hectorhiguita/circuitos2_proyectofinal/Circuitos_II_ESTUDIANTES_completo.pdf

INSTITUCIÓN UNIVERSITARIA ITM

Departamento de Electrónica y Telecomunicaciones

# Circuitos II

## Sistemas dinámicos, filtros, sensores, sistemas embebidos e IoT

Edición de estudiantes

Jhon Jairo Rojas Montano

Estado del documento. Desarrolladas las 17 semanas (51 sesiones), con laboratorios, dos parciales y el proyecto final. Cada cifra se reproduce con los notebooks de Python (Anexo A); los scripts de MATLAB equivalentes no se han ejecutado. Los resultados son cálculos: no hay mediciones de laboratorio, capturas de simulador ni pruebas en hardware. Las ponderaciones son propuestas sin aprobar. Ninguna sesión está aún revisada por el docente.

Circuitos II | ITM – Electrónica y Telecomunicaciones

### Índice

Cómo leer este documento | 16
I | Semana 1: Circuitos dinámicos y función de transferencia | 16
1. S01-1 Repaso de Circuitos I | 16
2. S01-2 Sistemas dinámicos y H(s) | 20
3. S01-3 Simulación y laboratorio RC y RL | 23
4. Código y recursos de la semana | 27
5. Referencias de la semana | 27
II | Semana 2: Transformada de Laplace y función de transferencia | 28
6. S02-1 Transformada de Laplace básica | 28
7. S02-2 Elementos en Laplace, H(s), polos y ceros | 32
Circuitos II – ITM | 2

8. S02-3 Taller RC, RL y RLC | 36
III | Semana 3: Filtros pasivos de primer orden | 41
9. S03-1 Por qué filtrar: aplicaciones y tipos LPF, HPF, BPF y BSF | 42

10.S03-2 Filtro pasa bajas RC: H(s), frecuencia de corte, pendiente y respuesta
temporal | 46
11.S03-3 Laboratorio: diseño, simulación y medición de un LPF RC | 50

12.Código y recursos de la semana | 54
13.Referencias de la semana | 55
IV | Semana 4: Filtro pasa altas | 55

14.S04-1 Filtro pasa altas: principio de funcionamiento, aplicaciones y acoplo AC 55

15.S04-2 Desarrollo matemático del HPF, comparación con el LPF y pasa banda
simple | 59

16.S04-3 Laboratorio: HPF RC, respuesta en frecuencia, fase y respuesta cuadrada 63

V | Semana 5: Filtros de segundo orden y Parcial 1 | 66
17.S05-1 Introducción al segundo orden: circuitos RLC serie y paralelo | 66

18.S05-2 Resonancia, factor de calidad, ancho de banda y amortiguamiento | 70
19.S05-3 Simulación y laboratorio: resonancia del RLC serie | 74
20.S05-P Parcial 1 (semanas 1 a 5) | 79
21.Código y recursos de la semana | 81
22.Referencias de la semana | 81
VI | Semana 6: Diagramas de Bode | 82
23.S06-1 Escalas logarítmicas, frecuencia, décadas y octavas | 82
24.S06-2 Magnitud, decibelios, pendientes y fase | 85

25.S06-3 Construcción manual de asíntotas y simulación: asintótico frente a exacto 88

VII | Semana 7: Amplificadores operacionales | 92
26.S07-1 Historia y modelo ideal del amplificador operacional | 92
27.S07-2 Parámetros reales y hojas de datos | 97
28.S07-3 Laboratorio: LM358 frente a TL081 | 101
29.Código y recursos de la semana | 106
30.Referencias de la semana | 106

VIII | Semana 8: Configuraciones básicas del amplificador operacional | 106
31.S08-1 Amplificador inversor | 107
32.S08-2 Amplificador no inversor y seguidor de tensión | 113
32.3. Ejemplo S08-2-B Seguidor como separador de una fuente de alta impedancia . . . 117

33.S08-3 Laboratorio: montaje y verificación experimental de las configuraciones
básicas | 118
34.Código y recursos de la semana | 123
35.Referencias de la semana | 123
IX | Semana 9: Aplicaciones avanzadas de amplificadores operacionales | 123
36.S09-1 Sumador inversor y restador diferencial | 124
37.S09-2 Integrador, derivador y comparador con histéresis | 128

38.S09-3 Diseño de un filtro activo y laboratorio | 135
39.Código y recursos de la semana | 141
40.Referencias de la semana | 142
X | Semana 10: Sensores y adquisición de datos | 142
41.S10-1 Concepto de sensor y tipos | 142
42.S10-2 Datasheets, lectura de planos y selección de sensores | 147
43.S10-3 Interfaz con sensores, adquisición y calibración | 151

44.Parcial 2 (semanas 6 a 10) | 157
XI | Semana 11: Introducción al Internet de las Cosas | 158
45.S11-1 Qué es IoT, historia y arquitectura en capas | 159
46.S11-2 Aplicaciones: Smart Home, Industria 4.0 y telecomunicaciones | 162
47.S11-3 Diseño conceptual de un proyecto IoT | 166
48.Código y recursos de la semana | 171
49.Referencias de la semana | 171
XII | Semana 12: ESP32 y comunicaciones | 171
50.S12-1 Arquitectura del ESP32, GPIO, ADC y PWM | 172

51.S12-2 Wi-Fi, Bluetooth y configuraciones | 178
52.S12-3 Programación práctica y lectura de sensores | 182
53.Código y recursos de la semana | 188
54.Referencias de la semana | 188
XIII | Semana 13: MQTT, Raspberry Pi y Python | 189
55.S13-1 MQTT: broker, topics, publicación, suscripción y QoS | 189

56.S13-2 Raspberry Pi, sistema operativo, Docker y tarjeta SD | 194
57.S13-3 Python, Teleplot, visualización y comunicación ESP32–Raspberry | 198
58.Código y recursos de la semana | 203
59.Referencias de la semana | 203
XIV | Semana 14: Proyecto final, Fase 1 (definición y diseño) | 204

60.S14-1 Definición final, requisitos medibles y presupuesto de rango y resolución204

61.S14-2 Diseño electrónico: antialiasing y presupuesto de energía | 208
62.S14-3 Arquitectura IoT, lista de materiales, riesgos y revisión individual | 212

XV | Semana 15: Proyecto final, Fase 2 (montaje, programación e integración)217
63.S15-1 Montaje y verificación eléctrica por etapas | 218
64.S15-2 Programación y adquisición local | 223
65.S15-3 Integración IoT: payload, reconexión e informe técnico | 226
66.Tutorías permanentes y avance de la Fase 2 | 232

XVI | Semana 16: Validación, pruebas y pre-sustentación del proyecto final 233
67.S16-1 Plan de pruebas y calibración | 233
68.S16-2 Pruebas ante fallos y desempeño | 238
69.S16-3 Corrección de errores, trazabilidad y pre-sustentación | 243
70.Código y recursos de la semana | 247
71.Referencias de la semana | 248
XVII | Semana 17: Sustentaciones finales del proyecto | 248
72.S17-1 Día 1: protocolo y agenda de sustentación | 248

72.7. Conexión con el proyecto | 251
73.S17-2 Día 2: informe técnico final y acta de sustentación | 251
73.1. Concepto y modelo | 252
73.2. Plantilla de informe técnico | 253
73.3. Ficha o acta de sustentación (tablas vacías) | 253
73.4. Ejemplo S17-2-A Coherencia entre requisito, medición y conclusión | 254
73.5. Ejemplo S17-2-B Reporte honesto de incertidumbre y error | 255
73.6. Ejercicios | 255
73.7. Errores frecuentes y comprobaciones | 256
73.8. Conexión con el proyecto | 256
74.S17-3 Día 3: rúbricas, retroalimentación y cierre del curso | 256
74.1. Concepto y modelo | 256
74.2. Ejemplo S17-3-A Asignar un nivel con evidencia | 257
74.3. Ejemplo S17-3-B Conciliar dos valoraciones | 258
74.4. Retroalimentación y cierre del curso | 258
74.5. Ejercicios | 258
74.6. Errores frecuentes y comprobaciones | 259
74.7. Conexión con el proyecto | 259
75.Código y recursos de la semana | 259
76.Referencias de la semana | 259
Anexos | 260
A. Trazabilidad: cómo se obtuvo cada resultado | 260
A.1. Estructura de carpetas | 260
A.2. Cómo ejecutarlo | 260
A.3. Alcance de la verificación | 260
B. Capítulo piloto: modelado de circuitos RC y RL | 261
C. Qué se busca explicar | 261
D. Del circuito a la ecuación diferencial | 261
D.1. Por qué la tensión del condensador es continua | 262
E. Ejemplo RC-01 Respuesta a un escalón | 262
E.1. Paso 1 Fijar datos y condiciones | 262
E.2. Paso 2 Resolver el modelo | 262
E.3. Paso 3 Sustituir y obtener la corriente | 263

E.4. Paso 4 Interpretar la constante de tiempo | 263
E.5. Paso 5 Comprobar por sustitución | 263
F. Qué describe la función de transferencia | 264
G. Respuesta en frecuencia del RC | 264
H. Ejemplo RC-02 Efecto de una carga | 265
H.1. Paso 1 Escribir KCL con todas las ramas | 265
H.2. Paso 2 Evaluar ganancia y tiempo | 266
H.3. Paso 3 Comprobar el límite físico | 266
I. Ejemplo RL-01 Corriente y tensión en un inductor | 267
I.1. Paso 1 Modelo y condiciones | 267
I.2. Paso 2 Resolver la corriente | 267
I.3. Paso 3 Obtener la tensión y verificar | 267
J. Ejercicios de práctica | 268
J.1. E-01 Calcular tensión y corriente | 268
J.2. E-02 Diseñar una frecuencia de corte | 268
J.3. E-03 Condensador con energía inicial | 268
J.4. Pregunta conceptual | 268
K. Laboratorio propuesto y errores frecuentes | 269
K.1. Preparación y procedimiento | 269
K.2. Errores que conviene detectar | 269

### Cómo leer este documento

Cada sesión (2 horas) tiene el mismo orden: resultados y distribución del tiempo, concepto y modelo, ejemplos guiados, ejercicios, soluciones (solo edición docente), errores frecuentes y conexión con el curso. Cada solución sigue el mismo patrón: datos con unidades, supuestos, método, ecuaciones, sustitución, resultado, interpretación y comprobación independiente.
Los identificadores (S01-1-A, S01-1-E2, . . . ) enlazan ejemplo, notebook de verificación y registro de control. El Anexo A muestra cómo obtener cada número.

### Parte I

# Semana 1: Circuitos dinámicos y función de transferencia

### 1. S01-1 Repaso de Circuitos I: Kirchhoff, divisores, Thévenin y Norton

Resultados, prerrequisitos y distribución

Al terminar, el estudiante podrá (1) plantear KCL y KVL con referencia, nodos y polaridades definidos; (2) aplicar los divisores de tensión y de corriente indicando cuándo son válidos; (3) obtener el equivalente de Thévenin o Norton visto por un puerto y usarlo para anticipar la constante de tiempo de un circuito RC. Se comprueba al final con el ejercicio S01-1-E2.

Se requieren la ley de Ohm, resistencias serie y paralelo, y álgebra de ecuaciones lineales. Esta sesión no usa Laplace.

Distribución propuesta de 120 minutos

Presentación del curso, 20 min (contenido, metodología, proyecto final y herramientas). Diagnóstico, 10 min (preguntas breves de resistencias serie, paralelo y divisores, sin calificar). Explicación del repaso, 20 min. Ejemplos guiados, 25 min. Práctica de los ejercicios, 30 min. Cierre y contraste de resultados, 15 min. Total, 120 min. Antes de la clase, el estudiante revisa las resistencias serie y paralelo y prepara la herramienta de simulación que usará el jueves; ese trabajo previo no cuenta como tiempo presencial.

### 1.1. Presentación del curso

Esta parte ocupa los primeros 20 minutos de la sesión. Fija el recorrido del curso, la forma de trabajo, el proyecto final y las herramientas. Los datos que dependen de la institución (calendario, créditos, reglamento de evaluación, códigos) los define el docente y no se fijan en este material.

Contenido. El curso lleva al estudiante desde el análisis de sistemas dinámicos hasta un sistema de medición conectado. La Figura 1 resume la secuencia de 17 semanas del plan de clases: sistemas dinámicos y Laplace (semanas 1 y 2), filtros pasivos y diagramas de Bode (3 a 6), amplificadores operacionales (7 a 9), sensores y adquisición (10), Internet de las cosas con ESP32, MQTT y Raspberry Pi (11 a 13) y proyecto final con sustentaciones (14 a 17). Los parciales se ubican en las semanas 5 y 10. El cronograma complementario agrupa los temas con otro orden; las diferencias están registradas en control/discrepancias.md.

Sist.
Laplace

Filtros pasivos
y Bode

Amplificadores
operacionales | Sens. | IoT, ESP32,
MQTT, RPi | Proyecto final
1 | 2 | 3 | 4 | 5 | 6 | 7 | 8 | 9 | 10 | 11 | 12 | 13 | 14 | 15 | 16 | 17
semana
P1 | P2

Figura 1: Mapa de las 17 semanas según el plan de clases. P1 y P2 marcan los parciales de las semanas 5 y 10. Observar que cada bloque produce una pieza del proyecto: análisis y filtrado, acondicionamiento con operacionales, sensores, comunicación y sistema integrado.

Metodología. Cada semana tiene tres sesiones de 2 horas (martes, miércoles y jueves). Cada sesión sigue la misma secuencia: diagnóstico breve, explicación, ejemplo guiado, práctica y cierre. El trabajo previo se asigna aparte y no se cuenta como tiempo presencial. Cada resultado se respalda con tres fuentes, en este orden: predicción por cálculo, simulación y medición. La tabla de comparación del laboratorio de la sesión S01-3 es el formato de esa evidencia. Los cuadernos de Python y los scripts de MATLAB de cada semana permiten reproducir las cifras y modificar los datos.

Proyecto final. Se construye un sistema IoT completo con sensor o sensores, acondicionamiento de señal, ESP32, comunicación MQTT, plataforma en la nube, visualización de datos y análisis o automatización. El cronograma propone como temas una estación meteorológica, un monitor de calidad del aire, un sistema de riego, el control de temperatura industrial, el monitoreo de energía y un sistema domótico básico. Las semanas 14 a 17 se dedican a diseño, desarrollo e integración, validación y presentación; los entregables propuestos son el proyecto funcional, el informe técnico, el código documentado y la presentación oral. Cada decisión de diseño se justifica con cálculo, simulación y evidencia de medición; un dispositivo que funciona no basta por sí solo.

Herramientas de simulación y cálculo. La Tabla 1 indica qué incluye este material y qué decide el docente.

Cuadro 1: Herramientas del curso y su estado en este material.
Herramienta | Uso en el curso | Estado
Python (Jupyter) | Cálculo, comprobaciones y figuras; un
| cuaderno por sesión | Incluido, ejecutado
MATLAB | Script equivalente a cada cuaderno (Control
| System Toolbox para H(s)) | Incluido, no
| | ejecutado
Simulador de circuitos | Simulación de RC y RL el jueves | Lo elige el docente
Generador, osciloscopio y multímetro | Laboratorio S01-3 | Disponibilidad por
| | confirmar

Evaluación (propuesta sin aprobar). El cronograma sugiere quices y talleres 15 %, laboratorios 30 %, primer parcial 15 %, segundo parcial 15 % y proyecto final 25 %. Son valores de una propuesta; la ponderación definitiva la confirma el docente.

### 1.2. Repaso de Circuitos I: concepto físico y modelo

Un circuito resistivo lineal e invariante relaciona sus tensiones y corrientes mediante ecuaciones algebraicas. Dos leyes de conservación las organizan. KCL expresa que la carga no se acumula en un nodo: la suma algebraica de las corrientes que salen es cero. KVL expresa que el trabajo por unidad de carga a lo largo de una malla cerrada es nulo: la suma algebraica de tensiones es cero. La ley de Ohm, v = Ri, es la relación constitutiva de la resistencia con la convención pasiva: la corriente entra por el terminal positivo.
Antes de plantear ecuaciones se fijan una referencia (tierra), los nombres de los nodos y el sentido de cada corriente. Un signo negativo en el resultado indica que el sentido real es contrario al elegido; no es un error.

Divisores. Si dos resistencias R1 y R2 están en serie y circula la misma corriente, la tensión en R2 es

v2 = Vs

R2
R1 + R2
. | (1)

Si están en paralelo y soportan la misma tensión, la corriente por Ra cuando entra Is al nodo es

Ia = Is

Rb
Ra + Rb
. | (2)

La hipótesis es que no se conecta nada más a los nodos: una carga modifica la resistencia que ve la fuente y el resultado deja de ser válido.

Thévenin y Norton. Un bloque lineal con fuentes independientes, visto desde dos terminales, se comporta como una fuente Vth en serie con Rth, o como una fuente IN en paralelo con Rth. Se obtienen con

Vth = vab

abierto, | Rth =

Vth
IN

, IN = iab

cortocircuito. | (3)

Con fuentes independientes apagadas (fuente de tensión como cortocircuito, de corriente como circuito abierto), Rth es la resistencia vista desde el puerto. Los equivalentes valen para lo que se conecta en el puerto; no reproducen la potencia disipada dentro del bloque original.

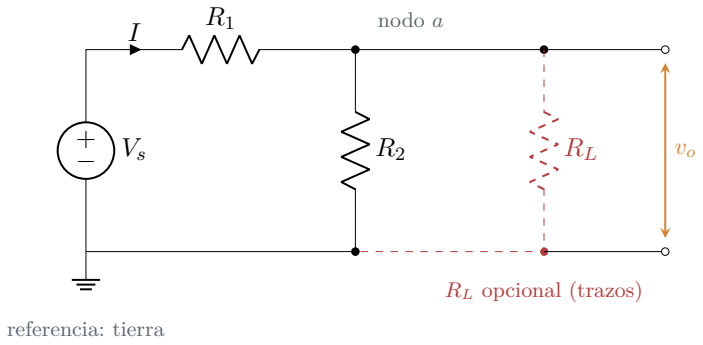
[picture p9: figure]
nodo a; RL opcional (trazos); referencia: tierra

Figura 2: Divisor de tensión R1–R2 con carga RL opcional (línea de trazos). La corriente I sale de la fuente; vo se mide respecto de tierra.

### 1.3. Ejemplo S01-1-A Divisor sin carga y balance de potencia

Enunciado. En la Figura 2, sin RL, Vs = 12 V, R1 = 2,2 kΩ y R2 = 4,7 kΩ. Hallar I, vo y comprobar el balance de potencia.

Datos y supuestos. Resistencias ideales; salida medida con instrumento de impedancia infinita. Incógnitas: I, vo.
Método. Una sola malla: KVL y ley de Ohm bastan; el divisor (1) es el mismo resultado.

−Vs + R1I + R2I = 0 ⇒ I =

Vs
R1 + R2

=

12
6900
= 1,739 mA, | (4)

vo = R2I = (4700)(1,739 × 10⁻³
) = 8,174 V. | (5)

Interpretación. vo es el 68,1 % de Vs porque R2 aporta 4,7 de los 6,9 kΩ.

Comprobación independiente (potencia). La fuente entrega VsI = 20,87 mW. Las resistencias absorben I

2R1 + I

2R2 = 6,65 mW + 14,22 mW = 20,87 mW. La suma de potencias con signo es cero.

### 1.4. Ejemplo S01-1-B Equivalente de Thévenin con carga

Enunciado. Con el mismo circuito se conecta RL = 10 kΩ entre vo y tierra. Hallar vo con carga, el equivalente de Norton y la potencia en RL.

Método. Elegir Thévenin en el puerto de salida porque la carga puede cambiar y el equivalente se calcula una sola vez.

Paso 1. Circuito abierto. Vth = 8,174 V del ejemplo anterior.

Paso 2. Resistencia vista. Con Vs en cortocircuito, R1 y R2 quedan en paralelo:

Rth =

R1R2
R1 + R2

=

(2200)(4700)
6900
= 1,499 kΩ. | (6)

Paso 3. Norton. IN = Vth/Rth = 5,455 mA, igual a Vs/R1, que es la corriente de cortocircuito (con R2 puenteada).

Paso 4. Carga. Divisor sobre el equivalente:

vo = Vth

RL

Rth + RL

= 8,174 10
11,499

= 7,109 V, PL =

v

2
o
RL
= 5,05 mW. | (7)

Comprobación independiente. Por nodal en vo: (Vs − vo)/R1 = vo/R2 + vo/RL da el mismo 7,109 V. La carga reduce vo en 1,07 V: usar (1) sin RL sería un error de 15 %.

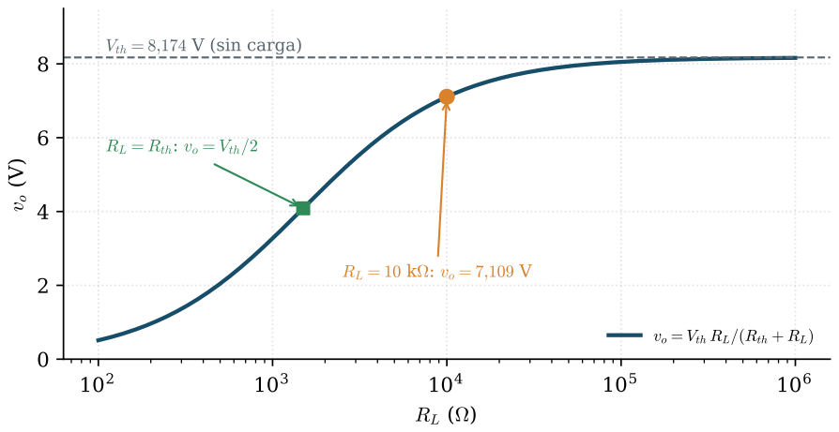
[picture p10: figure]
Vth = 8;174 V (sin carga); RL = Rth: vo = Vth=2; vo = Vth RL=(Rth + RL)

Figura 3: Tensión de salida del divisor en función de la carga, generada en el cuaderno clase1_repaso_thevenin. Observar que vo tiende a Vth cuando RL ≫ Rth y que vale Vth/2 cuando RL = Rth.

### 1.5. Ejercicios

S01-1-E1 (divisor de corriente). Una fuente de corriente de 10 mA alimenta dos resistencias en paralelo, Ra = 1 kΩ y Rb = 4 kΩ. Hallar Ia, Ib y la tensión común. Comprobar con KCL y con la potencia.
S01-1-E2 (puente hacia RC). A la salida del circuito de la Figura 2, sin RL, se conecta un condensador C = 470 nF inicialmente descargado. En t = 0 la fuente pasa de 0 a 12 V. Hallar la constante de tiempo, vC(1 ms) y la frecuencia f = 1/(2πτ ) asociada. Explicar por qué τ no es R1C.

Pregunta conceptual. Dos fuentes de 12 V con Rth de 1,5 kΩ y de 15 Ω alimentan una carga de 10 kΩ. ¿Cuál mantiene mejor la tensión en la carga y por qué?

Errores frecuentes y comprobaciones

Aplicar el divisor de tensión con una carga conectada sin incluirla.

Apagar una fuente de corriente como cortocircuito (debe ser circuito abierto).

Usar R1 en vez de Rth al estimar τ .

Mezclar sentidos de corriente y polaridad al sumar potencias. Comprobar siempre un balance con signo.

Escribir kΩ y calcular en ohmios sin convertir.

### 1.6. Conexión con el curso

Rth y Vth serán la base de la constante de tiempo y del filtro cargado de las semanas 3 y 4. En el proyecto se pedirá justificar el efecto de la carga de un sensor sobre su acondicionamiento. Para el jueves, preparar la simulación del RC con y sin RL y registrar entrada y salida; las capturas se rotularán como simulación. Código de la sesión: cuaderno clase1_repaso_thevenin.ipynb y script clase1_repaso_thevenin.m; reproducen todas las cifras de esta sesión.

### 2. S01-2 Sistemas dinámicos y significado de la función de transferencia

Resultados, prerrequisitos y distribución

Al terminar, el estudiante podrá (1) distinguir un sistema estático de uno dinámico a partir de su ecuación; (2) obtener H(s) de un circuito de primer orden desde su ecuación diferencial con condiciones iniciales nulas; (3) leer en H(s) la ganancia en continua, el polo y la constante de tiempo. Se comprueba con S01-2-E1 y S01-2-E2.
Se requieren S01-1 (equivalente de Thévenin), la solución de RC dv/dt+v = V del piloto y derivadas de exponenciales. La transformada de Laplace se formaliza en la semana 2; aquí s se usa como operador de derivada para llegar a H(s).

Distribución propuesta de 120 minutos

Diagnóstico, 10 min (¿qué cambia cuando se enciende un amplificador y cuando se carga un condensador?). Explicación, 25 min. Ejemplo guiado, 30 min. Práctica de los ejercicios, 40 min. Cierre, 15 min. Trabajo previo: repasar la solución exponencial del RC; el tiempo presencial no la deduce desde cero.

### 2.1. Sistema, entrada y salida

Un sistema transforma una entrada x(t) en una salida y(t) (Figura 4). Un amplificador, un filtro y un sensor son sistemas. Se llama estático si y(t) depende solo de x(t) en el mismo instante (por ejemplo, y = Kx) y dinámico si depende también de valores anteriores, lo que ocurre cuando hay almacenamiento de energía (condensadores, inductores, masa térmica).

Sistema
H(s)

x(t)
entrada

y(t)
salida

condiciones iniciales nulas

Ejemplos (entrada → salida):

Amplificador

vent → vsal

Filtro
señal con ruido
→ señal filtrada

Sensor
magnitud física → tensión

Figura 4: Sistema con entrada x(t) y salida y(t). La función de transferencia relaciona ambas con condiciones iniciales nulas.

Un sistema es lineal si cumple superposición y homogeneidad, e invariante en el tiempo si sus parámetros no cambian. Para estos sistemas, la ecuación diferencial es de coeficientes constantes. Un circuito RC con R y C constantes y componentes ideales lo cumple en la región donde se verifica el modelo.

### 2.2. Función de transferencia

Sea s el operador que representa d/dt cuando las condiciones iniciales son nulas. La función de transferencia es
H(s) = Y (s)
X(s)
condiciones iniciales nulas
. | (8)

Sus raíces del denominador son los polos; los del numerador, los ceros. Un polo real en s = −p, con p > 0, corresponde a un modo e

−pt y a una constante de tiempo τ = 1/p. La ganancia en continua es H(0) si el sistema es estable. La respuesta a energía inicial no nula se trata aparte de H(s).

Para el RC del piloto, RC dvC/dt + vC = vi se vuelve (1 + sRC)VC = Vi
, luego

H(s) = VC(s)
Vi(s)

=

1
1 + sRC , polo en s = −

1
RC . | (9)

Esta expresión supone salida sin carga. Con carga cambian ganancia y polo (piloto, ejemplo RC-02).

### 2.3. Ejemplo S01-2-A Estático frente a dinámico

Enunciado. Un amplificador ideal con y = 10x y un RC con R = 10 kΩ, C = 100 nF reciben en t = 0 un escalón de 0,2 V. Comparar sus salidas en t = 1 ms.

Método. Una ecuación algebraica para el amplificador; la solución exponencial para el RC.

yamp(1 ms) = 10(0,2) = 2 V, igual para todo t ≥ 0, | (10)
τ = RC = 1 ms, | vC(t) = 0,2
1 − e

−t/τ
, | (11)

vC(1 ms) = 0,2(1 − e

−1
) = 0,126 V. | (12)

Interpretación. El amplificador ideal responde al instante; el RC ha alcanzado el 63,2 % de su valor final. Comprobación: vC(0) = 0 y vC(∞) = 0,2 V = H(0) · 0,2 V, con H(0) = 1.

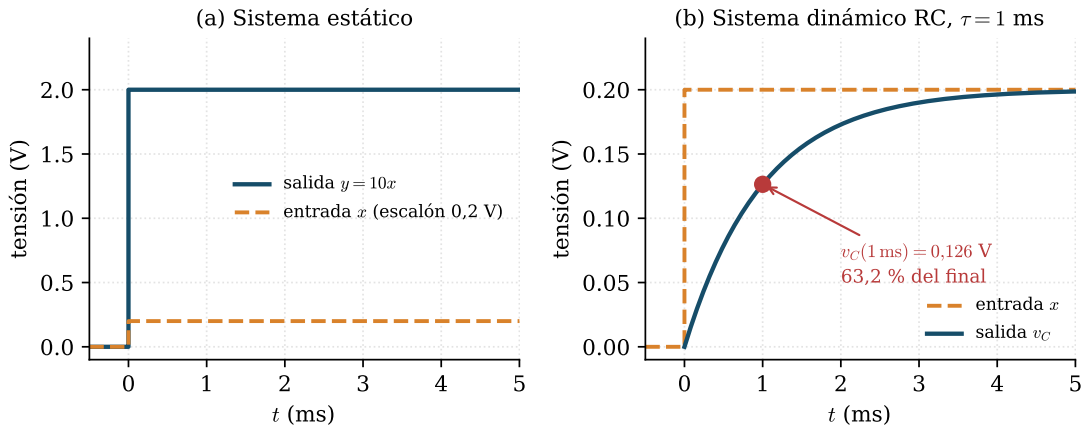
[picture p11: figure]
tensión (V); (a) Sistema estático; vC(1 ms) = 0;126 V 63,2 % del final; (b) Sistema dinámico RC, ¿ = 1 ms; entrada x salida vC

salida y = 10x entrada x (escalón 0,2 V)

Figura 5: Ejemplo S01-2-A (cuaderno clase2_sistemas_hs). (a) El amplificador responde al instante. (b) El RC alcanza el 63,2 % de su valor final en t = τ . Observar que la salida del sistema dinámico depende del tiempo transcurrido.

### 2.4. Ejemplo S01-2-B De la ecuación a H(s) y al polo

Enunciado. Obtener H(s) del RC anterior, ubicar su polo, la frecuencia fc = 1/(2πτ ) y verificar que H(s) reproduce el escalón.

Paso 1. Ecuación: RC dvC/dt+vC = vi

, con vC(0) = 0. Paso 2. Sustituir d/dt → s: (sRC+1)VC = Vi y H(s) = 1/(1 + s · 10⁻³

). Paso 3. Polo: s = −1/τ = −1000/s. fc = 1/(2π · 10⁻³ ) = 159,2 Hz; es
una frecuencia asociada, no un parámetro adicional.

Paso 4. Escalón. Para vi = V /s, VC(s) = V /[s(1 + sτ )] = V [1/s − 1/(s + 1/τ )], de donde vC(t) = V (1 − e

−t/τ ), el resultado del piloto. Comprobación independiente: el contraste simbólico con transformada inversa está en verificar_s01b.py. Límites: H(0) = 1 y |H| → 0 al crecer f, coherentes con un paso bajas.

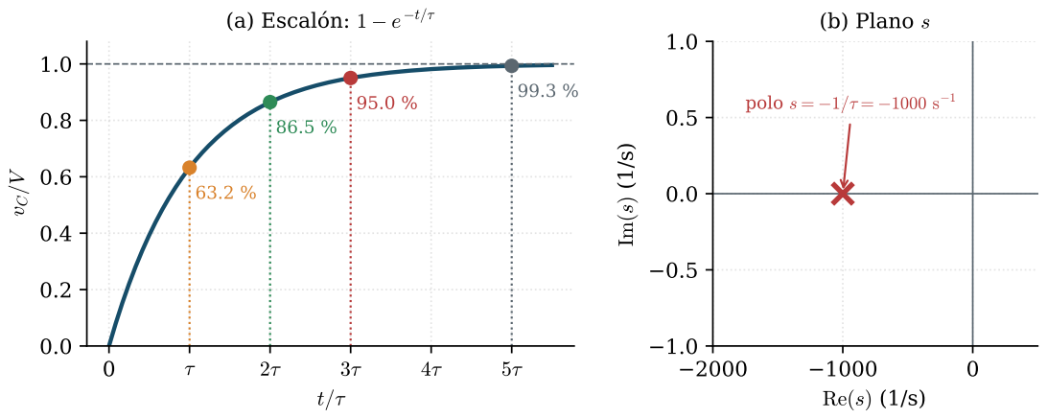
[picture p12: figure]
(a) Escalón: 1 ¡ e; polo s = ¡1=¿ = ¡1000 s; (b) Plano s

Figura 6: Ejemplo S01-2-B. (a) Fracción del valor final alcanzada en múltiplos de τ . (b) El polo de H(s) en el plano s: cuanto más a la izquierda, menor τ y respuesta más rápida.

### 2.5. Ejercicios

S01-2-E1. Un circuito RL serie con R = 100 Ω y L = 100 mH se alimenta con vi

, y la salida se
toma sobre R (sin carga, condiciones iniciales nulas). Obtener H(s), polo, τ , fc y vR(2 ms) para un escalón de 5 V.

S01-2-E2. Un sensor de temperatura se modela como sistema de primer orden con ganancia K = 0,02 V/

◦C y τ = 3 s (modelo del ejercicio, no un dato de catálogo). Si la temperatura pasa de 0 a 40 ◦C en t = 0, hallar la salida final, v(τ ) y el tiempo para llegar al 95 % del valor final.

Pregunta conceptual. Si un condensador parte con 2 V, ¿H(s) = 1/(1 + sRC) predice por sí sola la salida a un escalón? Justificar.

Errores frecuentes y comprobaciones

Tratar H(s) como válida con condiciones iniciales no nulas.

Usar H(s) sin carga para un circuito cargado.

Confundir τ con el tiempo de establecimiento: 63 % en τ , 95 % en 3τ .

Confundir ω = 1/τ en rad/s con f = ω/2π en Hz.

Olvidar que el sensor real puede ser de orden superior.

### 2.6. Conexión con el curso

Los polos y τ de H(s) se usarán para clasificar filtros (semanas 3 a 5) y para exigir al sensor del proyecto un tiempo de respuesta compatible con la aplicación. Código de la sesión: cuaderno clase2_sistemas_hs.ipynb y script clase2_sistemas_hs.m.

### 3. S01-3 Simulación y laboratorio: constante de tiempo y respuesta al escalón

Resultados, prerrequisitos y distribución

Al terminar, el estudiante podrá (1) predecir con R, C y L el comportamiento esperado en simulación y laboratorio; (2) medir τ y el tiempo de subida con osciloscopio; (3) explicar discrepancias por tolerancias, impedancia del generador y carga de las sondas. Se comprueba con la guía y con S01-3-E1 y S01-3-E2.

Prerrequisitos: S01-1 y S01-2. Trabajo previo: calcular valores esperados y preparar el archivo de simulación. No se incluyen resultados medidos; los espacios de la guía los llena el estudiante.

Distribución propuesta de 120 minutos

Diagnóstico y seguridad, 10 min. Simulación RC y RL, 30 min. Montaje y medición en laboratorio, 50 min. Comparación teoría–simulación–medición y cierre, 30 min. El diagnóstico revisa conexión de tierra de generador y osciloscopio. Si la práctica excede el tiempo, la medición del RL puede realizarse en una sesión posterior.

Seguridad y referencias

Solo baja tensión aislada: señal cuadrada de 0 a 5 V. El generador y el osciloscopio comparten la masa del circuito. Comprobar con el multímetro la continuidad entre las tierras antes de conectar, y no conectar la masa de una sonda a un nodo distinto de tierra del montaje. El osciloscopio y el generador suelen tener el chasis referido a la tierra de la red (Figura 7): las masas de las sondas se conectan solo al nodo de tierra del montaje y nunca a un nodo energizado. Para otras fuentes, consultar el manual del equipo.

### 3.1. Guía de simulación (resultados rotulados como simulación)

Simular en el programa elegido por el docente el RC de la Figura 7 con R = 10 kΩ, C = 100 nF, fuente cuadrada 0–5 V a 50 Hz y Rs = 0; repetir con Rs = 50 Ω. Repetir para un RL con R = 100 Ω, L = 100 mH midiendo sobre R. Registrar τ simulado y comparar con la predicción. El cuaderno de la sesión incluye una simulación numérica propia que sirve de referencia, no sustituye la simulación

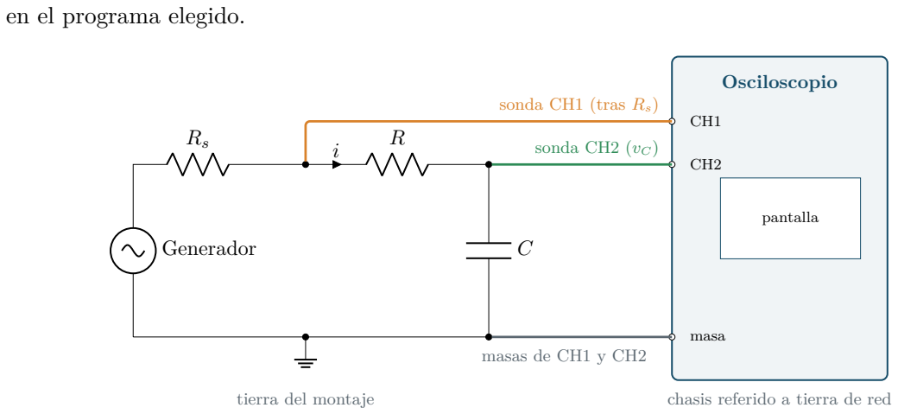
[picture p13: figure]
en el programa elegido.; Generador; tierra del montaje; Osciloscopio; pantalla; masa; sonda CH1 (tras Rs); sonda CH2 (vC ); masas de CH1 y CH2; chasis referido a tierra de red

Figura 7: Montaje del RC. CH1 mide la entrada tras Rs y CH2 la salida; ambas sondas con su masa en tierra. Rs es la impedancia de salida del generador (valor del manual de cada equipo).

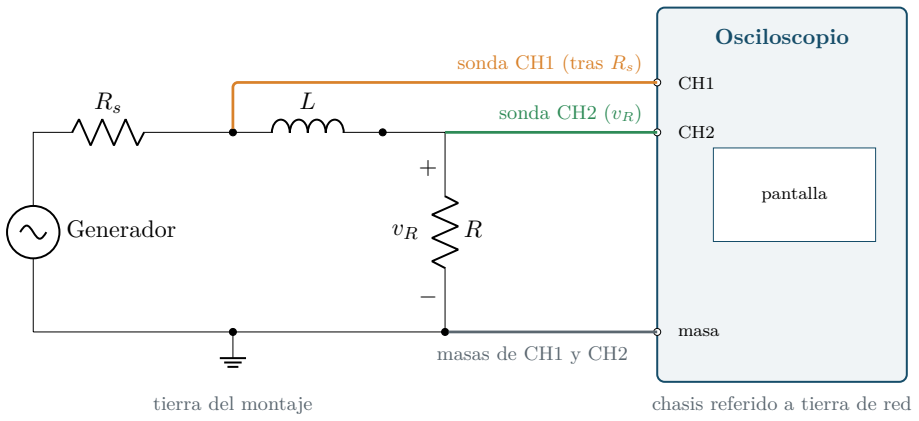
[picture p14: figure]
Generador; tierra del montaje; Osciloscopio; pantalla; masa; sonda CH1 (tras Rs); sonda CH2 (vR); masas de CH1 y CH2; chasis referido a tierra de red

Figura 8: Montaje del RL. CH1 mide la entrada tras Rs y CH2 mide vR, referida a tierra. Con la bobina real, rL queda en serie con L y debe medirse.

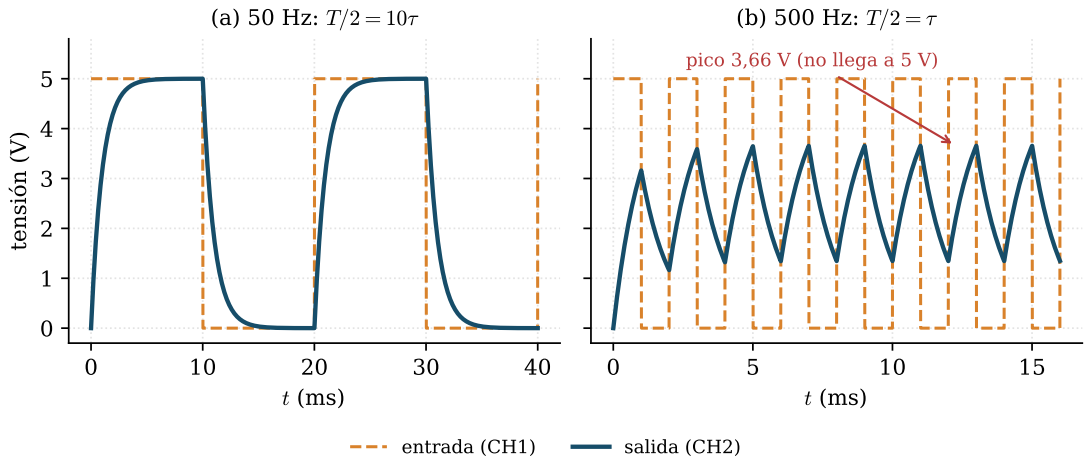
[picture p15: figure]
tensión (V); pico 3,66 V (no llega a 5 V); entrada (CH1); salida (CH2)

Figura 9: Simulación numérica en Python del RC con onda cuadrada de 0 a 5 V y Rs = 0 (no es una captura de simulador ni una medición). A 50 Hz el condensador se establece en cada semiperiodo; a 500 Hz no llega al valor final.

### 3.2. Ejemplo S01-3-B Predicción y tolerancias del RC

Enunciado. Para R = 10 kΩ ± 5 %, C = 100 nF ± 10 %, escalón de 5 V, predecir τ , el tiempo de subida 10–90 %, la frecuencia de la cuadrada y el intervalo de τ .

Método. Fórmulas del RC y cotas extremas.

τ = RC = 1 ms, v(τ ) = 5(1 − e

−1
) = 3,16 V, | (13)
t10–90 = τ ln 9 = 2,20 ms. | (14)

Para que el condensador se establezca en cada semiperiodo, T /2 ≥ 10τ = 10 ms, es decir f ≤ 50 Hz; con 10τ queda un residuo de e

−10 = 0,0045 %. Cotas: τm´ın = 0,95 · 0,9 · 1 ms = 0,855 ms y τm´ax = 1,05 · 1,1 · 1 ms = 1,155 ms. Entonces v(1 ms) varía entre 2,90 V y 3,45 V. Interpretación: una medición de τ dentro de ese intervalo es compatible con el modelo; fuera de él, revisar Rs, la carga de la sonda o el montaje.

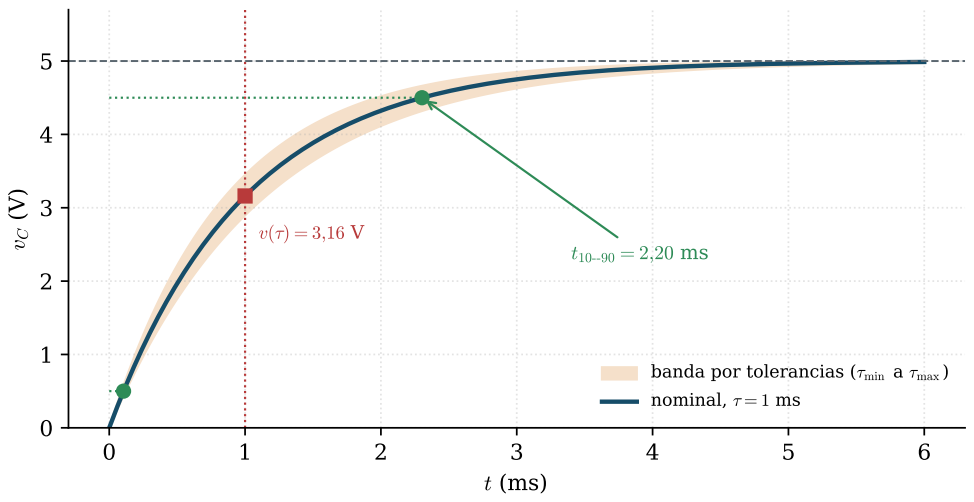
[picture p16: figure]
banda por tolerancias (¿min a ¿max ) nominal, ¿ = 1 ms

Figura 10: Predicción del ejemplo S01-3-B (cuaderno clase3_simulacion_laboratorio; cálculo, no medición). La banda sombreada es el intervalo por tolerancias. Observar los puntos del 10 % y el 90 % y que la medición debe caer dentro de la banda para ser compatible con el modelo.

Guía de medición y tabla de resultados

1. Medir R y C con el multímetro o medidor LCR y anotarlos.
2. Ajustar el generador a 0–5 V, 50 Hz, cuadrada.
3. Medir τ como tiempo para llegar al 63,2 % y t10–90; usar cursores.
4. Repetir con RL (medir la tensión sobre R).
5. Completar la tabla de comparación:

Magnitud Predicción Simulación Medición Diferencia

τ RC

t10–90 RC
τ RL

Los espacios en blanco son para los datos del estudiante; este material no contiene mediciones.

### 3.3. Ejercicios

S01-3-E1. El generador tiene Rs = 50 Ω. Hallar el τ real del RC y el error relativo si se usa τ = RC. ¿Importa para este circuito?
S01-3-E2. Para el RL (R = 100 Ω, L = 100 mH) con Rs = 50 Ω y resistencia de bobina rL = 20 Ω, hallar τ y el valor final de vR con escalón de 5 V. Comparar con el caso ideal y explicar qué cambia. Pregunta conceptual. Un estudiante mide τ del RC con una sonda ×1 de 1 MΩ y capacidad de cable de 100 pF. ¿Por qué esa medición apenas altera el RC de 10 kΩ y 100 nF?

Errores frecuentes y comprobaciones

Frecuencia de la cuadrada demasiado alta, sin llegar al valor final.

Medir τ en el 50 % o desde el instante equivocado.

Ignorar Rs y rL en el RL.

Conectar la masa de la sonda a un nodo que no es tierra.

Presentar una simulación como medición.

### 3.4. Conexión con el curso y el proyecto

La tabla de comparación es el formato de evidencia del proyecto: toda decisión de diseño se respalda con predicción, simulación y medición. Código de la sesión: cuaderno clase3_simulacion_laboratorio.ipynb y script clase3_simulacion_laboratorio.m.

### 4. Código y recursos de la semana

Los cuadernos de Python están en codigo/python/semana_01/ y se entregan ejecutados, con las comprobaciones assert. Los scripts de MATLAB están en codigo/matlab/semana_01/; contienen los mismos datos y resultados, y no se ejecutaron en este entorno. Los resultados de ambos son cálculo analítico y simulación numérica; no son mediciones.

Código de la semana 1

clase1_repaso_thevenin.ipynb / .m
Reproduce S01-1-A, S01-1-B, S01-1-E1 y S01-1-E2: divisor, balance de potencia, Thévenin y Norton, carga, constante de tiempo del RC alimentado por el divisor (con integración numérica del circuito original). Genera s01_thevenin_carga, s01_fuentes_rth y s01_rc_divisor_escalon.

clase2_sistemas_hs.ipynb / .m
Reproduce S01-2-A, S01-2-B, S01-2-E1, S01-2-E2 y la pregunta conceptual: H(s) simbólica, polo, escalón con transformada inversa, sensor de primer orden y efecto de la energía inicial. Genera s01_estatico_dinamico, s01_polo_tau, s01_rl_sensor y s01_cond_inicial. El script de MATLAB requiere Control System Toolbox.

clase3_simulacion_laboratorio.ipynb / .m
Reproduce S01-3-B, S01-3-E1, S01-3-E2 y la pregunta de la sonda: predicción, tolerancias, onda cuadrada a 50 Hz y 500 Hz, parásitos del RL. Genera s01_rc_tolerancia, s01_rc_cuadrada y s01_rl_parasitos.

Los contrastes simbólicos previos están en scripts/verificar_s01.py y scripts/verificar_s01b.py.

### 5. Referencias de la semana

Documentación primaria de las herramientas usadas en el código. Fecha de consulta de todas: 2026-11-03.

[1] SciPy community. scipy.signal.TransferFunction y scipy.signal.step. SciPy Manual v1.18.0. https://docs.scipy.org/doc/scipy/reference/generated/scipy.signal.TransferFu nction.html y https://docs.scipy.org/doc/scipy/reference/generated/scipy.sig nal.step.html. (https://docs.scipy.org/doc/scipy/reference/generated/scipy.signal.step.html)
[2] MathWorks. tf (Control System Toolbox). Documentación en línea, versión vigente en la fecha de consulta. https://www.mathworks.com/help/control/ref/tf.html.

[3] MathWorks. ode45 (MATLAB). Documentación en línea, versión vigente en la fecha de consulta. https://www.mathworks.com/help/matlab/ref/ode45.html.
[4] Matplotlib development team. Matplotlib documentation, versión estable en la fecha de consulta. https://matplotlib.org/stable/.

### Parte II

# Semana 2: Transformada de Laplace y función de transferencia

### 6. S02-1 Transformada de Laplace: concepto y transformadas del escalón, el impulso y la exponencial

Resultados, prerrequisitos y distribución

Al terminar, el estudiante podrá (1) explicar qué relaciona el dominio del tiempo con el dominio de s y por qué la transformada simplifica la ecuación diferencial de un circuito lineal; (2) obtener y usar las transformadas del escalón, del impulso y de la exponencial; (3) resolver el RC con condiciones iniciales nulas, invertir con fracciones parciales y comprobar el resultado. Se comprueba con S02-1-E1 y S02-1-E2.
Prerrequisitos: S01-2 (ecuación del RC y τ ), integrales de exponenciales y fracciones parciales de primer orden. El condensador parte descargado en todos los ejemplos de esta sesión; la energía inicial se trata aparte en S02-2.

Distribución propuesta de 120 minutos

Diagnóstico, 10 min (resolver τ dv/dt+v = V con v(0) = 0 y decir qué se derivó). Explicación, 25 min. Ejemplos guiados, 30 min. Práctica de los ejercicios, 40 min. Cierre, 15 min. Trabajo previo: repasar fracciones parciales y revisar la solución del RC de S01-2; ese trabajo no cuenta como tiempo presencial.

### 6.1. Concepto, ventajas y los dos dominios

Un circuito de resistencias, condensadores e inductores lineales e invariantes se describe con ecuaciones diferenciales de coeficientes constantes. Resolverlas en el tiempo exige un método distinto para cada tipo de entrada. La transformada de Laplace unilateral cambia la función f(t), definida para t ≥ 0, por una función F(s) de la variable compleja s = σ + jω (con σ en s⁻¹ y ω en rad/s):

F(s) = L{f(t)} =

Z ∞

0⁻

f(t) e⁻st dt. | (15)

El límite inferior 0

− es el instante inmediatamente anterior a t = 0; así se incluyen los impulsos que
ocurren en el origen y las condiciones iniciales quedan definidas en 0 | −. La integral converge solo
para ciertos valores de σ, la región de convergencia; en esta sesión se indica cuando importa. Ventajas para circuitos: (1) la derivada d/dt se convierte en multiplicar por s, de modo que la ecuación diferencial pasa a ser algebraica; (2) la entrada y las condiciones iniciales entran en la misma ecuación; (3) la respuesta se lee a partir de las raíces del denominador (polos), sin resolver cada caso desde cero; (4) la salida a una entrada cualquiera es Y (s) = H(s)X(s), el producto de la función de transferencia y la transformada de la entrada (se explora en S02-2). Los dominios se resumen en la Figura 11.

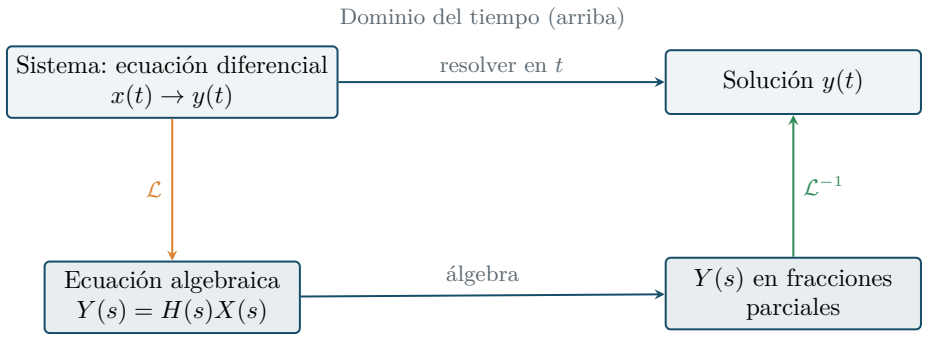
[picture p17: figure]
Sistema: ecuación diferencial x(t) → y(t); Solución y(t); Ecuación algebraica Y (s) = H(s)X(s); Y (s) en fracciones parciales; resolver en t; álgebra; Dominio del tiempo (arriba)

Dominio de s, s = σ + jω (abajo)

Figura 11: Ruta de trabajo: transformar (L), resolver el problema algebraico en el dominio de s e invertir (L

−1
). El camino directo en el tiempo llega al mismo y(t).

Relación con el dominio de la frecuencia. Si la región de convergencia incluye el eje σ = 0, evaluar F(s) en s = jω da la respuesta en régimen sinusoidal permanente a la frecuencia ω (que se relaciona con f = ω/2π en Hz). Fuera de esa condición, por ejemplo con un polo en el semiplano derecho, sustituir s = jω no describe un sistema estable. La parte real σ describe el crecimiento o decaimiento, y la parte imaginaria, la oscilación.

Propiedades que se usan. Para constantes a, b (linealidad) y con f(0⁻) el valor previo a la entrada:
L{af1 + bf2} = aF1 + bF2, L

ndf
dt

o
| = sF(s) − f(0⁻). | (16)

Los teoremas del valor inicial y final son

f(0⁺) = l´ıms→∞
sF(s), | f(∞) = l´ıms→0
| sF(s), | (17)

y el de valor final solo se aplica si todos los polos de sF(s) están en el semiplano izquierdo (no hay polos en el eje imaginario ni a su derecha).

Tres transformadas básicas. Con a real y constante:

L{u(t)} =

Z ∞

0

e

−stdt =

1
s
, | (σ > 0) | (18)

L{δ(t)} =

Z ∞

0⁻

δ(t) e⁻stdt = e⁰ = 1, | (propiedad de muestreo) | (19)

L{e

−atu(t)} =

Z ∞

0

e

−(s+a)tdt =

1
s + a
, | (σ > −a) | (20)

El escalón u(t) vale 0 para t < 0 y 1 para t > 0. El impulso δ(t) es una idealización de un pulso de ancho tendiente a cero y área unitaria; tiene dimensión de 1/s multiplicada por la unidad de su área, por ejemplo V·s para un pulso de tensión. Como δ = du/dt, la propiedad de derivación da sU(s) − u(0⁻) = s · (1/s) − 0 = 1, que coincide con (19). La exponencial con a = 0 reproduce el escalón. El polo de 1/(s + a) está en s = −a: si a > 0 la función del tiempo decae y si a < 0 crece (Figura 12).

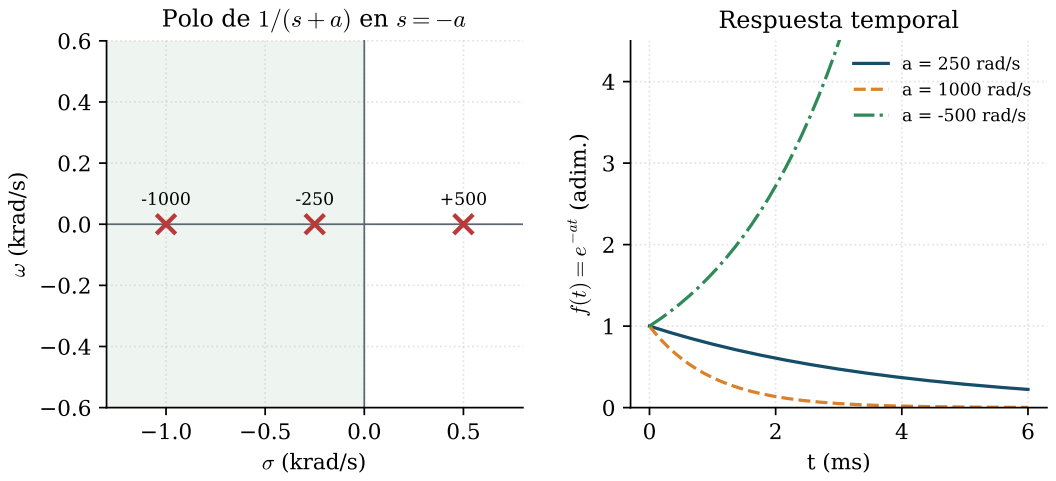
[picture p18: figure]
¾ (krad/s); ! (kra; Polo de 1=(s + a) en s = ¡a; dim.); Respuesta temporal; a = 250 rad/s a = 1000 rad/s a = -500 rad/s

Figura 12: Izquierda: plano s con polos de 1/(s + a) (en krad/s); el semiplano izquierdo se sombrea. Derecha: e

−at para a = 250, 1000 y −500 rad/s. Observar que un polo más alejado a la izquierda produce un decaimiento más rápido y que el polo en +500 corresponde a crecimiento. Generada en clase1_laplace_basica.ipynb.

### 6.2. Ejemplo S02-1-A Transformada y comprobación de valores límite

Enunciado. Hallar F(s) de f(t) = 10 u(t) − 4 e⁻²⁰⁰tu(t) (con t en s) y comprobar con los teoremas (17).

Datos y supuestos. Constantes en SI; f es una tensión en V. Incógnita: F(s) en V·s.

Método. Linealidad (16) y las transformadas (18), (20).

F(s) = 10 ·

1
s

− 4 ·

1
s + 200

=

10(s + 200) − 4s
s(s + 200) =

6s + 2000
s(s + 200). | (21)

Comprobación independiente. Del dominio del tiempo: f(0⁺) = 10 − 4 = 6 y f(∞) = 10. Del dominio de s: l´ıms→∞ sF = 6 y l´ıms→0 sF = 2000/200 = 10. Los polos 0 y −200 permiten usar el teorema del valor final. La inversa por fracciones parciales de F devuelve f(t) (verificado en el notebook).

### 6.3. Ejemplo S02-1-B RC con escalón e impulso (condiciones iniciales nulas)

Enunciado. En el RC de la Figura 13, R = 10 kΩ, C = 100 nF y vC(0⁻) = 0. Hallar vC(t) (a) para vi = 5 V u(t) y (b) para un impulso de área A = 5 mV s.

I(s) R

1
sC

Vo(s)

tierra

Figura 13: RC en el dominio de s: Vi(s) es la fuente, R y 1/(sC) son impedancias y Vo(s) = VC(s) se mide entre el nodo central y tierra, sin carga.

Método. El modelo es τ dvC/dt+vC = vi con τ = RC (S01-2). Transformar con (16) y condiciones iniciales nulas:
τsVC(s) + VC(s) = Vi(s) ⇒ VC(s) = Vi(s) 1 + τs
. | (22)

Aquí τ = (10⁴

)(10⁻⁷
) = 1 ms, polo en s = −1/τ = −1000 rad/s.
(a) Escalón. Vi = 5/s:

VC =

5
s(1 + τs)

=

5000
s(s + 1000) =

5
s

−

5
s + 1000

⇒ vC(t) = 5
1 − e

−1000t
V. (23)

Los residuos se obtienen de 5000/(s + 1000)|s=0 = 5 y 5000/s|s=−1000 = −5. En t = τ : vC = 5(1 − e

−1
) = 3,16 V.
(b) Impulso. Vi = A (transformada 1 por el área):

VC =

A
1 + τs

=

A/τ
s + 1000

⇒ vC(t) = A
τ

e

−t/τ = 5 e⁻¹⁰⁰⁰t V. | (24)

La tensión salta de 0 a 5 V en t = 0 y decae; la idealización es válida si el pulso real dura mucho menos que τ . En t = τ : 1,84 V.

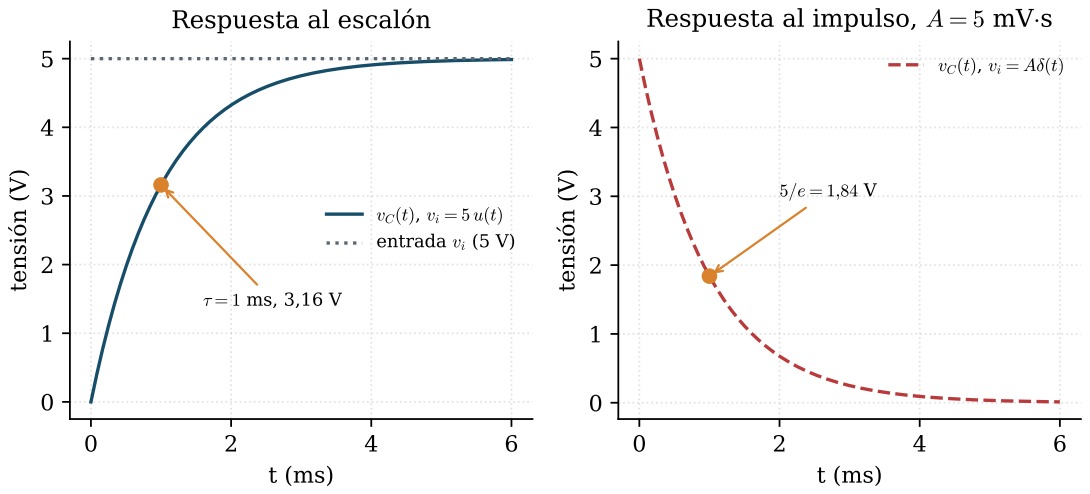
[picture p19: figure]
tensión (V); Respuesta al escalón; vC(t), vi = 5 u(t) entrada vi (5 V); Respuesta al impulso, A = 5 mV¢s

Figura 14: Simulación en Python con las expresiones obtenidas. Izquierda: escalón de 5 V; el marcador indica 3,16 V en t = τ . Derecha: impulso de área 5 mV s. Observar que ambas curvas tienen la misma constante τ y que el impulso es la derivada del escalón.

Comprobación independiente. La integración numérica de τ dv/dt + v = vi difiere de la fórmula en menos de 10⁻⁶ V en el intervalo de 0 a 6 ms; la respuesta al impulso coincide con scipy.signal.impulse. Valores límite: vC(0⁺) = 0 y vC(∞) = 5 (escalón), consistentes con (17).

### 6.4. Ejercicios

S02-1-E1. Invertir F(s) = 3s + 10
s(s + 5) con fracciones parciales, hallar f(0⁺) y f(∞) con los teoremas
(17) y comprobar con el resultado en el tiempo.

S02-1-E2. Un RC con R = 4,7 kΩ y C = 220 nF parte descargado y recibe un escalón de 3,3 V. Obtener vC(t) con Laplace, τ , el valor a 2 ms y el tiempo para llegar al 90 % del valor final. Comprobar con un segundo método.
Pregunta conceptual. ¿Por qué L{δ} = 1 y L{u} = 1/s, y qué relación tienen estos resultados con que δ sea la derivada de u?

### 6.5. Errores frecuentes y comprobaciones

Error frecuente

Olvidar que e

−at sin u(t) no está definida para t < 0 en la transformada unilateral; la función se considera nula antes de cero.

Aplicar el teorema del valor final con un polo en el eje imaginario o en el semiplano derecho.

Confundir s con jω: s es compleja en general y jω es el caso del régimen sinusoidal.

Invertir sin comprobar f(0⁺) y f(∞) y las unidades (V, V·s).

Mezclar condiciones iniciales y entrada: aquí vC(0⁻) = 0; con vC(0⁻) ̸= 0 la ecuación cambia (S02-2).

### 6.6. Conexión con el curso

La transformación del RC conduce a H(s) = 1/(1 +τs), que se generaliza en S02-2 con impedancias. En el proyecto, la constante de tiempo de un sensor se identifica con el polo de su H(s); para el miércoles, repasar S01-2 y traer R y C de un filtro del proyecto.

7. S02-2 Elementos R, C y L en Laplace, función de transferencia,

### polos y ceros

Resultados, prerrequisitos y distribución

Al terminar, el estudiante podrá (1) reemplazar R, C y L por sus impedancias en el dominio de s e incluir la energía inicial como fuente aparte; (2) obtener H(s) de un circuito con una topología definida y verificarla con sus límites; (3) localizar polos y ceros y predecir la forma de la respuesta. Se comprueba con S02-2-E1 y S02-2-E2.
Prerrequisitos: S02-1 (transformadas, derivada, H = Y /X en el RC) y divisores de tensión de S01-1. Condiciones iniciales nulas siempre que se hable de H(s).

Distribución propuesta de 120 minutos

Diagnóstico, 10 min (escribir la ecuación del condensador i = C dv/dt y decir qué se obtiene al aplicar L). Explicación, 25 min. Ejemplos guiados, 35 min. Práctica de los ejercicios, 35 min. Cierre, 15 min. Trabajo previo: repasar impedancia compleja y divisor de tensión; no se cuenta en el tiempo presencial.

### 7.1. Los elementos en el dominio de s

Se usa la convención pasiva: la corriente i entra por el terminal positivo de la tensión v (Figura 15). Se llama V (s) e I(s) a las transformadas de v e i.

R : v = Ri ⇒ V = RI, | (25)

C : i = C

dv
dt

⇒ I = sCV − Cv0 ⇒ V =

1
sC I +

v0
s
, | (26)

L : v = L

di
dt
⇒ V = sLI − Li0, | (27)

con v0 = v(0⁻) en el condensador e i0 = i(0⁻) en el inductor, obtenidos de la propiedad de derivación (16). Los términos v0/s y Li0 representan la energía almacenada antes de t = 0; son fuentes en serie con la impedancia ZC = 1/(sC) o ZL = sL (Figura 15). Con v0 = 0 e i0 = 0 las ecuaciones (26) y (27) se reducen a V = ZI y se usan todos los métodos del régimen sinusoidal (divisores, nodal, mallas) con ZR = R, ZC = 1/(sC), ZL = sL. Dimensionalmente sL y 1/(sC) son ohmios porque s está en s⁻¹
Dominio del tiempo | Dominio de s (con energía inicial)

R
i

R
I
| V = RI

C
i

v(0⁻) = v0

1
I | sC | + −
| | v0
| | s

V =

I
sC +

v0
s

L
i

i(0⁻) = i0

sL I
−

+

Li0

V = sLI − Li0

Figura 15: R, C y L: dominio del tiempo (izquierda) y modelo en s con convención pasiva (derecha). Las fuentes en serie con C y L llevan la energía inicial; con energía inicial nula se omiten.

### 7.2. Función de transferencia, polos y ceros

La función de transferencia es el cociente de la salida y la entrada con condiciones iniciales nulas:

H(s) = Y (s)
X(s)
c.i. nulas

= K

(s − z1)(s − z2)· · ·
(s − p1)(s − p2)· · ·
. | (28)

Los ceros zk anulan el numerador y los polos pk el denominador. Para circuitos con elementos concentrados, H es una razón de polinomios en s con coeficientes reales; los polos y ceros complejos
aparecen en pares conjugados. Cada polo p contribuye a la respuesta libre con e | pt: si Re p < 0 decae,
y si Re p > 0 crece. Un polo complejo σ ± jωd aporta una oscilación amortiguada e | σt cos(ωdt + φ).
Un cero controla cuánto se transfiere cada modo: el cero en el origen anula la salida en continua.

Procedimiento para obtener H(s). (1) Dibujar la topología, fijar entrada, salida y tierra. (2) Declarar condiciones iniciales nulas. (3) Sustituir cada elemento por su impedancia. (4) Aplicar divisor, nodal o mallas. (5) Normalizar el numerador y el denominador. (6) Comprobar los límites s → 0 (continua) y s → ∞ (alta frecuencia) con el circuito: condensador abierto y inductor en cortocircuito en continua, y lo contrario a muy alta frecuencia. La energía inicial no está en H(s): se añade con (26)–(27) y se suma por superposición.

### 7.3. Ejemplo S02-2-A RC: un polo, sin ceros

Enunciado. Obtener H(s) = Vo/Vi del circuito de la Figura 13 con R = 10 kΩ y C = 100 nF, sin carga. Hallar el polo, la ganancia en continua y |H| y su fase en ω = 1000 rad/s.

Datos y supuestos. Condiciones iniciales nulas, elementos ideales, salida sin carga. Incógnitas: H(s), polo, H(0), H(jω).

Método. Divisor de tensión con impedancias, porque no circula corriente por la salida.

H(s) = 1/(sC)
R + 1/(sC)

=

1
1 + sRC =

1
1 + τs

, τ = (10⁴

)(10⁻⁷
) = 1 ms, | (29)

p = −

1
τ
= −1000 rad/s, | H(0) = 1. | (30)

No hay ceros. En régimen sinusoidal, s = jω (el polo está en el semiplano izquierdo, así que es válido):

H(j1000) = 1
1 + j

⇒ |H| =

1
√
2
= 0,707 (−3,01 dB), | arg H = −45◦
, | f =

1000
2π
| | = 159 Hz. (31)

Interpretación. A la frecuencia del polo la magnitud cae a 1/

√
2. Comprobación independiente. Con impedancias numéricas, ZC = 1/(j 1000 · 10⁻⁷
) = −j 10 kΩ y H = ZC/(R + ZC) = −j10/(10 − j10) = −j/(1 − j) = (1 − j)/2 = 1/(1 + j); el notebook evalúa la razón numérica y coincide a 10⁻¹²
Límites: s → 0 da 1 (condensador abierto) y s → ∞ da 0 (condensador en cortocircuito).

### 7.4. Ejemplo S02-2-B Red de adelanto: un cero y un polo

Enunciado. En la Figura 16, R1 = 10 kΩ en paralelo con C = 100 nF, y esa combinación en serie con R2 = 2,2 kΩ. La salida es la tensión sobre R2, sin carga. Hallar H(s), el cero, el polo, H(0), H(∞) y la respuesta a un escalón de 1 V.

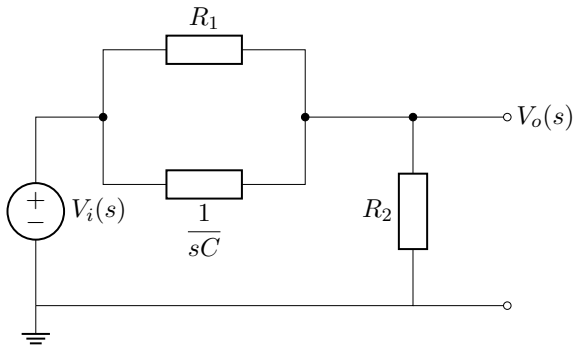
[picture p20: figure]

Figura 16: Red con R1 ∥ C en serie con R2. La salida Vo(s) se toma sobre R2 respecto de tierra.

Método. Divisor con la impedancia paralela Zp = R1/(1 + sR1C):

H(s) = R2
R2 + Zp

=

R2(1 + sR1C)
(R1 + R2) + sR1R2C

=

R2
R1 + R2

·

1 + sR1C

1 + s

R1R2
R1 + R2

C

. | (32)

Con los datos: R1C = 1 ms, H(0) = 2,2/12,2 = 0,1803, y

z = −

1
R1C

= −1000 rad/s, p = −

R1 + R2
R1R2C

= −

12200
(2,2 × 10⁷)(10⁻⁷)

= −5545 rad/s. (33)

La constante de tiempo del polo es τp = 1/5545 = 180,3 µs y H(∞) = 1. Para Vi = 1/s:

vo(t) = H(0) + -

H(∞) − H(0)
e
−t/τp = 0,1803 + 0,8197 e⁻t/τp V. | (34)

Interpretación. En t = 0⁺ el condensador se comporta como un cortocircuito y R1 queda anulada: vo(0⁺) = 1 V. Luego el condensador se carga y vo cae al divisor resistivo de 0,180 V (Figuras 17 y 18). El polo está más lejos del origen que el cero (5545 > 1000), lo que da ese comportamiento de

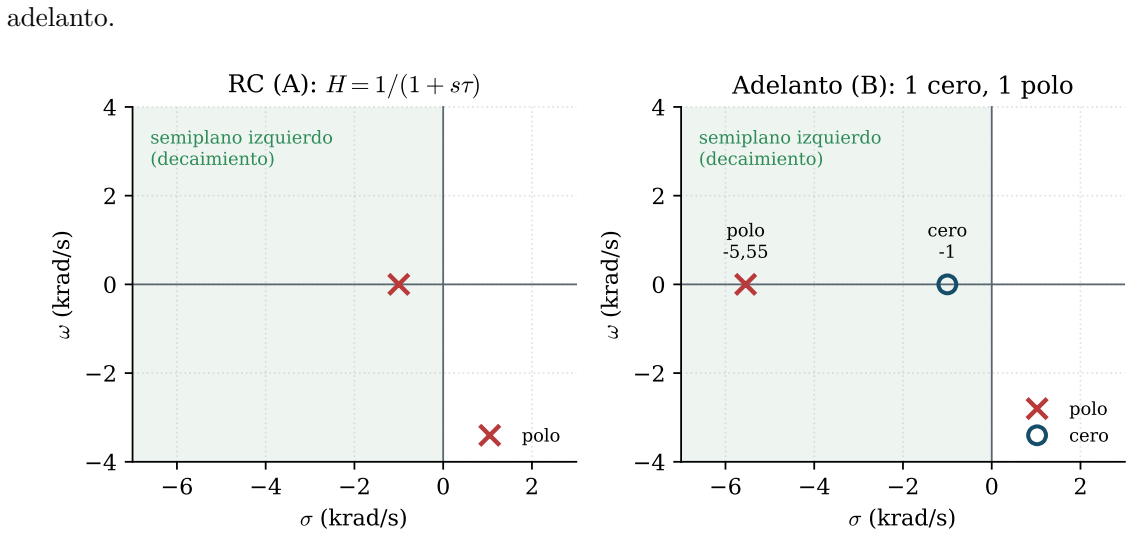
[picture p21: figure]
adelanto.; ¾ (krad/s); ! (kra; semiplano izquierdo (decaimiento); polo; cero -1; polo -5,55; Adelanto (B): 1 cero, 1 polo; polo cero

Figura 17: Diagramas polo-cero (ejes en krad/s; × polo, ◦ cero). Izquierda: RC del ejemplo A. Derecha: red de adelanto del ejemplo B. Observar el cero más próximo al origen que el polo.

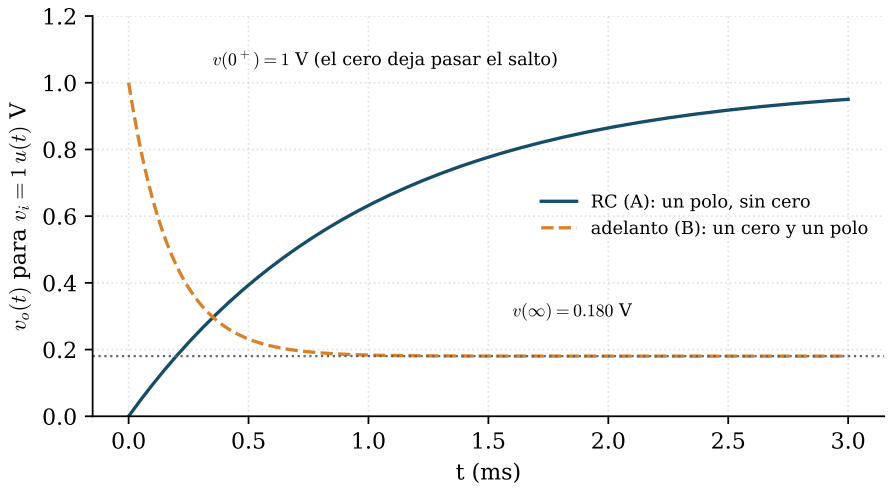
[picture p22: figure]
ara vi = 1 u(t) V; ) = 1 V (el cero deja pasar el salto); RC (A): un polo, sin cero adelanto (B): un cero y un polo

Figura 18: Simulación en Python: respuesta de vo a un escalón de 1 V en la red de adelanto (trazos) frente al RC del ejemplo A (continua). Observar que el cero deja pasar el salto inicial y que el valor final es H(0).

Comprobación independiente. (i) Límites: s → 0 da R2/(R1 + R2) y s → ∞ da 1, como en el circuito. (ii) Con scipy.signal.step la curva coincide con la fórmula a menos de 10⁻⁶ V. (iii) Cero: H(−1000) = 0 al sustituir.

### 7.5. Ejercicios

S02-2-E1 (carga). Al RC del ejemplo A se conecta RL = 10 kΩ entre la salida y tierra. Obtener H(s) con carga, el polo y H(0), y compararlos con los de A.
S02-2-E2 (energía inicial). Un RC con R = 2,2 kΩ y C = 1 µF tiene vC(0⁻) = 5 V y recibe un escalón de 3 V en t = 0. Hallar vC(t) separando la respuesta a la entrada con condiciones nulas y la debida a la energía inicial, y calcular vC(τ ).

Pregunta conceptual. Un circuito tiene polos en −1000 rad/s y −10 000 rad/s. ¿Cuál domina la respuesta lenta y por qué?

### 7.6. Errores frecuentes y comprobaciones

Error frecuente

Usar H(s) con un condensador cargado e ignorar v0/s: la salida parte en cero, lo cual es falso.

Escribir H(s) sin decir cuál es la salida: el mismo RC tiene 1/(1+τs) en C y τs/(1+τs) en R.

Olvidar la carga: un filtro cargado requiere el modelo con carga.

Llamar polo al valor de s que anula el numerador, o cero al que anula el denominador.

Mezclar ω (rad/s) con f (Hz), o p = −1/τ con fc = 1/(2πτ ).

### 7.7. Conexión con el curso

Los polos y ceros son el vocabulario de los filtros de las semanas 3 y 4 y de la estabilidad de los operacionales. En el proyecto, la ubicación del polo dará la constante de tiempo del acondicionamiento. Para el jueves, calcular τ , el polo y ζ de los circuitos del taller y preparar la herramienta de simulación.

### 8. S02-3 Taller: funciones de transferencia de RC, RL y RLC con simulación y comparación

Resultados, prerrequisitos y distribución

Al terminar, el estudiante podrá (1) obtener H(s) de un RC, un RL y un RLC serie con condiciones iniciales nulas y declarar la salida elegida; (2) predecir polos, constante de tiempo, amortiguamiento y sobreimpulso, y relacionarlos con el diagrama polo-cero; (3) comparar la predicción con una simulación y explicar las diferencias. Se comprueba con la guía y con S02-3-E1 y S02-3-E2.

Prerrequisitos: S02-1 y S02-2. Trabajo previo: calcular los valores esperados de la tabla de predicción y dejar instalada la herramienta de simulación. Las columnas del estudiante de la tabla quedan vacías: no se incluyen resultados de simulador del estudiante ni mediciones.

Distribución propuesta de 120 minutos

Diagnóstico, 10 min (dibujar los polos de 1/(1 + τs) y de s

2 + 2ζω0s + ω
2/0). Obtención de
H(s) de los tres circuitos, 30 min. Simulación y comparación, 45 min. Ejercicios, 20 min. Cierre, 15 min. Si falta tiempo, el RLC con R = 400 Ω se deja como actividad posterior.

### 8.1. Modelos y funciones de transferencia

Entrada: tensión vi de una fuente ideal con escalón de 5 V. Condiciones iniciales nulas (vC(0⁻) = 0, iL(0⁻) = 0). Cada salida se define en la Figura 19 (RC y RL) y en la Figura 20 (RLC), sin carga.

(a) RC, salida en C

R

C

vC

(b) RL, salida en R

L

R

vR

Figura 19: (a) RC con salida en C. (b) RL con salida en R. Ambos tienen la fuente vi respecto de tierra y la salida sin carga.

R
i

L

C

vC

tierra

Figura 20: RLC serie con salida en el condensador. La misma corriente i circula por R, L y C.

Con divisor de impedancias:

RC: HC(s) = 1/(sC)
R + 1/(sC)

=

1
1 + RC s, | τ = RC, | (35)
RL (salida en R): HR(s) = | R
R + sL

=

1
1 + (L/R) s
, | τ = L
| R
| , | (36)
RLC (salida en C): H(s) = | 1/(sC)
R + sL + 1/(sC)

=

1
LCs² + RCs + 1
| =

ω

2
0
s

2 + 2ζω0s + ω

2
0

, (37)

con la frecuencia natural ω0 = 1/

√
LC (rad/s) y el factor de amortiguamiento ζ =

R
2

p
| | C/L
(adimensional). Los polos de (37) son

p1,2 = −ζω0 ± ω0

q
ζ
2 − 1. | (38)

Si ζ < 1 son complejos conjugados (e

−ζω0t por una oscilación de frecuencia ωd = ω0
p
1 − ζ

2); si
ζ = 1 hay un polo doble real en −ω0; y si ζ > 1 hay dos polos reales distintos. Para ζ < 1 y entrada escalón, el sobreimpulso y el instante del pico son
Mp = 100 e⁻πζ/√
1−ζ
2 | %, | tp =

π
ωd
. | (39)

Si en vez de vR se toma vL = Vi − VR en el RL, HL = sL/(R + sL) tiene un cero en el origen: bloquea la continua.

Taller con simulación

Seguridad. Solo simulación y, si el docente lo autoriza, montaje de baja tensión aislada (0 a 5 V) con la masa del generador y del osciloscopio unidas al mismo nodo de tierra; no conectar la sonda a un nodo energizado ni a otra referencia. Este taller no incluye mediciones. Procedimiento. (1) Con los valores de la Tabla 2, escribir H(s) y los polos y ceros de cada circuito. (2) Simular en el programa que indique el docente (por ejemplo, un simulador de circuitos) la respuesta al escalón de 5 V: RC (R = 10 kΩ, C = 100 nF), RL (R = 100 Ω, L = 100 mH) y RLC con L = 10 mH, C = 1 µF y R = 50, 200, 400 Ω. (3) Registrar en la columna del estudiante los valores simulados y calcular la diferencia con la predicción.
(4) Explicar las diferencias (tolerancias, resistencia interna del generador, resistencia de la bobina).

Cuadro 2: Predicción analítica y simulación en Python (scipy y sympy, rotuladas como simulación). Las columnas «Simulador (estud.)» y «Diferencia» se completan en clase. ζ y las constantes dependen de los valores nominales.
Magnitud | Predicción | Simulación Python Simulador (estud.) Diferencia
τ RC (ms) | 1,000 | 1,000
τ RL (ms) | 1,000 | 1,000
t10–90 RC (ms) | 2,197 | 2,197
ζ RLC, R = 50 Ω | 0,25 | 0,25
Polos, R = 50 Ω (rad/s) | −2500 ± j9682 | −2500 ± j9682
Mp, R = 50 Ω ( %) | 44,43 | 44,43
tp, R = 50 Ω (ms) | 0,3245 | 0,324
Polos, R = 200 Ω (rad/s) −10000 (doble) | −10000 (doble)
Polos, R = 400 Ω (rad/s) −2679 y −37321 | −2679 y −37321

### 8.2. Ejemplo S02-3-A RC y RL con la misma H(s)

Enunciado. Con los valores de la guía: RC con R = 10 kΩ, C = 100 nF y RL con R = 100 Ω, L = 100 mH, ambos con escalón de 5 V. Hallar τ , el polo, v(τ ) y t10–90, y comparar la forma de vC y vR.
Método. Fórmulas del divisor, (36) y la del RC.

τRC = RC = 1 ms, τRL =

L
R

=

0,1
100
= 1 ms, | p = −1000 rad/s, | (40)

v(t) = 5
1 − e

−t/τ
, | v(τ ) = 3,16 V, | t10–90 = τ ln 9 = 2,20 ms. | (41)

Interpretación. El mismo H(s) = 1/(1 + τs) describe dos circuitos físicamente distintos: en el RC la tensión se limita por la carga del condensador y en el RL, por el crecimiento de la corriente en la bobina. Con salida en L la respuesta es vL = 5 e⁻t/τ , que cumple vR + vL = vi (Figura 21).

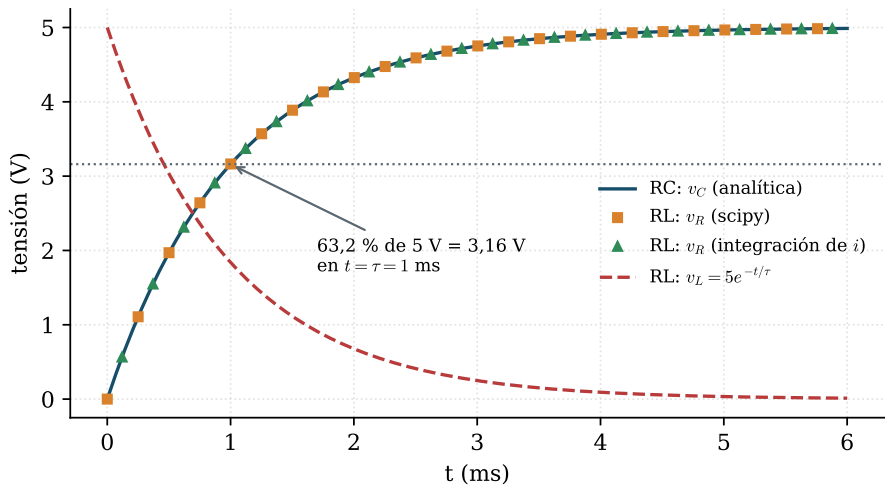
[picture p23: figure]
tensión (V); RC: vC (analítica) RL: vR (scipy) RL: vR (integración de i)

Figura 21: Simulación en Python. vC del RC (línea continua) y vR del RL obtenida con scipy.signal.step (cuadrados) y por integración de i (triángulos) coinciden; vL (trazos) es el complemento. Observar el 63,2 % (3,16 V) en t = τ .

Comprobación independiente. KVL del RL, Ldi/dt + Ri = vi
, integrada numéricamente con R i = vR coincide con la fórmula a 10⁻⁶ V. Límites: s → 0 da 1 y s → ∞ da 0; la corriente final del RL es 5/100 = 50 mA.

### 8.3. Ejemplo S02-3-B RLC serie y la posición de los polos

Enunciado. L = 10 mH, C = 1 µF, salida en C, escalón de 5 V. Para R = 50, 200 y 400 Ω, hallar ω0, ζ, los polos y, si procede, Mp y tp.
Datos y supuestos. Elementos ideales, fuente ideal con Rs = 0, c.i. nulas; el polinomio de (37) es válido sin carga.

Método. Se calcula ω0 y ζ y se usa la clasificación de los polos.

ω0 =

1
p
(10⁻²)(10⁻⁶)

= 10 000 rad/s (f0 = 1,59 kHz), ζ =

R
2

s
C
L

= 0,005 R. (42)

R = 50 Ω: ζ = 0,25, p = −2500 ± j9682 rad/s. Con (39): Mp = 100 e⁻π(0,25)/0,968 = 44,4 % y tp = π/9682 = 0,324 ms. El pico es 5(1,444) = 7,22 V.

R = 200 Ω: ζ = 1, polo doble en −10 000 rad/s, sin sobreimpulso.

R = 400 Ω: ζ = 2, p = −10000(2 ±

√
3) = −2679 rad/s y −37 321 rad/s, sin sobreimpulso.

Interpretación. Al aumentar R los polos conjugados se acercan al eje real, se unen en −ω0 y se separan; el polo cercano al origen (−2679 rad/s) domina y vuelve lenta la respuesta, como en la Figura 22. La Figura 23 muestra que el sobreimpulso aparece solo con polos complejos.

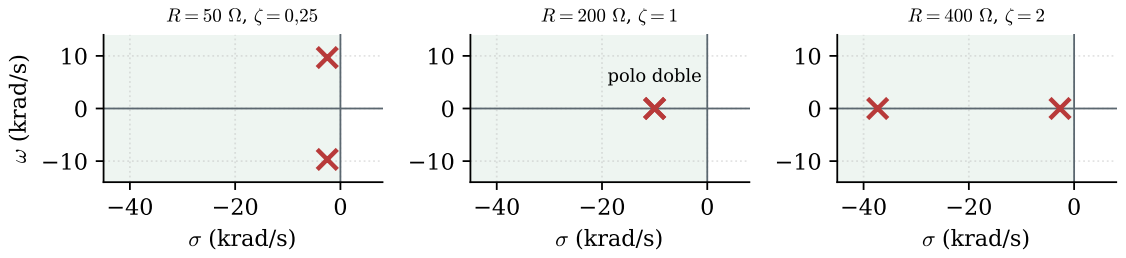
[picture p24: figure]
¾ (krad/s); ! (kra; polo doble

Figura 22: Diagramas polo-cero del RLC (krad/s; × polos) para R = 50, 200 y 400 Ω. Observar la migración de los polos hacia el eje real y su separación.

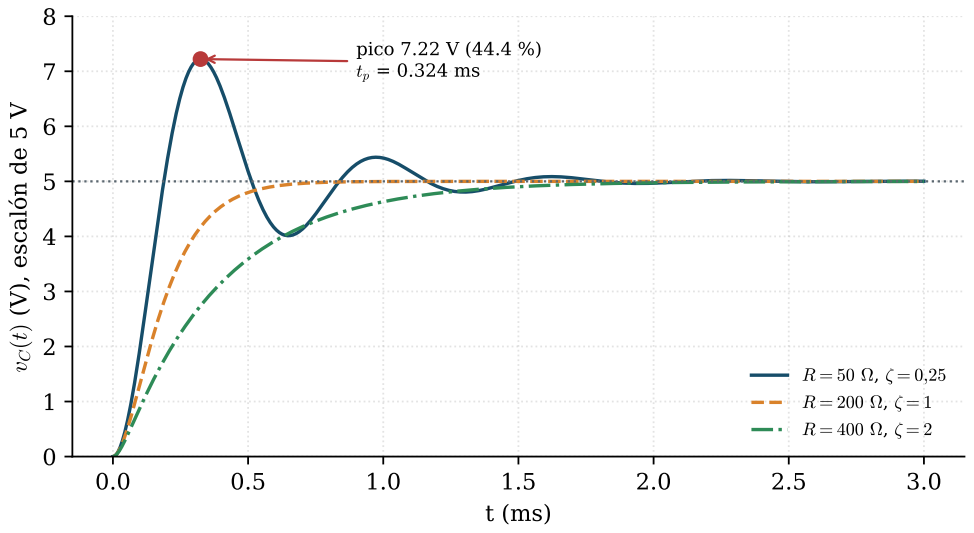
[picture p25: figure]
vC(t) (V), esc; aló; pico 7.22 V (44.4 %) tp = 0.324 ms

Figura 23: Simulación en Python de vC para un escalón de 5 V: tres amortiguamientos. El marcador indica el pico y su instante; la curva crítica y la sobreamortiguada no sobrepasan los 5 V.

Comprobación independiente. La respuesta analítica, scipy.signal.step y la integración de las ecuaciones de estado del circuito (dvC/dt = i/C, di/dt = (vi − Ri − vC)/L) coinciden a menos de 10⁻⁵
en la forma normalizada. Valores límite: vC(0⁺) = 0 y vC(∞) = 5 V (H(0) = 1). Con R = 50 Ω el sobreimpulso simulado (44,43 %) coincide con (39).

### 8.4. Ejercicios

S02-3-E1 (RLC). Con L = 10 mH, C = 1 µF y R = 100 Ω: hallar ζ, los polos, Mp y tp, y el pico para el escalón de 5 V. Comparar con el caso R = 50 Ω.

S02-3-E2 (RL, salida en la bobina). Para R = 100 Ω y L = 100 mH, obtener HL(s) = VL/Vi con c.i. nulas, su polo y su cero, y vL(t) para un escalón de 5 V. Comprobar que HR + HL = 1.

Pregunta conceptual. Al aumentar R en el RLC serie, un polo se acerca al origen y otro se aleja. ¿Qué consecuencia tiene sobre la respuesta al escalón?

### 8.5. Errores frecuentes y comprobaciones

Error frecuente

Sumar R con la resistencia interna del generador y la de la bobina: con Rs = 50 Ω el RLC de 50 Ω tiene en realidad R = 100 Ω y ζ = 0,5.

Decir que RC y RL son el mismo circuito porque tienen igual H(s): solo comparten la respuesta ante esa salida.

Aplicar (39) con ζ ≥ 1.

Presentar una curva simulada como medición: toda captura se rotula con su origen.

Olvidar la salida elegida: vC, vR y vL tienen funciones distintas.

### 8.6. Conexión con el curso

Los filtros de primer orden de la semana 3 usan τ y el polo del RC y del RL. El RLC y su ζ reaparecen en los filtros de segundo orden. En el proyecto, la identificación experimental de τ y del sobreimpulso permitirá estimar H(s) de un acondicionamiento.

### Código y recursos de la semana

Código de la semana 2

Python (carpeta codigo/python/semana_02/, ejecutados; usan sympy, numpy y scipy):

clase1_laplace_basica.ipynb: transformadas del escalón, impulso y exponencial, RC con escalón e impulso, ejercicios; genera exponenciales_polos y rc_escalon_impulso.

clase2_elementos_H.ipynb: H(s) del RC y de la red de adelanto, RC con carga, energía inicial; genera pz_rc_adelanto, adelanto_escalon y energia_inicial.

clase3_taller_rc_rl_rlc.ipynb: RC, RL y RLC, comparación de tres métodos; genera taller_rc_rl, taller_pz_rlc y taller_escalon_rlc.
MATLAB (codigo/matlab/semana_02/; no ejecutados en este entorno; usan Control System Toolbox): clase1_laplace_basica.m, clase2_elementos_H.m y clase3_taller_rc_rl_rlc.m, con los mismos datos que los notebooks.

### Referencias de la semana

The SciPy community, scipy.signal.lti (documentación de SciPy 1.18), https://docs.scipy.org/doc/scipy/reference/generated/scipy.signal.lti.html, (https://docs.scipy.org/doc/scipy/reference/generated/scipy.signal.lti.html) consultado el 2026-11-03.

SymPy Development Team, Integrals: laplace_transform (documentación de SymPy 1.14), https://docs.sympy.org/latest/modules/integrals/integrals.html, consultado el 2026-11-03.

MathWorks, tf: Transfer function model (documentación de Control System Toolbox), https: //www.mathworks.com/help/control/ref/tf.html, consultado el 2026-11-03.

### Parte III

# Semana 3: Filtros pasivos de primer orden

### 9. S03-1 Por qué filtrar: aplicaciones y tipos LPF, HPF, BPF y BSF

Resultados, prerrequisitos y distribución

Al terminar, el estudiante podrá (1) convertir entre razón de tensiones y decibelios y distinguir f en Hz de ω en rad/s; (2) clasificar un filtro como LPF, HPF, BPF o BSF a partir de su respuesta en magnitud; (3) especificar una atenuación y obtener frecuencia central y ancho de banda de un pasa banda. Se comprueba al final con S03-1-E1 y S03-1-E2.
Prerrequisitos: la función de transferencia y el polo de la semana 1, y el concepto de H(jω) de la semana 2. No se deduce ningún filtro en esta sesión: se fijan el vocabulario y los criterios de especificación que se usarán el miércoles y el jueves.

Distribución propuesta de 120 minutos

Diagnóstico, 10 min (¿qué oye o ve el estudiante cuando una señal trae ruido? ¿qué es un decibelio?). Explicación, 30 min. Ejemplos guiados, 30 min. Práctica de los ejercicios, 35 min. Cierre, 15 min (clasificación de las curvas de la Figura 25). Trabajo previo: repasar logaritmos decimales y la relación ω = 2πf. El tiempo presencial no repite el repaso de logaritmos.

### 9.1. Por qué filtrar y dónde aparecen los filtros

Una señal real contiene la información que interesa y otras componentes que no: ruido de la red eléctrica, interferencia de conmutación, ruido térmico del sensor o componentes de frecuencia alta que un convertidor analógico–digital (ADC) interpretaría como señales lentas. Un filtro es un sistema lineal e invariante cuya ganancia depende de la frecuencia: deja pasar un intervalo de frecuencias (la banda de paso) y atenúa otro (la banda de rechazo). Se usa para (1) reducir ruido antes de amplificar o digitalizar, (2) evitar el solapamiento espectral antes de un ADC, (3) separar canales de frecuencia (audio, comunicaciones) y (4) eliminar una interferencia conocida, como la de 60 Hz. La Figura 24 ubica el filtro en una cadena de medición.

Sensor Acondicionamiento

Filtro
(LPF) | ADC | Procesa-
| | dor

ruido de red
y conmutación

pasa la banda útil,
atenúa lo que el ADC
no debe ver

Figura 24: Cadena de medición con un filtro pasa bajas antes del ADC. El filtro atenúa el ruido fuera de la banda útil.

### 9.2. Magnitud en decibelios, Hz y rad/s

Sea H(jω) la respuesta en frecuencia. La razón de tensiones es |H|, un número sin unidades. La ganancia en decibelios es

GdB = 20 log10 |H| | (razón de tensiones), | GdB = 10 log10

P2
P1

(razón de potencias).
(43)
Los dos criterios coinciden porque la potencia en una misma resistencia es proporcional al cuadrado de la tensión. Valores de referencia: |H| = 0,5 equivale a −6,02 dB; |H| = 0,7071, a −3,01 dB; |H| = 0,1, a −20 dB; |H| = 2, a 6,02 dB. Un decibelio no es una magnitud absoluta: describe una razón. La frecuencia en hercios se relaciona con la pulsación por ω = 2πf (rad/s). Una frecuencia de corte de 1 kHz equivale a 6283 rad/s. Los diagramas del curso usan f en Hz; las fórmulas de H(s) usan ω en rad/s.

### 9.3. Los cuatro tipos básicos

La Figura 25 muestra la respuesta ideal (rectangular, línea de trazos) y una respuesta real ilustrativa de cada tipo. Un filtro pasa bajas (LPF) conserva las frecuencias menores que la de corte fc; el pasa altas (HPF), las mayores; el pasa banda (BPF), las comprendidas entre fL y fH; y el rechaza banda (BSF o notch), todas excepto esa banda. La frecuencia de corte se define, por convención, donde la potencia cae a la mitad del valor de la banda de paso:

|H(fc)| =

|H|banda de paso
√
2
⇐⇒ | caída de 3,01 dB. | (44)

Para un BPF se definen la frecuencia central geométrica, el ancho de banda y el factor de calidad:

f0 =

p
fLfH, | BW = fH − fL, | Q =

f0
BW
. | (45)

Una respuesta rectangular exige un filtro de orden infinito y un retardo infinito: no existe. Un filtro real acepta una zona de transición entre ambas bandas; cuanto más estrecha es, más componentes y más retardo requiere. Este curso empieza por el de primer orden, cuya transición es la más suave.

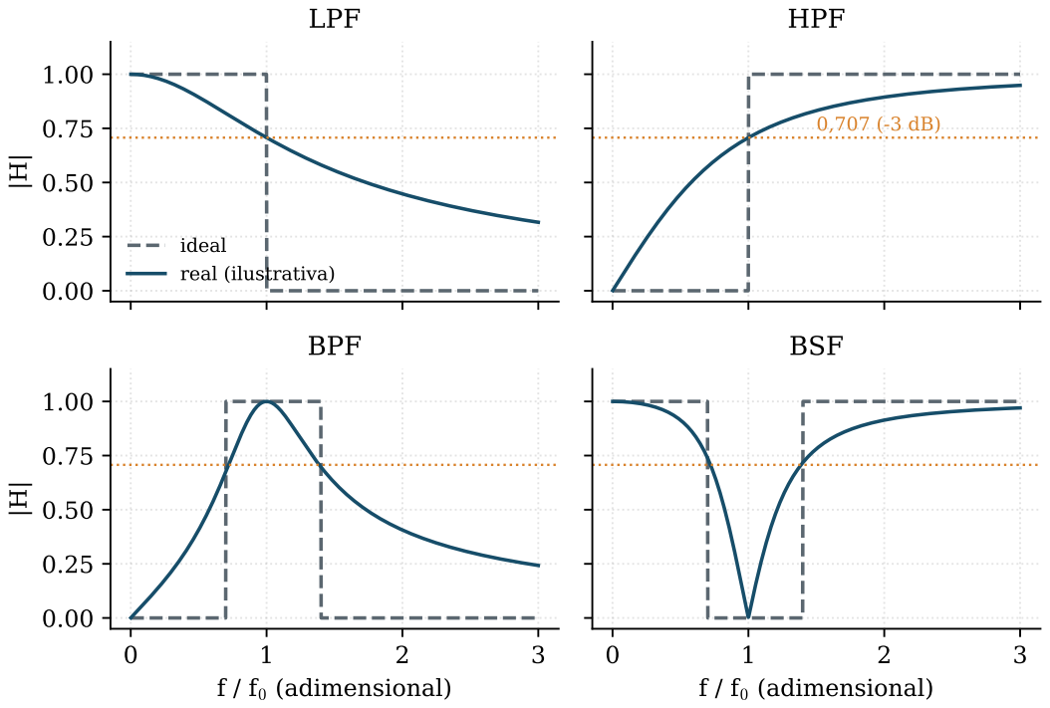
[picture p26: figure]
LPF; ideal real (ilustrativa); HPF; f / f0 (adimensional); BPF; BSF

Figura 25: Respuestas ideal (trazos grises) y real ilustrativa (línea azul) de LPF, HPF, BPF y BSF en magnitud lineal. La línea punteada naranja marca 0,707, es decir, −3 dB. Las curvas reales son ejemplos de forma, no diseños de componentes. Generada por clase1_tipos_filtros.ipynb.

Debe observarse que, en los cuatro casos, la curva real cruza 0,707 en los bordes de la banda y que la transición no es vertical.

### 9.4. Ejemplo S03-1-A Especificar la atenuación necesaria

Enunciado. Un sensor de temperatura entrega una señal útil de hasta 2 Hz y un ruido de conmutación de 10 kHz con amplitud de 100 mV. Se pide que el ruido en la salida sea de 1 mV o menos y que la señal útil pierda como máximo 1 dB. Determinar el tipo de filtro y las atenuaciones exigidas, y comprobar una frecuencia de corte candidata de 10 Hz.

Datos, incógnitas y supuestos. fs = 2 Hz, fr = 10 kHz, vr = 100 mV, vr,m´ax = 1 mV. Incógnitas: tipo de filtro, atenuación requerida y verificación. Se supone un filtro lineal con ganancia unitaria en la banda de paso, y se adelanta la magnitud de un LPF de primer orden, |H| = 1/

p
1 + (f /fc)

2,
que se deduce el miércoles.

Método. Las componentes útiles están en baja frecuencia y el ruido en alta: corresponde un LPF. Se convierte cada requisito en razón de tensiones con (43).

vr,m´ax
vr

=

1
100
⇒ GdB = 20 log10(0,01) = −40 dB, | (46)
|H(fs)| ≥ 10⁻¹/20 = 0,8913. | (47)

Para el candidato fc = 10 Hz:

|H(2 Hz)| =

1
p
1 + (2/10)²
= 0,9806 = −0,17 dB, | (48)

|H(10 kHz)| =

1
p
1 + (10⁴/10)²
= 9,9999 × 10⁻⁴ ≈ −60 dB, | (49)

de modo que el ruido de salida es 0,1 mV.

Interpretación. Ambos requisitos se cumplen con holgura. La condición mínima para la señal es fc ≥ 3,93 Hz; con 10 Hz se deja margen para la tolerancia de los componentes. Comprobación independiente. El notebook clase1_tipos_filtros.ipynb calcula las mismas razones y verifica con assert que la señal pierde menos de 1 dB y el ruido queda por debajo de 1 mV.

### 9.5. Ejemplo S03-1-B Pasa banda telefónico como cascada

Enunciado. Un canal de voz ocupa de fL = 300 Hz a fH = 3,4 kHz. Hallar f0, ω0, BW, Q, y la ganancia en f0 y en los bordes si el BPF se forma con un HPF con fc = fL seguido de un LPF con fc = fH, ambos de primer orden, sin interacción entre ellos (por ejemplo, separados por un buffer).

Método. Se usan (45) y el producto de las magnitudes (cascada sin interacción, ganancia unitaria en la banda de paso). Con |HHPF| = (f /fL)/

p
1 + (f /fL)

2 y |HLPF| = 1/

p
1 + (f /fH)

2:

f0 =

q
(300)(3400) = 1009,95 Hz, | ω0 = 2πf0 = 6345,7 rad/s, | (50)
BW = 3400 − 300 = 3100 Hz, | Q =
| 1009,95
| 3100
| = 0,326. | (51)

En f0: |HHPF| = |HLPF| = 0,9587, de donde |H| = 0,919 = −0,73 dB. En fL y en fH: |H| = 0,7044 = −3,04 dB.

Interpretación. Como la banda es ancha (Q < 1), los polos están lejos y la cascada casi no se afecta mutuamente; aun así, los bordes quedan algo por debajo de −3 dB (−3,04 dB) y el máximo no alcanza la unidad (−0,73 dB). Los bordes de −3 dB exactos requerirían corregir las frecuencias de diseño. Comprobación independiente. El notebook evalúa el producto de magnitudes en los tres puntos. En el límite fH → ∞ el BPF se reduce a un HPF de primer orden.

### 9.6. Ejercicios

S03-1-E1 (decibelios). Convertir a decibelios las razones de tensiones 0,5, 2, 0,01 y 100. Convertir −26 dB a razón de tensiones y calcular qué amplitud de salida resulta de una entrada de 100 mV con esa ganancia. Explicar por qué una razón de potencias de 1/2 corresponde a −3 dB y una razón de tensiones de 1/2, a −6 dB.

S03-1-E2 (clasificar por datos). Se dan las magnitudes siguientes de tres filtros hipotéticos (datos de ejercicio, no mediciones). (a) A 10, 100, 1000, 10 000 y 100 000 Hz: 1, 0,99, 0,71, 0,10, 0,01. (b) En las mismas frecuencias: 0,01, 0,10, 0,71, 0,99, 1. (c) A 10, 50, 60, 70 y 1000 Hz: 1, 0,30, 0,02, 0,30, 1. Indicar el tipo de cada uno, estimar su frecuencia de corte o central, expresar las magnitudes en decibelios y determinar la atenuación del filtro (c) a 60 Hz.

Pregunta conceptual. ¿Por qué no se puede construir un filtro con respuesta perfectamente rectangular? ¿Qué se sacrifica al acercarse a ella?

Error frecuente

Confundir −3 dB con «la mitad de la amplitud»: la amplitud es 0,707 y la mitad es la potencia.

Usar 20 log10 para potencias o 10 log10 para tensiones.

Mezclar Hz y rad/s: ωc = 2πfc.

Tratar los decibelios como un valor absoluto en vez de una razón respecto de la banda de paso.

Esperar que un filtro de primer orden separe frecuencias muy próximas, como 20 Hz y 60 Hz: su pendiente es de solo 20 dB por década.

### 9.7. Conexión con el curso y el proyecto

El miércoles se deduce el LPF RC y su filtro cargado; el jueves se mide. En el proyecto, el filtro antes del ADC se justificará con una tabla de requisitos como la del ejemplo A: atenuación del ruido, pérdida admisible en la banda útil y frecuencia de corte, con margen para tolerancias.

### 10. S03-2 Filtro pasa bajas RC: H(s), frecuencia de corte, pendiente y respuesta temporal

Resultados, prerrequisitos y distribución

Al terminar, el estudiante podrá (1) deducir H(s) = 1/(1 + sRC) del divisor de impedancias y obtener ωc, fc, magnitud y fase; (2) justificar la pendiente de −20 dB por década y relacionar fc con τ y con el tiempo de subida; (3) corregir el modelo cuando el filtro alimenta una carga RL. Se comprueba con S03-2-E1 y S03-2-E2.
Prerrequisitos: S03-1 (decibelios), la función de transferencia con condiciones iniciales nulas y el equivalente de Thévenin (S01-1). Trabajo previo: repetir el cálculo de τ = RthC del ejercicio S01-1-E2.

Distribución propuesta de 120 minutos

Diagnóstico, 10 min (¿qué le pasa a un RC si la frecuencia de entrada se multiplica por 10?). Explicación, 30 min (deducción de H(s), corte, pendiente, tiempo). Ejemplo A, 15 min. Ejemplo B (carga), 20 min. Práctica de los ejercicios, 30 min. Cierre, 15 min (contraste entre sin carga y con carga en la Figura 29).

### 10.1. Concepto físico y modelo

En el circuito de la Figura 26 el condensador almacena energía y su impedancia disminuye con la frecuencia. A frecuencias bajas, C se comporta casi como un circuito abierto y la tensión de entrada llega a la salida; a frecuencias altas, casi como un cortocircuito y la salida se reduce. El resultado es un pasa bajas.

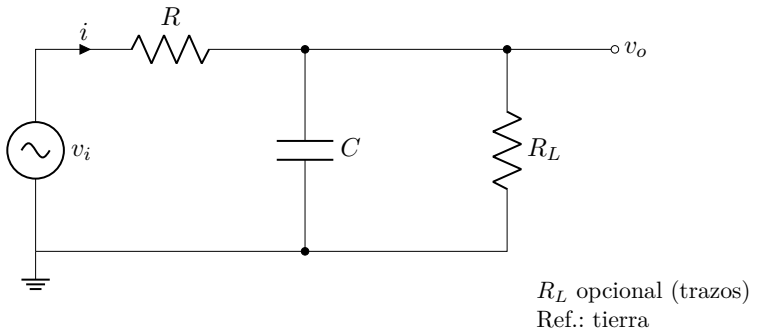
[picture p27: figure]
RL opcional (trazos) Ref.: tierra

Figura 26: LPF RC. vi es la fuente ideal, vo la tensión en C respecto de tierra y RL la carga opcional (trazos). Sin RL la salida está en circuito abierto.

Símbolos. R en Ω, C en F, s en 1/s, ω en rad/s y f en Hz con ω = 2πf. Se supone fuente ideal, componentes lineales e ideales, condiciones iniciales nulas y salida en circuito abierto (sin carga).

La impedancia del condensador es ZC = 1/(sC). El divisor de tensión de impedancias da

H(s) = Vo(s)
Vi(s)

=

ZC
R + ZC

=

1
1 + sRC =

1
1 + sτ
, | τ = RC. | (52)

Hay un polo real en s = −1/τ y ninguna raíz del numerador. La ganancia en continua es H(0) = 1. La frecuencia angular y la frecuencia de corte son

ωc =

1
RC , fc =

ωc
2π

=

1
2πRC . | | (53)

Con s = jω en régimen sinusoidal permanente,

|H(jω)| =

1
p
1 + (ω/ωc)

2

=

1
p
1 + (f /fc)

2

, ∠H(jω) = − arctan

f
fc
. | (54)

En f = fc: |H| = 1/

√
2 = 0,7071 (−3,01 dB) y la fase es −45◦ . La sustitución s = jω es válida solo para entrada sinusoidal en régimen permanente, y s general sirve también para entradas transitorias.

Pendiente. Para f ≫ fc, |H| ≈ fc/f y por tanto GdB ≈ −20 log10(f /fc). Cada multiplicación de f por 10 (una década) reduce la magnitud 20 dB; cada duplicación (octava), cerca de 6 dB. La asíntota de baja frecuencia es 0 dB; ambas se cortan en fc, donde la curva real está 3,01 dB por

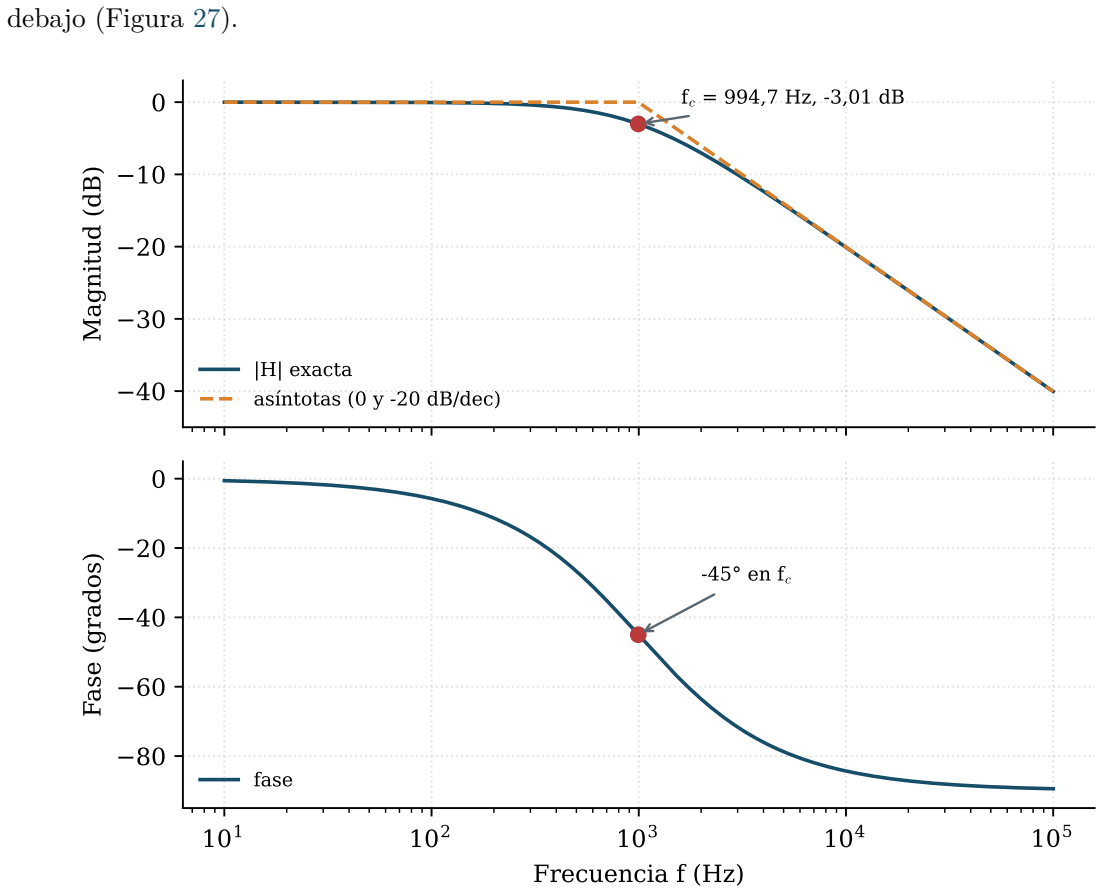
[picture p28: figure]
debajo (Figura 27).; Magnitud (dB); |H| exacta asíntotas (0 y -20 dB/dec); Frecuencia f (Hz); Fase (grados); fase

Figura 27: Magnitud (arriba) y fase (abajo) del LPF RC con R = 1,6 kΩ y C = 100 nF (fc = 994,7 Hz); eje de frecuencia logarítmico. La línea azul es la curva exacta y la naranja de trazos, las asíntotas. Generada por clase2_lpf_rc.ipynb.

Debe observarse que la curva exacta se separa de las asíntotas solo cerca de fc, con su máxima diferencia (3,01 dB) en ese punto, y que la fase pasa de 0

- a −90◦

Respuesta temporal. Con un escalón Vi en t = 0 y vo(0) = 0, la ecuación τ dvo/dt + vo = Vi da

vo(t) = Vi

1 − e

−t/τ
, | tr = t90 − t10 = τ ln 9 ≈ 2,2 τ, | trfc =

ln 9
2π

≈ 0,35. (55)

El tiempo de subida 10–90 % y el corte en frecuencia son dos descripciones del mismo polo

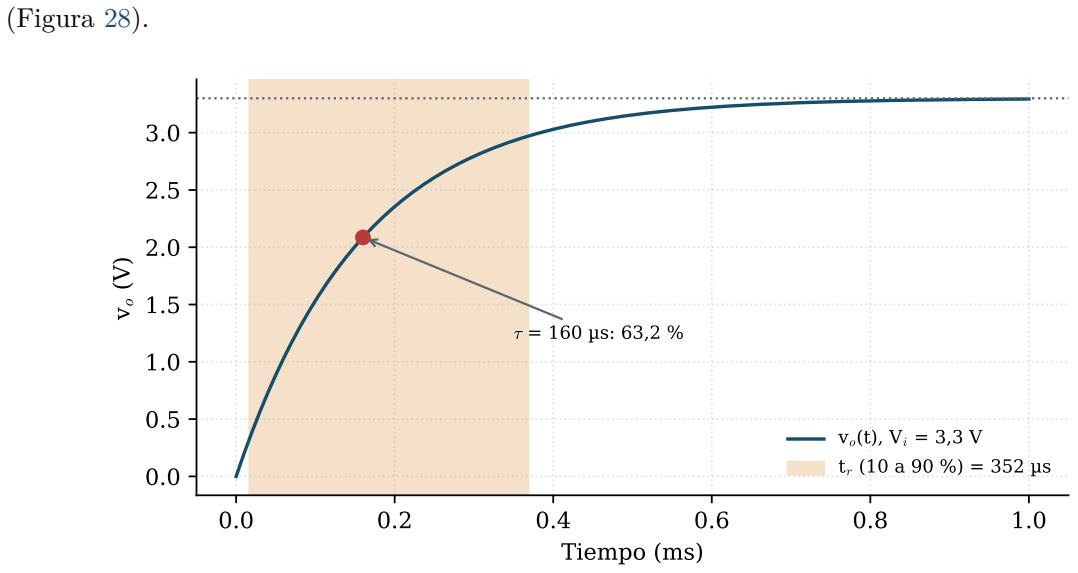
[picture p29: figure]
(Figura 28).; Tiempo (ms)

Figura 28: Respuesta al escalón de 3,3 V del filtro de la Figura 27. A t = τ = 160 µs la salida alcanza el 63,2 %; la banda naranja es el intervalo de subida 10–90 %.

Filtro cargado. Al conectar RL entre vo y tierra, (52) deja de valer. El equivalente de Thévenin visto por C es Vth = viRL/(R + RL) y Rth = R ∥ RL. Por tanto

HL(s) = K
1 + sτ ′

, K =

RL
R + RL
, | τ ′ = (R ∥ RL) C, | f′ c =

1
2πτ ′
. | (56)

La carga reduce la ganancia en continua y eleva la frecuencia de corte, porque disminuye la

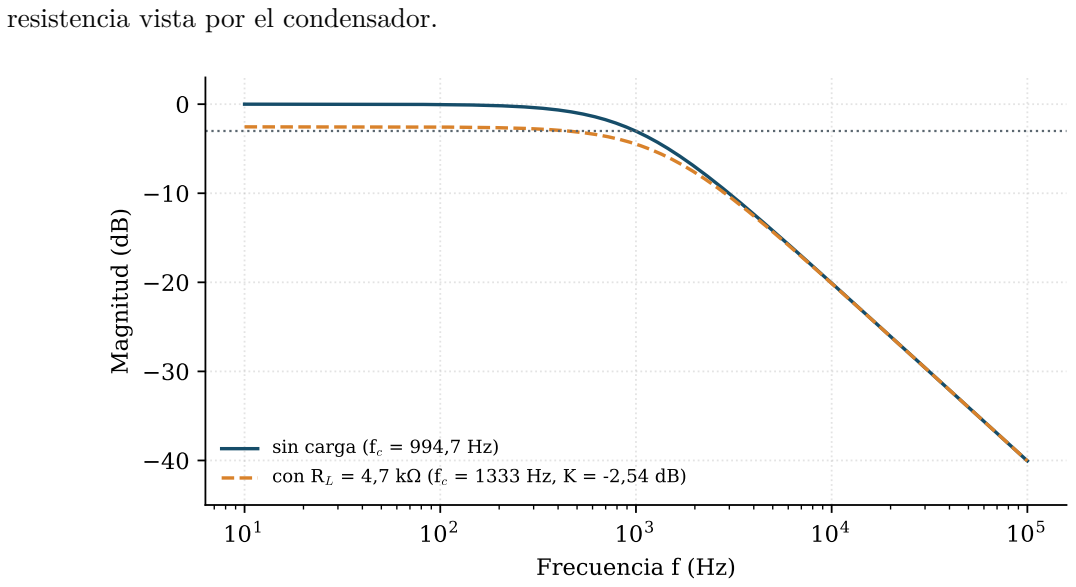
[picture p30: figure]
resistencia vista por el condensador.; Frecuencia f (Hz); Magnitud (dB); sin carga (fc = 994,7 Hz)

con RL = 4,7 kΩ (fc = 1333 Hz, K = -2,54 dB)

Figura 29: Magnitud del LPF de R = 1,6 kΩ, C = 100 nF sin carga (azul) y con RL = 4,7 kΩ (naranja de trazos). La línea punteada gris marca −3,01 dB absolutos.

### 10.2. Ejemplo S03-2-A Diseño de un LPF de 1 kHz

Enunciado. Diseñar un LPF RC sin carga con fc = 1 kHz y C = 100 nF. Elegir R de la serie E24, calcular ωc, τ y evaluar |H| en dB y la fase a 100, 994,7, 5000 y 10 000 Hz.

Datos y método. C = 100 nF, fc = 1000 Hz. Se despeja R de (53) y se evalúa (54).

R =

1
2πfcC

=

1
2π(1000)(100 × 10⁻⁹)
= 1591,5 Ω → R = 1,6 kΩ (E24), | (57)
τ = RC = 160 µs, | ωc =

1
τ

= 6250 rad/s, fc =

6250
2π
= 994,7 Hz. | (58)

La resistencia comercial desplaza fc 0,5 % respecto del objetivo. Evaluación:

f (Hz) | |H| | GdB (dB) Fase (◦
)
100 0,9950 | −0,04 | −5,74
994,7 0,7071 | −3,01 | −45,00
5000 0,1951 | −14,19 | −78,75
10 000 0,0990 | −20,09 | −84,32

Interpretación. Entre 5 000 y 10 000 Hz la magnitud cae 5,9 dB (casi una octava, 6 dB); entre 10fc y 100fc cae 19,96 dB, muy cerca de la pendiente asintótica. Comprobación independiente. Se evaluó H(s) con scipy.signal.freqs y coincidió con la fórmula en 100, 994,7 y 5000 Hz; los límites son correctos: H → 1 cuando f → 0 y H → 0 cuando f → ∞.

### 10.3. Ejemplo S03-2-B El mismo filtro con carga de 4,7 kΩ

Enunciado. Al filtro del ejemplo A se conecta RL = 4,7 kΩ en la salida. Hallar K (en dB), τ

′
, f

′
c y
|H| a 994,7 Hz, y comparar con el filtro sin carga.

Método. Thévenin visto por C y (56), porque RL cambia tanto la ganancia como el polo.

K =

4700
1600 + 4700
= 0,7460 = −2,54 dB, | (59)

Rth =

(1600)(4700)
6300
= 1193,7 Ω, | τ ′ = RthC = 119,4 µs, | f′ c =

1
2πτ ′

= 1333 Hz, (60)

|HL(994,7 Hz)| =

0,7460
p
1 + (994,7/1333)²
= 0,598 = −4,47 dB. | (61)

Interpretación. Con carga, el nivel de continua baja 2,54 dB, la frecuencia donde la salida cae 3 dB respecto de su propio nivel de continua sube de 994,7 Hz a 1333 Hz, y a 994,7 Hz la salida es 0,598 en lugar de 0,7071. Si el criterio es una caída absoluta de 3,01 dB (0,7071), la salida cargada nunca llega a 0,7071 de la entrada: el máximo es 0,746 y la caída absoluta de 3,01 dB ocurre en 448,5 Hz. Comprobación independiente. La admitancia nodal 1/RL + jωC en 1500 Hz da |HL| idéntico al de (56) (verificado numéricamente con assert). Límite: RL → ∞ recupera el ejemplo A.

### 10.4. Ejercicios

S03-2-E1 (respuesta temporal). El filtro del ejemplo A recibe un escalón de 0 a 3,3 V con salida en circuito abierto. Hallar vo(300 µs), el tiempo de subida 10–90 %, el tiempo para llegar al 95 % y la frecuencia máxima de una onda cuadrada simétrica para que la salida alcance el 99 % en cada semiperiodo. Comprobar trfc ≈ 0,35.

S03-2-E2 (fuente con resistencia interna y carga). Una fuente con resistencia interna Rs = 600 Ω alimenta un RC con R = 10 kΩ y C = 22 nF; la salida tiene una carga RL = 47 kΩ.

Hallar K en dB, fc del conjunto, y |H| y la fase a 2 kHz referidas a la tensión en vacío (f.e.m.) de la fuente. Comparar con el fc de R y C solos.

Pregunta conceptual. Al conectar la carga del ejemplo B, la ganancia baja pero la frecuencia de corte sube. ¿Por qué sube y no baja?

Error frecuente

Calcular fc = 1/(RC): eso es ωc en rad/s; falta el factor 2π.

Aplicar fc = 1/(2πRC) con una carga conectada sin sustituir R por R ∥ RL.

Creer que −3 dB significa la mitad de la amplitud: es 0,707.

Usar las asíntotas como si fueran la curva exacta en fc (error de 3 dB).

Esperar una cuadrada limpia con f = fc: el semiperiodo debe ser al menos 5τ .

Olvidar la resistencia interna del generador o de la fuente.

### 10.5. Conexión con el curso y el proyecto

El jueves se mide el filtro de este ejemplo. En la semana 4 se estudia su dual, el pasa altas, y más adelante los diagramas de Bode con rigor. En el proyecto, el LPF antes de un ADC debe justificarse con la carga real (la entrada del convertidor o del siguiente bloque) y no con el modelo sin carga.

### 11. S03-3 Laboratorio: diseño, simulación y medición de un LPF

RC

Resultados, prerrequisitos y distribución

Al terminar, el estudiante podrá (1) predecir con R, C y sus tolerancias la frecuencia de corte y la respuesta de un LPF RC; (2) medir magnitud y fase con generador y osciloscopio y obtener fc a partir de los datos; (3) explicar las diferencias entre predicción, simulación y medición por tolerancias, resistencia interna del generador, carga y sondas. Se comprueba con la tabla de comparación y con S03-3-E1 y S03-3-E2.

Prerrequisitos: S03-1 y S03-2. Trabajo previo, que sí cuenta como requisito de entrada: calcular la tabla de predicción de la guía y preparar el archivo de simulación. El documento no incluye resultados medidos ni capturas de simulador; todos los espacios los llena el estudiante.

Distribución propuesta de 120 minutos

Diagnóstico y seguridad, 10 min (continuidad de tierras, ajuste de carga del generador, escala del osciloscopio). Diseño y simulación, 30 min. Montaje y medición, 50 min (barrido en 7 frecuencias y medición con carga). Comparación teoría–simulación–medición y cierre, 30 min. Si el tiempo no alcanza, la medición con carga puede hacerse en una sesión posterior.

Seguridad e instrumentos

Solo baja tensión aislada: señal sinusoidal de 2 V pico a pico (de −1 a 1 V, sin desplazamiento de continua) generada por el equipo de laboratorio. El generador y el osciloscopio comparten la masa del circuito. Comprobar con el multímetro la continuidad entre las tierras antes de conectar, y no conectar la masa de una sonda a un nodo distinto de tierra del montaje. No usar red eléctrica en este montaje. Verificar en el manual del generador si la amplitud mostrada supone carga de 50 Ω o alta impedancia, y ajustar la configuración.

### 11.1. Especificación y diseño

Se diseña un LPF RC con fc ≈ 1 kHz, C = 100 nF y R = 1,6 kΩ (E24), como en S03-2-A, con fc = 994,7 Hz. El montaje es el de la Figura 30. En la parte 1 la salida solo la carga la sonda del osciloscopio; en la parte 2 se añade RL = 4,7 kΩ (trazos).

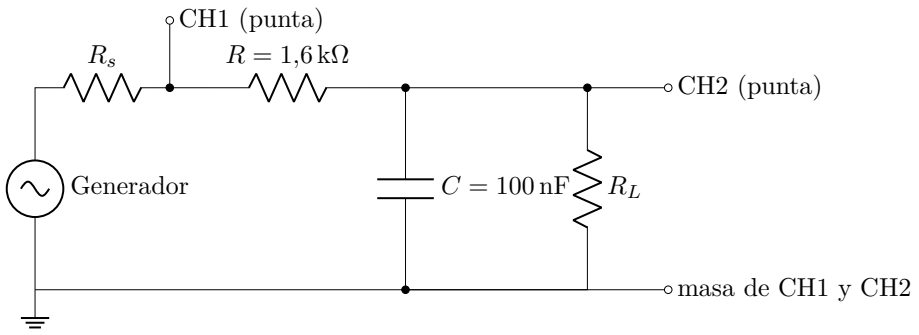
[picture p31: figure]
Generador; CH2 (punta); CH1 (punta); masa de CH1 y CH2

Figura 30: Montaje. CH1 mide la entrada tras Rs y CH2 la salida; ambas sondas con la masa en tierra. Rs es la resistencia interna del generador (valor del manual de cada equipo). RL solo se conecta en la parte 2.

### 11.2. Ejemplo S03-3-A Predicción del intervalo de fc por tolerancias

Enunciado. Con R = 1,6 kΩ ± 5 % y C = 100 nF ± 10 % hallar el intervalo de fc, el efecto de Rs = 50 Ω y el intervalo de |H| a 1 kHz.

Método. fc = 1/(2πRC) es decreciente en R y en C: el máximo ocurre con los valores mínimos y el mínimo con los máximos.

fc,m´ax =

1
2π(0,95)(1600)(0,9)(100 × 10⁻⁹)
= 1163 Hz, | (62)

fc,m´ın =

1
2π(1,05)(1600)(1,1)(100 × 10⁻⁹)
= 861 Hz. | (63)

Con Rs = 50 Ω la resistencia vista por C es 1650 Ω y fc = 964,6 Hz, es decir, 3,0 % menos que el nominal. A 1 kHz: con fc = 861 Hz, |H| = 0,652 (−3,7 dB); con fc = 1163 Hz, |H| = 0,758 (−2,4 dB); nominal, 0,705 (−3,03 dB).

Interpretación. Una medición de fc entre 861 Hz y 1163 Hz es compatible con el modelo; fuera de ese intervalo se revisan Rs, el instrumento y el montaje. Si se miden R y C con el multímetro o el medidor LCR, el intervalo se estrecha a la incertidumbre del instrumento. Comprobación independiente. El notebook clase3_laboratorio_lpf.ipynb repite los cálculos y la Figura 31 muestra la banda de tolerancia.

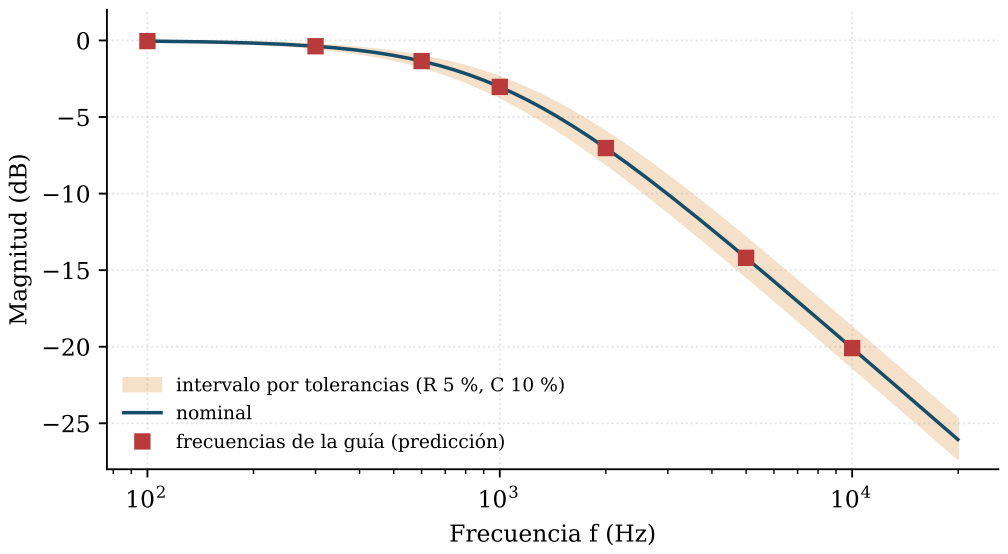
[picture p32: figure]
Frecuencia f (Hz); Magnitud (dB); nominal frecuencias de la guía (predicción)

intervalo por tolerancias (R 5 %, C 10 %)

Figura 31: Predicción del LPF (cálculo): curva nominal en azul, banda de tolerancias en naranja y frecuencias de la guía como cuadrados rojos. No contiene mediciones. El estudiante puede superponer sus datos medidos en una copia de esta figura.

Debe observarse que la incertidumbre en dB crece donde la curva es más pendiente, cerca de fc.

### 11.3. Ejemplo S03-3-B Fase por retardo y efecto de la sonda

Enunciado. (1) Obtener la fase a partir del retardo temporal ∆t entre CH1 y CH2. (2) Estimar el efecto de una sonda de 1 MΩ en paralelo con 100 pF en CH2 (datos de ejercicio; usar el valor del manual de la sonda real).
Método. Un retardo de la salida respecto de la entrada equivale a un desfase φ = −360◦f ∆t. A f = fc, φ = −45◦
:

∆t =

|φ|
360◦f

=

1
8fc

=

1
8(994,7) = 125,7 µs. | (64)

Sonda en paralelo con C: la resistencia vista por C pasa a R ∥ Rp = 1597,4 Ω y la capacidad a C + Cp = 100,1 nF, de modo que

fc =

1
2π(1597,4)(100,1 × 10⁻⁹)

= 995,3 Hz (+0,06 %), K =

Rp
R + Rp

= 0,9984 = −0,014 dB.

(65)
Interpretación. La sonda altera fc en un 0,06 %, muy por debajo de la tolerancia de los componentes; con R = 1 MΩ no sería despreciable. Comprobación independiente. El caso límite Rp → ∞, Cp → 0 recupera 994,7 Hz; y a 994,7 Hz, la fase de −45◦ y ∆t = 1/(8fc) coinciden con el cálculo de la fórmula (54).

### 11.4. Guía de simulación (resultados rotulados como simulación)

En el programa elegido por el docente (por ejemplo, ngspice) simular el circuito de la Figura 30:
(1) análisis AC de 10 Hz a 100 kHz, 20 puntos por década, y lectura de |H| en dB y fase en las frecuencias de la tabla; (2) análisis transitorio con un escalón de 0 a 3,3 V y lectura del tiempo de subida 10–90 %; (3) repetir con Rs = 50 Ω y con RL = 4,7 kΩ. Rotular cada captura como «simulación» y registrar la versión del programa.

### 11.5. Guía de medición

1. Medir R y C con el multímetro o el medidor LCR y anotarlos; calcular fc con esos valores.
2. Ajustar el generador: sinusoidal de 2 V pico a pico, sin desplazamiento, y confirmar la configuración de carga.
3. Para cada frecuencia de la tabla, ajustar el osciloscopio para ver varios periodos, leer Vpp de CH1 y CH2 con los cursores y el retardo ∆t entre cruces por cero. Mantener Vpp de CH1 constante; si cambia con la frecuencia, anotarlo.
4. Calcular |H| = Vo,pp/Vi,pp, GdB = 20 log10 |H| y φ = −360◦f∆t.
5. Localizar la frecuencia donde |H| = 0,707 |H|baja frecuencia y la fase vale −45◦ para obtener fc medida.
6. Conectar RL = 4,7 kΩ y repetir 4 y 5 en 600, 1000 y 2000 Hz; anotar K y f

′
c

7. Completar las tablas.

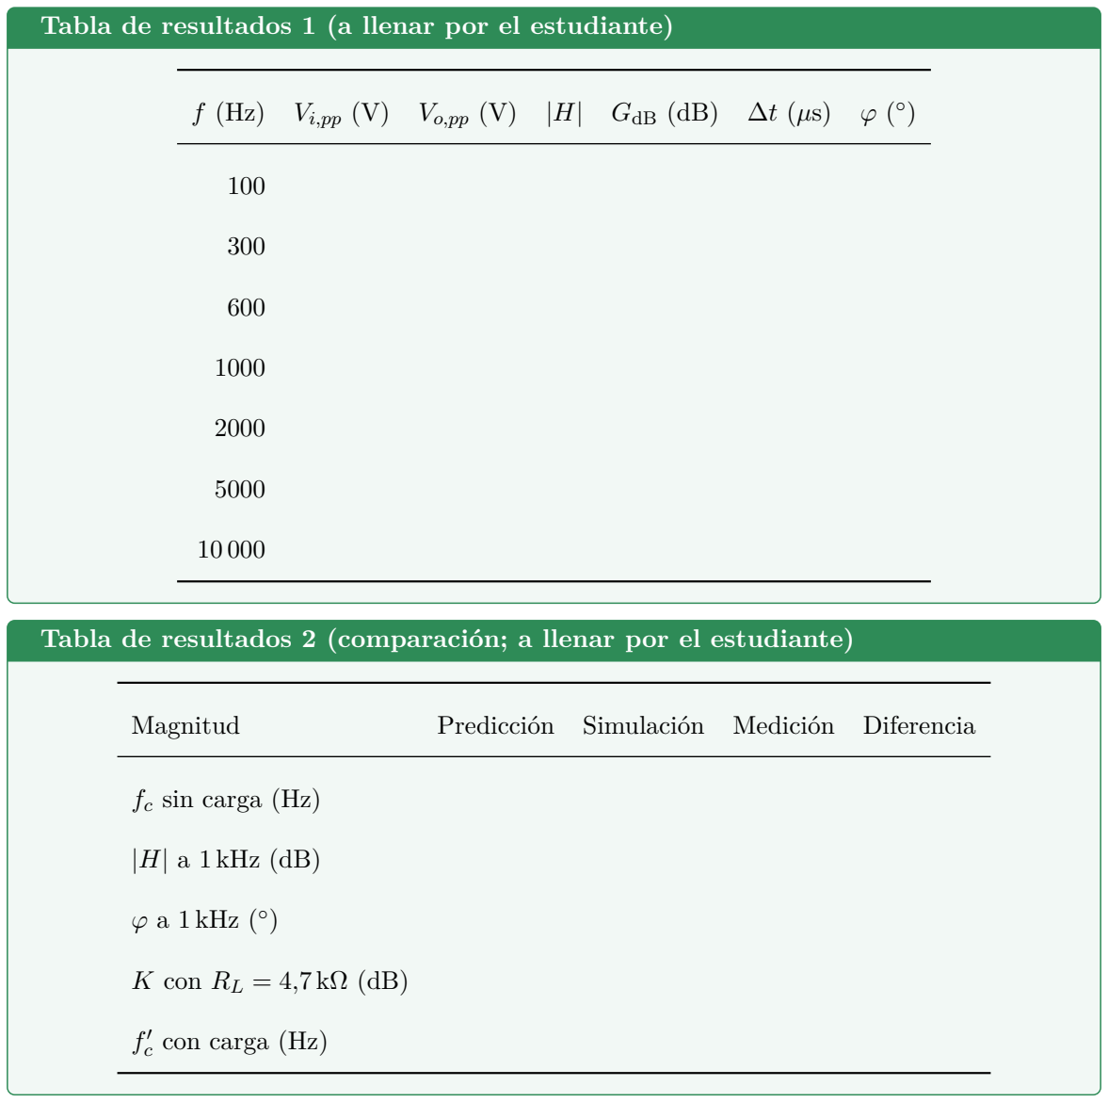
[picture p33: figure]
Magnitud; Predicción Simulación Medición Diferencia; fc sin carga (Hz); |H| a 1 kHz (dB); φ a 1 kHz (; K con RL = 4,7 kΩ (dB); con carga (Hz)

Tabla de resultados 1 (a llenar por el estudiante)

f (Hz) Vi,pp (V) Vo,pp (V) |H| GdB (dB) ∆t (µs) φ (

Tabla de resultados 2 (comparación; a llenar por el estudiante)

Registrar también R y C medidos, el modelo de los instrumentos y las diferencias explicadas por la tolerancia (intervalo del ejemplo A).

### 11.6. Ejercicios

S03-3-E1. El generador tiene Rs = 50 Ω en serie y la sonda de CH2 equivale a 1 MΩ en paralelo con 100 pF. Con R = 1,6 kΩ y C = 100 nF hallar la fc y el cambio respecto del valor nominal. ¿Explica esto una discrepancia de 10 % entre predicción y medición?

S03-3-E2. Para una entrada de 2 V pico a pico, predecir |H|, GdB, Vo,pp, la fase y el retardo ∆t del filtro nominal a 3 kHz y a 10 kHz.

Pregunta conceptual. Un estudiante ajusta el generador en «carga de 50 Ω» pero conecta el RC de ≈ 1,6 kΩ. ¿Qué amplitud real hay en CH1 respecto de la mostrada en el generador, y cómo afecta eso a |H|?

Error frecuente

Calcular |H| con la amplitud que muestra el generador en vez de la medida en CH1.

Medir fc en el 50 % de la amplitud en lugar de 70,7 %.

Leer ∆t con una escala horizontal demasiado gruesa o desde cruces distintos.

Conectar la masa de la sonda a un nodo que no es tierra.

Olvidar Rs, la sonda o la carga al comparar con la teoría, y presentar una simulación como medición.

### 11.7. Conexión con el curso y el proyecto

La tabla de comparación es el formato de evidencia del proyecto: cada decisión de diseño se respalda con predicción, simulación y medición, y las diferencias se atribuyen a causas concretas. En la semana 4 se repetirá este procedimiento con el pasa altas.

### 12. Código y recursos de la semana

Notebooks y scripts de la semana 3

Los notebooks de Python están en codigo/python/semana_03/ y se entregan ejecutados, con assert de comprobación. Los scripts de MATLAB están en codigo/matlab/semana_03/ y no se ejecutaron en este entorno.

clase1_tipos_filtros.ipynb y clase1_tipos_filtros.m: conversión dB–razón, especificación de atenuación (S03-1-A), frecuencia central y ancho de banda del pasa banda (S03-1-B), ejercicios S03-1-E1 y E2, y la Figura 25.

clase2_lpf_rc.ipynb y clase2_lpf_rc.m: deducción simbólica de H(s) sin y con carga, diseño (S03-2-A), filtro cargado (S03-2-B), respuesta temporal (E1), fuente con resistencia interna (E2) y las Figuras 27, 28 y 29.

clase3_laboratorio_lpf.ipynb y clase3_laboratorio_lpf.m: predicciones y tolerancias del laboratorio (S03-3-A y S03-3-B), ejercicios S03-3-E1 y E2 y la Figura 31. Las columnas de simulación y medición no se generan: las llena el estudiante.

### 13. Referencias de la semana

The SciPy community. scipy.signal.freqs (documentación de la función usada para comprobar H(s) en los notebooks). Documentación en línea de la versión estable vigente en la fecha de consulta. https://docs.scipy.org/doc/scipy/reference/generated/scipy.signal.fr eqs.html. (https://docs.scipy.org/doc/scipy/reference/generated/scipy.signal.freqs.html) Consultado el 2026-11-03.

Ngspice project. Ngspice User’s Manual (análisis AC y transitorio para la guía de simulación del jueves). Manuales por versión (por ejemplo, versión 44). https://ngspice.sourceforge.io/docs.html. (https://ngspice.sourceforge.io/docs.html) Consultado el 2026-11-03.

### Parte IV

# Semana 4: Filtro pasa altas

### 14. S04-1 Filtro pasa altas: principio de funcionamiento, aplicaciones y acoplo AC

Resultados, prerrequisitos y distribución

Al terminar, el estudiante podrá (1) explicar por qué un condensador en serie bloquea la continua y deja pasar la señal variable; (2) calcular la frecuencia de corte y la constante de tiempo de un HPF RC y evaluar su efecto sobre una señal con nivel de continua; (3) dimensionar un condensador de acoplo para la entrada de un amplificador. Se comprueba al final con S04-1-E1.
Prerrequisitos: impedancia del condensador ZC = 1/(jωC), divisor de tensión y constante de tiempo (semanas 1 a 3). Esta sesión usa el divisor de impedancias; la función H(s) se desarrolla el miércoles.

Distribución propuesta de 120 minutos

Diagnóstico, 10 min (impedancia del condensador a baja y alta frecuencia, sin calificar). Explicación del principio, 25 min. Ejemplos guiados, 30 min. Práctica de los ejercicios, 40 min. Cierre y contraste de resultados, 15 min. Antes de la clase, el estudiante repasa el LPF RC de la semana 3; ese trabajo previo no cuenta como tiempo presencial.

### 14.1. Concepto físico y modelo

Un condensador ideal se opone a los cambios lentos de tensión: su corriente es i = C dv/dt. En continua (dv/dt = 0) no circula corriente y el condensador se comporta como circuito abierto; a frecuencias altas su impedancia |ZC| = 1/(ωC) tiende a cero y se comporta como un cortocircuito. Un filtro pasa altas (HPF) de primer orden aprovecha este comportamiento: el condensador C va en serie con la señal y la resistencia R a tierra, y la salida se toma en R (Figura 32).

Símbolos: vi es la tensión de entrada de una fuente ideal, vo la tensión en R respecto de tierra, τ = RC la constante de tiempo y fc la frecuencia de corte. Hipótesis: componentes ideales, fuente de impedancia nula y salida sin carga (circuito abierto). Para una entrada senoidal en régimen permanente, el divisor de impedancias da
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
jωRC
1 + jωRC , fc =

1
2πRC , | τ = RC. | (66)

En f = fc la magnitud es 1/

√
2 (−3,01 dB) y la fase es +45◦ (la salida adelanta a la entrada). Por debajo de fc la magnitud crece 20 dB por década; por encima, tiende a 1.

vi

C

vo

R

i

tierra

nodo vo medido
respecto de tierra

Figura 32: HPF RC. El condensador C está en serie con la señal y R conecta el nodo de salida a tierra. vo se mide respecto de tierra y la salida no tiene carga.

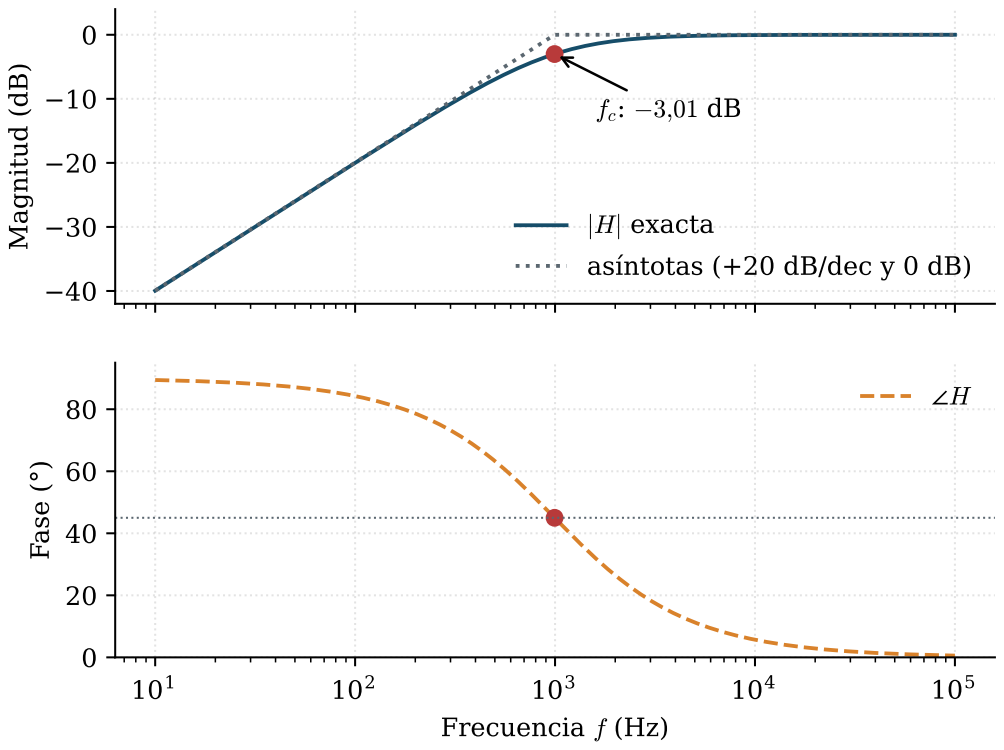
[picture p34: figure]
Magnitud (dB); jHj exacta asíntotas (+20 dB/dec y 0 dB); Frecuencia f (Hz); Fase (°)

Figura 33: Diagrama de Bode del HPF con R = 1,6 kΩ y C = 100 nF (fc = 994,7 Hz), calculado en el notebook clase1_principio_acoplo. Se observa que la curva exacta se aparta de las asíntotas −3,01 dB en fc y que la fase pasa de 90◦ a 0

- pasando por 45◦
en fc.

Respuesta temporal. Si la entrada salta en t = 0 de 0 a V0, el condensador está descargado y se comporta como cortocircuito: vo(0⁺) = V0. Después se carga a través de R y la corriente decae, de modo que
vo(t) = V0 e
−t/τ , | t ≥ 0, | (67)

y en régimen permanente la salida es nula aunque la entrada se mantenga en V0. Con una cuadrada, la salida se «inclina» si el semiperiodo T /2 no es mucho menor que τ (Figura 34).

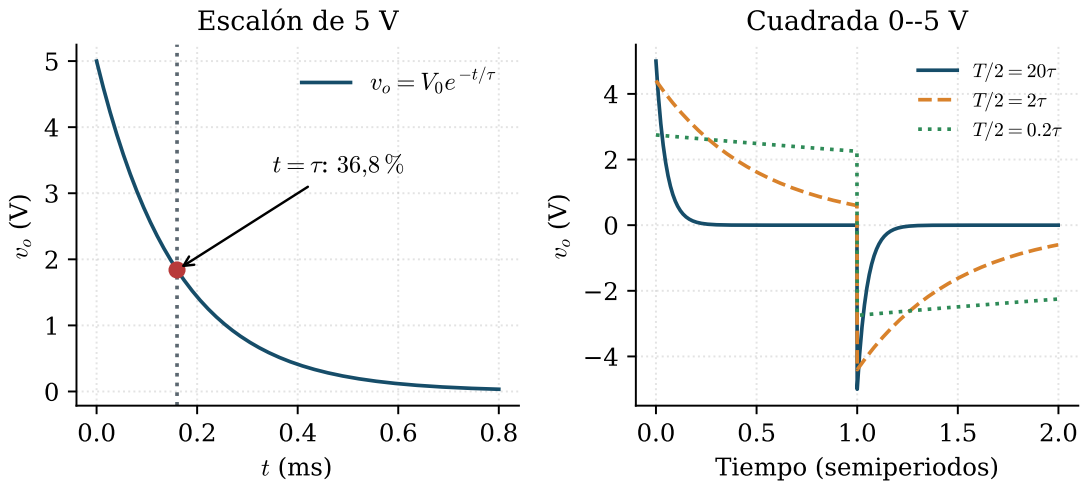
[picture p35: figure]
Escalón de 5 V; Tiempo (semiperiodos); Cuadrada 0--5 V

Figura 34: Izquierda: escalón de 5 V con τ = 0,16 ms; en t = τ la salida vale 36,8 % de V0. Derecha: cuadrada de 0 a 5 V en régimen permanente para T /2 = 20τ , 2τ y 0,2τ . Cuanto más corto es el semiperiodo frente a τ , menos se inclina el techo.

Aplicaciones. (i) Acoplo AC: se conecta la salida de un sensor o una etapa a la entrada de otra sin transmitir la polarización de continua de la primera; (ii) eliminación de deriva y desplazamiento de continua en señales de audio, vibración o ECG; (iii) eliminación de ruido de baja frecuencia; (iv) detección de flancos (con τ pequeña la salida sigue la derivada de la entrada). En todos los casos la frecuencia de corte debe estar por debajo de la señal útil más baja.

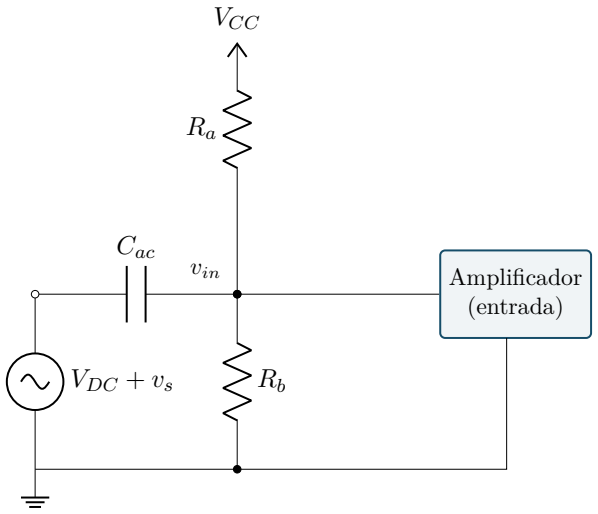
[picture p36: figure]
VDC + vs; Cac; Amplificador (entrada); VCC; vin

Figura 35: Acoplo AC a la entrada de un amplificador. Ra y Rb fijan la polarización VCC/2 en vin; Cac almacena la diferencia de continua entre el sensor y vin. El HPF lo forman Cac y Ra ∥ Rb (se supone una entrada de amplificador de impedancia muy alta).

### 14.2. Ejemplo S04-1-A Parámetros de un HPF de 1 kHz

Enunciado. Un HPF tiene R = 1,6 kΩ y C = 100 nF. Hallar τ , fc, y magnitud, decibelios y fase a f = 100 Hz, fc y 10 kHz.
Datos y supuestos. Componentes ideales, fuente ideal, salida sin carga. Incógnitas: τ , fc, |H|,

∠H.
Método. Ecuación (66), con x = f /fc: |H| = x/√ 1 + x

2 y ∠H = 90◦ − arctan x.

τ = (1600)(100 × 10⁻⁹
) = 0,160 ms, fc =

1
2π(1,6 × 10⁻⁴)
| = 994,7 Hz, | (68)

x(100 Hz) = 0,1005 ⇒ |H| = 0,1000 (−20,0 dB), ∠H = 84,3

| ◦
| , | (69)
x(10 kHz) = 10,05 ⇒ |H| = 0,9951 (−0,04 dB), ∠H = 5,7

◦
. | (70)

Interpretación. A una décima de fc la señal se atenúa un factor 10; a una década por encima, apenas se modifica. Comprobación independiente. En fc el condensador tiene |ZC| = 1/(2πfcC) = 1,6 kΩ = R, y R/|R + ZC| = 1/

√
2 (verificado en el notebook).

### 14.3. Ejemplo S04-1-B Condensador de acoplo para un amplificador

Enunciado. La salida de un sensor (VDC = 0,8 V, señal 0,1 V pico a 200 Hz) se acopla al amplificador de la Figura 35, con VCC = 3,3 V y Ra = Rb = 100 kΩ. La señal útil más baja es 20 Hz. Elegir Cac, hallar fc, el tiempo de establecimiento, la tensión continua del condensador y la amplitud en vin a 200 Hz.
Método. La resistencia vista por Cac es el paralelo Ra ∥ Rb (Thévenin de la red de polarización); se exige fc ≤ 20 Hz.

Rin = Ra ∥ Rb = 50 kΩ, Cac ≥

1

2πRinfm´ın = | 1
2π(50 000)(20) = 159,2 nF. | (71)

Se elige el valor normalizado Cac = 220 nF (la tolerancia del condensador debe verificarse en el montaje). Entonces

τ = RinCac = 11,0 ms, fc =

1
2πτ
= 14,5 Hz, | 5τ = 55 ms, | (72)

VC = VDC −

VCC
2
= 0,8 − 1,65 = −0,85 V. | (73)

A 200 Hz, |H| = 0,9974, así que la amplitud en vin es 99,7 mV centrada en 1,65 V; a 20 Hz, |H| = 0,810 (−1,83 dB), aceptable porque fc < 20 Hz.

Interpretación. El condensador absorbe los 0,85 V de diferencia y la polarización del amplificador no depende del sensor. Tras conectar, hay que esperar ≈ 5τ = 55 ms para que vin se estabilice. Comprobación independiente. A fm´ın = 20 Hz, fc = 14,5 Hz da −1,83 dB y, con C = 159,2 nF, fc sería exactamente 20 Hz (el límite del diseño).

### 14.4. Ejercicios

S04-1-E1 (parámetros y señal con continua). Un HPF tiene R = 3,3 kΩ y C = 47 nF. Hallar fc, |H| y fase a 300 Hz, y la señal de salida cuando la entrada es 2 + 0,5 sen(2π 300 t) V.

S04-1-E2 (escalón). Con el HPF del ejemplo A y un escalón de 5 V, hallar vo en t = 0,1 ms, el instante en que vo = 0,5 V y la tensión del condensador en t = 0,1 ms.

Pregunta conceptual. Con una entrada de 5 V continua durante mucho tiempo, la salida del HPF es nula. ¿Dónde queda esa tensión de 5 V y por qué no circula corriente por R?

### 14.5. Errores frecuentes y comprobaciones

Tomar la salida en el condensador (eso es un LPF) en lugar de en R.

Usar ω = 1/RC en una fórmula pedida en Hz, o viceversa.

Olvidar que R del filtro es el paralelo de las resistencias de polarización (Figura 35).

Suponer que un HPF «elimina» el ruido de alta frecuencia: lo deja pasar.

Ignorar que, con un condensador polarizado, la tensión continua VC debe mantener la polaridad correcta (en el ejemplo B, VC < 0 si el sensor está a menos de VCC/2).

Comprobaciones: en fc debe valer 1/

√
2 y 45◦
; en continua, 0; muy por encima, 1.

### 14.6. Conexión con el proyecto

En el acondicionamiento de un sensor, el HPF de acoplo fija qué parte de la señal se conserva y qué polarización recibe el siguiente bloque. Para el miércoles, repasar el LPF de la semana 3 y calcular fc con los componentes que se usarán en el laboratorio. Para el ADC del microcontrolador, la señal acoplada debe polarizarse dentro del rango de entrada de la variante elegida (a verificar con la documentación primaria).

### 15. S04-2 Desarrollo matemático del HPF, comparación con el LPF y pasa banda simple

Resultados, prerrequisitos y distribución

Al terminar, el estudiante podrá (1) obtener H(s) del HPF RC y deducir de ella polo, cero, frecuencia de corte, magnitud y fase; (2) comparar un LPF y un HPF construidos con los mismos R y C; (3) formar un pasa banda con un HPF seguido de un LPF y cuantificar el efecto de carga entre etapas. Se comprueba al final con S04-2-E2.
Prerrequisitos: S04-1 y la función de transferencia del LPF (semana 3). Se supone la respuesta con condiciones iniciales nulas.

Distribución propuesta de 120 minutos

Diagnóstico, 10 min (¿dónde se toma la salida del LPF y del HPF?). Explicación de H(s), 25 min. Ejemplos guiados, 35 min. Práctica de los ejercicios, 35 min. Cierre, 15 min. Trabajo previo: calcular fc de los componentes del laboratorio del jueves (no cuenta como tiempo presencial).

### 15.1. Concepto físico y modelo

Con condiciones iniciales nulas, el condensador es ZC = 1/(sC) y el divisor de tensión da

HHP (s) = Vo(s)
Vi(s)

=

R

R +

1
sC

=

sRC
1 + sRC =

s
s + ωc

, ωc =

1
RC . | (74)

Hay un cero en s = 0 (la continua no pasa) y un polo en s = −ωc. Con s = jω y x = ω/ωc = f /fc:

|HHP (jω)| =

x
√
1 + x

2

, | ∠HHP = 90◦ − arctan x, | fc =

ωc
2π

=

1
2πRC . | (75)

La frecuencia de corte se define por |H| = 1/

√
2, es decir, x = 1 (potencia mitad). Para x ≪ 1, |H| ≈ x, de modo que cada década de frecuencia multiplica la magnitud por 10 (+20 dB/década). Los símbolos: ωc en rad/s y fc en Hz; s y jω solo coinciden en régimen senoidal permanente.

LPF frente a HPF. Con los mismos R y C y la salida en C o en R,

HLP (s) = | 1
1 + sRC , | HLP (s) + HHP (s) = 1, | |HLP |

2 + |HHP |

2 = 1 (para s = jω). (76)

Comparten fc, polo y constante de tiempo, pero el LPF tiene ganancia 1 en continua y el HPF ganancia 1 en alta frecuencia. Las fases son complementarias en el sentido de ∠HHP − ∠HLP = 90◦ .
La Figura 36 muestra que ambas curvas se cruzan en fc con −3,01 dB.

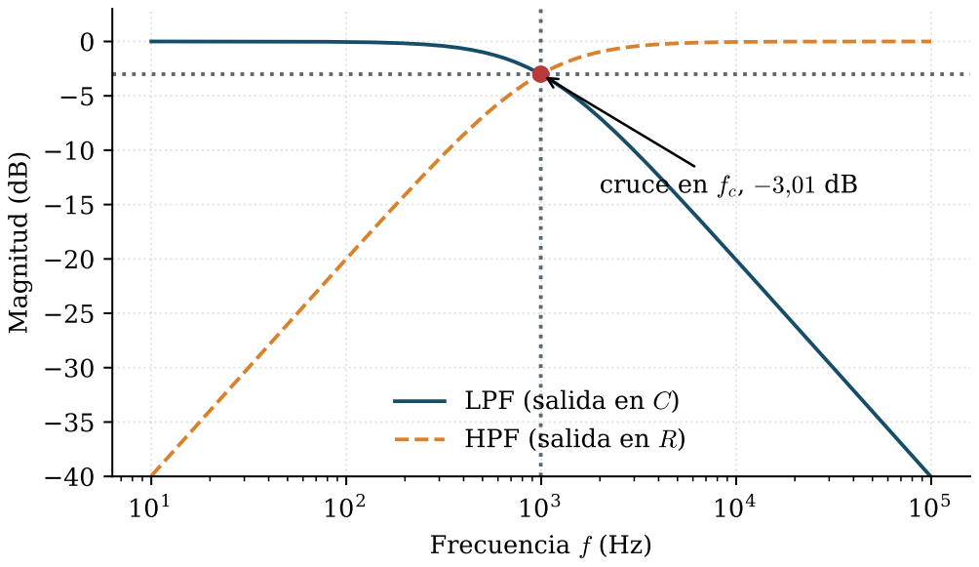
[picture p37: figure]
Frecuencia f (Hz); Magnitud (dB); cruce en fc, ¡3;01 dB; LPF (salida en C) HPF (salida en R)

Figura 36: Magnitud de un LPF y un HPF con R = 1,6 kΩ y C = 100 nF (fc = 994,7 Hz), calculada en clase2_hs_comparacion_pasabanda. Debe observarse el cruce en fc y las pendientes opuestas de ±20 dB/década.

Pasa banda simple. Un HPF con fc1 seguido de un LPF con fc2 > fc1 deja pasar la banda intermedia. Si se conectan directamente (Figura 37), la segunda etapa carga a la primera y no basta multiplicar las funciones. Con τ1 = R1C1, τ2 = R2C2 y el nodo v1, el análisis nodal da
H(s) = | sτ1
1 + s (τ1 + τ2 + R1C2) + s

2τ1τ2

frente a Hideal(s) = | sτ1
(1 + sτ1)(1 + sτ2)

. (77)

El término R1C2 es el efecto de carga: desaparece solo si R2 ≫ R1 en la banda de interés (la segunda etapa presenta una impedancia alta a la primera). Con un amplificador separador (seguidor) entre

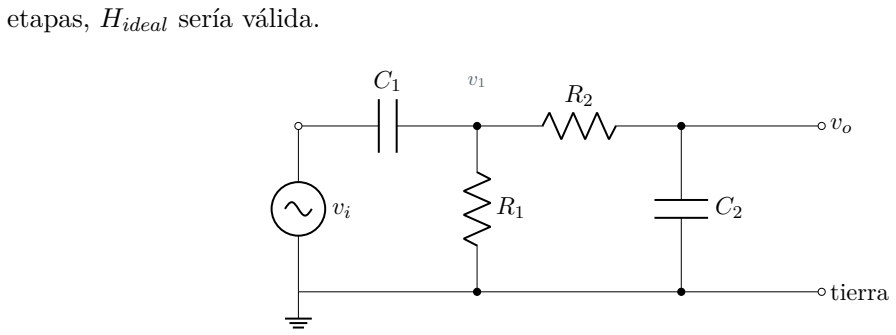
[picture p38: figure]
etapas, Hideal sería válida.; tierra

etapa HPF etapa LPF (carga de la HPF)

Figura 37: Pasa banda de HPF seguido de LPF sin separador. v1 es el nodo común; R1 ve a R2 + 1/(sC2) como carga.

### 15.2. Ejemplo S04-2-A Obtención de H(s), corte y asíntotas

Enunciado. Obtener H(s) de la Figura 32 con R = 1,6 kΩ, C = 100 nF y evaluar la respuesta a fc/10 y 10fc.

Método. Divisor de impedancias en el dominio s (circuito de una sola malla, sin carga).

H(s) = sRC
1 + sRC =

s
s + 6250

, ωc =

1
RC = 6250 rad/s, | fc = 994,7 Hz, | (78)

x = 0,1 : |H| =

0,1
√
1,01

= 0,0995 (−20,04 dB), ∠H = 84,3

◦
, | (79)

x = 10 : |H| =

10
√
101

= 0,9950 (−0,04 dB), ∠H = 5,7

◦
. | (80)

Interpretación. A fc/10 las asíntotas dan exactamente −20 dB; el error de la asíntota es 0,04 dB. Comprobación independiente. Se resolvió simbólicamente |H|

2 = 1/2 y se obtuvo ω = 1/(RC) (notebook); además HHP + HLP = 1 en todo s.

### 15.3. Ejemplo S04-2-B Pasa banda con carga entre etapas

Enunciado. En la Figura 37, R1 = R2 = 1,6 kΩ, C1 = 100 nF, C2 = 10 nF. Comparar la función exacta con el producto ideal; repetir con R2 = 16 kΩ, C2 = 1 nF.

Datos y método. τ1 = 160 µs, τ2 = 16 µs, R1C2 = 16 µs. Cada etapa aislada tendría fc1 = 994,7 Hz y fc2 = 9947 Hz. Se usa (77), deducida por nodal en v1 y vo (comprobada simbólicamente en el notebook).
H(s) = | 1,6 × 10⁻⁴
s
1 + 1,92 × 10⁻⁴s + 2,56 × 10⁻⁹s
2
. | (81)

Los polos reales quedan en 896 Hz y 11 040 Hz, desplazados respecto de 995 Hz y 9947 Hz. Resultados numéricos:

Exacta (con carga) | Producto ideal
Ganancia máxima | 0,833 (−1,58 dB) en 3,15 kHz | 0,909 (−0,83 dB)
Banda a −3 dB respecto del máximo | 779 Hz a 12 685 Hz | 840 Hz a 11 770 Hz
|H| en 995 Hz | 0,667 | 0,704

Con R2 = 10R1 y C2 = 1 nF (mismos cortes aislados), el pico exacto sube a 0,901, muy próximo al ideal 0,909.
Interpretación. Sin separador, la segunda etapa reduce la ganancia máxima en 8 % y ensancha la banda; el pasa banda no está centrado en la media de los cortes aislados. La Figura 38 lo muestra. Comprobación independiente. En f → 0 y f → ∞ ambas funciones tienden a 0; con R1C2 → 0 la exacta se reduce al producto ideal.

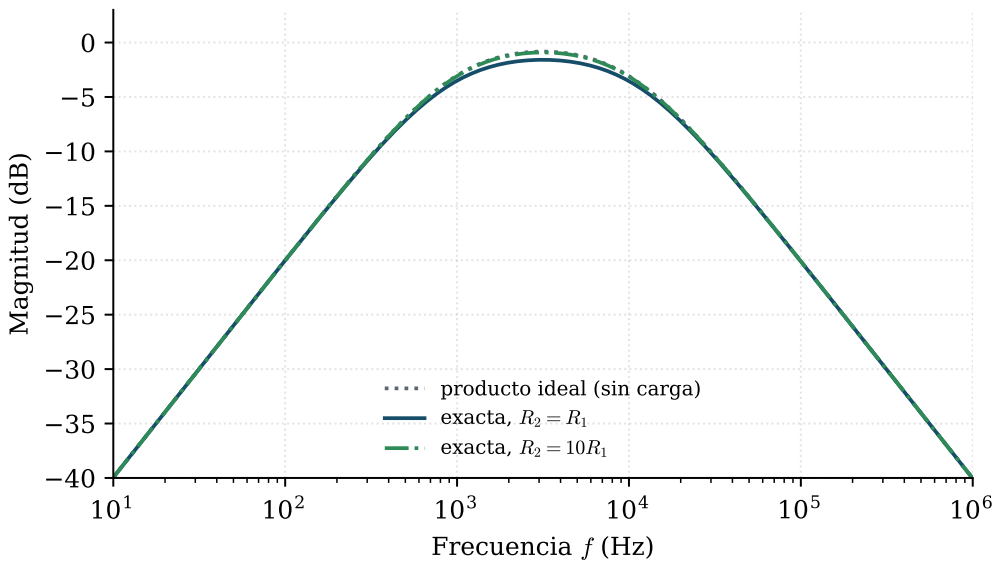
[picture p39: figure]
Frecuencia f (Hz); Magnitud (dB); exacta, R2 = 10R1

producto ideal (sin carga) exacta, R2 = R1

Figura 38: Magnitud del pasa banda: producto ideal (puntos), exacta con R2 = R1 y exacta con R2 = 10R1 (calculadas en clase2_hs_comparacion_pasabanda). Debe observarse que la carga disminuye el máximo y que el aumento de R2 lo recupera.

### 15.4. Ejercicios

S04-2-E1 (LPF y HPF). Con R = 3,3 kΩ y C = 47 nF, hallar fc y, a 2 kHz, HHP y HLP (magnitud y fase). Comprobar HHP + HLP = 1 y |HHP |

2 + |HLP |

2 = 1.

S04-2-E2 (carga y resistencia de la fuente). Al HPF de R = 1,6 kΩ, C = 100 nF se conecta una carga RL = 4,7 kΩ a la salida. (a) Con fuente ideal, hallar fc y la ganancia en la banda de paso.
(b) Repetir con una fuente de resistencia Rs = 50 Ω. Explicar si la carga se comporta como parte del filtro.

Pregunta conceptual. Un estudiante conecta un HPF con fc = 10 kHz seguido de un LPF con fc = 1 kHz. ¿Qué respuesta obtiene? Estimar |H| a 3,16 kHz.

### 15.5. Errores frecuentes y comprobaciones

Multiplicar HHP HLP sin considerar que la segunda etapa carga a la primera.

Escribir |H| = 1/

√
2 y llamarlo −3 dB «de ganancia máxima» cuando el máximo es menor que 1 (el pasa banda cargado tiene máximo 0,833).

Usar fc = 1/(RC) sin 2π.

Olvidar que la resistencia de salida de la fuente y la carga cambian R efectiva.

Dar la fase de un HPF como negativa (es positiva: adelanto).

### 15.6. Conexión con el proyecto

Un pasa banda simple selecciona la banda del sensor y rechaza deriva y ruido. Antes de elegir componentes, se calcula el efecto de carga con (77); si no es aceptable, se aumenta la relación R2/R1 o se añade un seguidor. El notebook de esta sesión sirve de plantilla para documentar la decisión.

### 16. S04-3 Laboratorio: HPF RC, respuesta en frecuencia, fase y respuesta cuadrada

Resultados, prerrequisitos y distribución

Al terminar, el estudiante podrá (1) montar un HPF RC y medir |H| y fase con generador y osciloscopio; (2) localizar fc como el punto donde |H| = 0,707; (3) explicar las diferencias entre predicción y medición por tolerancias, resistencia del generador y carga de las sondas. Se comprueba con la tabla de resultados y con S04-3-E1 y S04-3-E2.

Prerrequisitos: S04-1 y S04-2. Trabajo previo: calcular la columna de predicción de la Tabla 3 con los componentes reales (medir R y C) y preparar la simulación. No se incluyen mediciones; los espacios los completa el estudiante.

Distribución propuesta de 120 minutos

Diagnóstico y seguridad, 10 min (conexión de tierras). Simulación del HPF, 25 min. Montaje y medición de |H| y fase, 50 min. Respuesta cuadrada y contraste teoría–simulación–medición, 25 min. Cierre, 10 min. Si falta tiempo, la respuesta cuadrada se completa en una sesión posterior.

Seguridad y material

Solo baja tensión aislada: senoidal de 1 V pico (2 V pico a pico) sin desplazamiento, y cuadrada de 0 a 2 V. El generador y el osciloscopio se alimentan de la red; sus masas de señal están unidas a tierra. Antes de conectar, verificar con el multímetro la continuidad entre las masas de generador, CH1 y CH2, y no conectar la masa de una sonda a ningún nodo distinto de la tierra del montaje. Material: R = 1,6 kΩ, C = 100 nF (no polarizado), protoboard, dos puntas ×1 o ×10 y multímetro o medidor LCR.

### 16.1. Guía de simulación (resultados rotulados como simulación)

Simular en el programa que indique el docente el circuito de la Figura 39 con Rs = 0 y con Rs = 50 Ω. Barrido en frecuencia de 100 Hz a 10 kHz; cuadrada de 0 a 2 V a 100 Hz y a 5 kHz. Anotar fc simulada (punto de −3 dB) y compararla con 994,7 Hz.

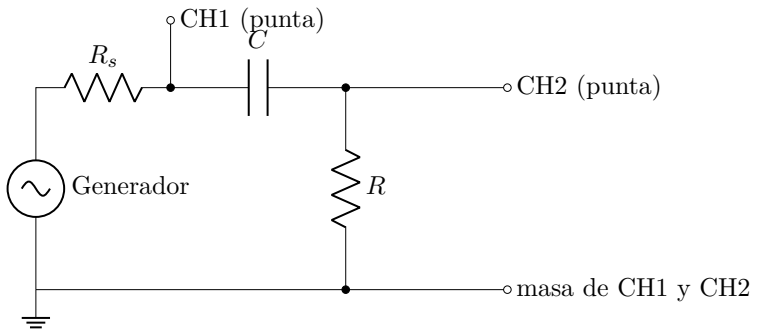
[picture p40: figure]
Generador; CH2 (punta); CH1 (punta); masa de CH1 y CH2

Figura 39: Montaje del HPF. CH1 mide la entrada del filtro (tras Rs) y CH2 la salida; ambas masas van a la tierra del montaje. Rs es la resistencia de salida del generador (valor del manual del equipo; 50 Ω es un valor habitual, no un dato medido).

### 16.2. Ejemplo S04-3-A Predicción de amplitud, fase y desfase temporal a 1 kHz

Enunciado. Con R = 1,6 kΩ, C = 100 nF y entrada de 2 V pico a pico a 1 kHz, predecir |H|, la fase y el desfase temporal ∆t entre los pasos por cero de CH1 y CH2, sin y con Rs = 50 Ω. Método. Ecuación (75); ∆t = T φ/360◦
(la salida adelanta). Con Rs: f

′
c = 1/(2π(R + Rs)C) =
964,6 Hz y ganancia en banda R/(R + Rs) = 0,9697.

x =

1000
994,7

= 1,005, |H| =

x
√
1 + x

2

= 0,709, φ = arctan

1
x

= 44,85◦
, | (82)

∆t =

44,85
360
- 1 ms = 0,125 ms, | Vo,pp = 2(0,709) = 1,418 V. | (83)

Con Rs: |H| = 0,698, φ = 44,0

- y Vo,pp = 1,396 V respecto de CH1 (entrada del filtro).

Interpretación. A 1 kHz, casi en fc, la salida es 71 % de la entrada y adelanta unos 0,125 ms. Comprobación independiente. En f = fc, φ = 45◦ y ∆t = T /8; la predicción a 1 kHz difiere poco, como corresponde a f ≈ fc (notebook clase3_laboratorio_hpf).

Cuadro 3: Predicciones (cálculo, R = 1,6 kΩ, C = 100 nF) y espacios de medición. Las columnas «med.» están vacías: las completa el estudiante. Entrada nominal 2 V pico a pico.

f (Hz) |H| pred. φ pred.
( ◦)
|H| pred. con Rs | Vi med. (Vpp) Vo med. (Vpp)
|H| med. | ∆t med.
(µs)

φ med. (◦)

100 | 0,100 | 84,3 | 0,100
200 | 0,197 | 78,6 | 0,197
500 | 0,449 | 63,3 | 0,446
1000 | 0,709 | 44,8 | 0,698
2000 | 0,895 | 26,4 | 0,873
5000 | 0,981 | 11,2 | 0,952
10000 | 0,995 | 5,7 | 0,965

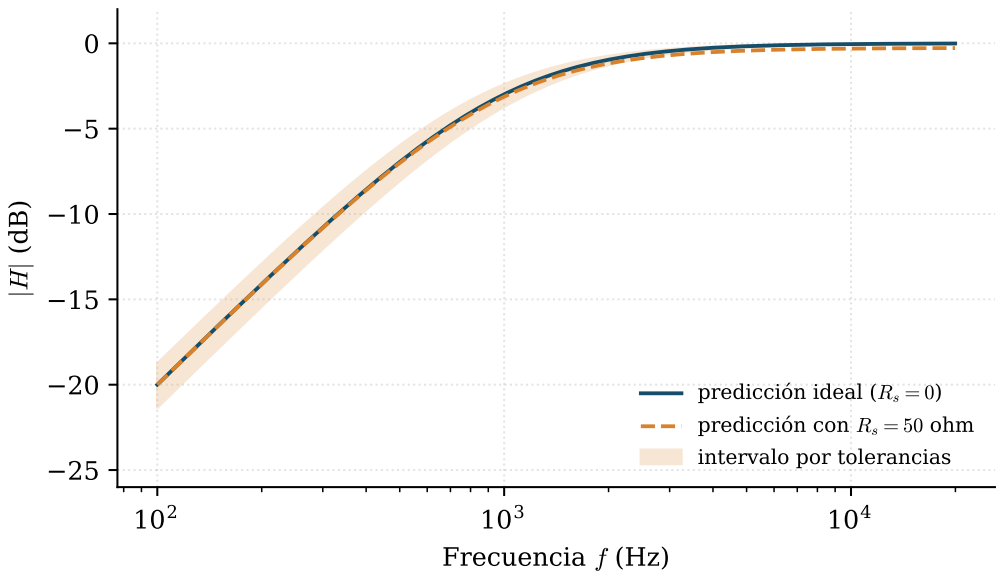
[picture p41: figure]
Frecuencia f (Hz); jHj (d; predicción ideal (Rs = 0) predicción con Rs = 50 ohm intervalo por tolerancias

Figura 40: Predicción (cálculo) de |H| para el HPF, con y sin Rs, y banda sombreada por tolerancias (R ± 5 %, C ± 10 %). Los puntos medidos se superpondrán sobre esta gráfica; si caen fuera de la banda, revisar el montaje.

### 16.3. Ejemplo S04-3-B Tolerancias y determinación de fc

Enunciado. Hallar el intervalo posible de fc por tolerancias, el intervalo de |H| a 1 kHz y el procedimiento para hallar fc con el osciloscopio.
Método. fc ∝ 1/(RC); las cotas son los extremos.

fc,m´ın =

994,7
1,05 · 1,10

= 861 Hz, fc,m´ax =

994,7
0,95 · 0,90
= 1163 Hz, | (84)
|H(1 kHz)| ∈ [ 0,652, 0,758 ]. | (85)

Con Rs = 50 Ω el intervalo se desplaza a 836 Hz a 1126 Hz. Procedimiento. Mantener Vi = 2 Vpp medido en CH1 en cada frecuencia, subir f desde 100 Hz hasta que Vo = 0,707Vi (1,414 Vpp), y anotar f. Interpretación: una fc medida entre 861 Hz y 1163 Hz es compatible con el modelo; fuera, revisar tierras, valores de R y C medidos y Rs. Comprobación independiente. Con los valores reales medidos con LCR, la predicción debe estrecharse al error del instrumento.

### 16.4. Guía de medición

1. Medir R y C con el multímetro o medidor LCR y anotarlos.
2. Montar la Figura 39; verificar la continuidad de masas con el equipo apagado.
3. Ajustar el generador a seno de 2 V pico a pico, sin desplazamiento, y a las frecuencias de la Tabla 3.
4. En cada frecuencia, medir Vi y Vo pico a pico y ∆t con cursores; calcular |H| y φ = 360◦f∆t.
5. Buscar fc (punto de 0,707) y anotarla.
6. Con cuadrada de 0 a 2 V a 100 Hz y a 5 kHz, dibujar CH1 y CH2 y medir la caída del techo.
7. Rotular cada dato como medición o simulación; comparar con la predicción.

### 16.5. Ejercicios

S04-3-E1 (análisis de datos; datos supuestos del ejercicio, no medidos). A 1 kHz se registra Vi = 2,00 Vpp, Vo = 1,40 Vpp y ∆t = 0,12 ms. Calcular |H|, decibelios y fase; compararlos con la predicción y con el intervalo por tolerancias.
S04-3-E2 (efecto de la sonda). La punta ×1 tiene 1 MΩ en paralelo con 100 pF y se conecta a la salida. Estimar el cambio en fc y el error en |H| a 10 kHz.

Pregunta conceptual. ¿Por qué se mide Vi en CH1 en cada frecuencia en vez de suponer 2 V pico a pico del ajuste del generador?

### 16.6. Errores frecuentes y comprobaciones

Medir fase con cursores en picos en lugar de pasos por cero.

Suponer que la amplitud del generador no cambia al conectar el circuito.

Conectar la masa de la sonda CH2 a un nodo distinto de tierra.

Barrer sin reajustar la escala de tiempo del osciloscopio (error de lectura de ∆t).

Presentar una simulación o la predicción como medición.

### 16.7. Conexión con el proyecto

La tabla de comparación predicción–simulación–medición es la evidencia que se pedirá para cada bloque de acondicionamiento. Con el HPF caracterizado, en la semana 5 se pasará a filtros de segundo orden.

### Código y recursos de la semana

Código de la semana

Python (codigo/python/semana_04/, ejecutados con salidas guardadas):

clase1_principio_acoplo.ipynb: parámetros del HPF, Bode, dimensionado del condensador de acoplo, escalón y cuadrada (figuras bode_hpf, acoplo_tiempo, escalon_hpf).

clase2_hs_comparacion_pasabanda.ipynb: deducción simbólica de H(s), comparación LPF/HPF y pasa banda con carga (figuras lpf_vs_hpf, pasabanda).

clase3_laboratorio_hpf.ipynb: predicciones de laboratorio, tolerancias, Rs y sonda (figura lab_prediccion).

MATLAB (codigo/matlab/semana_04/; no ejecutados en este entorno), con los mismos cálculos:

clase1_principio_acoplo.m

clase2_hs_comparacion_pasabanda.m

clase3_laboratorio_hpf.m

### Referencias de la semana

Esta semana no incorpora referencias externas: no se pudo verificar en línea ninguna fuente con URL o DOI al 2026-11-03. Las deducciones (divisor de impedancias y análisis nodal del pasa banda) son propias y se comprobaron simbólicamente en los notebooks. Pendiente: añadir una referencia de texto de teoría de circuitos verificada.

### Parte V

# Semana 5: Filtros de segundo orden y Parcial

1

### 17. S05-1 Introducción al segundo orden: circuitos RLC serie y paralelo

Resultados, prerrequisitos y distribución

Al terminar, el estudiante podrá (1) obtener la función de transferencia de un RLC serie o paralelo y escribirla con ω0 y ζ; (2) clasificar la respuesta como sobreamortiguada, críticamente amortiguada o subamortiguada a partir de los polos; (3) predecir el sobreimpulso y el tiempo de pico del escalón. Se comprueba al final con S05-1-E2.

Prerrequisitos: impedancias en Laplace y polos (semana 2), constante de tiempo del RC y del RL (semanas 1, 3 y 4). Condiciones iniciales nulas en toda H(s) de esta sesión.

Distribución propuesta de 120 minutos

Diagnóstico, 10 min (obtener H(s) de un RC y ubicar su polo). Explicación, 30 min. Ejemplos guiados, 30 min. Práctica de los ejercicios, 35 min. Cierre, 15 min. Antes de la clase, el estudiante repasa raíces de un polinomio de segundo grado y la impedancia de L y C en Laplace; ese trabajo no cuenta como tiempo presencial.

### 17.1. Concepto físico y modelo

Un circuito con dos elementos que almacenan energía de distinto tipo (un inductor L y un condensador C) puede intercambiar energía entre el campo magnético y el eléctrico. Esa oscilación se amortigua porque la resistencia R disipa. El modelo es una ecuación diferencial lineal de segundo orden; en Laplace, un denominador de grado 2 con dos polos.

Símbolos. ω0 es la frecuencia natural no amortiguada (rad/s) y f0 = ω0/2π su valor en Hz. ζ es el factor de amortiguamiento (adimensional). Q es el factor de calidad (adimensional), con Q = 1/(2ζ) en estos circuitos. ωd es la frecuencia de la oscilación amortiguada.

RLC serie. Con la fuente vs, la corriente común i y salida en el condensador (Figura 41), la división de impedancias da, con condiciones iniciales nulas,

HC(s) = VC
Vs

=

1/(sC)
R + sL + 1/(sC)

=

1
LCs² + RCs + 1

=

ω

2
0
s

2 + 2ζω0s + ω

2
0
, | (86)

ω0 =

1
√
LC

, ζ =

R
2

s
C
L

, Q =

1
2ζ

=

ω0L
R
. | (87)

Si la salida se toma en R, HR(s) = RCs/(LCs² + RCs + 1), que es la respuesta pasa banda de la sesión S05-2.

RLC paralelo. Con una fuente de corriente is y tensión común v (Figura 42), la impedancia vista es

V
Is

=

1
1/R + 1/(sL) + sC =

s/C

s

2 +

s
RC +

1
LC

, ω0 =

1
√
LC

, ζ =

1
2R

s
L
C

, Q = R

s
C
L

. (88)

En el paralelo, R mayor da menos amortiguamiento; en el serie, R menor.

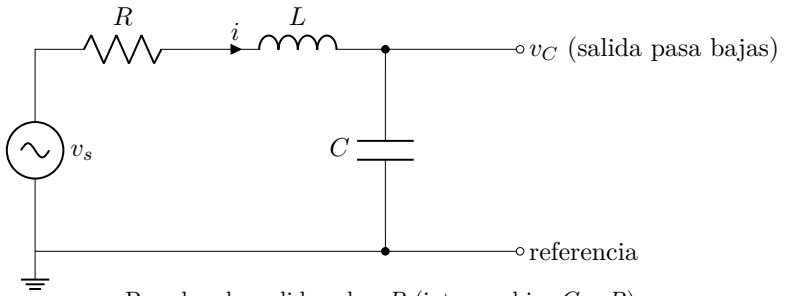
[picture p42: figure]
vC (salida pasa bajas); referencia

Pasa banda: salida sobre R (intercambiar C y R).

Figura 41: RLC serie con corriente i y referencia en el terminal inferior. La salida vC da la respuesta pasa bajas; con R y C intercambiados, la salida en R da la pasa banda. Fuente ideal.

is

v

R | L | C

Figura 42: RLC paralelo alimentado por la fuente de corriente is. La tensión v es común a las tres ramas y se mide respecto de la referencia inferior.

Polos y régimen. Las raíces de s

2 + 2ζω0s + ω
2/0 son s1,2 = −ω0
ζ ±

p
ζ

2 − 1

ζ > 1: dos polos reales negativos distintos (sobreamortiguado), sin oscilación.

ζ = 1: polo doble real en −ω0 (críticamente amortiguado). En serie, Rc = 2p L/C.

0 < ζ < 1: polos complejos conjugados −ζω0 ± jωd, con ωd = ω0

p
1 − ζ

2 (subamortiguado).

Para un escalón de amplitud V en vs y ζ < 1, el sobreimpulso y el tiempo de pico de vC son

Mp = exp

−

πζ
p
1 − ζ

2

!
, tp =

π
ωd
, | vC(tp) = V (1 + Mp). | (89)

La envolvente decae con constante 1/(ζω0). Los límites confirman el modelo: en continua HC(0) = 1 (el condensador es un circuito abierto, sin caída en R ni L); a muy alta frecuencia |HC| → 0 (el condensador es un cortocircuito). En t = 0⁺, vC = 0 y i = 0 porque vC e i son continuas.

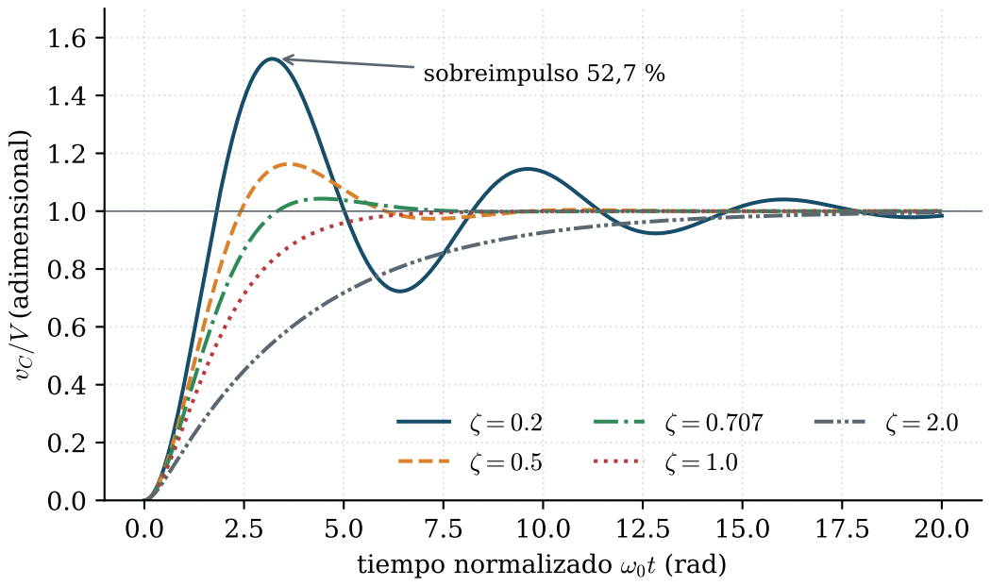
[picture p43: figure]
tiempo normalizado !0t (rad); dim; nsio; sobreimpulso 52,7 %

0.0 | 2.5 | 5.0 | 7.5 | 10.0 12.5 15.0 17.5 20.0

Figura 43: Respuesta de vC/V a un escalón unitario para cinco valores de ζ (cálculo con scipy.signal, cuaderno clase1_segundo_orden). Obsérvese que el sobreimpulso crece al dis-minuir ζ y que para ζ ≥ 1 no existe. El eje es ω0t, adimensional.

### 17.2. Ejemplo S05-1-A Régimen y sobreimpulso de un RLC serie

Enunciado. En la Figura 41, R = 200 Ω, L = 10 mH, C = 100 nF. Hallar ω0, f0, ζ, Q, el régimen, Mp y tp para un escalón de 1 V.

Datos y supuestos. Componentes ideales, fuente ideal, condiciones iniciales nulas. Incógnitas: las indicadas.
Método. Se usan (87) y (89), que son válidas porque el denominador es de segundo orden con salida en C.

ω0 =

1
p
(0,01)(10⁻⁷)
= 31 623 rad/s, | f0 = 5033 Hz, | (90)

ζ =

200
2

s
10⁻⁷
0,01

= 100 (3,162 × 10⁻³
) = 0,316, Q =

1
2ζ
= 1,58. | (91)

Como ζ < 1 es subamortiguado. Entonces ωd = ω0

√
1 − 0,1 = 30 000 rad/s,

Mp = exp
−

π(0,316)
0,9487
= 0,351, tp =

π
30000
= 104,7 µs, | vC(tp) = 1,351 V. | (92)

Interpretación. El condensador alcanza 35 % más que la fuente y oscila con periodo 2π/ωd = 209,4 µs. Comprobación independiente. La simulación numérica del escalón con scipy.signal.step da Mp = 0,3509 y tp = 104,7 µs (cuaderno de la sesión). Además, el valor final es HC(0) = 1.

### 17.3. Ejemplo S05-1-B Elección de R con generador y bobina reales

Enunciado. Con L = 10 mH y C = 100 nF se quiere ζ ≈ 0,707 (sobreimpulso pequeño). El generador tiene Rs = 50 Ω y se supone una resistencia de bobina rL = 20 Ω. Elegir R entre valores comerciales (serie E12: 330, 390, 470 Ω) y predecir Mp.

Método. La resistencia total del lazo es RT = R + Rs + rL; el amortiguamiento depende de RT , no solo de R. De (87), RT = 2ζ

p
L/C.
Paso 1. p
L/C =

p
0,01/10⁻⁷ = 316,2 Ω, luego RT = 2(0,707)(316,2) = 447,2 Ω.

Paso 2. R = 447,2 − 50 − 20 = 377,2 Ω. El valor comercial más cercano es 390 Ω.

Paso 3. Con RT = 390 + 70 = 460 Ω:

ζ =

460
2

(3,162 × 10⁻³

) = 0,727, Mp = exp
−

π(0,727)
√

1 − 0,529
= 0,036. | (93)

Interpretación. El sobreimpulso de 3,6 % es aceptable. Usar R = 447 Ω sin descontar Rs y rL habría dado RT = 517 Ω y ζ = 0,82: más lento de lo diseñado. Comprobación independiente. Las raíces de LCs² + RT Cs + 1 con RT = 460 Ω son complejas con ζ = 0,727 (cuaderno); en el límite Rs = rL = 0, R = 447 Ω recupera ζ = 0,707. El valor de rL es supuesto del ejemplo; en laboratorio se mide.

### 17.4. Ejercicios

S05-1-E1 (sobreamortiguado). Un RLC serie con L = 10 mH, C = 100 nF y R = 2 kΩ tiene salida en C. Hallar ζ, los polos y las dos constantes de tiempo. Indicar cuál polo domina y por qué. S05-1-E2 (crítico y subamortiguado). Con los mismos L y C, hallar la resistencia crítica Rc. Para R = 300 Ω hallar ζ, Mp y tp y decir si el régimen es el mismo que con Rc.
Pregunta conceptual. ¿Qué predice el modelo (87) si R = 0 y qué elemento real impide que ocurra?

### 17.5. Errores frecuentes y comprobaciones

Error frecuente

Usar solo R del esquema e ignorar Rs y rL al calcular ζ.

Aplicar la fórmula del paralelo ζ =

1
2R

p
L/C al serie, o al revés.

Confundir ω0 (rad/s) con f0 (Hz) al sustituir en tp.

Usar ω0 en lugar de ωd en el tiempo de pico.

Escribir s = jω en la ecuación diferencial del escalón: los polos describen el transitorio, no un régimen sinusoidal.

Comprobar siempre: dimensiones de ω0 y ζ, límite en continua y suma de polos igual a −2ζω0.

### 17.6. Conexión con el curso y el proyecto

ω0, ζ y Q son los parámetros con que se diseña y se mide la resonancia en S05-2 y S05-3. En el proyecto, cualquier red RLC de acondicionamiento debe justificar su amortiguamiento con el sobreimpulso aceptable y la resistencia real del lazo. Para la sesión siguiente, calcular Q de un RLC con R = 100 Ω, L = 10 mH y C = 100 nF.

### 18. S05-2 Resonancia, factor de calidad, ancho de banda y amortiguamiento

Resultados, prerrequisitos y distribución

Al terminar, el estudiante podrá (1) identificar la frecuencia de resonancia de un RLC y justificar que ahí la impedancia es real; (2) calcular Q, el ancho de banda a −3 dB y las frecuencias de corte ω1 y ω2; (3) dimensionar un filtro pasa banda a partir de f0 y el ancho de banda requeridos, incluyendo la pérdida de la bobina. Se comprueba con S05-2-E1 y S05-2-E2.
Prerrequisitos: S05-1 (parámetros ω0, ζ, Q) y la respuesta en frecuencia del RC (semana 3). Aquí se usa s = jω en régimen sinusoidal permanente.

Distribución propuesta de 120 minutos

Diagnóstico, 10 min (calcular ω0 y ζ de un RLC dado). Explicación, 30 min. Ejemplos guiados, 30 min. Práctica, 35 min. Cierre, 15 min. Antes de la clase, el estudiante calcula Q del RLC propuesto al final de S05-1; ese trabajo no cuenta como tiempo presencial.

### 18.1. Concepto físico y modelo

La resonancia ocurre cuando las energías máximas almacenadas por L y C son iguales, de modo que las reactancias se anulan. En el RLC serie, la impedancia Z = R + j(ωL − 1/ωC) es puramente resistiva en ω0 = 1/

√
LC y mínima en módulo; la corriente es máxima y está en fase con la tensión.

Símbolos. ω1 < ω0 < ω2 son las frecuencias a las que |H| cae a 1/

√
2 ( −3 dB) del valor de
pico. El ancho de banda es BW = ω2 − ω1 (rad/s) o f2 − f1 (Hz). La selectividad se mide con Q = ω0/BW.

Pasa banda serie (salida en R). Con condiciones iniciales nulas,

HR(jω) = | R
R + j(ωL − 1/ωC)

=

1
1 + jQ

ω
ω0

−

ω0
ω

, Q =

ω0L
R

=

1
ω0RC . | (94)

En ω0, |HR| = 1 y la fase es 0. Los puntos de −3 dB cumplen Q(ω/ω0 − ω0/ω) = ±1:

ω1,2 = ω0

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
, ω2 − ω1 =

ω0
Q

=

R
L

, ω0 =

√
ω1ω2. | (95)

La frecuencia central es la media geométrica de ω1 y ω2, no la aritmética; solo para Q grande son casi iguales.

Sobretensión. A resonancia la corriente es Vs/R y la tensión en C (y en L) tiene módulo |VC| = |VL| = Q |Vs|. Un Q alto produce tensiones mayores que la de la fuente en los reactivos, aunque el circuito sea pasivo: la energía se intercambia entre L y C y la fuente solo repone lo disipado en R.

Paralelo. Para el RLC paralelo de (88), Q = R

p
C/L = ω0RC y BW = ω0/Q = 1/(RC). La impedancia es máxima y real (= R) en ω0. Una bobina real se modela como L en serie con rL; cerca de la resonancia equivale a una resistencia en paralelo Rp ≈ Q²
L

rL, con QL = ω0L/rL. Las
pérdidas de la bobina reducen el Q total.

Amortiguamiento y Q. Q = 1/(2ζ): un Q alto es un amortiguamiento bajo, picos estrechos y oscilaciones largas en el tiempo. Un filtro selectivo (BW pequeño) tarda más en establecerse, porque el decaimiento tiene constante 1/(ζω0) = 2Q/ω0.

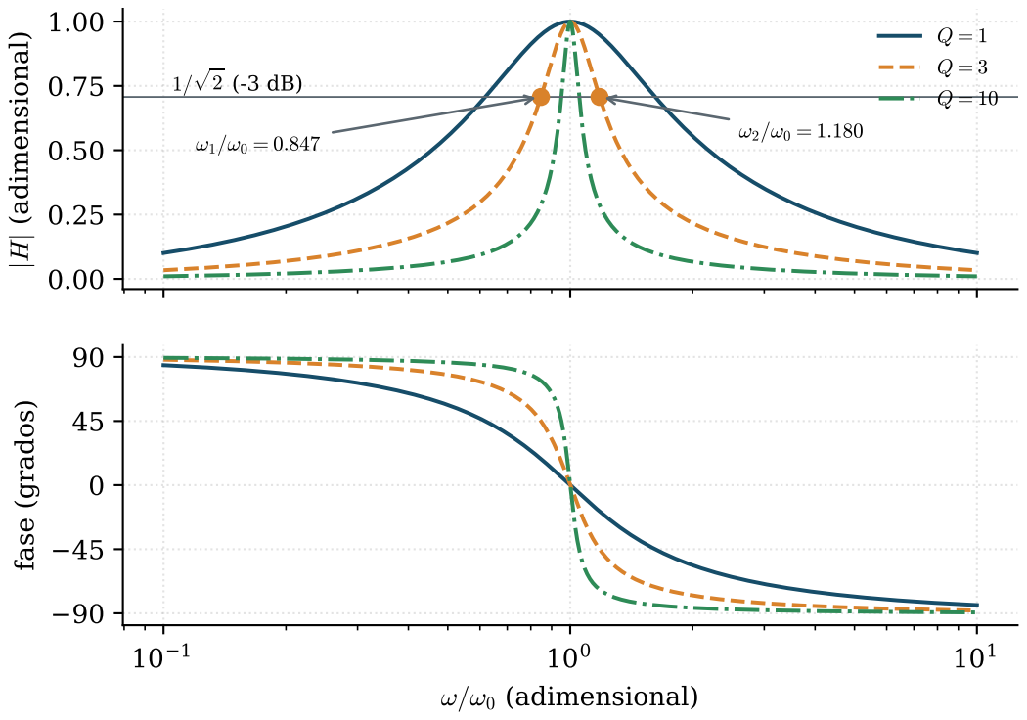
[picture p44: figure]
jHj (a; dim; nsio; !=!0 (adimensional); fase (grados)

Figura 44: Módulo (arriba) y fase (abajo) del pasa banda normalizado para Q = 1, 3, 10 (cálculo de (94), cuaderno clase2_resonancia_q). Los puntos marcan ω1 y ω2 para Q = 3 y verifican ω1ω2 = ω

2/0. Obsérvese que la curva se estrecha al subir Q y que la fase pasa de +90◦ a −90◦ cruzando 0 en ω0.

### 18.2. Ejemplo S05-2-A Pasa banda serie: Q, ancho de banda y sobretensión

Enunciado. En el RLC serie con salida en R, R = 100 Ω, L = 10 mH, C = 100 nF y amplitud de entrada 1 V, hallar f0, Q, BW, f1, f2 y |VC| a resonancia.

Datos y supuestos. Componentes ideales; fuente ideal; régimen sinusoidal permanente. Método. Se aplican (94) y (95).

ω0 = 31 623 rad/s, | f0 = 5033 Hz, | Q =

ω0L
R

=

(31623)(0,01)
100
= 3,162, | (96)

BW = R
L
= 10 000 rad/s = 1591,5 Hz. | (97)

Con 1/(2Q) = 0,1581 y

p
1 + 1/(4Q²) = 1,0124,
ω1 = 31623(1,0124 − 0,1581) = 27 016 rad/s (4300 Hz), | (98)
ω2 = 31623(1,0124 + 0,1581) = 37 016 rad/s (5891 Hz). | (99)

La tensión en C es |VC| = Q|Vs| = 3,16 V pico.

Interpretación. Pasan frecuencias entre 4,3 y 5,9 kHz. El condensador debe soportar más de 3 veces la tensión de entrada. Comprobación independiente. ω2 − ω1 = 10 000 rad/s = R/L;
√
ω1ω2 = 31 623 rad/s = ω0; y |HR(jω1,2)| = 0,7071 por sustitución directa en R/(R+j(ωL−1/ωC)). También 1/(ω0C)/R = 3,162 = Q.

### 18.3. Ejemplo S05-2-B Diseño de un pasa banda paralelo con bobina real

Enunciado. Diseñar un resonador paralelo con f0 = 10 kHz, BW = 500 Hz y C = 10 nF. La bobina tiene QL = 50 a f0. Hallar L, la resistencia paralelo total requerida y la resistencia externa que debe añadirse.

Método. Se despeja L de ω0, se obtiene Rp de Q = ω0RC y se resta la pérdida de la bobina convertida a paralelo (admitancias en paralelo suman).

Paso 1. Q = f0/BW = 20; ω0 = 62 832 rad/s; L = 1/(ω

2

0C) = 1/(3,948 × 10⁹

- 10⁻⁸
) = 25,33 mH.
Paso 2. RT = Q/(ω0C) = 20/(62832 · 10⁻⁸
) = 31,83 kΩ (resistencia paralelo total). Paso 3. La bobina aporta rL = ω0L/QL = 31,83 Ω, es decir RpL = Q²
L

rL = 79,58 kΩ en paralelo. Entonces

1

Rext

=

1
RT

−

1

RpL

= 3,142 × 10⁻⁵ − 1,257 × 10⁻⁵ = 1,885 × 10⁻⁵ ⇒ Rext = 53,05 kΩ. (100)

Interpretación. Sin Rext el Q sería QL = 50 y BW = 200 Hz; la resistencia externa ensancha el pico hasta lo requerido. Si el generador o la carga aportan otra conductancia, también se restan. Comprobación independiente. Con la impedancia completa 1/(1/Rext + 1/(rL + jωL) + jωC) evaluada numéricamente, el ancho a −3 dB resulta de 500 Hz (cuaderno). El valor QL = 50 es supuesto del ejemplo; la bobina real se caracteriza con el medidor LCR.

### 18.4. Ejercicios

S05-2-E1 (pasa banda serie). R = 47 Ω, L = 4,7 mH y C = 10 nF con salida en R y entrada de 0,5 V pico. Hallar f0, Q, BW, f1, f2 y la tensión pico en L a resonancia.

S05-2-E2 (de los puntos de −3 dB al circuito). Un resonador paralelo tiene f1 = 9,6 kHz y f2 = 10,4 kHz (datos del ejercicio, no mediciones del curso) y C = 10 nF. Hallar f0, BW, Q, L y la resistencia paralelo total.

Pregunta conceptual. Dos filtros pasa banda tienen el mismo f0 y Qa = 2, Qb = 20. ¿Cuál tarda más en establecerse al aplicar una señal sinusoidal y cuál rechaza mejor una interferencia a 1,2f0? Justificar.

### 18.5. Errores frecuentes y comprobaciones

Error frecuente

Calcular f0 como la media aritmética de f1 y f2.

Mezclar BW en Hz y en rad/s: R/L está en rad/s.

Suponer que |VC| ≤ |Vs| en un circuito pasivo resonante.

Medir el ancho de banda respecto de 0 dB en lugar de respecto del pico, cuando el pico no vale 1 (por ejemplo, por rL).

Olvidar la pérdida de la bobina real al diseñar un Q alto.

Comprobar: ω

2
0 = ω1ω2, BW · Q = ω0 y la fase nula en ω0.

### 18.6. Conexión con el curso y el proyecto

Los puntos de −3 dB y Q son las magnitudes que se medirán en S05-3 y que se formalizarán en los diagramas de Bode de la semana 6. En el proyecto, un filtro resonante para aislar una señal de sensor exige elegir Q con el compromiso entre selectividad y tiempo de establecimiento. Para el jueves, calcular los valores esperados de f0, Q y BW del montaje de laboratorio.

### 19. S05-3 Simulación y laboratorio: resonancia del RLC serie

Resultados, prerrequisitos y distribución

Al terminar, el estudiante podrá (1) predecir f0, Q, BW y la ganancia en resonancia de un RLC con las pérdidas del montaje; (2) medir f0, f1, f2 y la fase con generador y osciloscopio, y obtener ζ del escalón con el decremento logarítmico; (3) explicar las diferencias entre predicción, simulación y medición. Se comprueba con la tabla de resultados y con S05-3-E1 y S05-3-E2.

Prerrequisitos: S05-1 y S05-2 y el procedimiento de medición de la sesión S01-3. Trabajo previo: calcular los valores esperados y preparar el archivo de simulación. No se incluyen resultados medidos ni capturas; los espacios de las tablas los llena el estudiante.

Distribución propuesta de 120 minutos

Diagnóstico y seguridad, 10 min. Simulación (barrido y escalón), 30 min. Montaje y medición, 50 min. Comparación predicción–simulación–medición y cierre, 30 min. El cronograma fija el Parcial 1 en la semana 5 sin indicar día ni duración. Si se aplica en esta sesión, el docente reparte el tiempo (propuesta de 60 a 90 min de parcial): la simulación puede pasar a trabajo previo y la Parte B de medición a una sesión posterior.

Laboratorio S05-3: resonancia del RLC serie

Objetivo. Verificar la relación entre L, C, R y los parámetros f0, Q y BW, y estimar ζ del escalón.
Material. Generador de funciones, osciloscopio de dos canales con sondas ×1/×10, multímetro o medidor LCR, protoboard, L = 10 mH (nominal), C = 100 nF (nominal) y resistencias de 100 Ω y de 390 Ω.
Seguridad. Solo baja tensión aislada: señal de 1 V pico a pico, sin offset en la Parte A y de 0 a 1 V en la Parte B. Las masas del generador y del osciloscopio son la referencia del circuito; antes de conectar, comprobar con el multímetro la continuidad entre ellas y no conectar la masa de una sonda a un nodo distinto de la referencia. Recordar que el condensador y la bobina pueden presentar a resonancia tensiones mayores que la entrada (aquí hasta unas 2–3 veces); no es un riesgo con 1 V, pero sí lo sería con amplitudes mayores.

### 19.1. Guía de simulación (resultados rotulados como simulación)

Simular en el programa elegido por el docente los montajes de las Figuras 45 y 46. Parte A: barrido de CA de 1 kHz a 20 kHz con R = 100 Ω, anotando |vR/vCH1| y fase; repetir con rL = 0 Ω y rL = 20 Ω en serie con la bobina. Parte B: escalón de 0 a 1 V con R = 100 Ω y salida en C, anotando el sobreimpulso y el periodo de la oscilación. Los resultados de simulación se rotulan como tales y se comparan con la predicción.

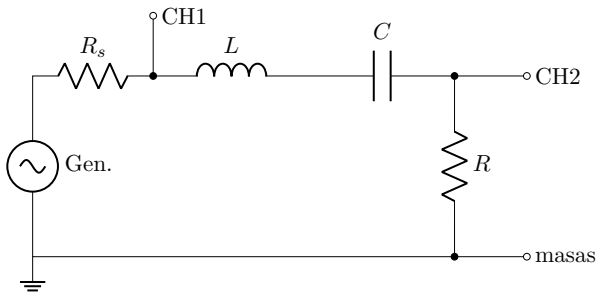
[picture p45: figure]
Gen.; masas

Figura 45: Parte A, pasa banda. CH1 mide la entrada del circuito (después de Rs) y CH2 la tensión en R; ambas sondas con su masa en la referencia común. Rs es la resistencia de salida del generador (valor del manual) y L incluye su resistencia de devanado rL.

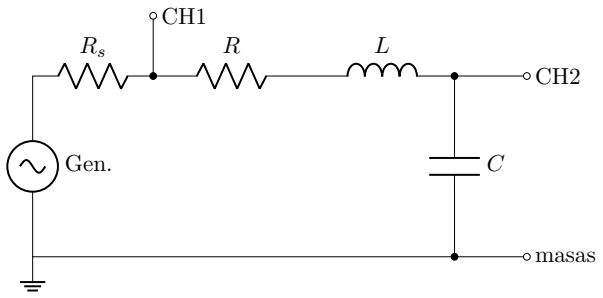
[picture p46: figure]
Gen.; masas

Figura 46: Parte B, respuesta al escalón. Con C conectado a la referencia, CH2 mide vC respecto de la referencia común. La onda cuadrada de 0 a 1 V a 500 Hz deja 1 ms entre flancos, más que el tiempo de establecimiento estimado 4/(ζω0) ≈ 0,67 ms.

### 19.2. Ejemplo S05-3-A Predicción de la respuesta en frecuencia

Enunciado. Predecir f0, Q, BW, f1, f2 y la ganancia a resonancia del montaje de la Figura 45 con R = 100 Ω, L = 10 mH, C = 100 nF y rL = 20 Ω (valor supuesto; se mide en el laboratorio).

Método. Como CH1 se mide después de Rs, esta no interviene en la ganancia vR/vCH1. La resistencia del lazo es RT = R + rL = 120 Ω y la salida está en R.

f0 =

1
2π

√
LC

= 5033 Hz, Q =

ω0L
RT

=

316,2
120
= 2,635, | (101)

BW = RT
L
= 12 000 rad/s = 1910 Hz, | (102)

G0 =

R
RT

= 0,833, f1,2 =

ω0
2π

q
1 + 1
4Q² ∓

1
2Q
= 4168 Hz, 6078 Hz. | (103)

Interpretación. El pico no vale 1, sino G0 = 0,833; los puntos de −3 dB están donde |H| = G0/

√
2 = 0,589. Comprobación independiente. La búsqueda numérica de los cruces de G0/

√
2
sobre |H(jω)| da las mismas frecuencias (cuaderno clase3_lab_resonancia); con rL = 0 se recupera G0 = 1 y Q = 3,16.

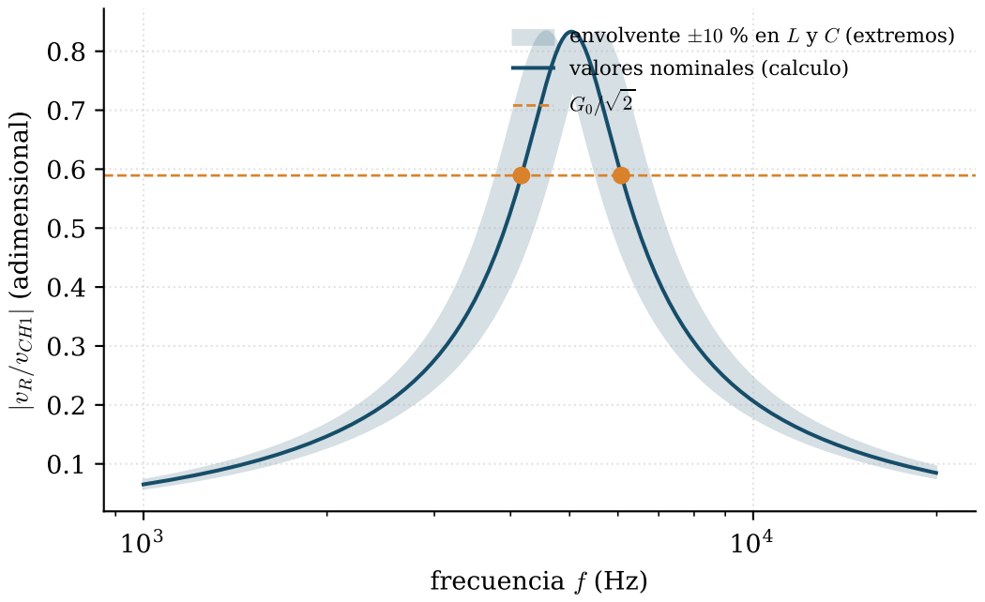
[picture p47: figure]
frecuencia f (Hz); jvR=vCH1j (a; dim; nsio; envolvente §10 % en L y C (extremos) valores nominales (calculo)

Figura 47: Predicción calculada (no medida) de |vR/vCH1| con rL = 20 Ω supuesta. La banda sombreada es la envolvente de ±10 % en L y en C (cuatro combinaciones extremas); los puntos son f1 y f2 nominales. Una medición compatible debe caer dentro de la banda, desplazada por la tolerancia real de los componentes.

### 19.3. Ejemplo S05-3-B Tolerancias y escalón: de ζ al decremento logarítmico

Enunciado. Con los valores del ejemplo A y tolerancias de ±10 % en L y en C, acotar f0; para la Parte B (RT = R + rL = 120 Ω, salida en C) predecir ζ, Mp, el periodo Td y la razón entre picos sucesivos.

Paso 1. Cotas de f0. Como f0 ∝ (LC)

−1/2
, los extremos son f0,m´ax = 1/(2π

√
0,9 · 0,9LC) =
5592 Hz y f0,m´ın = 1/(2π

√
1,1 · 1,1LC) = 4575 Hz. Una f0 medida entre 4,58 y 5,59 kHz es compatible con el modelo.

Paso 2. Escalón.

ζ =

RT
2

s
C
L

= 60(3,162 × 10⁻³

) = 0,190, Mp = exp
−

π(0,190)
√

1 − 0,036
= 0,545, (104)

ωd = ω0

q
1 − ζ

2 = 31 048 rad/s, Td =

2π
ωd
= 202,4 µs. | (105)

Paso 3. Decremento logarítmico. Si x1 y x2 son los excesos sobre el valor final en dos picos consecutivos, δ = ln(x1/x2) = 2πζ/p
1 − ζ

2 = 1,214, es decir x1/x2 = 3,37, y se recupera

ζ =

δ
√
4π

2 + δ

2

. | (106)

Interpretación. El decremento logarítmico permite estimar ζ sin conocer RT con exactitud, y de ahí RT efectiva. Comprobación independiente. Sustituir δ = 1,214 en (106) devuelve ζ = 0,1897.

### 19.4. Guía de medición

Parte A.

1. Medir con el medidor LCR o el multímetro R, L, C y la resistencia en continua de la bobina (dato para rL). Anotar los valores.
2. Armar la Figura 45. Ajustar el generador a senoidal de 1 V pico a pico, sin offset.
3. Para cada frecuencia de la tabla, medir las amplitudes pico a pico de CH1 y CH2 y el retardo ∆t entre cruces por cero (fase φ = −360◦f ∆t si CH2 retrasa a CH1).
4. Localizar f0 como la frecuencia de fase nula y de mayor |vR/vCH1|; luego f1 y f2 donde el cociente cae a G0/

√
2. Reajustar la amplitud de CH1 en cada punto, pues la impedancia del circuito cambia con la frecuencia y la carga sobre Rs también.

Parte B. Armar la Figura 46, cuadrada 0–1 V a 500 Hz, medir Mp, Td y dos picos consecutivos para obtener δ y ζ con (106).

Tabla A (barrido; las columnas «predicho» son cálculos del cuaderno con rL = 20 Ω supuesta; las demás las llena el estudiante).

f (Hz) | |H| predicho | fase predicha (◦
) | CH1 (V pp) | CH2 (V pp) | |H| medido | fase medida (◦
)
1000 | 0,065 | +85,5
2000 | 0,147 | +79,8
3000 | 0,276 | +70,7
3500 | 0,379 | +62,9
4000 | 0,528 | +50,7
4400 | 0,679 | +35,4
4800 | 0,808 | +14,0
5033 | 0,833 | 0
5300 | 0,804 | −15,3
5700 | 0,696 | −33,3
6200 | 0,559 | −47,9
7000 | 0,410 | −60,5
9000 | 0,246 | −72,8
15000 | 0,118 | −81,8

Tabla B (comparación; vacía).

Magnitud | Predicción Simulación Medición Diferencia
f0 (Hz) | 5033
G0 | 0,833
Q | 2,635
BW (Hz) | 1910
Mp (Parte B) | 0,545
Td (µs) | 202,4
ζ | 0,190

Análisis pedido: (1) ¿La diferencia en f0 cae dentro de la banda de tolerancia del ejemplo B? (2) ¿Qué parte de la diferencia en Q se explica por rL y cuál por otras pérdidas? (3) ¿Cómo cambiaría el resultado con la sonda ×1 frente a la ×10?

### 19.5. Ejercicios

S05-3-E1. Una medición con el multímetro da rL = 35 Ω (dato del ejercicio, no medición del curso). Recalcular Q, BW y G0 del ejemplo A y decir si la banda de tolerancia de f0 del ejemplo B sigue siendo válida.

S05-3-E2. Si CH1 se conectara directamente a la salida del generador sin carga y no después de Rs (con Rs = 50 Ω, rL = 20 Ω), ¿qué Q y qué ganancia vR/vgen se obtendrían? Explicar por qué el montaje de la figura mide después de Rs.
Pregunta conceptual. Un estudiante mide el ancho de banda entre los puntos donde |H| = 0,707 en lugar de G0/

√
2. ¿Por qué obtiene un valor demasiado pequeño?

### 19.6. Errores frecuentes y comprobaciones

Error frecuente

Suponer G0 = 1 sin considerar rL y la resistencia de salida del generador.

Medir f0 como el máximo de CH2 con CH1 sin reajustar entre frecuencias.

Barrido con pocos puntos cerca de f0: se pierde el pico.

Medir en la Parte B con una cuadrada demasiado rápida, sin que se establezca el valor final.

Conectar la masa de una sonda a un nodo que no es la referencia.

Presentar una simulación o la predicción como medición.

### 19.7. Conexión con el curso y el proyecto

La tabla B es el formato de evidencia del proyecto: predicción, simulación y medición con su diferencia explicada. Los datos del barrido de la tabla A se reutilizarán como ejemplo de construcción del diagrama de Bode en la semana 6.

### 20. S05-P Parcial 1 (semanas 1 a 5)

Instrucciones y supuestos generales

Este parcial evalúa los contenidos de las semanas 1 a 5: repaso de circuitos y constante de tiempo, función de transferencia y polos, filtros de primer orden pasa bajas y pasa altas, y circuitos RLC de segundo orden. Cada problema es autosuficiente. Se permite calculadora científica; el formulario lo define el docente.

Supuestos que valen para todos los problemas, salvo que el enunciado indique otra cosa: componentes y fuentes ideales; condiciones iniciales nulas; régimen sinusoidal permanente cuando se habla de amplitud y fase; amplitudes dadas como valor pico; redondear a tres cifras significativas e incluir unidades. Justificar cada resultado con el planteamiento: una cifra sin planteamiento no recibe puntaje completo. El puntaje total interno es de 100 puntos; su conversión a la nota del curso la define el docente.

Problema 1 (15 puntos, semana 1). En la Figura 48, Vs = 9 V es una fuente de tensión continua que se conecta en t = 0, R1 = 3,3 kΩ, R2 = 6,8 kΩ y C = 220 nF, inicialmente descargado.

(a) (4 p.) Hallar el equivalente de Thévenin (Vth, Rth) visto por el condensador.
(b) (6 p.) Hallar la constante de tiempo, la expresión de vC(t) y vC(1 ms).
(c) (3 p.) Hallar el tiempo en que vC alcanza el 90 % de su valor final.
(d) (2 p.) Explicar por qué la constante de tiempo no es R1C.

R1
vC
R2 | C

Figura 48: Problema 1: red con divisor y condensador. La salida es vC respecto de tierra.

Problema 2 (20 puntos, semanas 2 y 3). El filtro de la Figura 49 tiene R = 1,5 kΩ, C = 47 nF y una carga RL = 4,7 kΩ.

(a) (7 p.) Obtener H(s) = Vo/Vs con condiciones iniciales nulas, indicar su polo, su ganancia en continua y el tipo de filtro.
(b) (4 p.) Hallar la frecuencia de corte fc (a 1/

√
2 del valor en continua).
(c) (6 p.) Con vs sinusoidal de 1 V pico y 5 kHz, hallar la amplitud y la fase de vo.
(d) (3 p.) Hallar fc sin la carga y comentar el efecto de conectarla.

vs

R
vo
C | RL

Figura 49: Problema 2: filtro RC con carga RL.

Problema 3 (15 puntos, semana 4). Un sensor entrega vs(t) = 2,5 V + 0,1 V sin(2π · 1000 t). Se conecta al filtro de la Figura 50 con C = 100 nF y R = 2,2 kΩ, sin carga.

(a) (5 p.) Obtener H(s) y la frecuencia de corte, e identificar el tipo de filtro.
(b) (7 p.) Hallar vo(t) en régimen permanente: componente continua y amplitud y fase de la componente de 1 kHz.
(c) (3 p.) Si la componente alterna fuese de 0,5 V pico a 200 Hz, hallar su amplitud a la salida.

vs

C

vo

R

Figura 50: Problema 3: filtro pasa altas CR, salida en R.

Problema 4 (30 puntos, semana 5). El circuito de la Figura 51 tiene R = 150 Ω, L = 22 mH y C = 47 nF.

(a) (4 p.) Hallar ω0 y f0.
(b) (8 p.) Con salida vR (pasa banda), hallar Q, el ancho de banda (en Hz) y las frecuencias f1 y f2 de −3 dB.
(c) (4 p.) Con entrada sinusoidal de 1 V pico a f0, hallar la amplitud de vC y comentarla.
(d) (8 p.) Con un escalón de 1 V y salida vC, hallar ζ, el régimen, el sobreimpulso y el tiempo de pico.
(e) (6 p.) Si R se duplica, decir cómo cambian f0, Q y el ancho de banda, con valores.

vs

L

C
+ | −

vC

R

−

+

vR

Figura 51: Problema 4: RLC serie. vR da la salida pasa banda y vC la respuesta al escalón.

Problema 5 (20 puntos, semana 5).

(a) (10 p.) Un RLC paralelo alimentado por una fuente de corriente tiene R = 2 kΩ, L = 10 mH y C = 100 nF. Hallar ω0, Q, el ancho de banda en Hz y la impedancia vista a ω0.
(b) (10 p.) Para el circuito del Problema 4 con salida vC, estimar |VC/Vs| a ω = 10 ω0 y compararlo con el de un filtro RC de primer orden cuya frecuencia de corte fuese ω0. Explicar a partir de los denominadores por qué difieren.

### 21. Código y recursos de la semana

Los cuadernos de Python están en codigo/python/semana_05/ y se entregan ejecutados, con las comprobaciones assert. Los scripts de MATLAB están en codigo/matlab/semana_05/; contienen los mismos datos y resultados, y no se ejecutaron en este entorno. Los resultados de ambos son cálculo analítico y simulación numérica; no son mediciones.

Código de la semana 5

clase1_segundo_orden.ipynb / .m
Reproduce S05-1-A, S05-1-B, S05-1-E1 y S05-1-E2: H(s) simbólica del RLC serie y paralelo, ω0, ζ, polos, sobreimpulso y tiempo de pico, contrastados con la simulación del escalón. Genera escalon_zeta. El script de MATLAB requiere Control System Toolbox.

clase2_resonancia_q.ipynb / .m
Reproduce S05-2-A, S05-2-B, S05-2-E1 y S05-2-E2: Q, ancho de banda, ω1, ω2, diseño del resonador paralelo con bobina real y verificación numérica del ancho a −3 dB. Genera resonancia_q.

clase3_lab_resonancia.ipynb / .m
Reproduce S05-3-A, S05-3-B, S05-3-E1 y S05-3-E2: predicción del laboratorio, tolerancias, valores de la columna «predicho» de la tabla A y decremento logarítmico. Genera prediccion_lab.

parcial1_verificacion.ipynb / .m
Verifica las respuestas esperadas de los cinco problemas del Parcial 1 (edición docente), incluida la integración numérica del Problema 1 y la comprobación simbólica del Problema 2.

### 22. Referencias de la semana

Documentación primaria de las herramientas usadas en el código. Fecha de consulta: 2026-11-03.

[1] SciPy community. scipy.signal.TransferFunction y scipy.signal.step. SciPy Manual v1.18.0. https://docs.scipy.org/doc/scipy/reference/generated/scipy.signal.TransferFu nction.html y https://docs.scipy.org/doc/scipy/reference/generated/scipy.sig nal.step.html. (https://docs.scipy.org/doc/scipy/reference/generated/scipy.signal.step.html)
[2] SciPy community. scipy.integrate.solve_ivp. SciPy Manual, versión estable en la fecha de consulta. https://docs.scipy.org/doc/scipy/reference/generated/scipy.integrate.solve_ivp.html (https://docs.scipy.org/doc/scipy/reference/generated/scipy.integrate.solve_ivp.html) (respuesta HTTP 200 en la fecha de consulta).
[3] MathWorks. tf y step (Control System Toolbox). Documentación en línea, versión vigente en la fecha de consulta. https://www.mathworks.com/help/control/ref/tf.html. El sitio rechaza el acceso automatizado, por lo que el enlace debe abrirse a mano.
[4] Matplotlib development team. Matplotlib documentation, versión estable en la fecha de consulta. https://matplotlib.org/stable/.

### Parte VI

# Semana 6: Diagramas de Bode

### 23. S06-1 Escalas logarítmicas, frecuencia, décadas y octavas

Resultados, prerrequisitos y distribución

Al terminar, el estudiante podrá (1) calcular cuántas décadas y octavas separan dos frecuencias; (2) ubicar una frecuencia en un eje logarítmico y construir un barrido logarítmico de frecuencias; (3) explicar por qué la respuesta en frecuencia se dibuja con eje horizontal logarítmico. Se comprueba con S06-1-E1 y S06-1-E2.
Se requieren logaritmos decimales y de base 2, la función de transferencia de primer orden H(s) de las semanas 1 a 5 y la diferencia entre f (Hz) y ω (rad/s). Esta sesión no introduce decibelios; llegan el miércoles.

Distribución propuesta de 120 minutos

Diagnóstico, 10 min (calcular log10 1000 y 2

10 sin calculadora). Explicación, 25 min. Ejemplos guiados, 30 min. Práctica de los ejercicios, 40 min. Cierre y contraste de resultados, 15 min. Antes de la clase, el estudiante revisa propiedades de los logaritmos y abre el cuaderno clase1_escalas_logaritmicas.ipynb; ese trabajo previo no cuenta como tiempo presencial.

### 23.1. Concepto físico y modelo

La respuesta en frecuencia de un sistema lineal e invariante es la función H(jω) = Vo(jω)/Vi(jω) evaluada para entradas senoidales en régimen permanente y condiciones iniciales nulas. Aquí ω = 2πf, con f en hercios y ω en radianes por segundo. Los sistemas de audio, filtros y sensores operan en rangos de frecuencia que abarcan varios órdenes de magnitud; un eje lineal dedica casi todo el espacio a las frecuencias altas y comprime donde ocurre el cambio (Figura 53).

Un eje logarítmico coloca cada frecuencia en la posición x = k log10 f, donde k es la longitud física asignada a una década. Entonces razones iguales de frecuencia ocupan longitudes iguales. Dos unidades describen esas razones:

Ndec = log10

f2
f1
, | Noct = log2

f2
f1

=

log10(f2/f1)
log10 2
≈ 3,32 Ndec. | (107)

Una década es un factor 10; una octava, un factor 2. Con k cm por década, la posición relativa de f2 respecto de f1 es k log10(f2/f1). La distancia entre 1 y 2 no es igual a la distancia entre 2 y 3: la primera ocupa 0,301k y la segunda 0,176k.

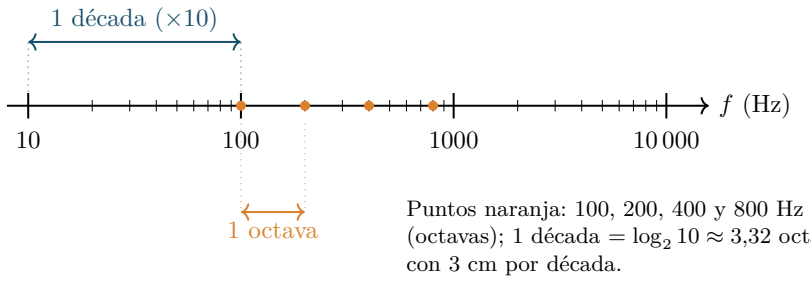
[picture p48: figure]
1 década (×10); 1 octava; Puntos naranja: 100, 200, 400 y 800 Hz; con 3 cm por década.

(octavas); 1 década = log2 10 ≈ 3,32 octavas

Figura 52: Eje logarítmico con 3 cm por década. Las marcas intermedias (2 a 9) se acercan hacia la derecha de cada década. Una octava a partir de 100 Hz termina en 200 Hz, y ocupa 0,301 de la longitud de la década.

Hipótesis y límites. El cero hertz no tiene posición en este eje porque log10 0 no está definido: la respuesta en continua se representa como el valor al que tiende la curva a la izquierda del rango dibujado. Un barrido logarítmico de n puntos por década usa fk = f0 10k/n, con razón constante

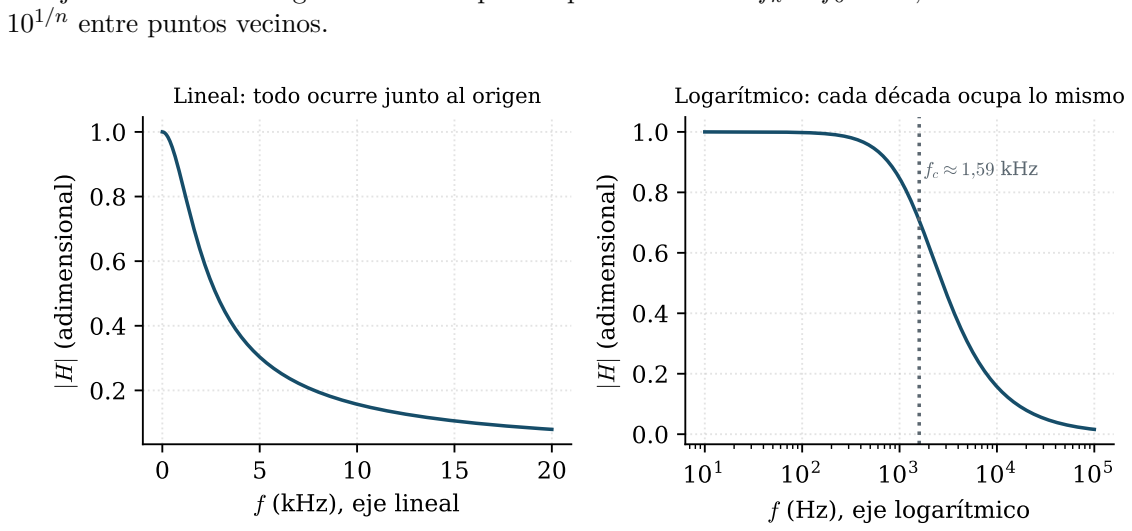
[picture p49: figure]
10¹/n entre puntos vecinos.; f (kHz), eje lineal; jHj (a; dim; nsio; Lineal: todo ocurre junto al origen; f (Hz), eje logarítmico; kHz; Logarítmico: cada década ocupa lo mismo

Figura 53: Magnitud |H| (adimensional) de un RC pasa bajas, R = 10 kΩ y C = 10 nF, con fc = 1,59 kHz. Izquierda: eje lineal, el decaimiento queda comprimido en el borde izquierdo y toda la información de baja frecuencia (por debajo de 1 kHz) ocupa una fracción pequeña del eje. Derecha: eje logarítmico, la transición se aprecia con claridad. Generada en clase1_escalas_logaritmicas.ipynb.

Observe que, en la figura de la derecha, la curva cambia de forma cerca de fc y que cada década ocupa la misma anchura.

### 23.2. Ejemplo S06-1-A Décadas y octavas de la banda de audio

Enunciado. Una banda de audio va de f1 = 20 Hz a f2 = 20 kHz. Calcular el número de décadas y de octavas, y comprobar el resultado de octavas con el doblado repetido de f1.

Datos y supuestos. f1 = 20 Hz, f2 = 20 000 Hz; interesa solo la razón. Incógnitas: Ndec, Noct.

Método. Aplicar (107): la razón de frecuencias es lo único que importa, no sus valores.

f2
f1

=

20000
20
= 1000, | Ndec = log10 1000 = 3, | (108)

Noct =

log10 1000
log10 2

=

3
0,30103
= 9,966. | (109)

Interpretación. Son 3 décadas y casi 10 octavas; el oído cubre cerca de diez octavas.

Comprobación independiente. Doblar nueve veces: 20 · 2

9 = 10 240 Hz; doblar una décima vez da 20 480 Hz, que supera 20 kHz. Luego Noct está entre 9 y 10, de acuerdo con 9,966. Además Noct/Ndec = 3,322 = log2 10.

### 23.3. Ejemplo S06-1-B Posición en el eje y barrido logarítmico

Enunciado. En un eje con k = 4 cm por década, ¿a qué distancia de la marca de 1 kHz está la de 3 kHz? Después se pide un barrido de 10 Hz a 100 kHz con 10 puntos por década: número de puntos, razón entre vecinos y frecuencia del cuarto punto.
Método. Posición x = k log10(f /fref); barrido con fj = f0 10j/n

Paso 1. Posición.
x = 4 log10

3000
1000
= 4(0,4771) = 1,908 cm. | (110)

Paso 2. Barrido. De 10 Hz a 100 kHz hay log10(10⁵/10) = 4 décadas. Con n = 10 hay 4·10+1 = 41 puntos (se cuentan los dos extremos). La razón es 10¹/10 = 1,2589. El cuarto punto (j = 3) es

f3 = 10 · 10³/10 = 10 · 1,995 = 19,95 Hz. | (111)

Interpretación. Cada 10 puntos la frecuencia se multiplica por 10; el cuarto punto cae cerca de 20 Hz porque 10⁰,3 ≈ 2.

Comprobación independiente. Con numpy.logspace(1, 5, 41) el cuaderno obtiene 41 puntos y razón 10⁰,1
. Además, f10 = 10 · 10 = 100 Hz coincide con el inicio de la segunda década.

### 23.4. Ejercicios

S06-1-E1 (décadas y octavas). Calcular cuántas octavas y cuántas décadas hay entre 50 Hz y 12,8 kHz. Comprobar con una cadena de doblados.
S06-1-E2 (barrido). Se desea medir de 20 Hz a 20 kHz con 25 puntos por década. Hallar el número de puntos, la razón entre puntos vecinos y las frecuencias del segundo y del tercer punto.

Pregunta conceptual. ¿Por qué no puede dibujarse f = 0 Hz en un eje logarítmico, y qué se hace para mostrar el comportamiento en continua? Justificar.

### 23.5. Errores frecuentes y comprobaciones

Interpolar linealmente entre marcas: el punto medio visual entre 100 y 1000 es 316 Hz (raíz del producto), no 550.

Confundir octava con década: una década son 3,32 octavas.

Contar décadas por el número de marcas en vez de por la razón de frecuencias, o contar solo los puntos intermedios del barrido sin sumar uno.

Mezclar f en Hz con ω en rad/s: f = 1 kHz equivale a ω = 6283 rad/s.

Poner f = 0 en la lista del barrido logarítmico.

### 23.6. Conexión con el curso

Los ejes logarítmicos son la base de los diagramas de Bode del miércoles y del jueves, de las próximas semanas con filtros y amplificadores, y de las mediciones de respuesta en frecuencia del proyecto, donde cada barrido debe justificar su rango y su densidad de puntos. Para el miércoles, repasar la relación |H| = 1/

p
1 + (f /fc)

2.

### 24. S06-2 Magnitud, decibelios, pendientes y fase

Resultados, prerrequisitos y distribución

Al terminar, el estudiante podrá (1) convertir entre relación de tensiones y decibelios con GdB = 20 log10 |Vo/Vi

|; (2) leer pendientes en dB por década y por octava; (3) calcular magnitud y fase exactas de un RC en frecuencias dadas e identificar los valores clave (−3,01 dB y −45◦
en fc). Se
comprueba con S06-2-E1 y S06-2-E2.
Prerrequisitos: S06-1 (décadas y octavas) y H(s) = 1/(1 + s/ωc) del RC de las semanas anteriores.

Distribución propuesta de 120 minutos

Diagnóstico, 10 min (década y octava; log10 2). Explicación, 25 min. Ejemplos guiados, 30 min. Práctica de los ejercicios, 40 min. Cierre, 15 min. Trabajo previo: ejecutar el cuaderno clase2_magnitud_db_fase.ipynb hasta el ejemplo A; no cuenta como tiempo presencial.

### 24.1. Concepto físico y modelo

Topología y definiciones. Se estudia el RC pasa bajas de la Figura 54: entrada vi aplicada a R, salida vo tomada en C respecto de tierra y sin carga conectada. Con condiciones iniciales nulas y régimen permanente senoidal,

H(jω) = Vo
Vi

=

1
1 + j ωRC =

1
1 + j f /fc

, fc =

1
2πRC . | (112)

Aquí ω está en rad/s, f y fc en Hz, y jω sustituye a s solo porque la entrada es senoidal en régimen permanente. Un filtro cargado requiere el modelo con carga; esta sesión no lo usa.

vi

R = 10 kΩ
vo
C = 10 nF | medida

Ref.: tierra
Sin carga en vo

Figura 54: RC pasa bajas sin carga con R = 10 kΩ y C = 10 nF. La tensión vo se mide entre el nodo R–C y tierra; fc = 1,59 kHz.

Magnitud y decibelios. La magnitud |H| es adimensional y absoluta. Se expresa en decibelios con
GdB = 20 log10

Vo
Vi
, | |H| = 10GdB/20
. | (113)

El factor 20 corresponde a tensiones (o corrientes) porque la potencia es proporcional al cuadrado de la amplitud con la misma resistencia; para una relación de potencias se usa 10 log10(P2/P1). La relación Vo/Vi es la misma si ambas amplitudes se expresan como pico o ambas como RMS; no se mezclan. Valores de uso frecuente:

|H| | 0,01 | 0,1 | 1/

√
2 | 0,5 | 1 | 10
GdB | −40 −20 −3,01 −6,02 0 +20

Los decibelios suman en una cascada sin interacción de cargas, porque el logaritmo convierte productos en sumas.

Pendiente. De (112), |H| = 1/

p
1 + (f /fc)
2. Para f ≪ fc tiende a 1 (0 dB); para f ≫ fc tiende a fc/f, es decir GdB ≈ −20 log10(f /fc): baja 20 dB por década o 20 log10 2 = 6,02 dB por octava. Las dos expresiones describen la misma pendiente.

Fase. φ = arg H(jω) = − arctan(f /fc), en grados o radianes (180◦ = π rad). En fc es −45◦ =

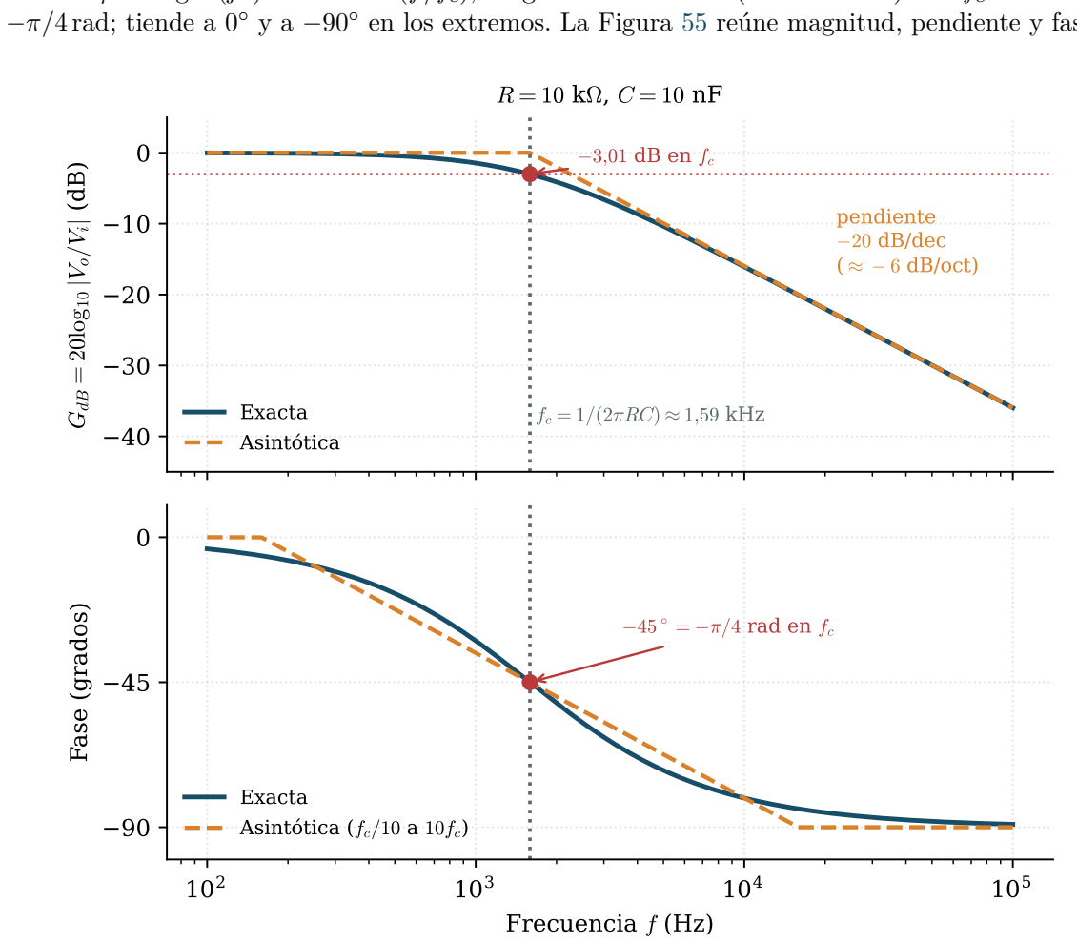
[picture p50: figure]
−π/4 rad; tiende a 0; GdB; = 20log10 jVo=Vi; pendiente ¡20 dB/dec ( ¼ ¡ 6 dB/oct); fc = 1=(2¼RC) ¼ 1;59 kHz; Exacta; Asintótica; Frecuencia f (Hz); Fase (grados); rad en fc; Asintótica (fc=10 a 10fc)

en los extremos. La Figura 55 reúne magnitud, pendiente y fase.

Figura 55: Diagrama de Bode del RC de la Figura 54. Arriba: magnitud en dB (azul continua, exacta; naranja de trazos, asintótica), con la marca de fc, la línea de −3,01 dB y la pendiente −20 dB/dec. Abajo: fase en grados con −45◦
en fc. Debe observarse que la curva exacta se separa de la asíntota solo cerca de fc. Generada en clase2_magnitud_db_fase.ipynb.

### 24.2. Ejemplo S06-2-A Conversiones entre relación y decibelios

Enunciado. Convertir a dB las relaciones Vo/Vi = 0,5, 1/

√
2, 10 y 0,01. Después, hallar la relación para −3 dB y para +46 dB.

Método. Aplicar (113) en ambos sentidos.

20 log10 0,5 = −6,02 dB, | 20 log10(1/

√
2) = −3,01 dB, | (114)
20 log10 10 = +20 dB, | 20 log10 0,01 = −40 dB, | (115)
10⁻³/20 = 0,708, | 10⁴⁶/20 = 199,5. | (116)

Interpretación. −3 dB no es la mitad de la tensión: es 0,708; la mitad son −6 dB. Es la potencia la que cae a la mitad (10 log10 0,5 = −3,01 dB).

Comprobación independiente. Al invertir las conversiones se recuperan los valores iniciales: 10⁻⁴⁰/20 = 0,01 y 10⁻⁶,02/20 = 0,5.

### 24.3. Ejemplo S06-2-B Magnitud, dB y fase del RC

Enunciado. Para el RC de la Figura 54 calcular fc y |H|, GdB y φ en f /fc = 0,1, 1, 2 y 10, y la pendiente entre 10fc y 100fc.
Datos y supuestos. R = 10 kΩ, C = 10 nF, sin carga, componentes ideales. Incógnitas: fc, |H|, GdB, φ.
Paso 1. fc = 1/(2π · 10⁴
- 10⁻⁸
) = 1591,5 Hz.

Paso 2. Con k = f /fc: |H| = 1/

√
1 + k

2, φ = − arctan k.

f /fc | f (Hz) | |H| GdB (dB) | φ (

◦
)
0,1 | 159,2 0,9950 | −0,04 | −5,71
1 | 1591,5 0,7071 | −3,01 −45,00
2 | 3183,1 0,4472 | −6,99 −63,43
10 | 15 915 0,0995 | −20,04 −84,29

Paso 3. Pendiente. Entre 10fc y 100fc (GdB = −40,00 dB): −40,00 − (−20,04) = −19,96 dB por década, es decir, ≈ −20 dB/dec.
Interpretación. En fc la amplitud cae a 0,707 y la fase vale −45◦ = −π/4 rad; después de 10fc el comportamiento es casi el de la asíntota.
Comprobación independiente. scipy.signal.bode reproduce −3,010 dB y −45,00◦
en fc
(cuaderno). Límites: continua → 0 dB, 0◦

; alta frecuencia → pendiente −20 dB/dec y −90◦ .

### 24.4. Ejercicios

S06-2-E1 (cascada). Tres etapas sin interacción de carga tienen +12 dB, −3 dB y +20 dB a una misma frecuencia. Hallar la ganancia total en dB, la relación Vo/Vi y la amplitud de salida (pico) para una entrada de 5 mV pico.
S06-2-E2 (otro RC). Un RC con R = 4,7 kΩ y C = 33 nF, sin carga. Calcular fc y, en 500 Hz y 5 kHz, |H|, GdB y φ en grados y radianes. Comparar GdB con la asíntota.

Pregunta conceptual. Un compañero afirma que “−20 dB/dec” y “−6 dB/oct” son pendientes distintas. ¿Tiene razón? Justificar.

### 24.5. Errores frecuentes y comprobaciones

Usar 10 log10 con relaciones de tensión (o 20 log10 con potencias).

Creer que −3 dB es la mitad de la tensión; es 0,707.

Calcular la relación con una amplitud pico y otra RMS.

Dar la fase de arctan en radianes cuando la calculadora está en grados, o viceversa.

Decir “−3 dB” sin indicar respecto de qué referencia (el nivel de continua o el máximo).

Sumar decibelios de etapas que se cargan entre sí sin recalcular las ganancias con carga.

### 24.6. Conexión con el curso

Los valores clave de este RC reaparecen en los filtros de las semanas siguientes. En el proyecto, las especificaciones de ganancia se expresan en dB y su verificación exige distinguir amplitud pico de RMS. Para el jueves, traer la lista de frecuencias de esquina que se calculó aquí.

### 25. S06-3 Construcción manual de asíntotas y simulación: asintótico frente a exacto

Resultados, prerrequisitos y distribución

Al terminar, el estudiante podrá (1) trazar a mano las asíntotas de magnitud y fase de una H con polos y ceros reales; (2) estimar el error de las asíntotas respecto de la curva exacta; (3) obtener el diagrama con Python (o MATLAB) y compararlo con el trazado manual. Se comprueba con S06-3-E1 y S06-3-E2.
Prerrequisitos: S06-1 y S06-2. Trabajo previo: ejecutar el cuaderno de la clase 3 (clase3_asintotas_ vs_exacta.ipynb) y tener a mano papel semilogarítmico o una cuadrícula en hoja de cálculo. Los resultados numéricos de esta sesión son cálculo y simulación; no hay mediciones.

Distribución propuesta de 120 minutos

Diagnóstico, 10 min (leer pendiente y esquinas en el Bode de la Figura 55). Explicación de las reglas, 20 min. Ejemplos guiados, 35 min. Práctica de los ejercicios, 40 min. Cierre y comparación con la simulación, 15 min. El software es el elegido por el docente; aquí se usa Python, con equivalente MATLAB en codigo/matlab/semana_06.

### 25.1. Concepto físico y modelo

Se parte de una función de transferencia con polos y ceros reales y negativos, escrita en forma normalizada (cada factor vale 1 en continua):

H(s) = K

Q
i

(1 + s/ωz,i)
Q
k

(1 + s/ωp,k)

, | fz,i =

ωz,i
2π

, fp,k =

ωp,k
2π
. | (117)

Se supone la topología ya fijada, condiciones iniciales nulas y régimen permanente senoidal (s = jω). Como el logaritmo convierte productos en sumas, GdB y φ son sumas de contribuciones de cada factor. Procedimiento:

1. Escribir H en forma normalizada y calcular fz,i y fp,k en hercios.
2. Nivel inicial: 20 log10 |K| con pendiente 0 dB/dec (válido si no hay polos ni ceros en el origen).
3. En cada fp la pendiente baja 20 dB/dec; en cada fz sube 20 dB/dec.
4. Fase: cada polo aporta −90◦

en total, con una rampa de −45◦ por década entre fp/10 y 10fp; cada cero aporta +90◦ del mismo modo.

Error de un factor 1 + jf /f0 respecto de su asíntota: 3,01 dB en f0, 0,97 dB en f0/2 y en 2f0, y 0,04 dB en f0/10 y en 10f0 (signo: la curva exacta de un polo queda por debajo; la de un cero, por encima). En fase, la rampa se separa hasta 5,71◦
en f0/10 y 10f0. Si dos esquinas están a menos de una década, los errores se suman y la asíntota empeora. Las asíntotas no reemplazan la curva exacta: sirven para diseñar, predecir y detectar errores del cálculo numérico.

Software. scipy.signal.bode(sistema, w) devuelve ω (rad/s), magnitud en dB y fase en grados; en MATLAB, bode(sys) con Control System Toolbox usa también rad/s por defecto. Hay que convertir si se quiere f en Hz. El cálculo numérico exacto es una simulación del modelo ideal; no incluye tolerancias ni efectos de carga.

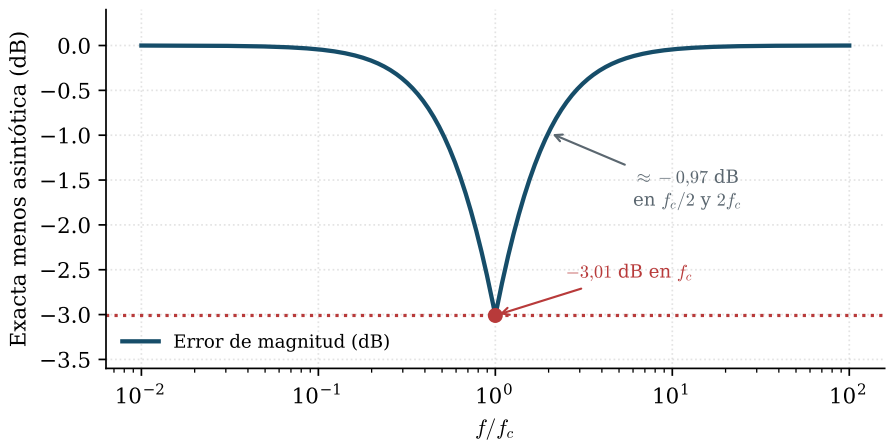
[picture p51: figure]
Exacta menos asintótica (dB); Error de magnitud (dB)

Figura 56: Error de magnitud de un polo simple: curva exacta menos asíntota, en dB, frente a f /fc. El máximo, −3,01 dB, ocurre en fc; en fc/2 y 2fc vale ≈ −0,97 dB. Generada en clase3_asintotas_vs_exacta.ipynb.

### 25.2. Ejemplo S06-3-A Error de la asíntota en un polo simple

Enunciado. Para un polo simple H = 1/(1 + jf /fc), calcular el error de magnitud en f /fc = 0,1, 0,5, 1, 2 y 10, y el error máximo de la asíntota de fase.
Método. Error = −10 log10(1 + k

2
) + 20 log10 m´ax(k, 1) con k = f /fc.
k | Exacta (dB) Asintótica (dB) Error (dB)
0,1 | −0,04 | 0 | −0,04
0,5 | −0,97 | 0 | −0,97
1 | −3,01 | 0 | −3,01
2 | −6,99 | −6,02 | −0,97
10 | −20,04 | −20,00 | −0,04

Fase: en k = 0,1 la exacta es − arctan 0,1 = −5,71◦ y la asíntota 0◦

| | | , con error 5,71◦
; el cuaderno
confirma que es el máximo sobre 0,1 ≤ k ≤ 10.

Interpretación y comprobación. La asíntota es mejor que 1 dB a una octava de fc y tiene un error simétrico en log f. Se comprobó con numpy sobre 20 001 puntos.

### 25.3. Ejemplo S06-3-B Un cero y dos polos

Enunciado. Trazar las asíntotas y comparar con la curva exacta para

H(s) = 100 | 1 + s/ωz
| (1 + s/ω1)(1 + s/ω2)
, | f1 = 100 Hz, fz = 1 kHz, f2 = 10 kHz. | (118)

Datos y supuestos. Polos y cero reales separados una década; ganancia en continua K = 100 (40 dB); sistema ideal.

Paso 1. Nivel inicial 20 log10 100 = 40 dB, pendiente 0.
Paso 2. Tramos. Hasta 100 Hz: 40 dB. De 100 Hz a 1 kHz: −20 dB/dec, de 40 a 20 dB. De 1 a 10 kHz: pendiente 0 (el cero compensa el polo), meseta de 20 dB. Desde 10 kHz: −20 dB/dec; llega a 0 dB en 100 kHz.

Paso 3. Fase. 0

- hasta 10 Hz. Entre 10 y 100 Hz solo actúa la rampa del polo f1: baja 45◦/dec hasta −45◦

. Entre 100 Hz y 10 kHz la rampa del cero (+45◦/dec, desde fz/10 = 100 Hz) compensa la del polo f1 (que termina en 1 kHz) y la del polo f2 (desde 1 kHz): la fase asintótica se mantiene en −45◦

. Después de 10 kHz solo queda la rampa de f2, que llega a −90◦
| | | | en 100 kHz.
Paso 4. Comparación. Cálculo exacto (cuaderno):

f (Hz) Exacta (dB) Asintótica (dB) Error (dB) Fase exacta (◦
| | | | )
10 | 39,96 | 40,00 | −0,04 | −5,2
100 | 37,03 | 40,00 | −2,97 | −39,9
300 | 30,37 | 30,46 | −0,09 | −56,6
1000 | 22,92 | 20,00 | +2,92 | −45,0
3000 | 20,08 | 20,00 | +0,08 | −33,2
10 000 | 17,03 | 20,00 | −2,97 | −50,1
100 000 | −0,04 | 0,00 | −0,04 | −84,8

Interpretación. Los errores mayores aparecen en las esquinas (cerca de 3 dB), con signo contrario en el cero. La fase exacta no se comporta como la meseta de −45◦ de la asíntota: se aparta hasta 11,8

- de ella porque la separación de una década no basta para que las rampas se compensen (Figura 57).

Comprobación independiente. scipy.signal.bode coincide con el cálculo directo en 100 Hz, 1 kHz y 10 kHz (tolerancia 10⁻⁶
en el cuaderno). Además, la ganancia a 10⁵ Hz es 20 log10(100 · 0,1) − 20 = 0 dB.

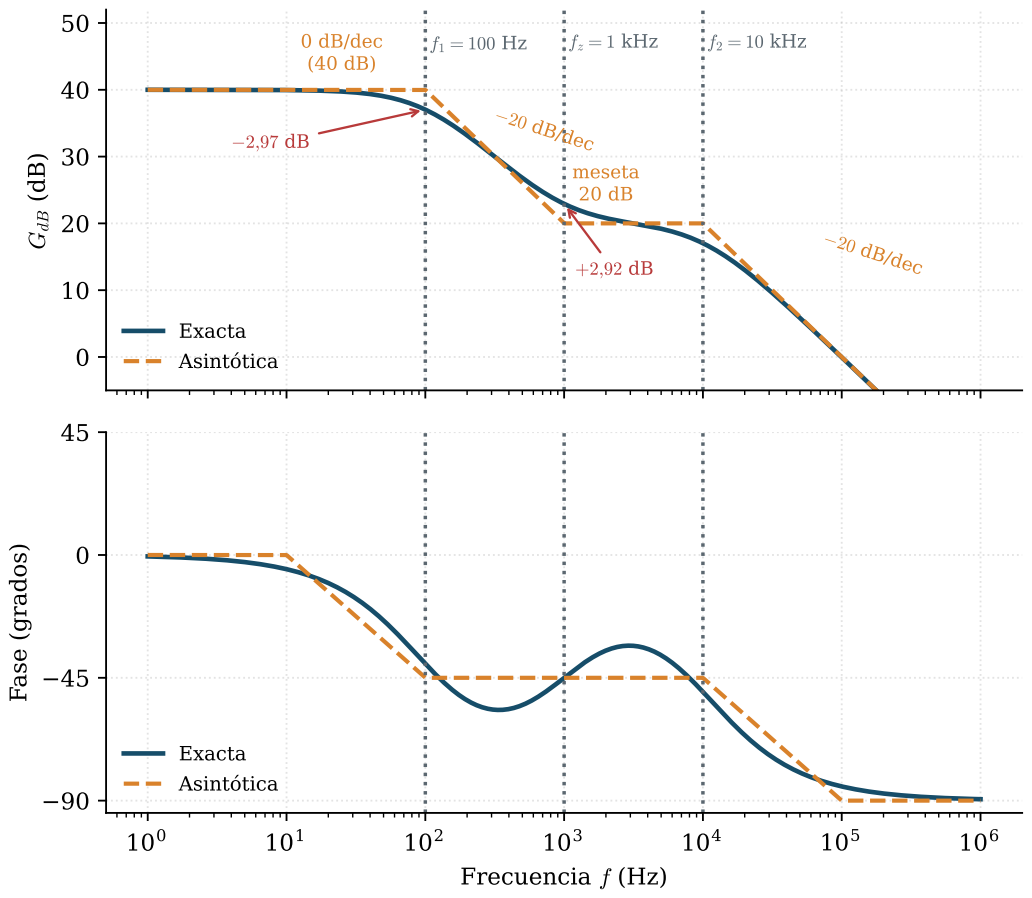
[picture p52: figure]
GdB (d; 0 dB/dec; fz = 1 kHz; f2 = 10 kHz; ¡20 dB/dec; meseta 20 dB; Exacta; Asintótica; Frecuencia f (Hz); Fase (grados)

Figura 57: Bode del Ejemplo S06-3-B. Arriba, magnitud: curva exacta (azul continua) y asintótica (naranja, trazos), con f1 = 100 Hz, fz = 1 kHz y f2 = 10 kHz marcadas y los errores de −2,97 y +2,92 dB. Abajo, fase en grados. Debe observarse que las pendientes cambian en cada esquina y que la mayor discrepancia está en las esquinas. Generada en clase3_asintotas_vs_exacta.ipynb.

### 25.4. Ejercicios

S06-3-E1 (construcción). Para H(s) = 10 (1 + s/ω1)/(1 + s/ω2) con f1 = 200 Hz y f2 = 2 kHz: trazar la asíntota de magnitud, hallar el error en f = 1 kHz y el error máximo, y la fase exacta en 200 Hz.
S06-3-E2 (lectura inversa). Un diagrama asintótico muestra 26 dB hasta 500 Hz, después −20 dB/dec hasta 5 kHz y −40 dB/dec más allá. Escribir H(s), y hallar la magnitud y la fase exactas en 5 kHz y 50 kHz.

Pregunta conceptual. Si dos polos coinciden en f0, ¿qué pendiente aparece después de f0 y cuánto vale el error exacto en f0? Justificar.

### 25.5. Errores frecuentes y comprobaciones

Trazar la asíntota sin normalizar: si un factor es (s + ω1), hay que sacar ω1 y ajustar K.

Usar ω (rad/s) como frecuencia de esquina en un eje en Hz.

Olvidar que el cero sube 20 dB/dec y que K < 1 da un nivel inicial negativo en dB.

Suponer que la asíntota de fase es la curva real; el error llega a 5,71◦ para un factor y puede ser mayor con esquinas próximas.

Aceptar la salida del software sin comparar con el trazado manual; el desacuerdo indica un error de uno de los dos.

### 25.6. Conexión con el curso

El Bode asintótico servirá para el diseño de filtros y de la etapa de acondicionamiento del proyecto: antes de simular o medir, el estudiante dibuja la respuesta esperada y la compara con la simulación. Las semanas siguientes (amplificadores operacionales) añaden GBW y slew rate que modifican este diagrama.

### Código y recursos de la semana

Código de la semana

codigo/python/semana_06/clase1_escalas_logaritmicas.ipynb: décadas y octavas, barrido logarítmico, figura lineal_vs_log.

codigo/python/semana_06/clase2_magnitud_db_fase.ipynb: conversiones dB, tabla del RC, ejercicios E1 y E2, figura bode_rc.

codigo/python/semana_06/clase3_asintotas_vs_exacta.ipynb: error de las asíntotas, ejemplo B, figuras bode_compuesto y error_asintota.

codigo/matlab/semana_06/clase1_escalas_logaritmicas.m, clase2_magnitud_db_fase.m y clase3_asintotas_vs_exacta.m: equivalentes (no ejecutados en este entorno; bode requiere Control System Toolbox).

### Referencias de la semana

SciPy community, scipy.signal.bode, SciPy v1.18.0 Manual.

https://docs.scipy.org/doc/scipy/reference/generated/scipy.signal.bode.html (consultado el 2026-11-
03).

MathWorks, bode: Bode frequency response of dynamic system, Control System Toolbox documentation.

https://www.mathworks.com/help/control/ref/dynamicsystem.bode.html (consultado el 2026-11-03).

### Parte VII

# Semana 7: Amplificadores operacionales

### 26. S07-1 Historia y modelo ideal del amplificador operacional

Resultados, prerrequisitos y distribución

Al terminar, el estudiante podrá (1) escribir el modelo vo = A(vP − vN ) y obtener la ganancia con realimentación cuando A es finita; (2) enunciar las tres condiciones que justifican el cortocircuito virtual; (3) calcular el techo y el piso de salida y el límite de entrada lineal a partir de una hoja de datos. Se comprueba al final con S07-1-E2.
Prerrequisitos: divisor de tensión y Thévenin (S01-1) y decibelios (semana 6). Los análisis detallados del inversor y del no inversor corresponden a la semana 8; aquí el no inversor solo sirve como circuito de prueba de las hipótesis del modelo.

Distribución propuesta de 120 minutos

Diagnóstico, 10 min (divisor de tensión y ganancia en dB, sin calificar). Historia y modelo, 25 min. Ejemplos guiados, 30 min. Práctica de los ejercicios, 40 min. Cierre y contraste de resultados, 15 min. Trabajo previo (no presencial): descargar las hojas de datos del LM358 y del TL081 y localizar las tablas de características eléctricas.

### 26.1. Breve historia

La expresión «amplificador operacional» se asocia al artículo de J. R. Ragazzini, R. H. Randall y
F. A. Russell, «Analysis of Problems in Dynamics by Electronic Circuits», Proceedings of the IRE, vol. 35, n.º 5, 1947, pp. 444–452, que describe amplificadores de alta ganancia con realimentación para resolver ecuaciones integrodiferenciales; las fuentes secundarias discrepan sobre quién acuñó el término, por lo que aquí solo se cita el artículo. La función era matemática (sumar, integrar, derivar), de ahí el nombre. Las familias que se usarán en el laboratorio son de integración monolítica y muy anteriores a este curso: la hoja de datos del LM358 (TI, SLOS068) fecha su primera edición en junio de 1976 y la del TL081 (TI, SLOS081) en febrero de 1977, y ambas siguen en revisión (octubre de 2024 y septiembre de 2025). Una hoja de datos vigente describe, por tanto, un diseño antiguo con variantes nuevas; hay que identificar cuál se tiene en la mano.

### 26.2. Concepto físico y modelo

Un amplificador operacional es un amplificador de tensión diferencial de ganancia muy alta, con una entrada de alta impedancia y una salida de baja impedancia, que se usa casi siempre con una red de realimentación. Símbolos: vP y vN son las tensiones de las entradas no inversora e inversora respecto de la referencia; vd = vP − vN ; A es la ganancia diferencial en lazo abierto; Rid y Ro son las resistencias de entrada y de salida; VS+ y VS− son las tensiones de alimentación. La Figura 58 muestra el modelo lineal.

vP

Rid

vN

vd = vP − vN

Ro
vo

RL

Tierra de referencia (punto común)
Los extremos vP y vN no se conectan a tierra

Figura 58: Modelo de ganancia finita del operacional. La fuente dependiente entrega A vd referida a tierra; vP y vN son terminales de entrada, no nodos conectados a tierra.

El modelo vale mientras la salida está dentro de los límites que impone la alimentación:

vo = A (vP − vN ), | vo,m´ın ≤ vo ≤ vo,m´ax. | (119)

El modelo ideal supone A → ∞, Rid → ∞ (corrientes de entrada nulas), Ro = 0, ancho de banda infinito, offset nulo y rechazo de modo común infinito. Ninguna de esas hipótesis se cumple exactamente; la clase del miércoles cuantifica cuánto fallan.

Realimentación negativa y cortocircuito virtual. Sea el no inversor de la Figura 59, en el que una fracción β = Rg/(Rf +Rg) de la salida vuelve a la entrada inversora, vN = βvo, y vP = vin. Con (119):

vo = A(vin − βvo) ⇒ G =

vo

vin

=

A
1 + Aβ , vd =

vo
A
. | (120)

Si Aβ ≫ 1, G ≈ 1/β = 1 + Rf /Rg y vd ≈ 0. Esta igualdad vP ≈ vN es el cortocircuito virtual y es una consecuencia, no una propiedad del componente. Se puede usar solo si se cumplen las tres condiciones siguientes: (i) hay realimentación negativa desde la salida a la entrada inversora, (ii) la salida está en régimen lineal (sin saturar) y (iii) Aβ ≫ 1 a la frecuencia de trabajo. Si falta alguna, vd no es pequeña y se debe usar (119) completa.

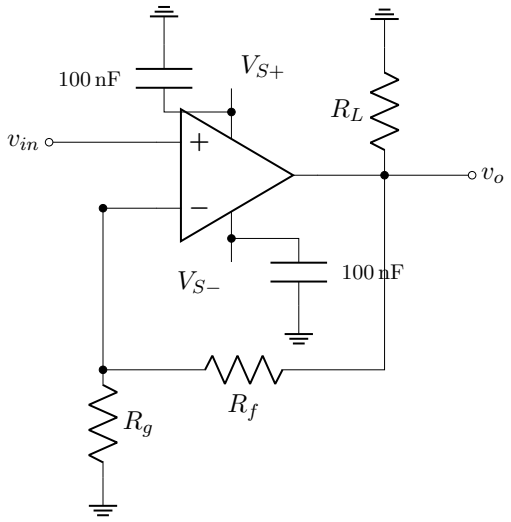
[picture p53: figure]
vin

Figura 59: No inversor usado como circuito de prueba: alimentación partida VS+, VS− con un condensador cerámico de 100 nF entre cada pin de alimentación y tierra, carga RL a tierra y red Rf –Rg de realimentación negativa. La tierra es la referencia común de vin, vo y las fuentes.

Saturación. Con alimentación VS+, VS− la salida no alcanza los rieles: queda a una distancia que depende del dispositivo y de la corriente de carga. La relación entrada–salida es una recta de pendiente G con dos tramos planos, como en la Figura 60. En un tramo plano vd es mayor que vo/A y no hay cortocircuito virtual. En lazo abierto o con realimentación positiva ocurre lo mismo: el dispositivo trabaja como comparador de baja calidad. Un LM358 no equivale a un comparador dedicado: su hoja de datos especifica el tiempo de recuperación de sobrecarga (10 µs típico para el LM358B, con la entrada excedida) y no ofrece histéresis ni garantías de conmutación; para comparar niveles se elige un comparador diseñado para ello.

Características ideales y reales. Con los valores de las hojas de datos de TI (versión y fecha en las referencias):

Característica | Ideal | LM358B | TL08xC
Ganancia en lazo abierto A | ∞ | mín. 70 kV/V (típ. 140) mín. 25 kV/V (típ. 200)
Corriente de polarización IB | 0 | máx. 35 nA | máx. 200 pA
Offset de entrada VOS | 0 | máx. 3,0 mV | máx. 10 mV

Condiciones: LM358B con VS = 15 V y RL ≥ 10 kΩ para A, 25 ◦C; TL08xC con ±15 V y 25 ◦C. «Mín.» y «máx.» son valores garantizados; «típ.» no lo es. El resto de parámetros se estudia en S07-2.

−1.5 | −1.0 | −0.5 | 0.0 | 0.5 | 1.0 | 1.5

## Tensión de entrada vin (V)

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
nsió

n

d

## e salid

## a vo (V)

### techo: V + ¡ 1;48 V = 3,52 V

### piso: V ¡ + 1;0 V = ¡4;0 V

ideal, sin límites (G = 3) | vin = 1;17 V

## con límites de salida (modelo)

Figura 60: Característica de transferencia de un LM358B con G = 3 y alimentación ±5 V (modelo con los límites de salida de la hoja de datos). Debe observarse que la recta ideal solo se sigue hasta vin = 1,17 V; más allá la salida se aplana y el cortocircuito virtual deja de valer. Generada por el notebook clase1_modelo_ideal.ipynb.

### 26.3. Ejemplo S07-1-A Ganancia finita y diferencia entre entradas

Enunciado. El circuito de la Figura 59 tiene Rf = 10 kΩ, Rg = 1 kΩ, alimentación ±15 V y RL ≥ 10 kΩ. Con A = 70 000 (mínimo del LM358B en esas condiciones) y vin = 0,5 V, hallar G, el error respecto de la ganancia ideal y vP − vN .
Datos y supuestos. A = 7 × 10⁴
, β = 1/11. Sin saturación (vo ≈ 5,5 V ≪ 15 V); Rid muy grande, sin corriente de entrada. Incógnitas: G, vo, vd.
Método. Se plantea el modelo (119) junto con vN = βvo, porque aún no se ha supuesto cortocircuito virtual y se quiere medir su validez.

G =

A
1 + Aβ =

70 000
1 + 70 000/11
= 10,9983, | (121)

ε =

11 − G
11

=

1
1 + Aβ = 1,57 × 10⁻⁴
(0,016 %), | (122)
vo = G vin = 5,499 V, | vd =

vo
A
= 78,6 µV. | (123)

Interpretación. La diferencia entre entradas es unas 7 × 10⁴ veces menor que la salida: el cortocircuito virtual es una buena aproximación, y el error de ganancia lo fija 1/(1 + Aβ), no A solo. Comprobación independiente. El sistema lineal en (vo, vd) con vd + βvo = vin y vo − Avd = 0, resuelto numéricamente en el notebook, da los mismos valores; en el límite A → ∞ se recupera G = 11.

### 26.4. Ejemplo S07-1-B Saturación y límite de entrada con alimentación partida

Enunciado. Un LM358B con ±5 V (VS = 10 V), RL = 10 kΩ, Rf = 2 kΩ, Rg = 1 kΩ. Hallar el techo y el piso garantizados de salida, la amplitud de entrada a partir de la cual deja de ser lineal y comprobar el modo común.
Datos de la hoja de datos (LM358B, SLOS068AB, §5.5, 25 ◦C). Caída desde el riel positivo con Iout = 1 mA: típ. 1,4 V, máx. 1,48 V. Con salida a V−: hasta 1 V sobre V− (sumidero de 1 mA, máx.). Rango de modo común de V− a V+ − 1,5 V.

Método. Se usan los valores máximos de caída porque dan el límite garantizado, y se comprueba por separado cada límite: salida y modo común.

vo,m´ax = 5 − 1,48 = 3,52 V, | vo,m´ın = −5 + 1,0 = −4,0 V, | (124)

G = 1 +

Rf
Rg

= 3 ⇒ vin,m´ax =

| 3,52
| 3
= 1,173 V, | vin,m´ın =

−4,0
3

= −1,333 V. (125)

Modo común: vCM ≈ vin ≤ 5−1,5 = 3,5 V; el límite de salida (1,17 V) se alcanza antes. La corriente de carga en el techo es 3,52/10 000 = 0,352 mA < 1 mA, por lo que el dato de 1 mA es conservador.

Interpretación. La salida real no llega a ±5 V y es asimétrica. Con una señal de entrada de amplitud mayor que 1,17 V la parte superior se recorta (Figura 60). Comprobación independiente. Con ±15 V y las mismas resistencias el mismo cálculo da un techo mucho mayor: el recorte depende de la alimentación, no de G.

### 26.5. Ejercicios

S07-1-E1. Con Rf = 47 kΩ, Rg = 1 kΩ y A = 70 000 (alimentación ±15 V), hallar G y el error relativo respecto de 1 + Rf /Rg. ¿Qué A mínima da un error menor que 0,1 %?

S07-1-E2. Un LM358B con ±5 V, RL = 10 kΩ y G = 3 recibe vin = 1,5 V en continua. ¿Cuánto vale la salida esperada ideal y la real? ¿Es válido el cortocircuito virtual? Justificar.

Pregunta conceptual. Se conecta la señal a la entrada no inversora de un LM358 sin ningún elemento entre la salida y las entradas y se aplica una diferencia de 1 mV. ¿Vale vP ≈ vN ? ¿Es adecuado usarlo así para detectar un umbral?

### 26.6. Errores frecuentes y comprobaciones

Error frecuente

Aplicar vP = vN en lazo abierto, con realimentación positiva o con la salida saturada.

Suponer que la salida llega al riel: hay que restar la caída que da la hoja de datos.

Olvidar que el techo depende de la corriente de carga y del tipo de dispositivo.

Quitar el condensador de 100 nF cerca de los pines de alimentación del montaje.

Tomar un valor «típ.» como garantizado en un diseño.

Comprobar siempre: vo dentro de los límites, vCM dentro del rango, Aβ ≫ 1 y unidades coherentes.

### 26.7. Conexión con el curso y el proyecto

Los límites de salida y de modo común se usarán para elegir la alimentación del acondicionamiento del sensor del proyecto. En la semana 8 se analizan el inversor y el no inversor; este modelo es la base para justificar cada simplificación.

### 27. S07-2 Parámetros reales y hojas de datos

Resultados, prerrequisitos y distribución

Al terminar, el estudiante podrá (1) estimar el error de salida en continua por offset y corrientes de polarización; (2) combinar GBW, slew rate y límites de salida para fijar frecuencia y amplitud utilizables; (3) leer una tabla de hoja de datos distinguiendo variante, condiciones y mín./típ./máx. Se comprueba con S07-2-E1 y S07-2-E2.
Prerrequisitos: S07-1 (modelo y realimentación) y decibelios y diagramas de Bode (semana 6).

Distribución propuesta de 120 minutos

Diagnóstico, 10 min (calcular G y el ancho de banda de un no inversor con Rf y Rg dados). Explicación de cada parámetro, 30 min. Ejemplos guiados, 30 min. Lectura guiada de la hoja de datos en equipos, 30 min. Cierre y ejercicios, 20 min. Trabajo previo: ubicar en cada hoja de datos las tablas de «Electrical Characteristics» y las condiciones de prueba. Los ejercicios se resuelven en la sesión o como trabajo autónomo posterior.

### 27.1. Concepto físico y modelo

Símbolos nuevos: VOS, tensión de offset de entrada; IB, corriente de polarización (promedio de las dos entradas); IOS, corriente de offset (diferencia entre las dos); GBW, producto ganancia–ancho de banda; SR, velocidad de variación de la salida; CMRR, rechazo de modo común; VCM, tensión de modo común; G, ganancia en lazo cerrado.

Offset y corrientes de polarización. VOS se modela como una fuente en serie con una entrada, que el circuito amplifica como si fuera señal. En el no inversor de ganancia G = 1 + Rf /Rg y entrada a tierra, con IB entrando al nodo inversor desde Rf (de la ecuación nodal con vN = VOS), el error en continua de la salida es

vo,err = G VOS + IB Rf . | (126)

Los dos términos pueden sumarse en el peor caso. El signo real de cada uno es desconocido a priori y se acota con los valores máximos.

Ancho de banda y slew rate. Con un modelo de un polo, A(f) ≈ GBW/f para f mucho mayor que el polo del lazo abierto, y el ancho de banda a −3 dB en lazo cerrado es

fc ≈

GBW
G
. | (127)

Esto es un límite de pequeña señal. La segunda limitación es de gran señal: un seno de pico Vp y frecuencia f exige una pendiente máxima 2πfVp. Si ésta supera SR la salida se deforma hacia un triángulo. La frecuencia de potencia plena y la amplitud máxima sin deformación son

fF P =

SR
2πVp
, | Vp,m´ax(f) = SR
2πf . | (128)

La frecuencia utilizable la fija el menor de los dos límites y, además, la salida no puede superar sus límites de excursión.

CMRR. El rechazo de modo común se expresa como relación Ad/Acm en dB, o como tensión de offset equivalente por voltio de modo común en µV/V. Ambas se relacionan por CMRRdB = 20 log10(1/valor en V/V): 20 µV/V equivalen a 93,98 dB y 100 µV/V a 80 dB. El error referido a la entrada es VCM · valor en V/V.

Rango de modo común y excursión de salida. Es el intervalo de VCM en que se garantizan las demás especificaciones; la salida tiene su propia excursión, que depende de la carga. Ambos límites son parte del diseño y se verifican por separado.

### 27.2. Cómo leer una hoja de datos

1. Identificar el sufijo y el paquete exactos; la misma hoja agrupa variantes con valores distintos.
2. Localizar la tabla con la alimentación, la temperatura y la carga de la prueba; un valor solo vale en esas condiciones.
3. Distinguir mín., típ. y máx. Para diseñar con garantía se usa el valor garantizado más desfavorable.
4. Comprobar la unidad y la convención (por ejemplo µV/V frente a dB).
5. Anotar la versión del documento y la fecha de consulta.

El Cuadro 4 reúne los valores utilizados en este capítulo. Todos son de las hojas de TI consultadas el 2026-11-03: LM358, LM358B, LM358A y variantes, SLOS068AB (junio de 1976, revisada en octubre de 2024), §5.5 y §5.7; TL081 y familia, SLOS081O (febrero de 1977, revisada en septiembre de 2025), §5.8 y §5.9. El «LM358 anterior» es la variante sin sufijo B de la tabla §5.7, con VS = 5 V salvo indicación. Si el componente del banco es de otro fabricante, se usa la hoja de ese fabricante, no ésta.

Cuadro 4: Valores de hoja de datos usados en la semana (25 ◦C). Las condiciones están en el texto y en las secciones indicadas.

Parámetro | LM358B (§5.5) | LM358 anterior (§5.7) | TL08xC (§5.8, §5.9)
Alimentación recomendada | 3 V a 36 V | 3 V a 30 V | 4,5 V a 40 V; 10 V a 30 V
| | | en paquetes NS y PS
VOS | típ. ±0,3 mV, máx.
| ±3,0 mV | típ. 3 mV, máx. 7 mV | típ. 3 mV, máx. 10 mV
IB | típ. −10 nA, máx. −35 nA | típ. −20 nA, máx. −250 nA | típ. 65 pA, máx. 200 pA
IOS | típ. 0,5 nA, máx. 4 nA | típ. 2 nA, máx. 50 nA | típ. 5 pA, máx. 100 pA
A | mín. 70 kV/V, típ. 140
| (VS = 15 V, RL ≥ 10 kΩ) | mín. 25, típ. 100 kV/V
| | (VS = 15 V, RL ≥ 2 kΩ) | mín. 25, típ. 200 kV/V
GBW (típ.) | 1,2 MHz | 0,7 MHz | 5,25 MHz; 3 MHz en
| | | paquetes NS y PS
SR | típ. 0,5 V/µs (G = +1) | típ. 0,3 V/µs (G = +1) | mín. 8, típ. 20 V/µs
| | | (VI = 10 V, CL = 100 pF,
| | | RL = 2 kΩ)
CMRR | típ. 20 µV/V (94 dB), máx.
| 100 µV/V (80 dB) | mín. 65 dB, típ. 80 dB | mín. 70 dB, típ. 100 dB
Modo común | de V− a V+ − 1,5 V | de V− a V+ − 1,5 V | mín. ±11 V; típ. −12 a
| | | 15 V
Excursión de salida | caída máx. al riel +: 1,48 V
| (Iout = 1 mA); sumidero a
| V− máx. 1 V sobre V−
| (1 mA) | no se usa | VOM mín. ±12 V, típ.
| | | ±13,5 V (RL = 10 kΩ)

Además, para el LM358B el rango de modo común recomendado a toda la temperatura es de V− a V+ − 2 V. En la tabla del TL08xC, la fila de VCM presenta ±11 V y «−12 a 15» en dos columnas; se interpretan como mínimo y típico.

### 27.3. Ejemplo S07-2-A Error de offset en continua

Enunciado. No inversor con Rf = 100 kΩ, Rg = 1 kΩ y entrada a tierra. Hallar el máximo error de continua en la salida para LM358B, LM358BA (VOS máx. ±2,0 mV), LM358 anterior y TL08xC.

Datos y supuestos. G = 101. Se usan valores máximos del Cuadro 4 (IB en módulo) y se supone que ambos términos de (126) se suman. No se consideran deriva con la temperatura ni resistencia de la fuente (entrada en cortocircuito a tierra). Incógnitas: vo,err.

Método. Ecuación (126); es la suma de dos efectos independientes y permite ver cuál domina.

LM358B: 101(3,0 mV) + (35 nA)(100 kΩ) = 303 mV + 3,5 mV = 306,5 mV, | (129)
LM358BA: 202 mV + 3,5 mV = 205,5 mV, | (130)
LM358 anterior: 707 mV + 25 mV = 732 mV, | (131)
TL08xC: 1010 mV + 0,02 mV ≈ 1,010 V. | (132)

Interpretación. En el dispositivo bipolar domina G VOS, y la corriente de polarización cuenta en el LM358 anterior; en el de entrada JFET la corriente es despreciable pero el offset garantizado es mayor. Menor IB no implica menor error. Comprobación independiente. Resolver la ecuación nodal (vN − vo)/Rf + vN /Rg + IB = 0 con vN = VOS da vo = 101VOS + Rf IB (comprobado simbólicamente en el notebook).

### 27.4. Ejemplo S07-2-B Ancho de banda, slew rate y amplitud útil

Enunciado. Un no inversor con G = +11 (Rf = 10 kΩ, Rg = 1 kΩ) se implementa con LM358B (±5 V) y con TL08xC (±15 V en encapsulado distinto de NS y PS). Hallar el ancho de banda de pequeña señal, la frecuencia de potencia plena para los valores de Vp indicados y la amplitud máxima del LM358B a 100 kHz.

Supuestos. Modelo de un polo; valores típicos de GBW; SR mínimo del TL08xC. Salida con RL = 10 kΩ.

fc(LM358B) = 1,2 MHz
11

= 109,1 kHz, fc(TL08xC) = 5,25 MHz 11

= 477,3 kHz,

(133)
fF P (LM358B, Vp = 3 V) = 0,5 × 10⁶
2π(3) = 26,5 kHz, | (134)

fF P (TL08xC, Vp = 10 V) = 8 × 10⁶
2π(10) = 127,3 kHz (con SR típ.: 318,3 kHz), | (135)

Vp,m´ax(100 kHz) = 0,5 × 10⁶ 2π(10⁵)

= 0,796 V. | (136)

Interpretación. Con Vp = 3 V el LM358B está limitado por pendiente mucho antes de su ancho de banda de pequeña señal (26,5 kHz frente a 109,1 kHz); a 100 kHz solo admite unos 0,8 V de pico, aunque la ganancia aún sea cercana a −3 dB (Figuras 61 y 62). Comprobación independiente. Con f = 26,5 kHz y Vp = 3 V la pendiente máxima del seno es 2πfVp = 0,5 V/µs = SR.

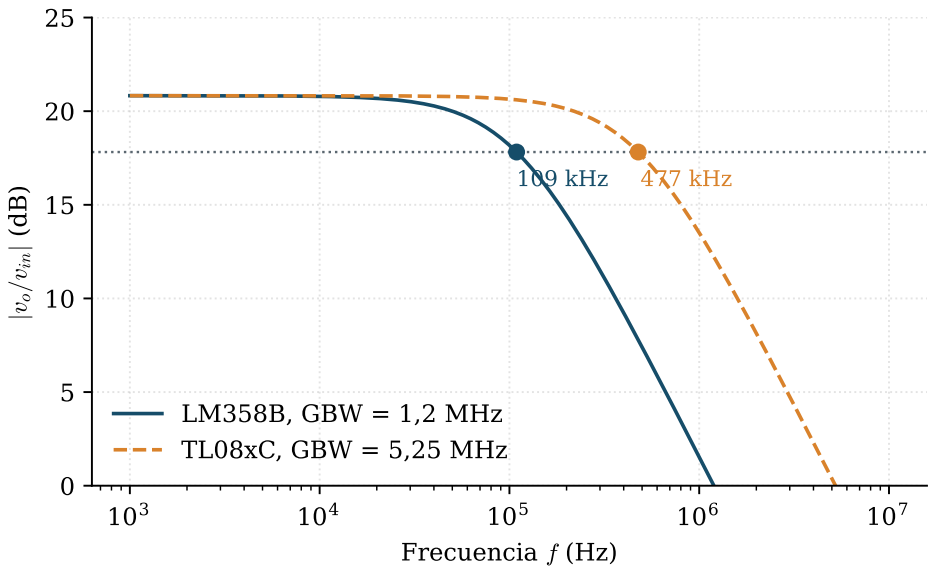
[picture p54: figure]
Frecuencia f (Hz); jvo=vinj (d; 109 kHz 477 kHz; LM358B, GBW = 1,2 MHz TL08xC, GBW = 5,25 MHz

Figura 61: Magnitud de G = +11 con el modelo de un polo, para GBW de 1,2 MHz (LM358B) y 5,25 MHz (TL08xC). Debe observarse que el LM358B cae 3 dB en 109 kHz y el TL08xC en 477 kHz. Notebook clase2_parametros_reales.ipynb; es un modelo, no una medición.

10

3 | 10
4 | 10
5 | 10

6
Frecuencia f (Hz)

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
plitu

d

pic

o

m

á

xim

a

Vp (V)

100 kHz: 0,80 V

LM358B, SR = 0,5 V/¹s; techo 3,52 V TL08xC, SR mín. = 8 V/¹s; VOM mín. 12 V TL08xC, SR típ. = 20 V/¹s; VOM típ. 13,5 V

Figura 62: Amplitud pico máxima sin deformación por pendiente (ecuación (128)), recortada por el techo de salida. Debe observarse el codo en cada curva: a la izquierda manda la excursión de salida; a la derecha, el slew rate.

### 27.5. Ejercicios

S07-2-E1. Con el circuito de S07-2-A, la entrada es una tensión continua de 10 mV (salida ideal 1,01 V). Calcular para LM358B, LM358BA y TL08xC el error máximo de continua como porcentaje de la salida ideal, y proponer dos formas de reducirlo.
S07-2-E2. Un LM358B con G = +10 (Rf = 9 kΩ, Rg = 1 kΩ) recibe un seno de 0,2 V de pico a

50 kHz. Comprobar si el ancho de banda y el slew rate permiten reproducir la señal y hallar la amplitud máxima sin deformación a esa frecuencia.

Pregunta conceptual. Un TL08xC tiene GBW de 5,25 MHz. ¿Puede amplificar con ganancia 100 una señal de 1 MHz? Justificar.

### 27.6. Errores frecuentes y comprobaciones

Error frecuente

Aplicar fc = GBW/G sin revisar el slew rate ni la excursión de salida.

Usar el valor típico de GBW o SR como si fuera garantizado.

Mezclar µV/V con dB en CMRR.

Leer la tabla de una variante distinta de la que se montará (sufijo, paquete).

Calcular el error de offset con VOS pero omitir G, o con IB sin Rf .

Ignorar que los valores de hoja valen en unas condiciones de alimentación y carga concretas.

### 27.7. Conexión con el curso y el proyecto

Esta tabla de lectura se convierte en el criterio de selección del operacional del acondicionamiento del proyecto: cada elección debe justificarse con una fila de la hoja de datos y con el peor caso. El jueves se contrastan estas predicciones con el laboratorio.

### 28. S07-3 Laboratorio: LM358 frente a TL081

Resultados, prerrequisitos y distribución

Al terminar, el estudiante podrá (1) montar un no inversor con alimentación partida y desacoplo y medir su respuesta; (2) obtener con osciloscopio el ancho de banda, el tiempo de subida por pendiente, la saturación y el offset de continua; (3) comparar la medición con la predicción por modelo y con la hoja de datos, y explicar las diferencias. Se comprueba con la tabla de comparación y con S07-3-E1 y S07-3-E2.

Prerrequisitos: S07-1 y S07-2 y el uso del osciloscopio de S01-3. Trabajo previo: completar la columna «Predicción» de las tablas con las ecuaciones de S07-2 y preparar los montajes sobre el papel. No se incluyen resultados medidos: los espacios los llena el estudiante.

Distribución propuesta de 120 minutos

Seguridad y diagnóstico de la referencia, 10 min. Montaje y revisión del docente antes de energizar, 20 min. Medición con el LM358, 35 min. Medición con el TL081, 25 min. Comparación y cierre, 30 min. Si el tiempo no alcanza, las prácticas C y D del TL081 pueden hacerse en una sesión posterior.

### 28.1. Seguridad y condiciones

Solo baja tensión aislada. Fuente doble con salida flotante y común explícito; verificar con el multímetro la continuidad entre las masas del generador, del osciloscopio y del común del montaje antes de conectar, y no llevar la masa de una sonda a un nodo distinto de la referencia del montaje.

Antes de conectar la placa, medir con el multímetro las tensiones de alimentación y su polaridad. Limitar la corriente de la fuente (por ejemplo, 50 mA, valor de práctica del laboratorio, no de la hoja de datos). No superar las tensiones recomendadas: ±5 V para el LM358 y ±15 V para el TL081. Si la fuente del laboratorio no proporciona ±15 V, no comparar el TL081 con la tabla de hoja de datos y declararlo en el informe.

### 28.2. Dispositivos y montaje

Anotar de cada circuito integrado fabricante, referencia completa con sufijo, paquete y código de fecha; los valores de predicción de esta guía son del LM358B y del TL08xC de TI (versiones en las referencias). Si el ejemplar es un LM358 sin sufijo B u otro fabricante, usar la columna correspondiente del Cuadro 4 y anotarlo.
Terminales (vista superior, encapsulado de 8 pines, hojas de TI): LM358: 1 = salida del amplificador 1, 2 = entrada inversora, 3 = entrada no inversora, 4 = V−, 8 = V+; usar solo el amplificador 1 y conectar el 2 como seguidor con su entrada no inversora (pin 5) a tierra, la inversora (pin 6) unida a su salida (pin 7). TL081 (encapsulado P): 2 = entrada inversora, 3 = entrada no inversora, 4 = VCC−, 6 = salida, 7 = VCC+; los pines 1, 5 y 8 no se conectan.

Desacoplo: un condensador cerámico de 100 nF entre cada pin de alimentación y tierra, lo más cerca posible del circuito integrado (recomendación de ambas hojas). Carga: RL = 10 kΩ a tierra, coincidente con la condición de prueba de las tablas. Resistencias: Rf = 10 kΩ, Rg = 1 kΩ para G = +11; Rf = 100 kΩ, Rg = 1 kΩ para G = +101; en el seguidor, Rf = 0 y sin Rg. Medir con el multímetro el valor real de cada resistencia.

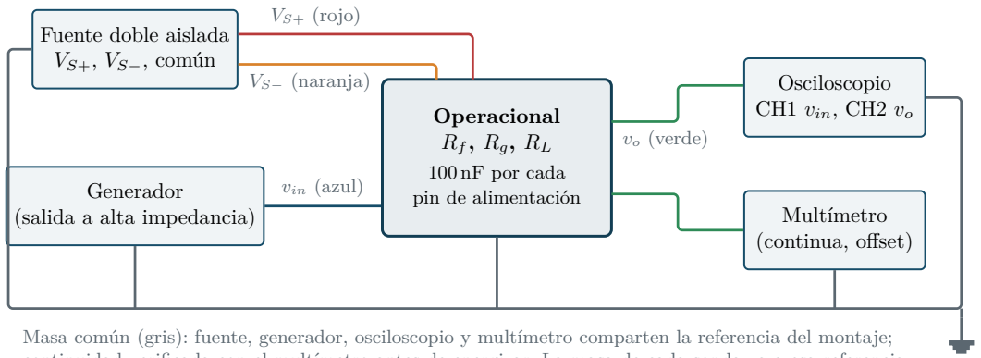
[picture p55: figure]
Fuente doble aislada VS+, VS−, común; Generador (salida a alta impedancia); Operacional Rf , Rg, RL; 100 nF por cada pin de alimentación; Osciloscopio CH1 vin, CH2 vo; Multímetro (continua, offset); VS+ (rojo); VS− (naranja); vin (azul); vo (verde)

Masa común (gris): fuente, generador, osciloscopio y multímetro comparten la referencia del montaje;
continuidad verificada con el multímetro antes de energizar. La masa de cada sonda va a esa referencia.

Figura 63: Conexiones del laboratorio: alimentación partida (rojo y naranja), señal de entrada (azul), salidas hacia el osciloscopio y el multímetro (verde) y masa común (gris). Cada pin de alimentación del operacional lleva un condensador de 100 nF. El circuito del operacional es el de la Figura 59.

Guía de laboratorio

Práctica A, escalón en el seguidor (G = +1). Generador de onda cuadrada de 10 kHz de 0 a 2 V (alta impedancia) y después de 0 a 0,1 V. Medir primero el tiempo de subida del propio generador, sin el montaje. Medir en CH2 el tiempo de subida 10–90 % con cursores. Práctica B, respuesta en frecuencia (G = +11). Seno de 20 mV pico a pico (10 mV de pico, de modo que la salida de 110 mV de pico no esté limitada por pendiente en el rango). Frecuencias del Cuadro 5. Medir con CH1 y CH2 la amplitud de entrada y salida en cada punto, calcular la ganancia en dB y buscar la frecuencia a la que cae 3 dB respecto de la ganancia en 1 kHz.

Práctica C, saturación (G = +11). Seno de 1 kHz; aumentar la amplitud de entrada desde 0,1 V de pico hasta observar el recorte. Anotar la amplitud de entrada a la que empieza y los niveles de recorte positivo y negativo. Si el generador no alcanza la amplitud necesaria, anotarlo.
Práctica D, offset en continua (G = +101). Entrada no inversora al común, nada más. Medir vo con el multímetro en continua. Repetir, si hay varios ejemplares, con al menos tres de cada tipo.

### 28.3. Predicciones por modelo (sin mediciones)

Los valores del Cuadro 5 se calcularon en clase3_laboratorio_lm358_tl081.ipynb con modelo de un polo, GBW y SR del Cuadro 4; son predicciones por modelo, no resultados.

Cuadro 5: Ganancia predicha para G = +11 (modelo de un polo, 20 mV pico a pico a la entrada). La columna «Medición» se deja vacía.

f (kHz) | LM358B predicho (dB) | TL08xC predicho (dB) | Medición LM358 (dB) | Medición TL081 (dB)
1 | 20,83 | 20,83
10 | 20,79 | 20,83
50 | 20,00 | 20,78
100 | 18,18 | 20,64
200 | 14,43 | 20,13
500 | 7,40 | 17,61
1000 | 1,53 | 13,51

Con 20 mV pico a pico, la salida es de 110 mV de pico y el LM358B no entra en límite de pendiente hasta unos 723 kHz (f = SR/2πVp), por lo que en los puntos de 1 MHz puede haber algo de deformación. La Figura 64 resume las curvas y la Figura 65 el escalón del seguidor.

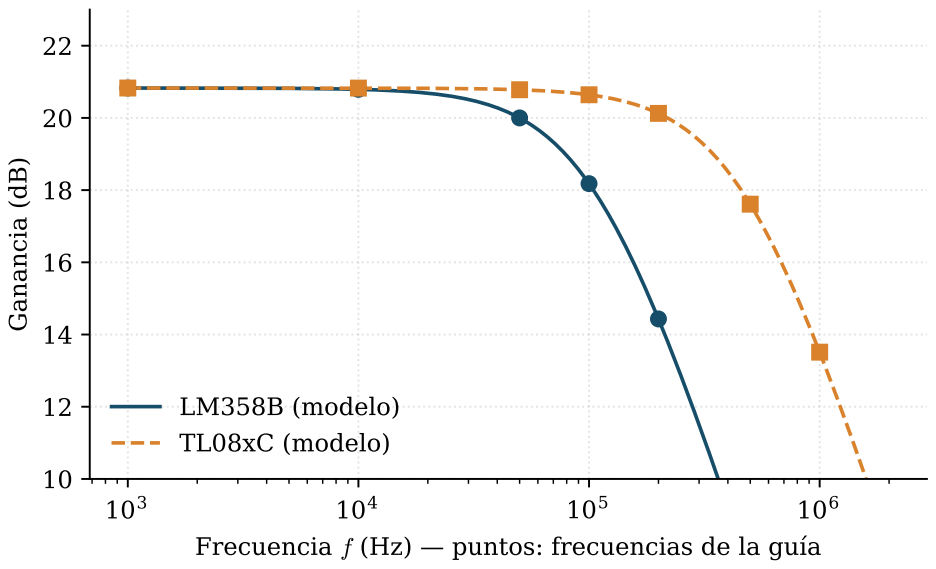
[picture p56: figure]
Ganancia (dB); LM358B (modelo) TL08xC (modelo)

## Frecuencia f (Hz) — puntos: frecuencias de la guía

Figura 64: Predicción de la ganancia de la práctica B (modelo de un polo); los puntos marcan las frecuencias de la guía. Debe observarse la separación entre dispositivos a partir de 100 kHz. Simulación por modelo, no medición.

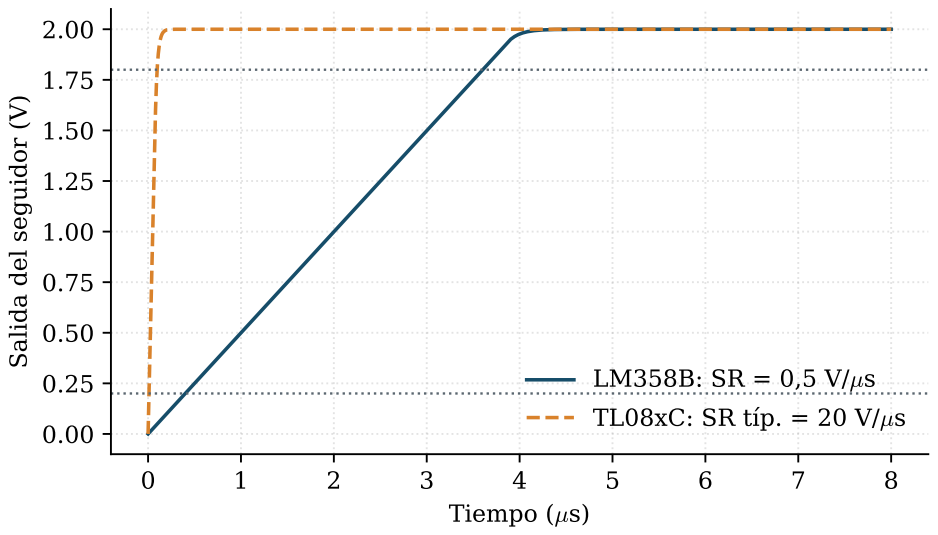
[picture p57: figure]
Tiempo (¹s); Salida del seguidor (V); LM358B: SR = 0,5 V/¹s TL08xC: SR típ. = 20 V/¹s

Figura 65: Predicción del escalón de 2 V en el seguidor: rampa de pendiente SR y cola exponencial de constante 1/(2π GBW); valores típicos de la hoja de datos. Debe observarse que el LM358B tarda unos 3,2 µs en pasar del 10 al 90 % y el TL08xC menos de 0,2 µs. Modelo, no medición.

### 28.4. Ejemplo S07-3-A Predicción del escalón del seguidor

Enunciado. Predecir el tiempo de subida 10–90 % del seguidor con escalón de 2 V y de 0,1 V para ambos dispositivos.
Datos y supuestos. SR típ.: 0,5 V/µs (LM358B) y 20 V/µs, mín. 8 V/µs (TL08xC); GBW 1,2 MHz y 5,25 MHz. Modelo: gran señal limitada por pendiente; pequeña señal de un polo con tr ≈ 0,35/GBW (G = 1, fc = GBW).

Método. Primero se decide qué límite manda comparando la pendiente que exige la señal con SR.

t10–90 =

0,8 (2 V)
SR | : | LM358B 3,2 µs, | TL08xC 80 ns (típ.), 200 ns (mín.), | (137)

tr(0,1 V) = 0,35
GBW : | | LM358B 292 ns, | TL08xC 67 ns. | (138)

Interpretación. Con 2 V el LM358B está dominado por el slew rate; con 0,1 V, por GBW. Los tiempos del TL08xC son comparables con el tiempo de subida del generador y de la sonda, de modo que la medición puede estar limitada por los instrumentos; por eso se mide primero el generador. Comprobación independiente. La simulación del modelo (rampa más exponencial) del notebook da 3,20 µs para el LM358B.

### 28.5. Ejemplo S07-3-B Predicción de saturación y offset

Enunciado. Con G = +11, predecir la amplitud de entrada a la que se recorta la salida en LM358B (±5 V) y TL08xC (±15 V), y el máximo offset de salida con G = +101.

Datos y supuestos. Techo del LM358B garantizado 5 − 1,48 = 3,52 V; TL08xC con RL = 10 kΩ: VOM mín. 12 V, típ. 13,5 V. VOS y IB máximos del Cuadro 4.

vin,LM358B =

3,52
11
= 0,32 V, | vin,TL08xC =

12
11

a

13,5
11
= 1,09 V a 1,23 V, | (139)
|vo|offset ≤ 101VOS + IBRf : 306,5 mV (LM358B), | (140)
732 mV (LM358 anterior), 1,010 V (TL08xC). | (141)

Interpretación. Son cotas de peor caso; un ejemplar típico mostrará menos offset (típicos de VOS 0,3 mV y 3 mV darían del orden de 30 mV y 300 mV), y una medición dentro de la cota es compatible con la hoja pero no la valida. Comprobación independiente. El cálculo se reproduce en el notebook y coincide con S07-2-A.

### 28.6. Tablas de resultados (vacías: las llena el estudiante)

Magnitud | Predicción | Simulación | Medición | Diferencia

t10–90 seguidor 2 V, LM358
t10–90 seguidor 2 V, TL081
t10–90 seguidor 0,1 V, LM358
t10–90 seguidor 0,1 V, TL081
f−3 dB con G = +11, LM358
f−3 dB con G = +11, TL081
Recorte positivo, LM358 / TL081
Recorte negativo, LM358 / TL081
Amplitud de entrada al inicio del recorte
Offset de salida, G = +101, LM358 (ejemplares 1–3)
Offset de salida, G = +101, TL081 (ejemplares 1–3)

Registrar además fabricante y sufijo de cada ejemplar, instrumentos, ajuste del generador (alta impedancia), sondas y condiciones. Cada columna lleva su origen: predicción por modelo, simulación (si el docente la solicita; rotularla como tal) o medición. Clasificar cada diferencia como instrumento, tolerancia de las resistencias, parámetro de otra variante, montaje o modelo.

### 28.7. Ejercicios

S07-3-E1. Con resistencias al 1 % en el montaje de G = +11 (Rf = 10 kΩ, Rg = 1 kΩ), hallar el intervalo de G y de la ganancia en dB. ¿Explica esa tolerancia por sí sola una diferencia de 0,5 dB a 1 kHz?

S07-3-E2. Si se usa una entrada de 100 mV pico a pico en lugar de 20 mV en la práctica B, ¿a partir de qué frecuencia limita la pendiente al LM358B y al TL08xC (con SR mínimo)? Compararla con fc.

Pregunta conceptual. ¿Por qué un TL08xC tiene menor corriente de polarización garantizada que un LM358B y, sin embargo, puede mostrar mayor offset de salida en el montaje de G = +101?

### 28.8. Errores frecuentes y comprobaciones

Error frecuente

Energizar sin medir polaridad y tensión de alimentación, o sin el desacoplo de 100 nF.

Dejar el generador con salida a 50 Ω cuando la carga es de alta impedancia (la amplitud real es el doble de la mostrada).

Conectar la masa de la sonda a un nodo que no es la referencia.

Medir un tiempo de subida del TL081 sin comprobar antes el del generador y de la sonda.

Aplicar un valor de la hoja de datos de otra variante o fabricante al ejemplar del banco.

Presentar la predicción por modelo como si fuera una medición.

### 28.9. Conexión con el curso y el proyecto

La tabla de comparación es la evidencia de selección del operacional para el acondicionamiento del proyecto: debe incluir variante, condiciones, predicción, medición y decisión justificada. En la semana 8 se medirán el inversor y el no inversor con la elección hecha aquí.

### 29. Código y recursos de la semana

Código de la semana 7

Python (codigo/python/semana_07/, ejecutados con salidas guardadas):

clase1_modelo_ideal.ipynb: ganancia finita y error (S07-1-A), límites de salida y de entrada (S07-1-B), soluciones de S07-1-E1 y E2; genera transferencia_sat.

clase2_parametros_reales.ipynb: offset (S07-2-A), GBW y slew rate (S07-2-B), CMRR, soluciones de S07-2-E1 y E2; genera bode_g11 y amplitud_vs_frecuencia.

clase3_laboratorio_lm358_tl081.ipynb: predicciones del laboratorio (tabla de ganancias, escalón del seguidor, saturación, offset), soluciones de S07-3-E1 y E2; genera pred_ganancia_lab y pred_escalon_seguidor. No contiene mediciones.
MATLAB (no ejecutados en este entorno), en codigo/matlab/semana_07/:

clase1_modelo_ideal.m

clase2_parametros_reales.m

clase3_laboratorio_lm358_tl081.m Equivalentes a los notebooks con los mismos datos.

### 30. Referencias de la semana

1. Texas Instruments, Industry-Standard Dual Operational Amplifiers
(LM358, LM358B, LM358BA, LM358A, LM258, LM158, LM2904 y variantes). Secciones usadas: 4, 5.3, 5.5 y 5.7, hoja de datos SLOS068AB, junio de 1976, revisada en octubre de 2024. https://www.ti.com/lit/ds/symlink/lm358.pdf. Consultada el 2026-11-03.
2. Texas Instruments, TL08xx FET-Input Operational Amplifiers (TL081, TL082, TL084 y variantes), hoja de datos SLOS081O, febrero de 1977, revisada en septiembre de 2025. https://www.ti.com/lit/ds/symlink/tl081.pdf. Consultada el 2026-11-03. Secciones usadas: 4, 5.3, 5.8 y 5.9.
3. J. R. Ragazzini, R. H. Randall y F. A. Russell, «Analysis of Problems in Dynamics by Electronic Circuits», Proceedings of the IRE, vol. 35, n.º 5, pp. 444–452, 1947. Registro bibliográfico: https://bvbvf1.bib-bvb.de/vufind/PrimoRecord/cdi_ieee_primary_1697371. Consultado el 2026-11-03 (solo datos de publicación; el contenido no se citó del texto original).

### Parte VIII

# Semana 8: Configuraciones básicas del amplificador operacional

### 31. S08-1 Amplificador inversor

Resultados, prerrequisitos y distribución

Al terminar, el estudiante podrá (1) obtener la ganancia, la impedancia de entrada y la excursión de salida de un amplificador inversor, indicando cuándo vale el cortocircuito virtual; (2) estimar el ancho de banda, el límite por slew rate y el margen de saturación con alimentación dual o simple;
(3) dimensionar el desacoplo y la referencia de una etapa. Se comprueba al final con S08-1-E1 y S08-1-E2.
Prerrequisitos: modelo ideal y real del operacional, saturación y datos de hoja de datos (semana 5 del plan de clases), KCL y divisores (semana 1) y respuesta en frecuencia de primer orden (semanas 3 y 4).

Distribución propuesta de 120 minutos

Diagnóstico, 10 min (¿qué fija la tensión del nodo inversor?, sin calificar). Explicación del modelo y de la deducción, 30 min. Ejemplos guiados, 30 min. Práctica de los ejercicios, 35 min. Cierre y errores frecuentes, 15 min. Antes de la clase el estudiante repasa los parámetros GBW, SR y saturación de una hoja de datos y prepara el archivo de simulación del jueves; ese trabajo previo no cuenta como tiempo presencial.

### 31.1. Concepto físico y modelo

Un operacional es una fuente de tensión controlada por la diferencia v+ − v−. Con A la ganancia diferencial (símbolo para la ganancia de lazo abierto) y vo la tensión de salida,

vo = A (v+ − v−), | |vo| ≤ Vsat. | (142)

Vsat es la excursión máxima de salida. Depende de la alimentación: en este curso se declara un operacional hipotético (datos del ejercicio, no de un dispositivo comercial) con A0 = 10⁵
| | en
continua, producto ganancia-ancho de banda GBW = 1 MHz, slew rate SR = 0,5 V/µs, resistencia de salida en lazo abierto Ro = 100 Ω, salida que llega hasta 1,5 V de cada riel y rango de modo común hasta 2 V de cada riel. Para el montaje real los valores salen de la hoja de datos del dispositivo y la revisión elegidos.

Cortocircuito virtual. Si hay realimentación negativa (una parte de vo vuelve a la entrada inversora) y el amplificador trabaja en régimen lineal (|vo| < Vsat), entonces v+ − v− = vo/A es muy pequeña y se aproxima v− ≈ v+. Con las corrientes de entrada despreciables, i+ ≈ i− ≈ 0. Fuera de esas hipótesis (saturación, lazo abierto, realimentación positiva) el cortocircuito virtual no es válido.

Amplificador inversor. En la Figura 66, v+ = 0, por lo que v− ≈ 0 (tierra virtual) y la KCL en el nodo v−, con i− = 0, da ig = if :

vi − v−
Rg

=

v− − vo
Rf

⇒ Av =

| vo vi = −

Rf
Rg
. | (143)

Se define G = Rf /Rg. El signo negativo es un desfase de 180◦ para señales sinusoidales.

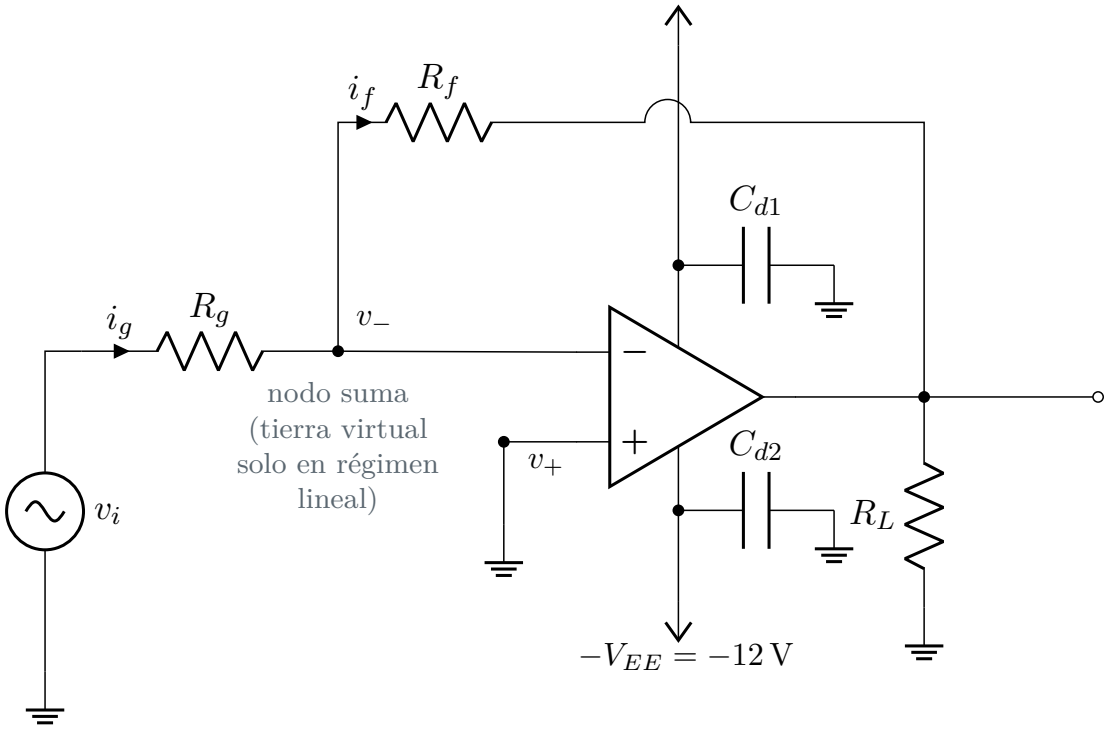
[picture p58: figure]
nodo suma (tierra virtual solo en régimen lineal); −VEE = −12 V

vo

### +VCC = +12 V

Cd1 = Cd2 = 100 nF cerámicos junto a los pines de alimentación. El arco sobre el cable de alimentación indica cruce sin conexión.

Figura 66: Inversor con alimentación dual ±12 V y desacoplo. vi
, v−, v+ y vo se miden respecto de tierra; ig e if son las corrientes de Rg y Rf . Con realimentación negativa y régimen lineal, v− ≈ 0.

Efecto de la ganancia finita. Sin aproximar v− = 0, de (142) con v+ = 0 se tiene v− = −vo/A y la KCL da

Av = −

G

1 +

1 + G
A

, Rin =

vi
ig

= Rg +

Rf
1 + A
≈ Rg. | (144)

1 + G es la ganancia de ruido: es la ganancia con que la etapa amplifica una perturbación aplicada a la entrada no inversora y fija el ancho de banda. La impedancia de entrada es Rg porque el nodo inversor está casi a tierra: la fuente ve a Rg conectada a una tierra virtual. Por eso la fuente de entrada debe poder entregar vi/Rg.

Impedancia de salida. La realimentación reduce Ro a

Rout ≈

Ro
1 + Aβ , β =

Rg
Rg + Rf
. | (145)

Es una aproximación de primer orden, válida mientras Ro sea la única resistencia en serie con la salida y la carga no la comparta. Como A cae con la frecuencia, Rout crece y se acerca a Ro cerca de GBW.

Ancho de banda, slew rate y saturación. Con un polo dominante, A(j2πf) = A0/(1 + jf /fp) y GBW = A0fp. La etapa tiene frecuencia de corte

fc =

GBW
1 + G
. | (146)

Para señal grande interviene SR: la salida vo = Vp sin(2πf t) tiene pendiente máxima 2πfVp, que debe ser menor que SR:

f ≤ fSR =

SR
2πVp
. | (147)

La entrada máxima sin saturar es |vi

| ≤ Vsat/G, con Vsat = VCC − 1,5 V para el operacional declarado.

−1.5 | −1.0 | −0.5 | 0.0 | 0.5 | 1.0 | 1.5
| | | vi (V)

−15

−10

−5

0

5

10

15

vo (V)

jvij = 1;05 V

ideal sin límite
con saturación §10;5 V
régimen lineal

Figura 67: Característica vo(vi) del inversor con Rf /Rg = 10 y ±12 V (calculada en el notebook de la clase). Fuera de |vi

| = 1,05 V la salida queda en ±10,5 V y el cortocircuito virtual deja de valer.

Debe observarse que la recta de pendiente −10 solo existe dentro de la zona sombreada; el estudiante comprobará que (143) no describe los tramos planos.

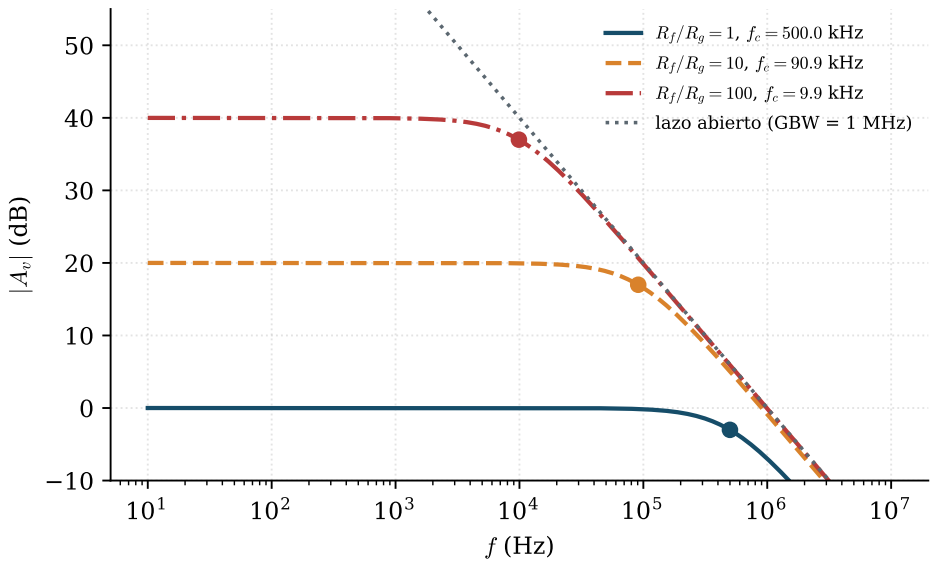
[picture p59: figure]
jAvj (d; = 500:0 kHz; = 90:9 kHz; Rf=Rg = 100, fc = 9:9 kHz lazo abierto (GBW = 1 MHz)

Figura 68: Magnitud del inversor para Rf /Rg = 1, 10 y 100 con GBW = 1 MHz (modelo de un polo, cálculo). Los círculos marcan fc = GBW/(1 + G), a −3 dB de la ganancia de baja frecuencia.

Debe observarse que, al aumentar G, las curvas se separan de la recta de lazo abierto cada vez antes: el producto G fc es constante.

Alimentación dual y simple. Con alimentación dual (±12 V, Figura 66) la tierra es el punto medio y vo puede ser de ambos signos. Con alimentación simple (VCC = 5 V, Figura 69) la señal debe centrarse en Vref = VCC/2 obtenida con un divisor; el nodo inversor ya no está a 0 V sino a

Vref y

vo = Vref − G (vi − Vref ). | (148)

Siempre se declara la alimentación y se verifica que Vref cumpla el rango de modo común. Cada pin de alimentación lleva un condensador cerámico de 100 nF lo más cerca posible, que entrega las corrientes rápidas de la salida y evita realimentación por el cableado de alimentación; Cref filtra el ruido de la referencia.

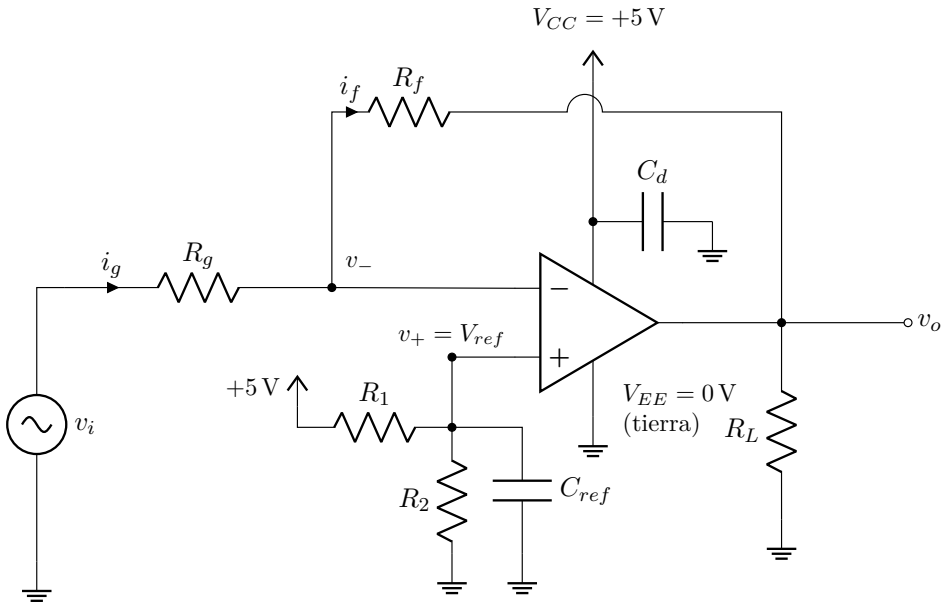
[picture p60: figure]
v+ = Vref; Cref; VCC = +5 V; VEE = 0 V (tierra)

R1 = R2 = 10 kΩ, Cref = 10 µF, Cd = 100 nF. La señal vi se mide respecto de tierra y está centrada en Vref . El arco indica cruce sin conexión.

Figura 69: Inversor con alimentación simple de 5 V. El divisor R1–R2 fija Vref = 2,5 V en la entrada +. La salida se mide respecto de tierra y el pin negativo del operacional va a tierra.

### 31.2. Ejemplo S08-1-A Inversor de ganancia −4,7

Enunciado. En la Figura 66, Rg = 10 kΩ, Rf = 47 kΩ, alimentación ±12 V y vi = 1 V continua. Hallar vo, ig, Rin y verificar el balance de potencia. Repetir con una fuente de resistencia interna Rs = 1 kΩ en serie.
Datos y supuestos. Operacional hipotético, A0 = 10⁵
; carga infinita; régimen lineal (|vo| < 10,5 V) con realimentación negativa. Incógnitas: vo, ig, Rin.

Método. Cortocircuito virtual y KCL en v−: es válido porque hay realimentación negativa y se comprobará que |vo| < Vsat.

ig =

vi − 0
Rg

=

1
10 000
= 0,1 mA, | (149)

vo = −Rf if = −Rf ig = −(47 000)(10⁻⁴
) = −4,7 V. | (150)

La impedancia de entrada es Rin = Rg + Rf /(1 + A) = 10 000,47 Ω ≈ 10 kΩ. Con Rs en serie, Rg efectiva es Rs + Rg y Av = −47/11 = −4,273, de modo que vo = −4,27 V.

Interpretación. La fuente debe suministrar 0,1 mA; una resistencia interna del 10 % de Rg reduce la ganancia 9 %.

Comprobación independiente (potencia). La fuente entrega viig = 100 µW, que disipa Rg (i

2
gRg = 100 µW). Rf disipa i

2
fRf = 470 µW, que entrega la salida del operacional (vo negativa con corriente if entrando por la salida): 4,7 V · 0,1 mA = 470 µW. La suma de potencias con signo es cero (sin contar el consumo propio de alimentación).

### 31.3. Ejemplo S08-1-B Límites por ancho de banda, slew rate y saturación

Enunciado. Un inversor con Rg = 10 kΩ, Rf = 200 kΩ (G = 20) y ±12 V debe entregar Vp = 8 V de pico. Hallar el error de ganancia en continua, la entrada máxima sin saturar, fc, fSR y cuál límite domina.

Datos y supuestos. A0 = 10⁵
, GBW = 1 MHz, SR = 0,5 V/µs, Vsat = 10,5 V. Un polo dominante.

Método. Se emplean (144), (146) y (147): cada una nombra un límite distinto.

Av = −

20
1 + 21/10⁵
= −19,9958 (error 0,021 %), | (151)

|vi

|m´ax =

10,5
20

= 0,525 V, fc =

10⁶
21
= 47,6 kHz, | (152)

fSR =

0,5 × 10⁶
2π · 8
= 9,95 kHz. | (153)

La amplitud de entrada necesaria es 8/20 = 0,4 V < 0,525 V: no satura. A fSR la ganancia del polo dominante es 1/

p
1 + (fSR/fc)

2 = 0,979, es decir 2,1 % menos.

Interpretación. Con 8 V de pico el límite que domina es el slew rate (9,95 kHz), mucho antes que el ancho de banda de pequeña señal (47,6 kHz). Con 1 V de pico fSR = 79,6 kHz y domina fc. La Figura 70 muestra la señal a 5 kHz (sin distorsión visible) y a 20 kHz (triangular, pendiente 0,5 V/µs).

Comprobación independiente. Sustituir A en la KCL original: con vi = 1 V, v− = −vo/A da residuo nulo (verificado numéricamente en el notebook). La simulación del modelo con límite de pendiente da una pendiente máxima de 0,500 V/µs a 20 kHz (simulación del modelo, no medición).

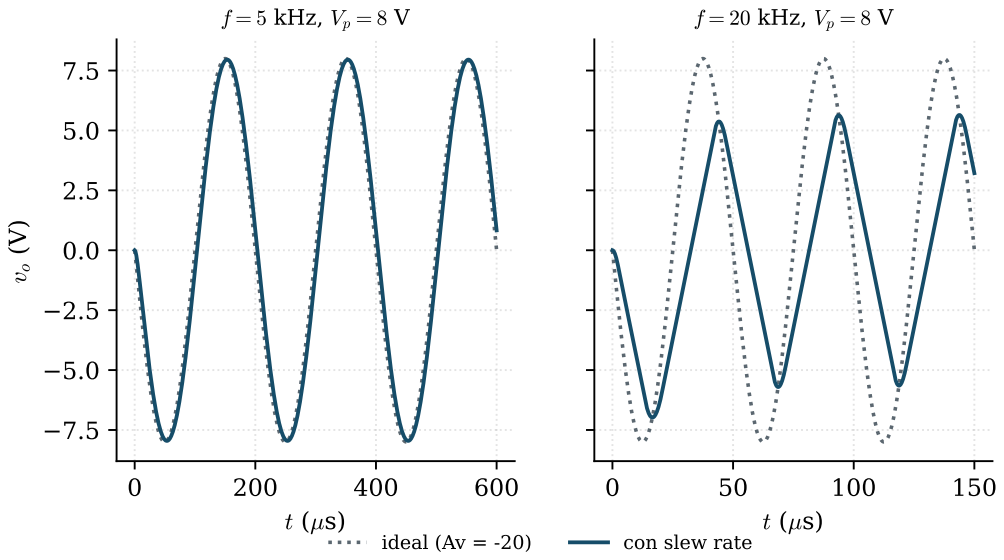
[picture p61: figure]
f = 5 kHz, Vp = 8 V; f = 20 kHz, Vp = 8 V; ideal (Av = -20); con slew rate

Figura 70: Salida del inversor de ganancia −20 con Vp = 8 V (simulación del modelo con límite de pendiente). A 5 kHz la pendiente máxima ideal (0,25 V/µs) está por debajo de SR; a 20 kHz (1,0 V/µs) la salida se vuelve triangular y su amplitud cae.

### 31.4. Ejercicios

S08-1-E1 (diseño con alimentación dual). Se necesita un inversor de ganancia −10 con Rin = 22 kΩ y alimentación ±12 V (operacional declarado). Hallar Rg y Rf , la amplitud máxima de entrada sin saturar, la frecuencia de corte y la corriente que pide a la fuente con vi = 1 V. Comprobar que v− es despreciable en el límite de saturación.

S08-1-E2 (alimentación simple). Con VCC = 5 V, Vref = 2,5 V, Rg = 10 kΩ y Rf = 20 kΩ, hallar vo(vi), el intervalo permitido de vi (salida entre 1,5 V y 3,5 V) y la amplitud máxima de señal alrededor de Vref . Verificar que Vref cumple el rango de modo común.

Pregunta conceptual. Un estudiante retira Rf del inversor de la Figura 66 y mide la salida con vi = 10 mV. ¿Qué espera medir y por qué no puede usar el cortocircuito virtual?

### 31.5. Errores frecuentes y comprobaciones

Error frecuente

Aplicar v− = 0 cuando el operacional satura o el lazo está abierto.

Olvidar que Rin = Rg (no es alta) y no incluir la resistencia interna de la fuente.

Dimensionar solo con fc y olvidar el slew rate para señales grandes.

Con alimentación simple, centrar mal la señal o ignorar que el nodo inversor está en Vref , no en 0 V.

Omitir el desacoplo de cada pin de alimentación.

Comprobación mínima: signo de vo, |vo| < Vsat y |G| · fc ≈ GBW.

### 31.6. Conexión con el proyecto

En el proyecto, la salida de un sensor de baja amplitud se acondicionará con un inversor o no inversor. El equipo documentará la alimentación elegida, el margen de saturación, la corriente que pide a la fuente de señal y el desacoplo. Para el jueves, preparar la simulación del inversor de G = −4,7 y registrar vi y vo; las capturas se rotularán como simulación.

### 32. S08-2 Amplificador no inversor y seguidor de tensión

Resultados, prerrequisitos y distribución

Al terminar, el estudiante podrá (1) obtener ganancia, impedancia de entrada y de salida del no inversor y del seguidor; (2) verificar el rango de modo común, la saturación, el ancho de banda y el slew rate; (3) decidir cuándo un seguidor evita el efecto de carga sobre una fuente de alta impedancia. Se comprueba al final con S08-2-E1 y S08-2-E2.
Prerrequisitos: S08-1 (modelo, cortocircuito virtual, fc = GBW/(1 + G), fSR) y divisores de Thévenin (semana 1). Se usa el mismo operacional hipotético de S08-1.

Distribución propuesta de 120 minutos

Diagnóstico, 10 min (¿qué gana un inversor de G = 1 frente a un seguidor?). Explicación y deducción, 25 min. Ejemplos guiados, 30 min. Práctica de los ejercicios, 40 min. Cierre y errores frecuentes, 15 min. Trabajo previo: repasar S08-1 y calcular las predicciones del jueves; no cuenta como tiempo presencial.

### 32.1. Concepto físico y modelo

Amplificador no inversor. La señal entra por v+ y la realimentación β = Rg/(Rg + Rf ) lleva a v− una fracción de vo. Con realimentación negativa y régimen lineal, v− ≈ v+ = vi y el divisor Rf –Rg da v− = βvo:

Av =

vo
vi

=

1
β

= 1 +

Rf
Rg
= 1 + G. | (154)

La ganancia es positiva y mayor o igual que 1: no hay inversión de fase. Con A finita,

Av =

1 + G

1 +

1 + G
A

, fc =

GBW
1 + G
. | (155)

Esta vez la ganancia de ruido coincide con la ganancia de señal.

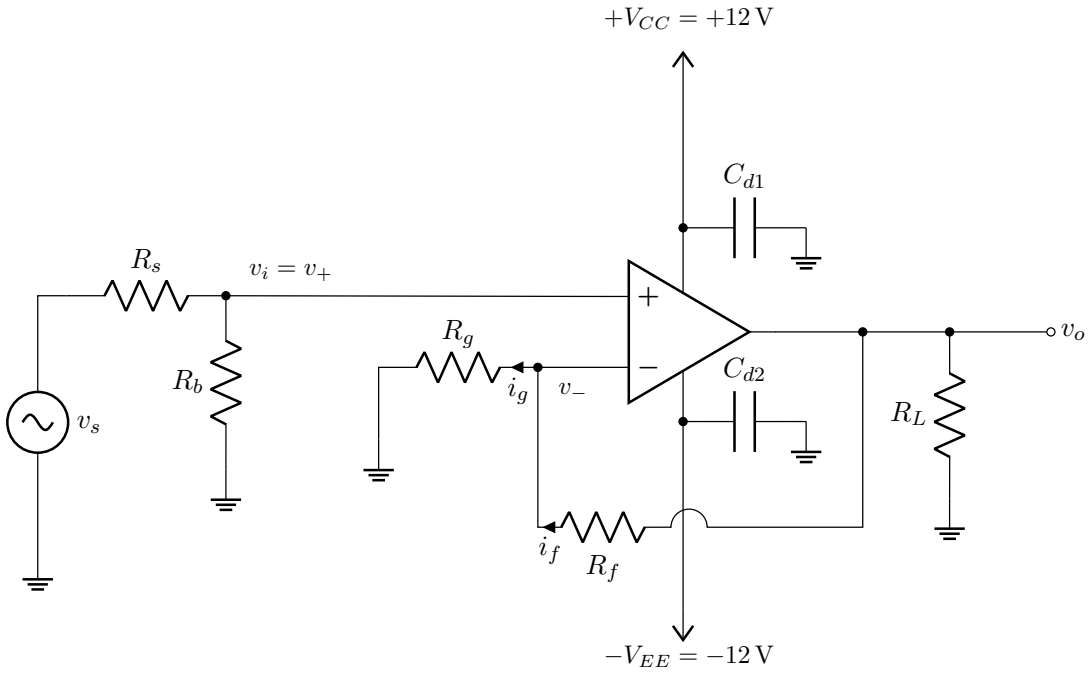
[picture p62: figure]
+VCC = +12 V; −VEE = −12 V

Rb = 1 MΩ fija la referencia de la entrada +. v− ≈ v+ solo con realimentación negativa en régimen lineal. Cd1 = Cd2 = 100 nF. El arco indica cruce sin conexión.

Figura 71: No inversor con alimentación dual ±12 V. Rs es la resistencia interna de la fuente y Rb fija la referencia de la entrada +. vi = v+ se mide respecto de tierra; v− ≈ v+ solo con realimentación negativa en régimen lineal.

Impedancias. La señal ve la entrada no inversora. La resistencia propia del operacional en esa entrada es del orden de megaohmios o más y, en la práctica, la impedancia de entrada la fija Rb en paralelo. Esta ventaja tiene una consecuencia: la corriente de polarización Ib circula por la resistencia de la fuente y produce un error IbRth. La salida tiene la Rout de (145) con β = 1/(1 +G): es mucho menor que Ro a baja frecuencia y crece con f.

Seguidor (buffer). Con Rf = 0 y Rg → ∞ (Figura 72) β = 1 y

Av = 1, | fc = GBW, | Rout ≈

Ro
1 + A
. | (156)

Copia la tensión pero cambia la impedancia: Rin grande y Rout pequeña. Es la configuración con β más alto y, por tanto, la más exigente en estabilidad con cargas capacitivas; la hoja de datos del dispositivo indica si es estable con ganancia unidad.

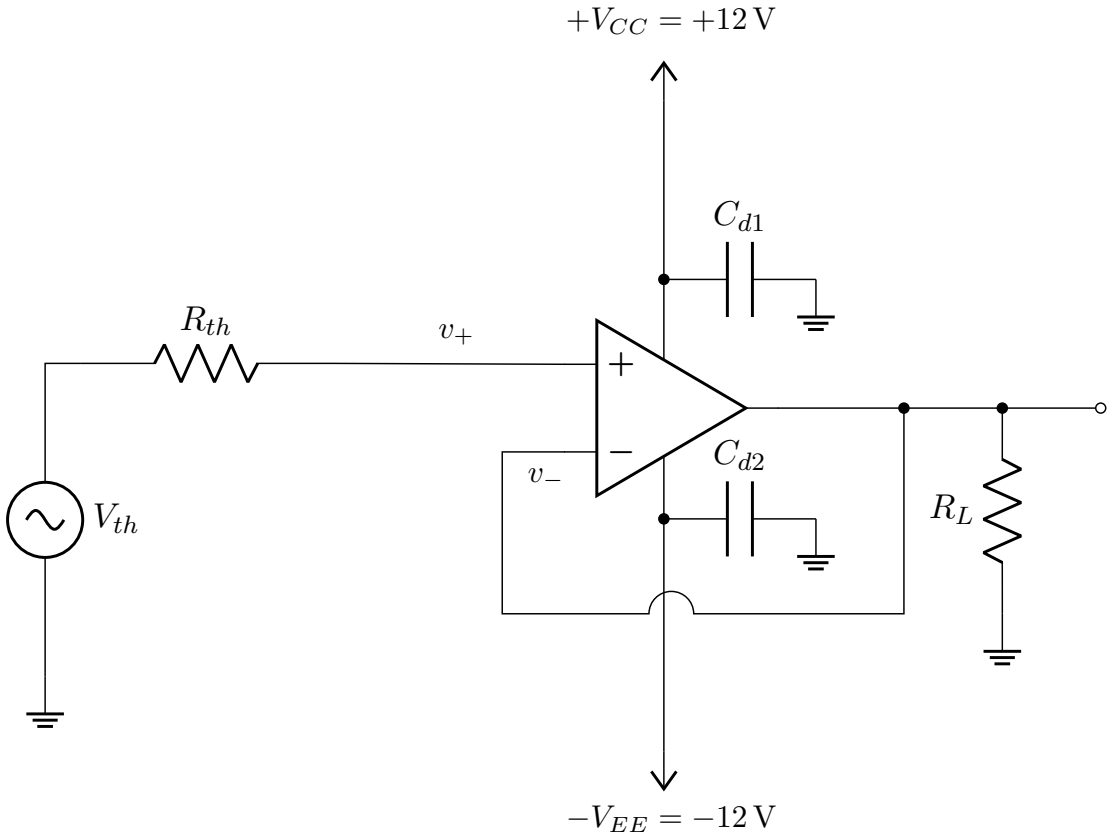
[picture p63: figure]
Vth; Rth; +VCC = +12 V; −VEE = −12 V

vo

Av = 1: vo ≈ v+ con realimentación negativa en régimen lineal.
El arco indica cruce sin conexión.

Figura 72: Seguidor de tensión alimentado por un sensor modelado como Vth en serie con Rth. Realimentación unitaria de la salida a la entrada −; vo ≈ v+ con realimentación negativa y régimen lineal.

Límites que no aparecen en Av. (i) La saturación: |vi

| ≤ Vsat/Av. (ii) El rango de modo común de entrada: en el seguidor y en el no inversor v+ recorre la excursión de la señal; con el operacional declarado |v+| ≤ 10 V con ±12 V, menor que Vsat. (iii) El slew rate (147) y (iv) la corriente de salida: la carga fija io = vo/RL, que no debe superar el límite de la hoja de datos. (v) La alimentación y el desacoplo se declaran igual que en S08-1.

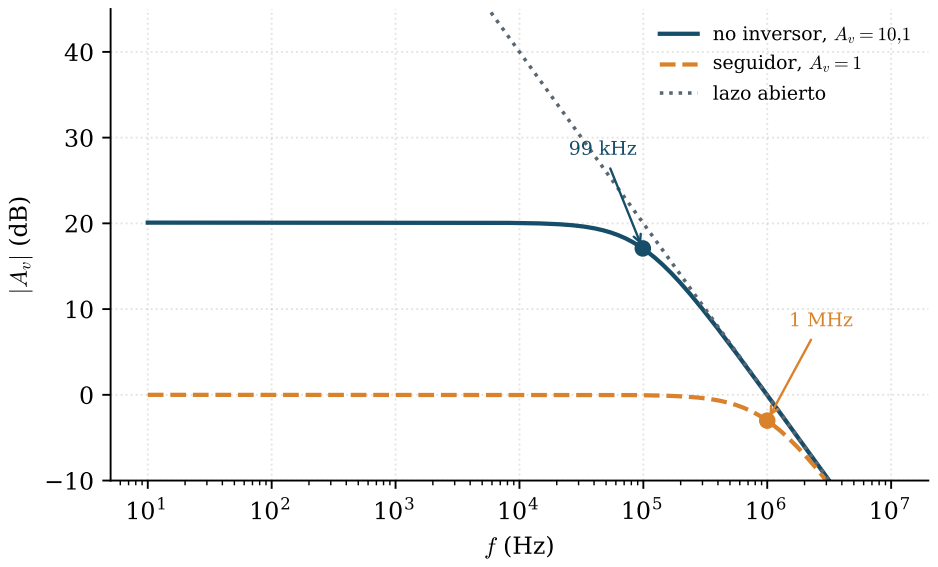
[picture p64: figure]
jAvj (d; 99 kHz; 1 MHz; no inversor, Av = 10;1 seguidor, Av = 1 lazo abierto

Figura 73: Magnitud del no inversor (Av = 10,1) y del seguidor con GBW = 1 MHz (modelo de un polo, cálculo). Los círculos marcan fc: 99 kHz y 1 MHz.

Debe observarse que el seguidor llega a fc = GBW y que ambas curvas terminan sobre la recta de lazo abierto.

### 32.2. Ejemplo S08-2-A No inversor de ganancia 10,1

Enunciado. En la Figura 71, Rg = 1 kΩ, Rf = 9,1 kΩ, ±12 V, Rb = 1 MΩ, Rs = 10 kΩ. Con vi = 0,5 V hallar vo, la caída en Rf , |vi

|m´ax, fc y el efecto de Rs con Rb.

Datos y supuestos. Operacional declarado; régimen lineal; vi es la tensión en v+ (después del divisor Rs–Rb). Incógnitas: vo, vRf

, |vi

|m´ax, fc.

Método. Cortocircuito virtual en v− y divisor Rg–Rf , porque hay realimentación negativa y se verificará |vo| < Vsat.

Av = 1 +

9100
1000
= 10,1, | vo = 10,1 · 0,5 = 5,05 V, | (157)

ig =

v−
Rg

=

0,5
1000
= 0,5 mA, | vRf = Rf ig = 4,55 V, | (158)

|vi

|m´ax =

10,5
10,1

= 1,040 V, fc =

10⁶
10,1
= 99,0 kHz. | (159)

La tensión v+ resulta de la fuente con Rs = 10 kΩ y Rb = 1 MΩ: v+ = vs Rb/(Rs + Rb) = 0,990 vs, una pérdida de 1 %.

Interpretación. El no inversor carga poco a la fuente: con Rb = 1 MΩ el error por carga es 1 %, contra la pérdida de 9 % que causaba Rs = 1 kΩ en el inversor del Ejemplo S08-1-A.

Comprobación independiente. KVL: vo = v− + vRf = 0,5 V + 4,55 V = 5,05 V. Con A finita,
(155) da |Av| = 10,099 a 10 Hz (diferencia de 0,01 % con 10,1).

### 32.3. Ejemplo S08-2-B Seguidor como separador de una fuente de alta impe-

dancia

Enunciado. Un sensor modelado por Vth = 2 V y Rth = 100 kΩ alimenta una carga RL = 1 kΩ. Comparar la tensión en la carga con conexión directa y con un seguidor (Figura 72); hallar la corriente de salida y el error por Ib = 50 nA (dato hipotético). Estimar Rout a 100 kHz.

Método. Divisor de tensión para la conexión directa y seguidor ideal para la separación, corregida

por IbRth y Rout.

vL,directo = Vth

RL

Rth + RL

= 2 ·

1
101
= 19,8 mV, | (160)

vo ≈ Vth − IbRth = 2 − (50 × 10⁻⁹
)(10⁵
) = 1,995 V, io =

vo
RL

= 1,995 mA. (161)

En continua Rout = Ro/(1 + A0) = 1,0 mΩ. A 100 kHz, con A = −j10 aproximadamente, Rout ≈ 100/|1 + A| = 9,95 Ω (Figura 74).

Interpretación. El seguidor eleva la tensión en la carga de 19,8 mV a casi 2 V: la carga ya no ve Rth. La corriente que pide la carga la entrega el operacional (2 mA, por debajo del límite de salida que indique la hoja de datos). Si RL se redujera a decenas de ohmios, la corriente podría exceder ese límite.

Comprobación independiente. Con el operacional, la corriente por Rth es solo Ib, así que la caída IbRth = 5 mV es el único error de entrada (0,25 %). La corriente de la fuente sin seguidor sería Vth/(Rth + RL) = 19,8 µA, 400 veces mayor que Ib.

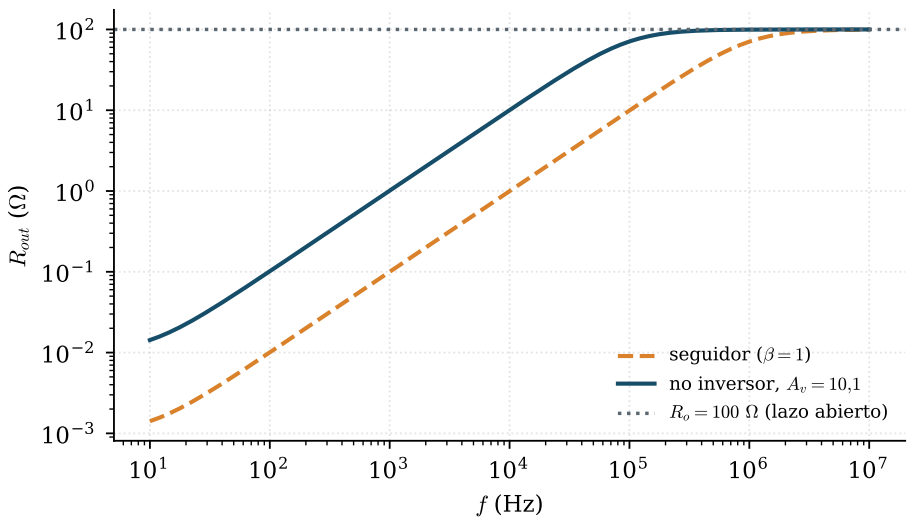
[picture p65: figure]
Rout (); seguidor (¯ = 1) no inversor, Av = 10;1 Ro = 100 (lazo abierto)

Figura 74: Resistencia de salida en lazo cerrado Ro/(1 + Aβ) del seguidor y del no inversor con Av = 10,1 (cálculo, Ro = 100 Ω). Crece con la frecuencia porque A disminuye.

Debe observarse que Rout crece a 20 dB/década y que tiende a Ro cuando Aβ se acerca a 1.

### 32.4. Ejercicios

S08-2-E1 (diseño no inversor). Con Rg = 2,2 kΩ se requiere Av = 6 con ±12 V. Hallar Rf , la entrada máxima sin saturar, fc y, con vi = 1,5 V de pico, la frecuencia máxima que el slew rate permite.
S08-2-E2 (seguidor). Una fuente de Vth = 1,2 V con Rth = 47 kΩ alimenta RL = 2,2 kΩ. Comparar la tensión en la carga con y sin seguidor, hallar la corriente de salida y el error de Ib = 50 nA.

Pregunta conceptual. Un seguidor alimentado con ±12 V recibe vi = 10,3 V en continua. La salida podría llegar a 10,5 V. ¿Es seguro asumir que vo = vi?

### 32.5. Errores frecuentes y comprobaciones

Error frecuente

Escribir Av = −1 − Rf /Rg o perder el uno: la ganancia del no inversor es 1 + Rf /Rg.

Olvidar que la entrada + necesita una referencia (Rb): una entrada flotante deriva y satura.

Suponer que el seguidor no tiene límites: dependen del modo común de entrada, de la corriente de salida y de la estabilidad con carga capacitiva.

Usar fc = GBW/G en lugar de GBW/(1 + G).

Ignorar IbRth con fuentes de alta impedancia.

### 32.6. Conexión con el proyecto

El seguidor separa un sensor de alta impedancia de la etapa siguiente o de un conversor A/D; el no inversor da la ganancia sin cargar al sensor. En el proyecto se documentarán Rth del sensor, Rin de la etapa y el error de carga calculado. La entrada de un ADC se trata en una semana posterior; no se conectará la salida de un comparador a un ADC sin justificarlo. Para el jueves, calcular y llevar las predicciones de S08-3.

### 33. S08-3 Laboratorio: montaje y verificación experimental de las configuraciones básicas

Resultados, prerrequisitos y distribución

Al terminar, el estudiante podrá (1) montar con seguridad un inversor, un no inversor y un seguidor con alimentación dual declarada y desacoplo; (2) medir ganancia, desfase, ancho de banda, saturación y slew rate y compararlos con la predicción; (3) explicar las discrepancias por tolerancias, instrumentos y parámetros del dispositivo real. Se comprueba con la tabla de resultados y con S08-3-E1 y S08-3-E2.

Prerrequisitos: S08-1 y S08-2. Trabajo previo: elegir el operacional con el docente, leer su hoja de datos (pines, GBW, SR, saturación, modo común), calcular las predicciones y preparar la simulación. No se incluyen mediciones: todos los espacios de las tablas los llena el estudiante.

Distribución propuesta de 120 minutos

Seguridad y verificación de la alimentación, 10 min. Montaje y medición en continua del inversor, 25 min. Respuesta en frecuencia, saturación y slew rate, 30 min. No inversor y seguidor, 30 min. Comparación teoría–simulación–medición y cierre, 25 min. Si el tiempo no alcanza, el docente asigna el seguidor a una sesión posterior; ese cambio se registra en el informe.

Práctica S08-3: configuraciones básicas

Seguridad. Solo baja tensión aislada: fuente de laboratorio con salidas flotantes y ±12 V como máximo; no hay conexión con la red. (1) Ajustar y comprobar con el multímetro cada canal antes de conectar la placa (Figura 75). (2) Fijar el límite de corriente de la fuente en un valor bajo acordado con el docente. (3) Verificar el pinout y la polaridad en la hoja de datos del encapsulado antes de energizar; una alimentación invertida destruye el integrado. (4) Conectar la masa de las sondas del osciloscopio y del generador solo al nodo de tierra común del montaje, nunca a +VCC, −VEE ni a la salida. (5) Quitar la señal antes de apagar la alimentación y apagar con las cargas conectadas solo si el docente lo permite.
(6) Condensadores electrolíticos: respetar su polaridad.
Equipo. Fuente doble aislada, generador de funciones, osciloscopio con sondas ×10, multímetro, protoboard, operacional elegido (con familia y revisión anotadas), resistencias del 1 %, Rgen según el manual del generador, condensadores de 100 nF cerámicos y de 10 µF electrolíticos.

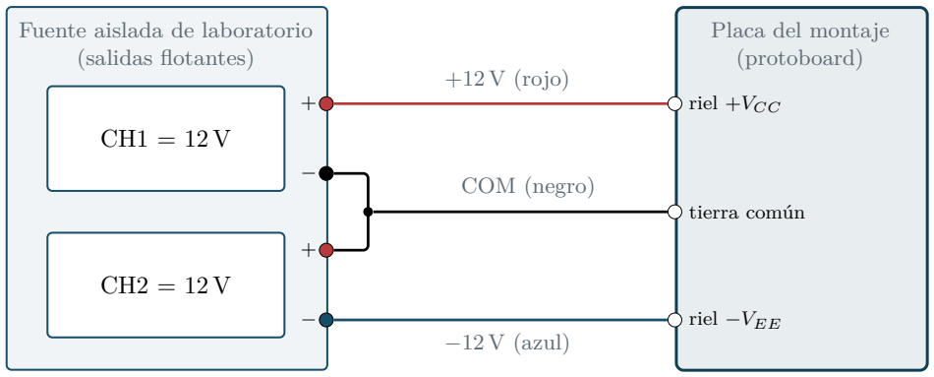
[picture p66: figure]
Fuente aislada de laboratorio (salidas flotantes); Placa del montaje (protoboard); riel +VCC; tierra común; riel −VEE; +12 V (rojo); COM (negro); −12 V (azul)

Cada canal se ajusta y se verifica con el multímetro antes de conectarlo a la placa. En la placa: 10 µF entre cada riel y tierra y 100 nF junto al integrado. Las cargas del montaje no superan los límites de corriente fijados en la fuente.

Figura 75: Conexión de la alimentación dual. Los dos canales de la fuente aislada se ponen en serie; la unión de − de CH1 con + de CH2 es la tierra común (COM) del montaje. Rojo: +VCC; azul: −VEE; negro: tierra.

### 33.1. Ejemplo S08-3-A Predicción del inversor y de su tolerancia

Enunciado. Para el montaje de la Figura 76 (Rg = 10 kΩ, Rf = 47 kΩ, resistencias del 1 %, ±12 V, vi de 0,5 V de pico a 1 kHz) predecir la ganancia con su intervalo, vo, fc, fSR y el efecto de Rgen = 50 Ω.
Datos y supuestos. Operacional declarado en S08-1 (los valores del dispositivo real los dará su hoja de datos). Régimen lineal, realimentación negativa.

Método. (143) con cotas de tolerancia extremas, (146) y (147).

G =

47
10

= 4,7, Gm´ın =

47 · 0,99
10 · 1,01

= 4,607, Gm´ax =

47 · 1,01
10 · 0,99
= 4,795, | (162)
Vo,p = 4,7 · 0,5 = 2,35 V, | fc =

10⁶
5,7

= 175,4 kHz, fSR =

0,5 × 10⁶
2π · 2,35

= 33,9 kHz. (163)

Con Rgen = 50 Ω en serie, Rg efectiva es 10,05 kΩ: G = 4,677 (0,5 % menos). A 1 kHz el desfase del modelo es −180,3

◦
respecto de la entrada (equivalente a +179,7

◦
: inversión de 180° más 0,3° de retardo por el polo).

Interpretación. Una ganancia medida entre 4,61 y 4,80 es compatible con las tolerancias; fuera de ese intervalo revisar Rgen, la sonda y el montaje. La amplitud de 2,35 V deja margen frente a 10,5 V.

Comprobación independiente. El notebook de la clase da los mismos valores (cálculo numérico) y el límite Rgen → 0 recupera G = 4,7.

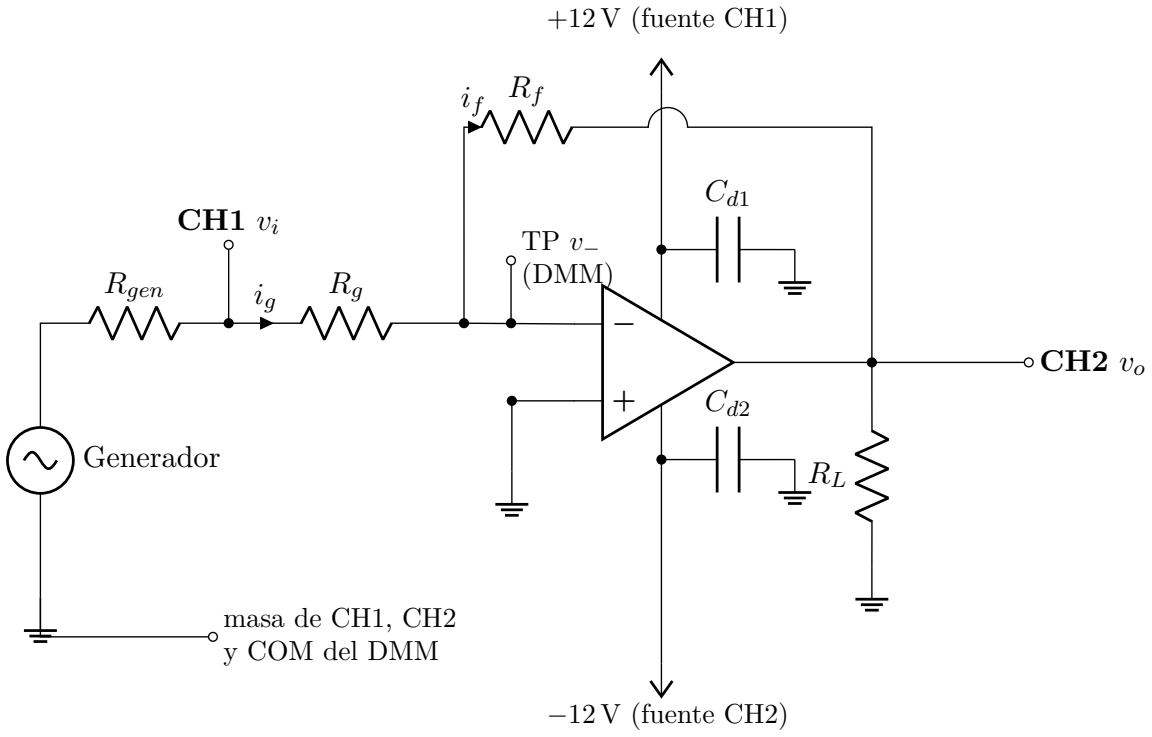
[picture p67: figure]
Generador; Rgen; TP v− (DMM); +12 V (fuente CH1); −12 V (fuente CH2); masa de CH1, CH2 y COM del DMM

Todas las masas de instrumentos van a la tierra común del montaje (borne COM de la fuente). El arco indica cruce sin conexión.

Figura 76: Montaje del inversor para medición. CH1 mide vi después de Rgen y CH2 mide vo; el multímetro mide v− en el punto de prueba. Todas las masas van a la tierra común. Las alimentaciones y su desacoplo siguen la Figura 75. Los pines se numeran según la hoja de datos del encapsulado.

### 33.2. Ejemplo S08-3-B Por qué Rout no se mide con carga a baja frecuencia

Enunciado. Con Ro = 100 Ω (valor hipotético) y A0 = 10⁵
, estimar Rout del inversor del Ejemplo A y la variación de vo al conectar RL = 1 kΩ con vo = 5 V en vacío. Decidir si el método de la carga es utilizable con el multímetro.
Método. (145) y el divisor Rout–RL.

β =

10
57

= 0,1754, Rout =

100
1 + 10⁵ · 0,1754
= 5,7 mΩ, | (164)

∆vo = vo

Rout

RL + Rout

= 5 ·

0,0057
1000
= 28,5 µV. | (165)

Interpretación. Una variación de 28,5 µV (0,0006 %) queda por debajo de la resolución y de la incertidumbre de un multímetro o de un osciloscopio. El estudiante informará Rout como «menor que la resolución del método» y no como un valor medido. Para ver Rout se mide en alta frecuencia, donde A cae y Rout crece (Figura 74).

Comprobación independiente. El límite A → ∞ da Rout → 0. Una carga de 100 Ω habría pedido 50 mA, por encima de lo que entrega un operacional general, por lo que tampoco se usa.

### 33.3. Procedimiento

1. Parámetros del dispositivo (Tabla 6). Anotar fabricante, referencia, encapsulado y revisión de la hoja de datos, con GBW, SR, Vsat para ±12 V y rango de modo común, con la condición de cada valor.
2. Alimentación. Montar la Figura 75. Medir +VCC y −VEE respecto de tierra antes de conectar el integrado. Colocar Cd1 y Cd2 junto a los pines.
3. Inversor, continua (Tabla 7). Aplicar vi de ±0,2 V, ±0,5 V y 1,0 V; medir vi
, v− y vo con el
multímetro; calcular G e ig.
4. Inversor, frecuencia (Tabla 8). Con vi = 0,2 V de pico, medir |Av| y el desfase a las frecuencias indicadas; hallar fc (−3 dB).
5. Saturación y slew rate (Tabla 9). Aumentar vi a 1 kHz hasta recorte y anotar Vo,m´ax y vi de inicio; con cuadrada de 10 kHz y salida de varios voltios, medir la pendiente (cursores).
6. No inversor (Rg = 1 kΩ, Rf = 9,1 kΩ, Rb = 1 MΩ). Repetir los pasos 3 y 4 y verificar que no hay inversión de fase.
7. Seguidor (Tabla 10). Con generador, Rth = 100 kΩ en serie y RL = 1 kΩ, medir la señal en la carga con y sin seguidor.
8. Cierre. Completar la Tabla 11 con teoría, simulación y medición, y rotular cada origen.

Condición de aceptación sugerida: G medida dentro del intervalo del Ejemplo A, ampliado por la incertidumbre de los instrumentos; si no se cumple, se documenta y se analiza la causa sin ajustar los datos.

Cuadro 6: Parámetros del dispositivo según su hoja de datos (a llenar).

Parámetro | Valor | Condición / página

Referencia y revisión
GBW
SR
Vsat con ±12 V
Rango de modo común
Corriente máxima de salida

Cuadro 7: Inversor en continua (a llenar).

vi nom. (V) | vi med. (V) | v− (mV) | vo med. (V) | G = vo/vi | ig (µA) | Dif. con −4,7

+0,2
−0,2
+0,5
−0,5
+1,0

Cuadro 8: Respuesta en frecuencia con vi = 0,2 V de pico (a llenar).

Inversor | No inversor
f (Hz) | vo pico (V) | |Av| | fase (◦
) | vo pico (V) | |Av| | fase (◦
)

100
1000
10 000
50 000
100 000
200 000

fc (kHz)

Cuadro 9: Saturación y slew rate (a llenar).

Magnitud | Medición | Origen del valor teó- rico

vi de inicio de recorte (V)
Vo,m´ax positivo y negativo (V)
Pendiente de la salida con cuadrada (V/µs) t10−90 con escalón pequeño (µs)
t10−90 con escalón grande (µs)

Cuadro 10: Seguidor con fuente de 100 kΩ y RL = 1 kΩ (a llenar).

Condición | Amplitud en la carga
(V)

Amplitud de la fuente (V)

Directo (sin seguidor)
Con seguidor
Con seguidor: vo − v+

Cuadro 11: Resumen teoría–simulación–medición (a llenar).

Magnitud | Predicción | Simulación | Medición | Diferencia

G inversor
fc inversor
G no inversor
fc no inversor
Pendiente de salida (SR)

Vo,m´ax

### 33.4. Ejercicios

S08-3-E1. Para el inversor del Ejemplo A hallar la amplitud de escalón de salida ∆Vcrit a partir de la cual el slew rate limita el tiempo de subida, y estimar t10−90 para escalones de salida de 0,2 V y de 4 V.

S08-3-E2. Para medir Rin del inversor se pone Rx = 10 kΩ en serie con la entrada y se compara vo con y sin Rx. Deducir Rin en función de la razón r = vo2/vo1 y calcular r esperada si Rin = 10 kΩ. ¿Qué error relativo en Rin produce un error de 1 % en r?

Pregunta conceptual. Al subir vi

la salida se queda plana en 10,5 V y v− ya no es cercana a 0 V. ¿Por qué ocurre y qué hipótesis del modelo deja de cumplirse?

### 33.5. Errores frecuentes y comprobaciones

Error frecuente

Conectar la masa de una sonda a un nodo que no es tierra común.

Alimentación invertida o pin equivocado por no revisar la hoja de datos.

Medir fc con amplitud tan grande que el slew rate o la saturación falsean el corte.

Ignorar Rgen, las sondas y la carga del osciloscopio.

Presentar una simulación o un valor de hoja de datos como medición.

Concluir sobre Rout con un método cuya resolución no lo permite.

### 33.6. Conexión con el proyecto

La tabla de resumen es el formato de evidencia del proyecto: toda decisión de diseño se respalda con predicción, simulación y medición, y se documentan alimentación, desacoplo, margen de saturación y límites del dispositivo elegido.

### 34. Código y recursos de la semana

Código de la semana

codigo/python/semana_08/clase1_inversor.ipynb: ganancia, Rin, ganancia finita, saturación, fc y fSR del inversor; genera transferencia_inv, bode_inv y slew_inv.

codigo/python/semana_08/clase2_noinversor_seguidor.ipynb: no inversor, seguidor con carga, Rout(f); genera bode_noinv y rout_seguidor.

codigo/python/semana_08/clase3_laboratorio_predicciones.ipynb: predicciones y tolerancias del laboratorio; genera tr_escalon. No contiene mediciones.

codigo/matlab/semana_08/clase1_inversor.m, clase2_noinversor_seguidor.m, clase3_laboratorio_predicciones.m: equivalentes en MATLAB base (no ejecutados en este entorno).

### 35. Referencias de la semana

Texas Instruments. TL08xx FET-Input Operational Amplifiers (hoja de datos SLOS081O, revisada en septiembre de 2025). https://www.ti.com/lit/ds/symlink/tl081.pdf. Consultada el 2026-11-03. Se usa solo como ejemplo de dónde obtener GBW, SR, pines y rangos del dispositivo real; los valores numéricos del texto son del operacional hipotético de las sesiones.

Las hojas de datos del dispositivo que el docente elija para el laboratorio (por ejemplo, un LM358) deben consultarse y registrarse con su revisión antes de la práctica; no se citan aquí porque no se consultaron en esta redacción.

### Parte IX

# Semana 9: Aplicaciones avanzadas de amplificadores operacionales

### 36. S09-1 Sumador inversor y restador diferencial

Resultados, prerrequisitos y distribución

Al terminar, el estudiante podrá (1) obtener la salida de un sumador inversor y de un restador a partir de KCL, con el nodo de entrada inversora y la referencia definidos; (2) diseñar las resistencias para pesos y ganancias dados y calcular la resistencia que ve cada fuente; (3) estimar cómo la tolerancia de las resistencias degrada el rechazo de modo común del restador y cuándo ese error es inaceptable. Se comprueba al final con los ejercicios S09-1-E1 y S09-1-E2.
Prerrequisitos: amplificador inversor y no inversor con realimentación negativa (semanas 7 y 8), KCL por nodos, divisor de tensión y equivalente de Thévenin (S01-1). Esta sesión no usa Laplace.

Distribución propuesta de 120 minutos

Diagnóstico, 10 min (inversor con Rf /R1 y divisor de tensión, sin calificar). Explicación del sumador y del restador, 30 min. Ejemplos guiados, 30 min. Práctica de los ejercicios, 35 min. Cierre y contraste de resultados, 15 min. Trabajo previo, no presencial: repasar el cortocircuito virtual y la tensión de saturación de salida del operacional que se usará el jueves. Todos los cálculos de la sesión se reproducen en el cuaderno clase1_sumador_restador.ipynb.

### 36.1. Concepto físico y modelo

Las dos configuraciones usan un operacional con realimentación negativa por resistencias. Mientras el operacional trabaje en régimen lineal, la tensión entre sus entradas es casi nula (cortocircuito virtual) y las corrientes de entrada son despreciables. Con estas hipótesis, el circuito es resistivo y basta KCL.

Supuestos del curso. Alimentación ±12 V; excursión de salida lineal supuesta de ±10 V (valor de trabajo del curso; el valor real depende del dispositivo, de la carga y de la alimentación y debe tomarse de su hoja de datos); ganancia en lazo abierto A grande; resistencias de carga y fuentes de entrada de baja impedancia salvo que se indique lo contrario. Si |Vo| supera la excursión lineal, el operacional satura, deja de haber cortocircuito virtual y las ecuaciones de esta sesión dejan de valer.

Símbolos. V1, V2, V3 son las tensiones de las fuentes respecto de tierra; Rk es la resistencia en serie con la fuente Vk; Rf es la resistencia de realimentación; vn es la tensión del nodo de la entrada inversora; Vo es la tensión de salida respecto de tierra; ik es la corriente que entra al nodo n por Rk.

Sumador inversor. La entrada no inversora está a tierra, de modo que vn ≈ 0. La corriente por Rk es ik = Vk/Rk y no depende de las demás fuentes, porque todas ven el mismo nodo a tensión nula. KCL en n, sin corriente hacia el operacional, da P
k

ik + Vo/Rf = 0, es decir

Vo = −Rf

X

k

Vk
Rk

= −

Rf
R1

V1 +

Rf
R2

V2 +

Rf
R3

V3

. | (166)

Cada entrada tiene su propio peso Rf /Rk. Con ganancia en lazo abierto finita A, el valor exacto es

Vo = Vo,ideal/

1 + (1 + Rf /Rp)/A
, donde Rp = R1 ∥ R2 ∥ R3 y 1 + Rf /Rp es la ganancia de ruido.

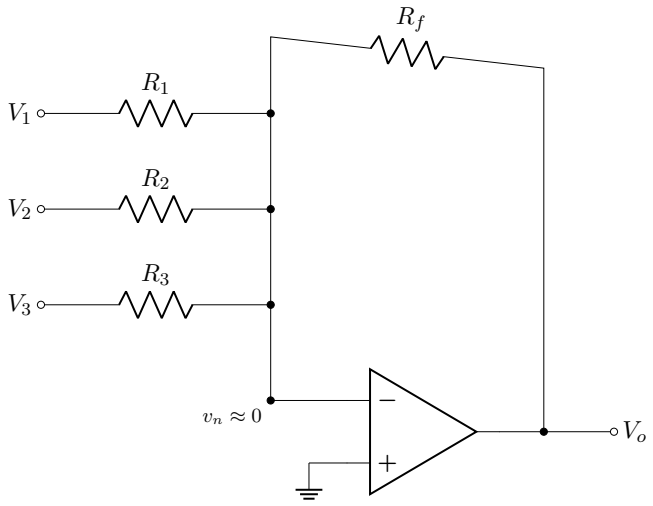
[picture p68: figure]

Referencia: tierra. Nodo n en tierra virtual (realimentación negativa, régimen lineal).

Figura 77: Sumador inversor de tres entradas. El nodo n está a tensión casi nula: cada fuente impone Vk/Rk independientemente de las demás, y la fuente Vk ve exactamente Rk hacia tierra virtual.

Restador (amplificador diferencial). Se aplica V1 a la entrada inversora mediante R1 con realimentación R2, y V2 a la no inversora mediante el divisor R3–R4 (Figura 78). Con cortocircuito virtual, vn = vp = V2R4/(R3 + R4). KCL en el nodo inversor, (V1 − vn)/R1 = (vn − Vo)/R2, da

Vo =

R4
R3 + R4
1 +

R2
R1
V2 −

R2
R1
V1. | (167)

Si R2/R1 = R4/R3 = k, se obtiene Vo = k (V2 − V1): el circuito amplifica la diferencia y rechaza la componente común.

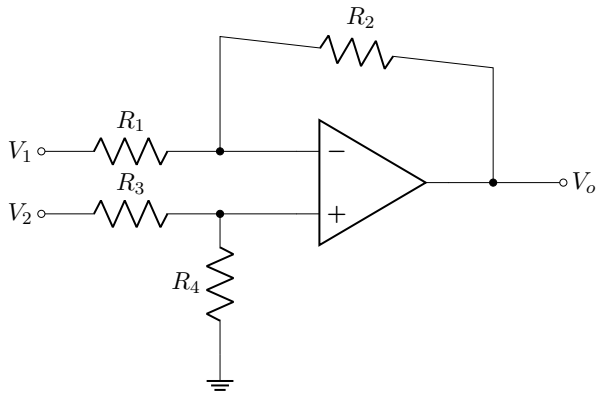
[picture p69: figure]

R2/R1 = R4/R3 = k: Vo = k(V2 − V1). Referencia: tierra.

Figura 78: Restador con R2/R1 = R4/R3 = k. La entrada no inversora es un divisor de tensión; por eso las dos fuentes ven impedancias distintas.

Límite: la tolerancia. Se define Vd = V2 − V1 y Vcm = (V1 + V2)/2. Con resistencias exactas la ganancia de modo común es Acm = 0. Con tolerancia relativa t en cada resistencia, el peor caso se produce cuando las desviaciones se combinan en el sentido que más desequilibra los cocientes, y se tiene aproximadamente

CMRRpeor ≈

1 + k
4t
. | (168)

Esta aproximación se contrasta con los 16 vértices de tolerancia en el cuaderno.

### 36.2. Ejemplo S09-1-A Sumador con pesos distintos

Enunciado. En la Figura 77, Rf = 20 kΩ, R1 = 10 kΩ, R2 = 20 kΩ, R3 = 40 kΩ, V1 = 0,5 V, V2 = 1,0 V y V3 = −1,0 V. Hallar Vo, las corrientes de entrada, el efecto de A = 10⁵ y el intervalo de V1 que mantiene la salida lineal.
Datos y supuestos. Alimentación ±12 V, excursión ±10 V, operacional ideal salvo en el paso 4. Incógnitas: Vo, ik, V1,m´ax.
Método. Se utiliza (166): es válida porque el nodo n está a tierra virtual y la realimentación es negativa.

Paso 1. Pesos. Rf /R1 = 2, Rf /R2 = 1, Rf /R3 = 0,5.

Paso 2. Salida.

Vo = −

2(0,5) + 1(1,0) + 0,5(−1,0)
= −(1,0 + 1,0 − 0,5) = −1,5 V. | (169)

Paso 3. Corrientes. i1 = 0,5/10 000 = 50 µA, i2 = 50 µA, i3 = −1/40 000 = −25 µA; la suma es 75 µA. La corriente por Rf es la misma, con sentido hacia la salida, y Vo = −Rf · 75 µA = −1,5 V.

Paso 4. Ganancia finita. Rp = 10 ∥ 20 ∥ 40 = 5,714 kΩ, ganancia de ruido 1 + 20/5,714 = 4,5. El error relativo es −4,5/10⁵ = −4,5 × 10⁻⁵
, y Vo = −1,499 93 V: despreciable frente a la tolerancia de las resistencias.
Paso 5. Linealidad. Con V2 y V3 fijos, Vo = −(2V1 + 0,5). La condición |Vo| ≤ 10 V da −5,25 ≤ V1 ≤ 4,75 V.

Interpretación. Cada fuente entrega una corriente fijada solo por su propia resistencia; por eso el sumador permite mezclar señales sin que se carguen entre sí. La salida es negativa: el signo menos es parte del diseño y se corrige con una segunda etapa inversora si hace falta.

Comprobación independiente. KCL en n con vn = 0: 75 µA entran y deben salir por Rf . La solución simbólica del sistema nodal con A finito, en el cuaderno, converge a (166) cuando A → ∞ (comprobado con assert).

### 36.3. Ejemplo S09-1-B Restador y efecto de la tolerancia

Enunciado. En la Figura 78, R1 = R3 = 10 kΩ y R2 = R4 = 47 kΩ. Las fuentes son V1 = 2,100 V y V2 = 2,250 V. Hallar Vo con resistencias exactas y estimar el error si cada resistencia tiene tolerancia de 1 %.

Datos y supuestos. k = 4,7; Vd = 0,150 V; Vcm = 2,175 V; fuentes de impedancia despreciable. Incógnitas: Vo, Acm, CMRR.
Método. Se utiliza (167) y se recalcula la salida en los vértices de tolerancia, porque el peor caso ocurre en los extremos.
Paso 1. Salida ideal. Vo = 4,7 (2,250 − 2,100) = 0,705 V. Con la forma general, 0,8246 · 5,7 · 2,250 − 4,7 · 2,100, donde R4/(R3 + R4) = 0,8246, se obtiene el mismo valor.

Paso 2. Peor caso con t = 1 %. Evaluando los 16 vértices se encuentra |Acm|m´ax = 0,0335, de

modo que
CMRRpeor = 20 log10

4,7
0,0335
= 42,9 dB, | (170)

frente a 20 log10[(1 + k)/(4t)] = 43,1 dB de (168).

Paso 3. Error en la salida. El error por modo común es AcmVcm = 0,0335 · 2,175 = 73 mV, el 10 % de Vo. Con tolerancia de 5 % el CMRR de peor caso baja a 28,4 dB; con 0,1 % sube a 63,1 dB.

Interpretación. El rechazo de modo común del restador lo fija el emparejamiento de las resistencias, no el operacional. Una diferencia de 150 mV sobre un nivel común de 2,175 V exige resistencias de precisión (0,1 %) o un amplificador de instrumentación.

Comprobación independiente. Con R1 = R3 y R2 = R4 exactos, Vd = 0 da Vo = 0 para cualquier Vcm. La Figura 79 muestra en (b) las rectas Vo(Vcm) para sorteos de resistencias al 1 % y

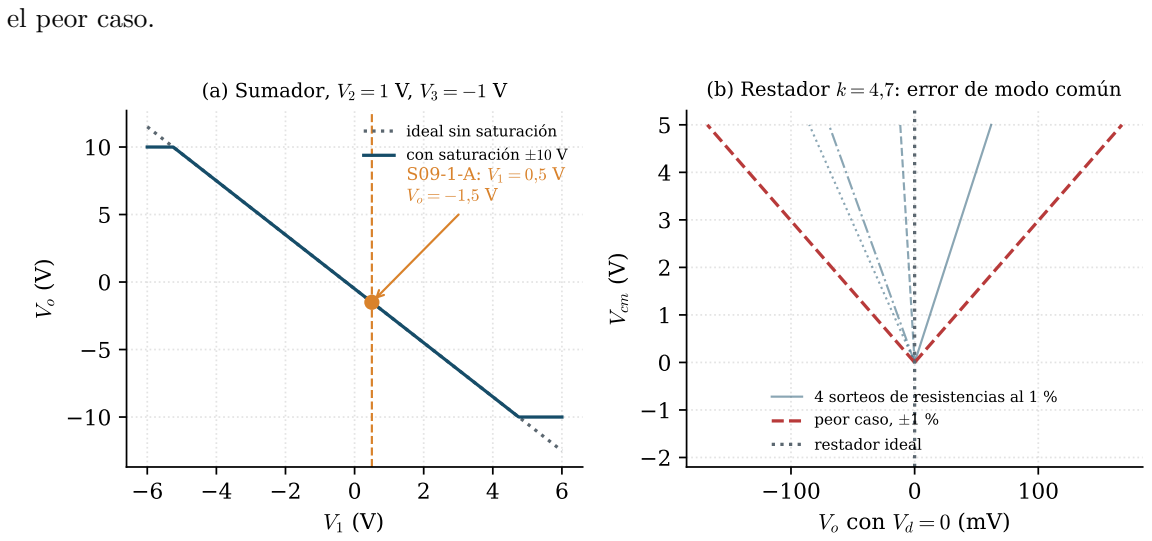
[picture p70: figure]
el peor caso.; (a) Sumador, V2 = 1 V, V3 = ¡1 V; ideal sin saturación con saturación §10 V; Vo con Vd = 0 (mV); Vcm (V); 4 sorteos de resistencias al 1 % peor caso, §1 %; restador ideal

(b) Restador k = 4;7: error de modo común

Figura 79: Resultados de cálculo (cuaderno de S09-1). (a) El sumador S09-1-A es lineal hasta ±10 V de salida y satura fuera de esa zona. (b) Con Vd = 0 la salida de un restador ideal es cero; con resistencias al 1 % aparece un error proporcional a Vcm. Observe cómo el peor caso limita el nivel común admisible.

### 36.4. Ejercicios

S09-1-E1 (diseño de un sumador). Con Rf = 30 kΩ, diseñar un sumador inversor de dos entradas que cumpla Vo = −(3V1 + 2V2). Hallar R1 y R2, la resistencia que ve cada fuente y Vo para V1 = 0,2 V y V2 = −0,1 V. Con ese V2, hallar el intervalo de V1 que mantiene la salida lineal (±10 V).

S09-1-E2 (restador para un puente). Un puente resistivo entrega V1 = 2,5000 V y V2 = 2,5120 V. Se desea una ganancia diferencial de 100 con R1 = R3 = 10 kΩ. Hallar R2 = R4, Vo, la resistencia que ve V2 y la corriente que entrega V1. Después, la fuente V1 tiene una resistencia de salida Rs = 500 Ω en serie: hallar el nuevo Vo y el error relativo, y proponer cómo corregirlo.

Pregunta conceptual. En el sumador inversor, ¿por qué cambiar V2 no modifica la corriente que entrega V1? ¿Qué deja de cumplirse si la salida satura?

### 36.5. Errores frecuentes y comprobaciones

Errores frecuentes

Usar (167) sin igualar R2/R1 con R4/R3 y suponer que el circuito rechaza el modo común.

Suponer que las dos entradas del restador ven la misma resistencia: V2 ve R3 + R4; V1 ve R1 más lo que le imponga V2.

Ignorar la resistencia de salida de la fuente (sensor, divisor): modifica R1 efectiva.

Olvidar el signo del sumador inversor o la saturación de la salida.

Calcular el CMRR a partir del operacional sin considerar la tolerancia de las resistencias.

Criterios de comprobación: (a) Vo = 0 cuando todas las entradas son nulas; (b) |Vo| dentro de la excursión lineal; (c) suma de corrientes en el nodo n nula; (d) con Vd = 0 la salida del restador no cambia con Vcm salvo por la tolerancia.

### 36.6. Conexión con el curso

El sumador permite combinar un sensor con un desplazamiento de nivel (por ejemplo, para llevar una señal bipolar a un rango admisible por una etapa posterior), y el restador acondiciona un puente. El jueves y las semanas de sensores reutilizarán estas etapas. En el proyecto se pedirá justificar la tolerancia de las resistencias frente al CMRR necesario, con evidencia de cálculo.

### 37. S09-2 Integrador, derivador y comparador con histéresis

Resultados, prerrequisitos y distribución

Al terminar, el estudiante podrá (1) obtener H(s) del integrador con resistencia de realimentación y del derivador con red de estabilización, y decidir en qué intervalo de frecuencias cada uno se comporta como integral o derivada; (2) explicar por qué el derivador ideal es inestable y amplifica ruido, y justificar Rs y Cf ; (3) diseñar un comparador con histéresis y explicar por qué un operacional como el LM358 no equivale a un comparador dedicado. Se comprueba al final con S09-2-E1, S09-2-E2 y la pregunta conceptual.
Prerrequisitos: S09-1, función de transferencia y diagrama de Bode (semanas 2 a 5), cortocircuito virtual y ganancia de ruido 1/β (semanas 7 y 8).

Distribución propuesta de 120 minutos

Diagnóstico, 10 min (Bode de un RC y significado de 1/β). Integrador, 25 min de explicación y ejemplo. Derivador, 25 min. Comparador e histéresis, 25 min. Práctica de los ejercicios, 25 min. Cierre, 10 min. Es una sesión densa: si el tiempo no alcanza, el estudiante resuelve S09-2-E1 de forma autónoma antes del jueves. Trabajo previo: revisar el efecto de Vos y de las corrientes de polarización en un operacional. Cálculos reproducibles en clase2_integrador_derivador_comparador.ipynb.

### 37.1. Concepto físico y modelo

Supuestos comunes. Operacional con alimentación ±12 V y excursión lineal supuesta de ±10 V, salvo en el comparador donde se declara la alimentación. Para estabilidad se usa un modelo genérico de un polo, A(s) = A0/(1 + s/ωp) con A0 = 10⁵ y GBW = 1 MHz; no es un dispositivo comercial. Las funciones de transferencia suponen condiciones iniciales nulas y régimen lineal.

Integrador. Con R en la entrada y el paralelo Rf ∥ C como realimentación (Figura 80), la impedancia de realimentación es Zf = Rf /(1 + sRfC) y

H(s) = −

Zf
R

= −

Rf /R
1 + sRfC
. | (171)

Si Rf → ∞ queda H(s) = −1/(sRC), un integrador ideal: vo(t) = −

1
RC

R
| vi dt + vo(0). El polo está
en s = −1/(RfC), es decir fc = 1/(2πRfC) en hercios; solo para f ≫ fc el circuito integra. Sin Rf , el desvío de entrada Vos y las corrientes de polarización se integran y la salida deriva hasta saturar: Rf fija la ganancia en continua en Rf /R y evita esa deriva.

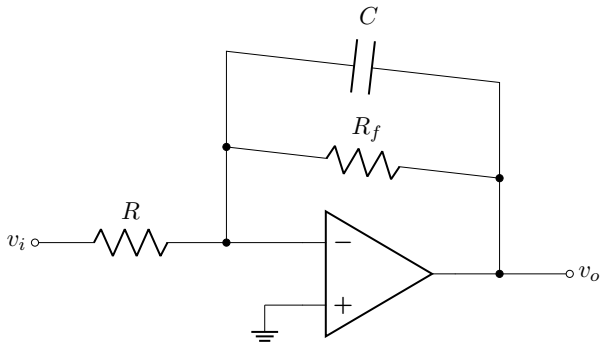
[picture p71: figure]

Rf limita la ganancia en continua a Rf /R; sin Rf el circuito integra su propio desvío.

Figura 80: Integrador inversor con Rf en paralelo con C. H(s) = −(Rf /R)/(1 + sRfC); la entrada no inversora va a tierra.

Derivador. Intercambiando los papeles, con C en la entrada y Rf en la realimentación, H(s) = −sRfC: la ganancia sube 20 dB por década sin límite. Dos problemas: amplifica el ruido de alta frecuencia y es inestable. La razón de la inestabilidad es que la ganancia de ruido 1/β = 1+Zf /Zi = 1 + sRfC crece a 20 dB por década mientras |A(jω)| cae a 20 dB por década; las curvas se cruzan con velocidad de cierre de 40 dB por década y el margen de fase es casi nulo. Se añaden Rs en serie con C y Cf en paralelo con Rf (Figura 81):

H(s) = −

sRfC
(1 + sRsC)(1 + sRfCf )
. | (172)

Con RsC = RfCf hay un polo doble en fp = 1/(2πRsC). Por debajo de fp/10 el circuito deriva; por encima, la ganancia cae. Rs limita la ganancia de alta frecuencia a Rf /Rs.

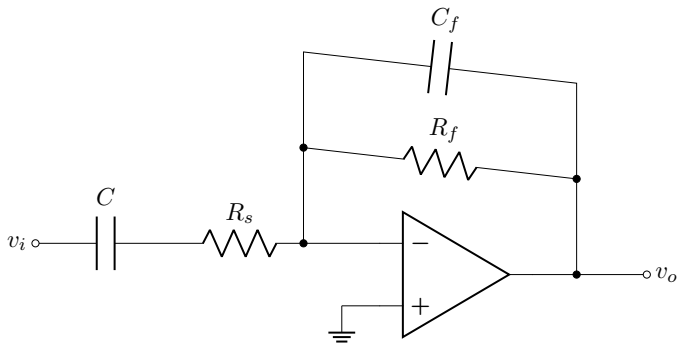
[picture p72: figure]

Rs limita la ganancia de alta frecuencia a Rf /Rs; Cf agrega un polo en 1/(2πRfCf ).

Figura 81: Derivador estabilizado. Rs y Cf limitan la ganancia de alta frecuencia y devuelven el margen de fase.

Comparador. Un comparador compara dos tensiones y entrega solo dos niveles lógicos: sin realimentación negativa la ganancia diferencial es enorme, la salida está casi siempre saturada y el cortocircuito virtual no se aplica. No se usa como amplificador lineal. Una entrada con ruido cerca del umbral produce varios flancos. La histéresis, con realimentación positiva, define dos umbrales. En la Figura 82, vi va a la entrada inversora y la no inversora recibe Vref por R1 y la salida por R2. KCL en la entrada no inversora, (v+ − Vref )/R1 + (v+ − vo)/R2 = 0, da

v+ = Vref + (vo − Vref )

R1
R1 + R2
. | (173)

Con salida alta, vo = VOH, y VT H = v+; con salida baja, vo = VOL, y VT L = v+. La histéresis es VH = VT H − VT L. La salida pasa a nivel bajo cuando vi sube sobre VT H y vuelve a alto cuando vi baja de VT L. Como el circuito es inversor, la característica entrada-salida describe un lazo recorrido

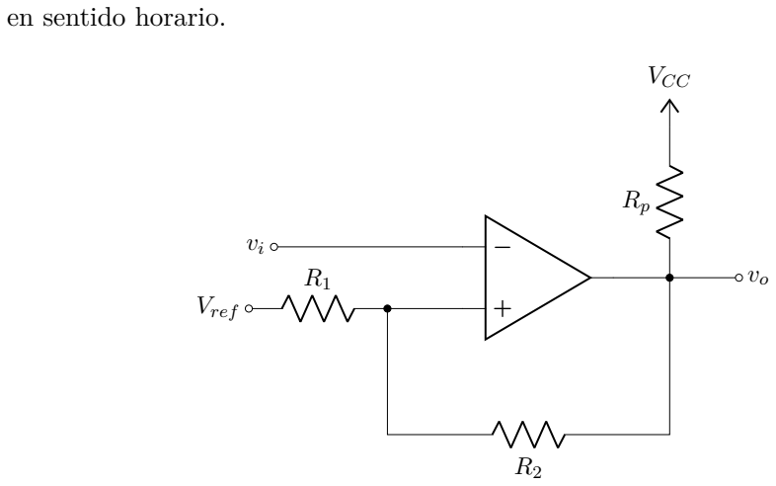
[picture p73: figure]
en sentido horario.; Vref; VCC

Comparador de colector abierto (p. ej. LM393); Rp es el pull-up. El nivel alto lo fija VCC a través de Rp.

Figura 82: Comparador con histéresis (disparador de Schmitt inversor) con salida de colector abierto y pull-up Rp. Cuando la salida está en nivel alto, Rp queda en serie con R2 dentro del camino de realimentación.

Por qué un LM358 no equivale a un comparador dedicado. Se toma como referencia el LM393 (familia de dos comparadores de colector abierto, hoja de datos de Texas Instruments

SLCS005AH). Diferencias que aparecen en las hojas de datos: (a) el LM393 está especificado con respuesta de comparación (tiempo de respuesta de 1,3 µs típico para un escalón de 100 mV con 5 mV de sobreexcitación en las variantes sin sufijo B, con RL a 5 V por 5,1 kΩ y CL = 15 pF) y su salida es de colector abierto compatible con niveles TTL, MOS y CMOS; (b) el LM358 es un operacional compensado para realimentación negativa, con producto ganancia-ancho de banda y velocidad de variación especificados (en las variantes sin sufijo B, 0,3 V/µs) pero no una respuesta ante sobreexcitación; (c) su salida no llega al riel positivo: la hoja de datos (SLOS068AB, variante
B) la sitúa entre unos 1,4 V y 1,6 V por debajo de V

+ según la corriente, lo que puede incumplir el nivel alto de una entrada lógica con alimentación baja. Como estimación de cálculo, a 0,3 V/µs un cambio de 5 V toma unos 17 µs, un orden de magnitud más que el comparador. Un operacional con realimentación positiva puede funcionar en bajas velocidades, pero esa decisión exige verificar los datos de la variante concreta; no es una equivalencia automática. No se debe suponer histéresis interna en ninguno de los dos: se agrega con resistencias, como en (173).

La salida de un comparador es un nivel digital. Para llevarla a un GPIO hay que comprobar tensión y corriente admitidas por la entrada de destino, y no conectarla a un ADC como si fuese una medición analógica.

### 37.2. Ejemplo S09-2-A Integrador con Rf

Enunciado. En la Figura 80, R = 10 kΩ, C = 10 nF y Rf = 1 MΩ. Hallar H(s), fc, la respuesta a una cuadrada de ±1 V y 1 kHz, y el efecto de Vos = 2 mV.

Datos y supuestos. RC = 0,1 ms, RfC = 10 ms; condensador descargado en t = 0; régimen permanente para la cuadrada; solo se considera Vos (sin corrientes de polarización).

Método. Se usa (171) y, para la cuadrada, la integración por tramos.

Paso 1. Función de transferencia.

H(s) = −

100
1 + s (10 ms), fc =

1
2πRfC
= 15,9 Hz, | |H(0)| = 100 (40 dB). | (174)

Paso 2. Zona de integración. Se exige f ≥ 10fc ≈ 159 Hz. A 1 kHz, |H| = 1,5913 frente a 1/(ωRC) = 1,5915: diferencia de −0,013 %, y fase +90,91◦

frente a +90◦ del integrador ideal inversor.
Paso 3. Cuadrada. Con vi = +1 V durante 0,5 ms, la pendiente es −V /RC = −10 V/ms, y la variación es
∆vo = −

1
0,1 ms
- 0,5 ms = −5 V. | | (175)

La salida es una triangular de 5 V pico a pico (±2,5 V), simétrica porque la entrada tiene valor medio nulo.
Paso 4. Offset. Sin Rf , Vos actúa como entrada continua de 2 mV: rampa de Vos/RC = 20 V/s, y la salida alcanza 10 V en 0,5 s. Con Rf , el offset se amplifica por la ganancia no inversora y el desvío se estabiliza en Vos(1 + Rf /R) = 0,202 V.

Interpretación. Rf compra estabilidad en continua a costa de integrar solo por encima de fc. Un valor mayor de Rf ensancha la zona de integración, pero aumenta el desvío en continua. Comprobación independiente. La simulación del modelo por lsim de H(s) da 4,999 V pico a pico (cálculo, no medición). Además, con Rf → ∞, H(s) → −1/(sRC).

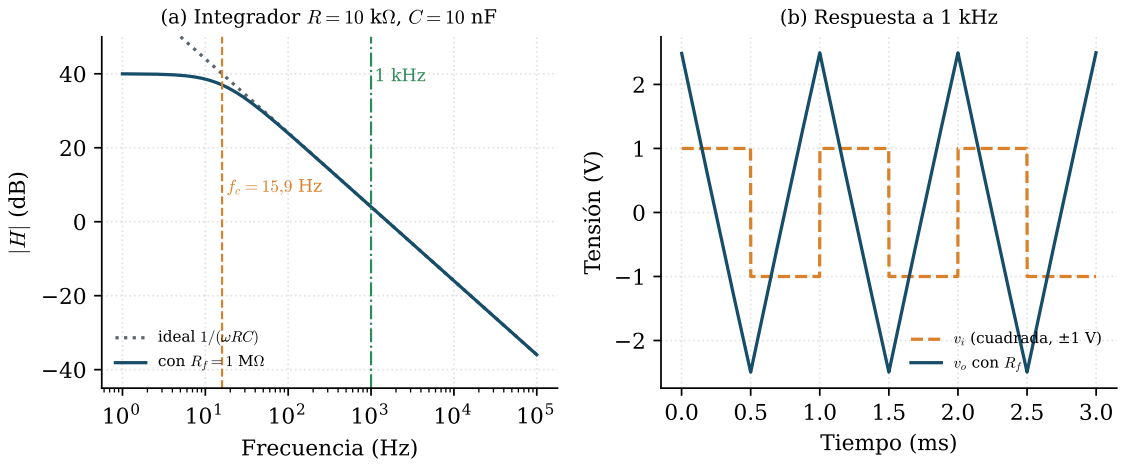
[picture p74: figure]
Frecuencia (Hz); jHj (d; 1 kHz; (a) Integrador R = 10 k, C = 10 nF; ideal 1=(!RC); con Rf; 0.0 0.5 1.0 1.5 2.0 2.5 3.0 Tiempo (ms); Tensión (V); (b) Respuesta a 1 kHz; vi (cuadrada, ±1 V) vo con Rf

Figura 83: Cálculo del cuaderno de S09-2. (a) Magnitud del integrador ideal y con Rf : coinciden por encima de unos 160 Hz. (b) Respuesta a una cuadrada de ±1 V y 1 kHz: una triangular de 5 V pico a pico.

### 37.3. Ejemplo S09-2-B Derivador estabilizado

Enunciado. Diseñar un derivador con RfC = 1 ms para señales de hasta 1 kHz, con C = 10 nF, y comprobar su estabilidad con el modelo de operacional con GBW = 1 MHz.
Datos y supuestos. Alimentación ±12 V, modelo de un polo; carga y desacoplo adecuados; polos de la red a una década por encima de la banda útil.
Paso 1. Valores. Rf = 100 kΩ. Se elige Rs = 1 kΩ, de modo que fp = 1/(2πRsC) = 15,9 kHz y RsC = 10 µs. Igualar las constantes da Cf = RsC/Rf = 100 pF.

Paso 2. Función de transferencia. Por (172), H(s) = −

10⁻³
s
(1 + 10⁻⁵s)
2

. En fp el módulo es

|H| = 50 (33,98 dB), la mitad del valor ideal (99,9). A 100 Hz, |H| = 0,628 frente a ωRfC = 0,628; a 1 kHz, 6,258 frente a 6,283.
Paso 3. Margen de fase. Se calcula T = A/(1/β) con 1/β = 1 + Zf /Zi y se busca el cruce |T| = 1:
Configuración | Cruce | Margen de fase
Derivador ideal (sin red) 12,6 kHz | 0,8
| | ◦
Solo Rs | 14,6 kHz | 43,2 ◦
Rs y Cf | 20,2 kHz | 103,2 ◦

Paso 4. Ruido. Triangular de 5 V pico a pico a 100 Hz: pendiente 1000 V/s, luego vo = ∓RfC · 1000 = ∓1 V (simulación: ±0,997 V). Con 5 mV de ruido a 50 kHz, el derivador ideal entregaría 5 mV · 314 = 1,57 V; el estabilizado, 5 mV · 28,9 = 0,145 V.

Interpretación. Sin red, el margen de fase es prácticamente nulo y el circuito oscila ante cualquier perturbación. La red sacrifica la derivada por encima de fp, a cambio de estabilidad y menos ruido. El margen de fase elevado del modelo no garantiza el comportamiento de un dispositivo real, que debe verificarse con la hoja de datos y con medición.
Comprobación independiente. H(s) obtenida por análisis nodal simbólico con A finito y límite A → ∞ coincide con (172).

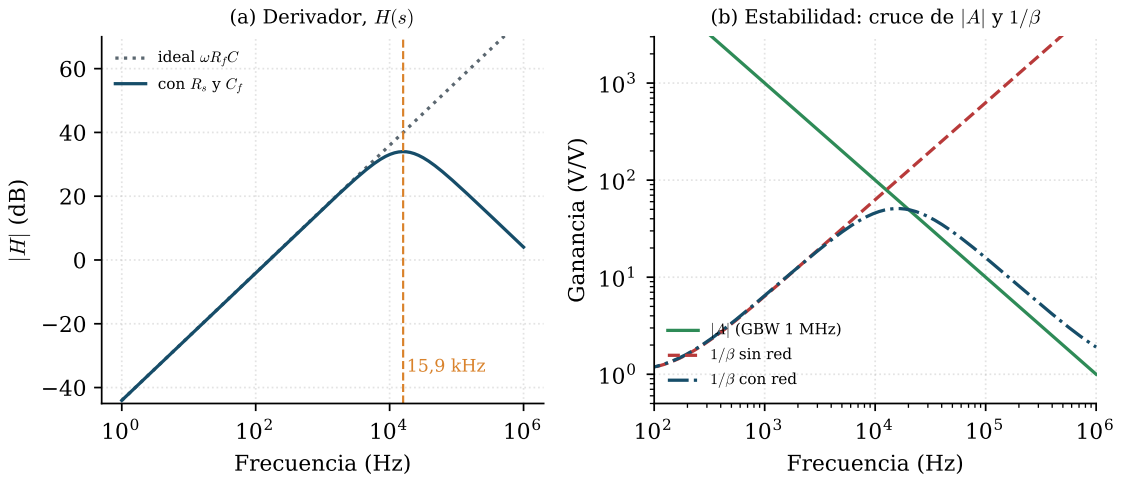
[picture p75: figure]
Frecuencia (Hz); jHj (d; 15,9 kHz; (a) Derivador, H(s); ideal !RfC con Rs y Cf; Ganancia (V/V); (b) Estabilidad: cruce de jAj y 1=¯; jAj (GBW 1 MHz) 1=¯ sin red 1=¯ con red

Figura 84: Cálculo del cuaderno de S09-2. (a) Magnitud del derivador ideal y estabilizado, con el polo doble en 15,9 kHz. (b) Cruce de |A| con 1/β: sin red cruzan casi con 40 dB por década de cierre; con red, la curva 1/β se aplana y se curva hacia abajo antes del cruce.

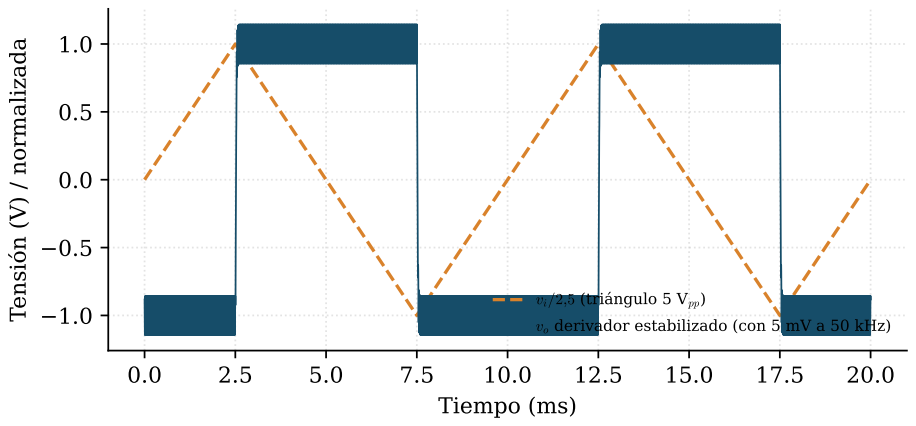
[picture p76: figure]
Tiempo (ms); Tensión (V) / normalizada; vi=2;5 (triángulo 5 Vpp)

vo derivador estabilizado (con 5 mV a 50 kHz)

Figura 85: Simulación del cuaderno de S09-2 (no es una medición). Triangular de 5 V pico a pico a 100 Hz (dividida entre 2,5) y salida del derivador estabilizado con 5 mV de ruido a 50 kHz: se obtienen tramos casi planos de ∓1 V con esquinas redondeadas y ruido residual pequeño.

### 37.4. Ejemplo S09-2-C Comparador con histéresis y colector abierto

Enunciado. Con VCC = 5 V, Vref = 2,5 V, R1 = 10 kΩ, R2 = 91 kΩ, Rp = 10 kΩ y salida de colector abierto, hallar los umbrales y la histéresis, y verificar el efecto de un ruido de 40 mV rms sobre una senoidal de 50 Hz.
Datos y supuestos. Comparador tipo LM393 alimentado a 5 V; VOL ≈ 0,1 V (supuesto del ejemplo; debe leerse en las curvas de la hoja de datos para la corriente real); VOH lo fija VCC a través de Rp; entrada vi = 2,5 V + 0,8 V sen(2π 50 t) más ruido.

Método. Se usa (173). Con salida alta, el camino VCC → Rp → R2 → v+ hace que R2 efectiva sea R2 + Rp. Con salida baja, el transistor satura y fija VOL.
Paso 1. Caso ideal (VOH = 5 V, VOL = 0, sin Rp): R1/(R1 + R2) = 0,099; VT H = 2,7475 y VT L = 2,2525 V, VH = 0,495 V.

Paso 2. Con colector abierto.

VT H = Vref + (VCC − Vref )

R1
R1 + R2 + Rp

= 2,5 + 2,5 ·

10
111
= 2,7252 V, | (176)

VT L = Vref + (VOL − Vref )

R1
R1 + R2

= 2,5 − 2,4 ·

10
101
= 2,2624 V. | (177)

La histéresis es VH = 0,463 V y el centro se desplaza −6,2 mV respecto de Vref .

Paso 3. Ruido. La histéresis (0,46 V) debe superar el pico a pico del ruido cerca del umbral. En la simulación de 60 ms (3 ciclos) sin histéresis aparecen 1098 flancos de salida; con histéresis, 6 (dos por ciclo).

Interpretación. La histéresis convierte un umbral en una banda, a costa de retrasar el cambio. El pull-up modifica el umbral superior porque Rp queda en serie con R2: ignorarlo desplaza 22 mV.

Comprobación independiente. Las ecuaciones de nodo en v+ resueltas por separado para cada nivel de salida dan los mismos umbrales (cuaderno). Para VOH = VCC y Rp = 0 se recupera el caso

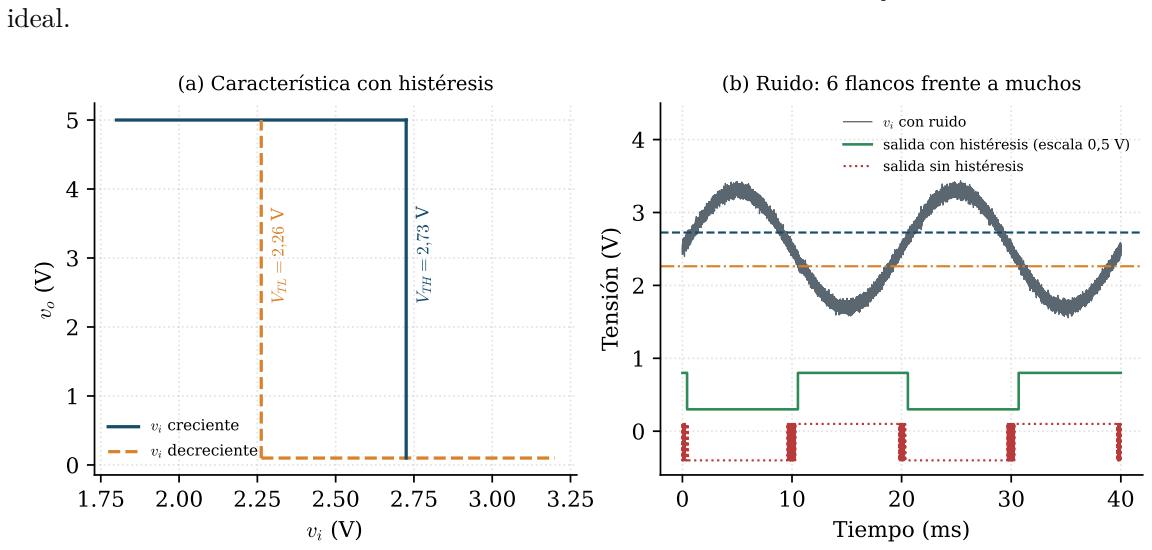
[picture p77: figure]
ideal.; VTL = 2;26 V; VTH; (a) Característica con histéresis; vi creciente vi decreciente; Tiempo (ms); Tensión (V); (b) Ruido: 6 flancos frente a muchos; vi con ruido salida con histéresis (escala 0,5 V) salida sin histéresis

Figura 86: Simulación del cuaderno de S09-2 (semilla fija; no es una medición). (a) Característica con histéresis y umbrales calculados. (b) Entrada con ruido de 40 mV rms y salidas con y sin histéresis (desplazadas verticalmente para verlas): con histéresis solo hay seis flancos.

### 37.5. Ejercicios

S09-2-E1 (integrador). Un integrador con R = 10 kΩ, C = 47 nF y Rf = 470 kΩ recibe un escalón de 0,2 V en t = 0 con el condensador descargado. Hallar H(s), fc, vo(t), el valor final, el tiempo que tarda en llegar a −5 V y compararlo con el tiempo del integrador ideal. Concluir hasta qué instante la aproximación ideal es válida.
S09-2-E2 (diseño de Schmitt). Con VCC = 5 V, comparador de colector abierto con Rp = 4,7 kΩ, Vref = 1,5 V, R1 = 10 kΩ, R2 = 100 kΩ y VOL = 0,1 V, hallar VT H, VT L, VH y el centro de la banda. ¿Rechaza un ruido de 0,2 V pico a pico? Hallar el R2 que da VH = 0,30 V.
Pregunta conceptual. (a) ¿Por qué un derivador ideal amplifica el ruido y puede oscilar, y qué hace Rs para evitarlo? (b) ¿Por qué no basta con cambiar un comparador por un LM358 conectado sin realimentación negativa?

### 37.6. Errores frecuentes y comprobaciones

Errores frecuentes

Dejar el integrador sin Rf ni camino de reinicio, y esperar una rampa estable en el laboratorio.

Usar la fórmula ideal fuera de la zona f ≥ 10fc (o t ≪ τ ).

Montar el derivador ideal sin Rs y Cf y atribuir la oscilación al ruido de la fuente.

Tratar un comparador como amplificador lineal o aplicar cortocircuito virtual con realimentación positiva.

Olvidar el pull-up en un comparador de colector abierto o ignorar que Rp modifica el umbral superior.

Conectar la salida del comparador a un ADC como si fuera una medición analógica, o a un GPIO sin comprobar niveles y corriente.

Criterios de comprobación: límites en continua y alta frecuencia de H(s); margen de fase estimado con T = A/(1/β); VT H > VT L y VH mayor que el ruido pico a pico.

### 37.7. Conexión con el curso

El integrador y el derivador se emplean para acondicionar señales de sensores (por ejemplo, convertir una variación en pendiente). El comparador con histéresis se vuelve a usar en alarmas y en la entrada digital de un sistema embebido. En el proyecto se pedirá justificar por qué un comparador dedicado y no un operacional, con los datos de la hoja de datos de la variante elegida. Para el jueves, repasar H(s) y Bode de un filtro de primer orden.

### 38. S09-3 Diseño de un filtro activo y laboratorio

Resultados, prerrequisitos y distribución

Al terminar, el estudiante podrá (1) diseñar con valores normalizados un filtro pasa bajas activo de primer orden con ganancia y uno Sallen-Key de segundo orden, a partir de fc, ganancia y Q; (2) obtener H(s), el Bode y las desviaciones por tolerancia y por producto ganancia-ancho de banda;
(3) medir la respuesta en frecuencia de ambos filtros y contrastarla con la predicción, explicando las discrepancias. Se comprueba con S09-3-E1, S09-3-E2 y la tabla del laboratorio. Prerrequisitos: S09-2, filtro RC de primer orden y Bode (semanas 3 a 5), amplificador inversor y seguidor. Trabajo previo, no presencial: calcular los valores normalizados y completar las columnas de predicción de las tablas.

Distribución propuesta de 120 minutos

Diagnóstico y seguridad, 10 min. Explicación del diseño de ambos filtros, 25 min. Ejemplos guiados, 25 min. Montaje y medición en el laboratorio, 45 min. Comparación predicción– medición y cierre, 15 min. Si el tiempo no alcanza, el filtro Sallen-Key se mide en una sesión posterior. Cálculos reproducibles en clase3_filtros_activos.ipynb.

### 38.1. Concepto físico y modelo

Supuestos. Operacional con alimentación dual y régimen lineal; modelo de un polo con GBW = 1 MHz para estimar efectos de frecuencia finita (modelo genérico del curso); condiciones iniciales nulas al usar H(s); carga de la salida de alta impedancia. La frecuencia f se da en hercios y ω en radianes por segundo; las ganancias se dan en dB solo cuando se indica.

Primer orden con ganancia. Con Ri en la entrada y Rf ∥ Cf en la realimentación (Figura 87),

H(s) = −

Rf /Ri
1 + sRfCf

, K =

Rf
Ri

, fc =

1
2πRfCf
. | (178)

La ganancia en continua es −K; en fc la magnitud es K/√ 2 (−3,01 dB respecto de K) y la fase del cociente aporta −45◦
; la pendiente asintótica es de −20 dB por década. La fuente ve la resistencia Ri

, de modo que una resistencia de fuente Rs cambia la ganancia a Rf /(Ri + Rs).

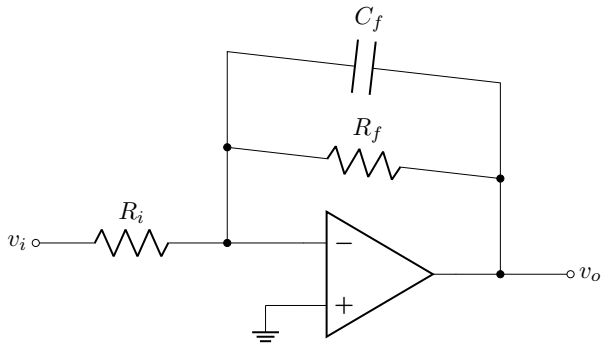
[picture p78: figure]

H(s) = −

Rf /Ri
1 + sRfCf

; la fuente ve Ri.

Figura 87: Filtro pasa bajas inversor de primer orden con ganancia. Diseño: elegir Ri

, fijar Rf = KRi
y calcular Cf = 1/(2πfcRf ).

Sallen-Key pasa bajas de ganancia unitaria. Se denomina v1 al nodo entre las dos resistencias y vp a la entrada no inversora, que es igual a vo por el seguidor (Figura 88). KCL en vp: (v1−vo)/R = sC2vo, de donde v1 = vo(1 + sRC2). KCL en v1: (vi − v1)/R + (vo − v1)sC1 + (vo − v1)/R = 0. Eliminando v1,
H(s) = | 1
1 + 2sRC2 + s

2R²C1C2

=

ω

2
0
s

2 + (ω0/Q) s + ω

2
0
, | (179)

ω0 =

1
R

√
C1C2

, Q =

√
C1C2
2C2

=

1
2

s
C1
C2
. | (180)

Para una respuesta Butterworth (máximamente plana), Q = 1/

√
2, es decir C1 = 2C2; entonces |H(jω0)| = 1/

√
2 y la fase es −90◦
. La pendiente final es de −40 dB por década. Con Q > 1/

√
2
aparece un pico; Q < 1/

√
2 redondea la rodilla. Con resistencias iguales y condensadores iguales, una ganancia K = 1 + Rb/Ra da Q = 1/(3 − K), y K → 3 lleva a la oscilación.

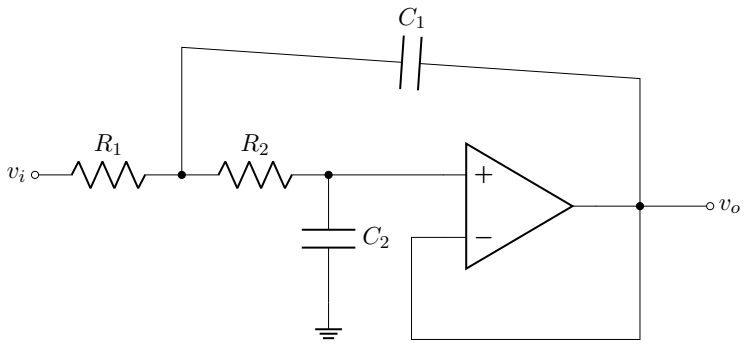
[picture p79: figure]

Ganancia unitaria; C1 a la salida, C2 a tierra.

Figura 88: Sallen-Key pasa bajas de ganancia unitaria. C1 va del nodo v1 a la salida y C2 de la entrada no inversora a tierra; el seguidor es la realimentación a la entrada inversora.

Límites. (a) Tolerancias: f0 varía con R y con √
C1C2; Q, con la razón C1/C2. (b) Frecuencia finita: el producto ganancia-ancho de banda limita el filtro de primer orden a GBW/(1 + K) y, en el Sallen-Key, degrada la atenuación en la banda atenuada. (c) La impedancia de la fuente se suma a Ri (primer orden) o a R1 (Sallen-Key). (d) Una carga de baja impedancia exige comprobar la corriente de salida del operacional.

### 38.2. Ejemplo S09-3-A Pasa bajas de primer orden con ganancia

Enunciado. Diseñar un filtro inversor con |K| ≈ 4 y fc ≈ 1 kHz con valores comerciales, hallar H(s), el Bode en puntos clave y la verificación numérica.

Datos y supuestos. Ri = 8,2 kΩ (alta impedancia respecto de una fuente de 600 Ω); resistencias de la serie E24 y condensador de 4,7 nF; GBW = 1 MHz. Incógnitas: Rf , Cf , K, fc.
Método. Se usa (178). Se elige Rf = 33 kΩ para que K = Rf /Ri ≈ 4 y se calcula fc con el condensador comercial más cercano a 1/(2π · 1000 · 33 000) = 4,82 nF.

Paso 1. Ganancia. K = 33/8,2 = 4,024, que son 12,09 dB.

Paso 2. Frecuencia de corte.

fc =

1
2π(33 000)(4,7 × 10⁻⁹)
= 1026 Hz, | ωc = 6447 rad/s, | τ = RfCf = 155,1 µs. | (181)

Paso 3. Función de transferencia. H(s) = −

4,024
1 + 1,551 × 10⁻⁴ s

Paso 4. Puntos del Bode. A 1026 Hz, |H| = 2,846 = 9,08 dB, fase del cociente −45◦
(fase total
135◦ por el signo del inversor). A 5 kHz, −1,84 dB; a 10 kHz, −7,73 dB; pendiente entre 10 kHz y 100 kHz, −19,95 dB por década.

Paso 5. Efecto de GBW y de la fuente. Con el modelo de un polo, a 5 kHz el resultado es −1,88 dB frente a −1,84 dB: diferencia de 0,04 dB. Con una resistencia de fuente Rs = 600 Ω, K pasa a 33/8,8 = 3,75 (−6,8 %).

Interpretación. Con Ri elegida, la ganancia queda definida por la razón Rf /Ri y la frecuencia de corte por RfCf . Un condensador de otra serie (por ejemplo 3,9 nF) daría fc = 1,24 kHz (cálculo); la tolerancia del condensador se transfiere directamente a fc.
Comprobación independiente. En fc el módulo es K/√
2 = 2,846 y la fase 135◦
(comprobado
con assert); además, el análisis nodal simbólico con A finito converge a (178).

### 38.3. Ejemplo S09-3-B Sallen-Key Butterworth

Enunciado. Diseñar un Sallen-Key de ganancia unitaria con f0 ≈ 1 kHz y respuesta Butterworth; verificar H(s), la sensibilidad a tolerancias y el efecto de GBW.

Datos y supuestos. C2 = 10 nF; C1 = 2C2 = 20 nF (dos de 10 nF en paralelo); R1 = R2 = R de la serie E24; GBW = 1 MHz.
Método. Se usa (179) y (180). La condición C1 = 2C2 fija Q = 0,7071; R ajusta f0.

Paso 1. Resistencia. R = 1/(ω0

√
C1C2) = 1/
2π · 1000 ·

√
2 · 10⁻⁸
= 11,25 kΩ; el valor E24 más cercano es 11 kΩ.
Paso 2. Resultados. ω0 = 6428 rad/s, f0 = 1023,1 Hz, Q = 0,7071. H(s) = 1/

1 + 2,2 × 10⁻⁴
s +
2,42 × 10⁻⁸
s

2
con s en rad/s.
Paso 3. Bode. En f0, −3,01 dB y −90◦ . A 2 kHz, −11,93 dB y −135,6

◦
; a 10 kHz, −39,60 dB;
pendiente entre 10 kHz y 100 kHz de −40,0 dB por década.

Paso 4. Tolerancias. Con R al 1 % y C al 5 % (4000 sorteos uniformes, semilla fija), f0 varía entre 972 Hz y 1084 Hz (±6,0 %) y Q entre 0,673 y 0,743; el pico máximo resultante es +0,04 dB.

Paso 5. GBW. Con el modelo de un polo, a 10 kHz la diferencia es de 0,02 dB; a 100 kHz, la atenuación cambia de −79,60 dB a −79,66 dB y la fase se desvía de −179,2

- a +175,1

◦
: el seguidor
real deja de seguir la señal a esa frecuencia (resultado del modelo de un polo, no de un dispositivo).

Interpretación. Los condensadores deben elegirse con tolerancia estrecha (película o NP0), porque Q depende de su razón y f0 de su producto. Las resistencias al 1 % bastan.

Comprobación independiente. H(s) coincide con la forma normalizada ω

2/0/(s

2 + ω0s/Q + ω
2/0)
evaluada con scipy.signal en nueve frecuencias (cuaderno). La Figura 89 muestra los dos filtros y la Figura 90 el efecto de Q y de las tolerancias.

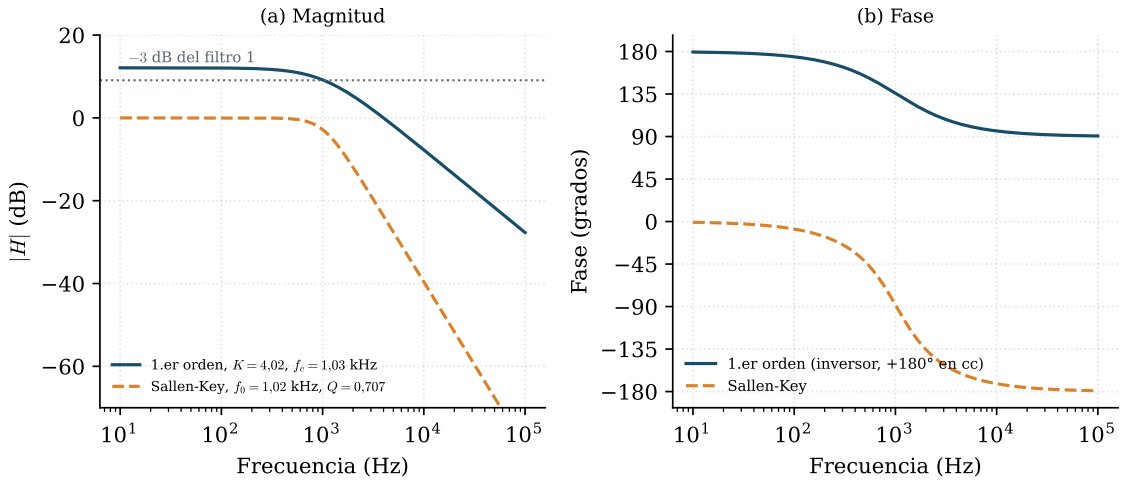
[picture p80: figure]
Frecuencia (Hz); jHj (d; ¡3 dB del filtro 1; (a) Magnitud; 1.er orden, K = 4;02, fc = 1;03 kHz Sallen-Key, f0 = 1;02 kHz, Q = 0;707; Fase (grados); (b) Fase; 1.er orden (inversor, +180° en cc) Sallen-Key

Figura 89: Cálculo del cuaderno de S09-3. (a) Magnitud: el filtro de primer orden tiene 12,1 dB de ganancia y cae a −20 dB por década; el Sallen-Key cae a −40 dB por década. (b) Fase en grados. Observe que ambos cruzan su mitad de variación en torno a 1 kHz.

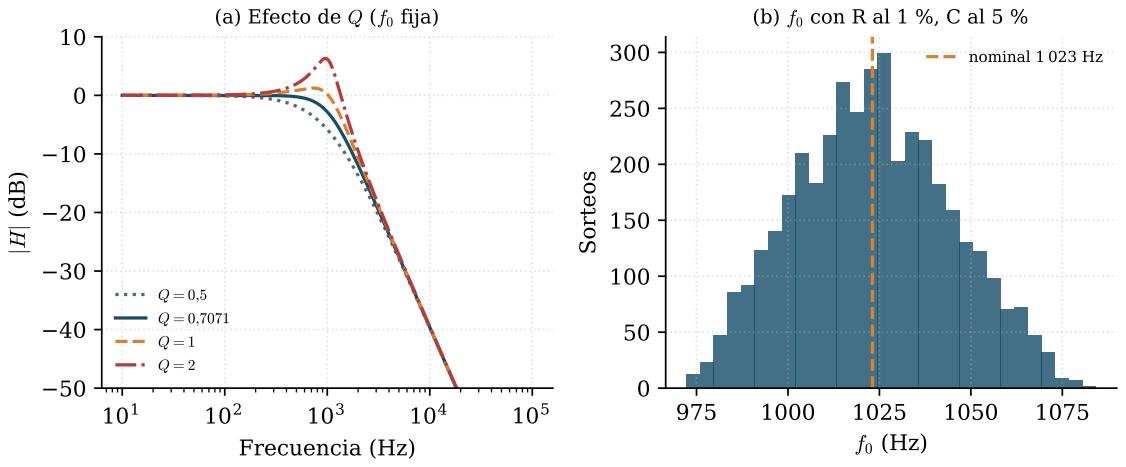
[picture p81: figure]
Frecuencia (Hz); jHj (d; (a) Efecto de Q (f0 fija); Sorteos; (b) f0 con R al 1 %, C al 5 %; nominal 1 023 Hz

Figura 90: Cálculo del cuaderno de S09-3. (a) Magnitud del Sallen-Key con f0 fija y distintos Q: a mayor Q, mayor pico. (b) Histograma de f0 con resistencias al 1 % y condensadores al 5 % (4000 sorteos con semilla fija).

Laboratorio S09-3: respuesta en frecuencia de dos filtros activos

Objetivo. Medir |H| y la fase de los dos filtros diseñados y contrastarlos con la predicción. Los resultados de medición los registra el estudiante; en esta guía las columnas de medición están vacías.
Seguridad y referencias. Solo baja tensión aislada: fuente dual de laboratorio de ±VCC (valor y modelo del operacional fijados por el docente, con GBW ≥ 1 MHz), generador con amplitud de 0,5 V pico sin componente continua. Verificar con el multímetro la polaridad de la alimentación antes de conectar y el desacoplo de 100 nF entre cada riel y tierra cerca del operacional. Las masas del generador, de la fuente y del osciloscopio se unen en un punto del montaje (Figura 91); no conectar la masa de una sonda a ningún nodo distinto de tierra. No usar el LM358 como sustituto sin revisar las condiciones de alimentación y de modo común.

Generador
sinusoidal
(amplitud baja,
sin continua)

Filtro bajo prueba
(protoboard)

Osciloscopio
CH1 y CH2

Fuente dual aislada
(baja tensión, ±VCC )
vi | vo a CH2

a CH1 (entrada)

+VCC , −VCC

masa común | masa común

Figura 91: Montaje de medición. CH1 mide la entrada y CH2 la salida; las dos sondas con su masa en tierra. El filtro bajo prueba se cambia entre el de primer orden y el Sallen-Key.

Preparación. (1) Medir con el medidor LCR o el multímetro los valores reales de las resistencias y condensadores y anotarlos. (2) Completar la columna de predicción con H(s) y los valores medidos. (3) Montar el filtro de primer orden de S09-3-A.

Procedimiento. (1) Aplicar una senoidal de 0,5 V pico a las frecuencias de la tabla; en cada punto medir la amplitud pico de vi y de vo con cursores, y el desfase con cursores de tiempo. (2) Hallar fc (la frecuencia donde la ganancia cae 3 dB respecto de la banda de paso).
(3) Medir la pendiente entre 5 kHz y 10 kHz. (4) Repetir con el Sallen-Key. (5) Comparar y explicar las diferencias: tolerancias, resistencia de salida del generador, carga de las sondas y GBW.
Tabla 1. Filtro de primer orden (S09-3-A). La predicción es resultado de cálculo con valores nominales; Vi y Vo son amplitudes pico; la medición queda vacía.

f (Hz) |H| pred. (dB) Fase pred. (◦

) Vi (V) Vo (V) |H| med. (dB) Fase med. (◦ )

100 | 12,05 | 174,4
200 | 11,93 | 169,0
500 | 11,17 | 154,0
1000 | 9,19 | 135,7
2000 | 5,28 | 117,2
5000 | −1,84 | 101,6
10000 | −7,73 | 95,9

Tabla 2. Sallen-Key (S09-3-B).

f (Hz) |H| pred. (dB) Fase pred. (◦

) Vi (V) Vo (V) |H| med. (dB) Fase med. (◦ )

100 | −0,00 | −7,9
200 | −0,01 | −16,0
500 | −0,24 | −42,2
1000 | −2,82 | −88,2
2000 | −11,93 | −135,6
5000 | −27,57 | −163,2
10000 | −39,60 | −171,7

Tabla 3. Resumen.

Magnitud | Predicción Medición Diferencia Causa probable
fc filtro 1 (Hz) | 1026
Ganancia en banda, filtro 1 (dB) | 12,09
f−3 dB Sallen-Key (Hz) | 1023
Pendiente 5–10 kHz, filtro 1 (dB/déc.) | ≈ −19,6
Pendiente 5–10 kHz, Sallen-Key (dB/déc.) | ≈ −40,0

Informe. Adjuntar tablas completas, capturas rotuladas como medición, valores reales de los componentes, la comparación con la predicción y una decisión justificada: ¿qué filtro usaría para atenuar ruido a 10 kHz en un sensor y por qué?

### 38.4. Ejercicios

S09-3-E1 (primer orden con ganancia). Diseñar un pasa bajas inversor con |K| = 10 y fc = 500 Hz con Ri = 10 kΩ. Elegir Rf y un Cf de la serie E12, hallar la fc real, el módulo en dB a 5 kHz y compararlo con el valor con GBW = 1 MHz. Si el generador tiene Rs = 600 Ω, hallar el error de ganancia.
S09-3-E2 (Sallen-Key con ganancia). Diseñar un Sallen-Key con resistencias iguales, condensadores iguales de 10 nF, f0 ≈ 2 kHz y K = 1,586 (Butterworth). Hallar R (E96), Ra = 10 kΩ y Rb (usar 5,9 kΩ), K, Q, f0 real, la ganancia en continua en dB y la variación de Q si Ra y Rb varían ±1 %.

Pregunta conceptual. ¿Por qué Q = 1/

√
2 da la respuesta máximamente plana y qué ocurre con la forma de |H| si Q sube a 2? ¿Qué ventaja y qué riesgo tiene subir K en lugar de ajustar C1/C2?

### 38.5. Errores frecuentes y comprobaciones

Errores frecuentes

Confundir fc en hercios con ωc en radianes por segundo al calcular Cf o R.

Olvidar que la fuente en serie con Ri cambia la ganancia y el diseño pierde su ganancia nominal.

Intercambiar C1 y C2 en el Sallen-Key (la condición C1 > C2 es necesaria para Q ≥ 0,5 con K = 1).

Medir en el laboratorio con una sonda con la masa en un nodo distinto de tierra, o con el generador con componente continua.

Comparar la medición con la predicción sin medir antes los componentes reales.

Describir una discrepancia sin identificar su causa con una estimación (tolerancia, GBW, carga de la sonda).

Criterios de comprobación: ganancia en continua; magnitud de −3 dB en fc (o f0 con Q = 1/

√
2);
pendiente asintótica; fase de −90◦
en f0; coherencia entre predicción y medición dentro de la tolerancia esperada.

### 38.6. Conexión con el curso

Estos filtros son el acondicionamiento previo a la adquisición: limitan el ancho de banda antes de convertir (semana 10, adquisición de datos). En el proyecto se pedirá justificar fc, Q y la ganancia según el sensor y el rango de entrada de la etapa siguiente, con evidencia de cálculo y de medición. Las capturas del osciloscopio se rotularán como medición y las del simulador como simulación.

### 39. Código y recursos de la semana

Código de la semana 9

Todos los cuadernos de Python están ejecutados, con salidas guardadas, y usan los estilos comunes de codigo/python/comun. Las figuras de curvas de este capítulo las genera el cuaderno indicado. Los scripts de MATLAB no se han ejecutado en este entorno.

codigo/python/semana_09/clase1_sumador_restador.ipynb: deducción nodal del sumador y del restador con A finito, ejemplos S09-1-A y S09-1-B, CMRR de peor caso en 16 vértices de tolerancia, ejercicios S09-1-E1 y S09-1-E2; genera sumador_restador.

codigo/python/semana_09/clase2_integrador_derivador_comparador.ipynb: H(s) del integrador y del derivador, simulación con lsim, margen de fase con el modelo de un polo, umbrales del disparador con colector abierto y simulación con ruido, ejercicios S09-2-E1 y S09-2-E2; genera integrador, derivador_bode, derivador_tiempo y schmitt.

codigo/python/semana_09/clase3_filtros_activos.ipynb: H(s) y Bode del filtro de primer orden y del Sallen-Key, tolerancias por simulación de Monte Carlo, efecto de GBW, predicciones de las tablas del laboratorio, ejercicios S09-3-E1 y S09-3-E2; genera bode_filtros y sk_sensibilidad.

codigo/matlab/semana_09/clase1_sumador_restador.m, clase2_integrador_derivador_comparador.m y clase3_filtros_activos.m:

scripts equivalentes (MATLAB base y Control System Toolbox), con la salvedad de que los sorteos aleatorios no reproducen los de NumPy.

### 40. Referencias de la semana

Fecha de consulta de todas las referencias: 2026-11-03.

1. Texas Instruments. LM393B, LM2903B, LM193, LM293, LM393 and LM2903 Dual Com-parators. Hoja de datos SLCS005AH, octubre de 1979, revisada en abril de 2025. https: //www.ti.com/lit/ds/symlink/lm393.pdf.
2. Texas Instruments. LM358, LM358B, LM2904 and related: Industry-Standard Dual Operational Amplifiers. Hoja de datos SLOS068AB, junio de 1976, revisada en octubre de 2024. https://www.ti.com/lit/ds/symlink/lm358.pdf.
3. Karki, J. Analysis of the Sallen-Key Architecture. Texas Instruments, informe de aplicación SLOA024B, julio de 1999, revisado en septiembre de 2002. https://www.ti.com/lit/an/sloa024b/sloa024b.pdf. (https://www.ti.com/lit/an/sloa024b/sloa024b.pdf)

### Parte X

# Semana 10: Sensores y adquisición de datos

### 41. S10-1 Concepto de sensor y tipos

Resultados, prerrequisitos y distribución

Al terminar, el estudiante podrá (1) clasificar un sensor por magnitud medida, principio físico y tipo de salida, y describirlo con sensibilidad, offset, rango y tiempo de respuesta; (2) acondicionar un sensor resistivo con un divisor de tensión y calcular su sensibilidad en un punto de operación;
(3) estimar el error por autocalentamiento y el retardo dinámico de un sensor de primer orden. Se comprueba al final con el ejercicio S10-1-E2 y la pregunta conceptual.
Prerrequisitos: divisor de tensión y equivalente de Thévenin (S01-1), respuesta de primer orden y constante de tiempo (semana 3) y ganancia de un amplificador no inversor (semana 8). Esta sesión no usa hojas de datos; todos los parámetros de sensores son datos de ejemplo de práctica, no valores de un fabricante.

Distribución propuesta de 120 minutos

Diagnóstico, 10 min (¿qué magnitud mide un teléfono móvil y con qué sensor?, sin calificar). Explicación, 30 min. Ejemplos guiados, 35 min. Práctica de los ejercicios, 30 min. Cierre y contraste, 15 min. Trabajo previo, no presencial: repasar el divisor de tensión y la respuesta al escalón de un RC. El docente puede dedicar parte del cierre a presentar el hilo conductor del proyecto: qué magnitud medirá cada grupo.

### 41.1. Concepto físico y modelo

Un sensor convierte una magnitud física o química de interés (temperatura, presión, nivel, luz, corriente) en una señal que un sistema puede procesar, normalmente eléctrica. Se usa transductor para el elemento que realiza la conversión de energía; el sensor incluye además el encapsulado y a veces una electrónica mínima, y un transmisor entrega una señal normalizada. En el curso se trabaja la cadena de la Figura 92: la señal del sensor casi nunca es compatible con el convertidor

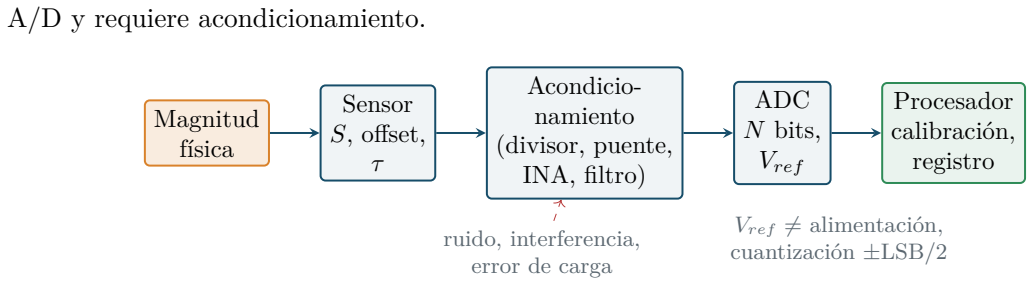
[picture p82: figure]
A/D y requiere acondicionamiento.; Magnitud física; Sensor S, offset, τ; Acondicio- namiento (divisor, puente, INA, filtro); ADC N bits,; Vref; Procesador calibración, registro; ruido, interferencia, error de carga; Vref ̸= alimentación, cuantización ±LSB/2

Figura 92: Cadena de medida del curso: del fenómeno físico al dato. Cada bloque agrega errores (carga, ruido, cuantización) que se estudian esta semana. La referencia Vref del ADC es una especificación propia del convertidor y no es, en general, la tensión de alimentación.

Modelo estático. Sea x la magnitud medida (por ejemplo, temperatura en ◦C) y v la salida eléctrica. Para un sensor con comportamiento lineal en su rango

v = v0 + S x, S =

dv
dx
| , | (182)

donde v0 es el offset (salida con x = 0) y S la sensibilidad, con unidades de salida sobre unidad de entrada (mV/

◦C). Si el sensor no es lineal, S depende del punto de operación y se evalúa como pendiente local. Otros términos: rango (valores de x en que el modelo y la especificación valen), resolución (menor cambio detectable), exactitud (cercanía al valor verdadero), repetibilidad (dispersión al repetir la medida en las mismas condiciones), linealidad (desviación respecto a una recta de ajuste), histéresis y deriva. Exactitud y resolución no son lo mismo: un sensor puede mostrar muchas cifras y estar sesgado.

Modelo dinámico. Muchos sensores térmicos y de gas se comportan como un sistema de primer orden con constante de tiempo τ . Con condiciones iniciales en equilibrio, ante un escalón de x de x1 a x2 la indicación es

xm(t) = x1 + (x2 − x1)

1 − e

−t/τ
, | t90 = τ ln 10 ≈ 2,30 τ. | (183)

Ante una rampa de pendiente ρ, el error permanente de retraso es ρ τ . Este modelo asume que no hay retardo puro y que τ no cambia con la condición de montaje; esto último suele ser falso (aire quieto o en movimiento, con o sin vaina).

Tipos de sensores. La Tabla 12 organiza las familias más comunes por el tipo de salida, que determina el acondicionamiento.

Salida | Ejemplos de principio | Acondicionamiento y atención
Resistiva | NTC, RTD, galga exten-
| sométrica, LDR | Divisor o puente con excitación conocida; limitar la corriente
| | por autocalentamiento; cables largos añaden resistencia.
Tensión analógi- ca | Termopar (µV), sensor
| integrado con salida li-
| neal | Amplificación, filtrado; la impedancia de salida y la carga del
| | ADC afectan la lectura.
Corriente | Lazo de 4 mA a 20 mA | Resistencia de conversión a tensión; admite cables largos; va-
| | lorar la caída en el lazo.
Digital con bus | I2C, SPI, 1-Wire | Convertidor interno; verificar dirección, niveles lógicos y tasa
| | de muestreo; la calibración sigue siendo necesaria.
Frecuencia o pulsos
Caudalímetros, | encó-
| ders | Entrada de captura o interrupción; antirrebote y niveles lógi-
| | cos.

Cuadro 12: Clasificación práctica de sensores por tipo de salida.

Un sensor se llama pasivo si necesita excitación (NTC, RTD) y activo si genera su propia señal (termopar, fotodiodo en modo fotovoltaico). Un sensor «digital» incluye un ADC; no elimina el error de cuantización ni la necesidad de verificar contra un patrón.

Sensor resistivo en divisor. Un termistor NTC sigue, en un rango acotado, el modelo de dos parámetros
Rt(T) = R0 exp
β

1
| | T

−

1
| | T0
, | (184)

con T y T0 en kelvin, R0 la resistencia a T0 y β una constante del material (aquí 3950 K, dato de ejemplo). En el divisor de la Figura 93, sin carga,

vo = Vcc

Rt
Rt + R

, S(T) = dvo
dT

= Vcc

R
(R + Rt)

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
. | (185)

La sensibilidad es máxima cuando R ≈ Rt en el punto de interés. La salida no es lineal: la Figura 94 muestra la desviación respecto a la tangente. La corriente por el termistor implica disipación P = I

2Rt y, con una constante de disipación δ (potencia por kelvin de calentamiento), un error ∆T = P/δ.

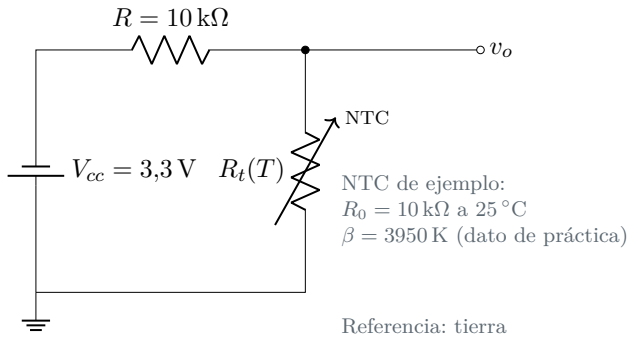
[picture p83: figure]
Vcc = 3,3 V; NTC de ejemplo: R0 = 10 kΩ a 25 ◦C β = 3950 K (dato de práctica); NTC; Referencia: tierra

Figura 93: Divisor con termistor NTC (parámetros de ejemplo). La salida vo se toma sobre el NTC respecto de tierra; al conectar un ADC, su impedancia de entrada queda en paralelo con Rt

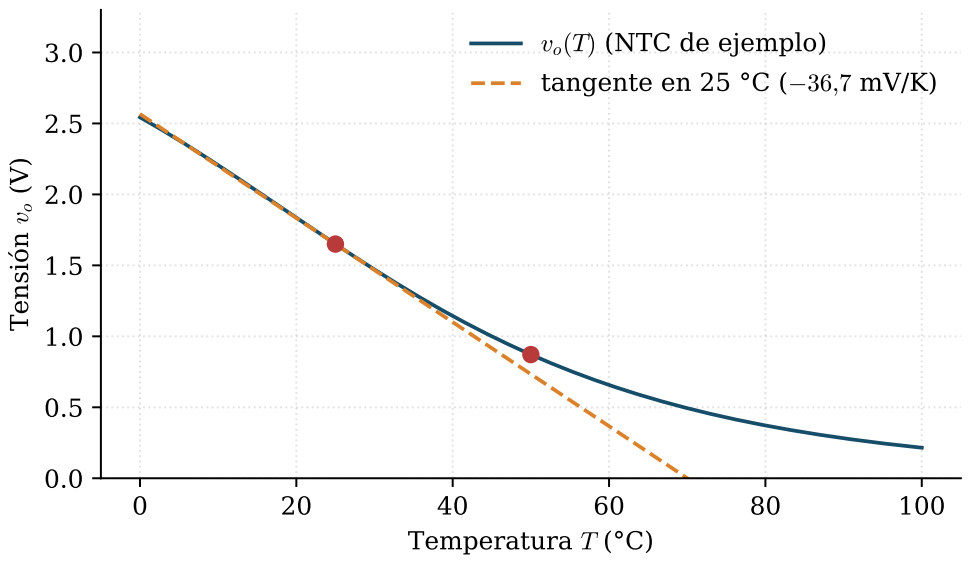
[picture p84: figure]
Temperatura T (°C); nsió; vo(T) (NTC de ejemplo) tangente en 25 °C (¡36;7 mV/K)

Figura 94: Salida del divisor de la Figura 93 en función de la temperatura (cálculo, notebook clase1_sensores). La tangente en 25 ◦C se aleja de la curva a medida que cambia T: la sensibilidad no es constante.

### 41.2. Ejemplo S10-1-A Divisor con NTC y sensibilidad local

Enunciado. Con la Figura 93, Vcc = 3,3 V, R = 10 kΩ, R0 = 10 kΩ a T0 = 25 ◦C y β = 3950 K (datos de ejemplo). Calcular vo a 25 ◦C y a 50 ◦C, y la sensibilidad a 25 ◦C. Sin carga.

Datos y supuestos. T0 = 298,15 K, T = 323,15 K. Sin carga en vo, termistor descrito por (184). Incógnitas: vo(25), vo(50), S(25).

Método. Se aplica el divisor (185); para S se deriva el modelo.

A 25 ◦C: Rt = R0 = 10 kΩ y vo = 3,3 ·

10
20

= 1,650 V.

A 50 ◦C:

Rt = 10 000 exph

3950
1
323,15 −

1

298,15i = 3588 Ω, | (186)

vo = 3,3 ·

3588
3588 + 10 000
= 0,871 V. | (187)

Sensibilidad a 25 ◦C:

dRt
dT

= −

3950 · 10 000
298,15²

= −444,4 Ω/K, S = 3,3 ·

10 000
(20 000)²
- (−444,4) = −36,66 mV/K. (188)

Interpretación. Por cada grado que sube la temperatura, la salida baja unos 37 mV. A 50 ◦C la pendiente es menor (−24,3 mV/K): la sensibilidad cae a medida que el NTC se aleja de Rt ≈ R. Comprobación independiente. Una derivada numérica centrada de vo(T) en 25 ◦C (paso 10⁻⁴ K) coincide con −36,66 mV/K, y vo(25) = Vcc/2 por simetría del divisor (cálculos en el notebook clase1_sensores).

### 41.3. Ejemplo S10-1-B Respuesta dinámica de un sensor de primer orden

Enunciado. Un sensor de temperatura de ejemplo tiene τ = 8 s. Se sumerge en un medio que pasa de 25 ◦C a 60 ◦C. Calcular (a) el tiempo para indicar el 90 % del cambio, (b) la indicación en t = τ y (c) el error permanente si el medio se calienta a 2

◦C/min.

Método. Se usa el modelo (183), con condiciones iniciales de equilibrio.

(a) t90 = τ ln 10 = 8 · 2,3026 = 18,42 s.
(b) xm(τ ) = 25 + 35 (1 − e

−1

) = 25 + 35 · 0,6321 = 47,12 ◦C.

(c) ρ = 2 ◦C/min = 0,0333 ◦C/s y el retraso permanente es ρτ = 0,267 ◦C.

Interpretación. Un sensor lento no puede seguir una variación rápida: la frecuencia de muestreo del ADC no compensa la lentitud del sensor (Figura 95).

Comprobación independiente. Sustituyendo t90 en (183) resulta 56,5

◦C, que es 25 + 0,9 · 35.

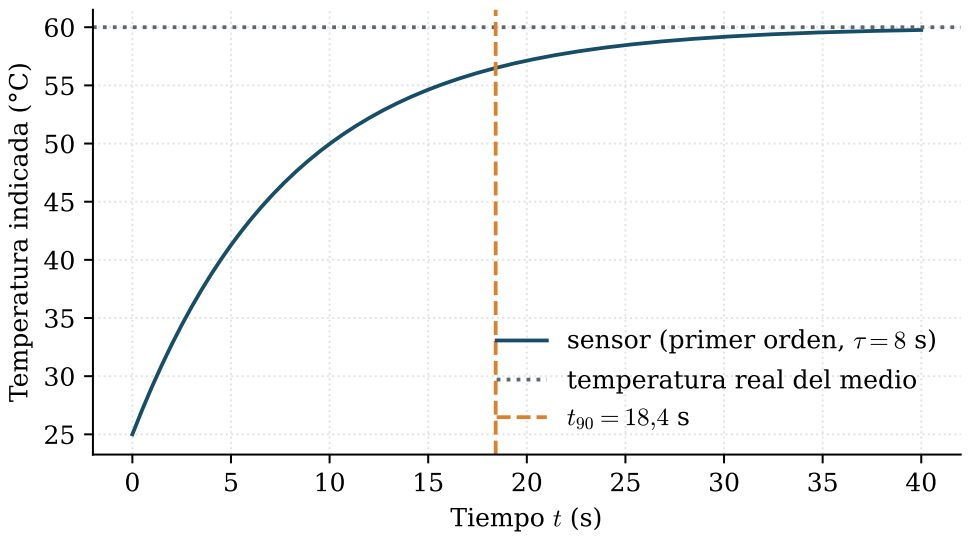
[picture p85: figure]
Tiempo t (s); Temperatura indicada (°C); sensor (primer orden, ¿ = 8 s) temperatura real del medio t90 = 18;4 s

Figura 95: Respuesta al escalón del sensor del ejemplo S10-1-B (cálculo). La línea de puntos es la temperatura del medio; la de trazos marca t90.

### 41.4. Ejercicios

S10-1-E1 (rango y acondicionamiento). Un sensor de presión de ejemplo entrega 0,5 V a 0 bar y 4,5 V a 10 bar, con comportamiento lineal y alimentado a 5 V. Hallar la sensibilidad y la tensión a 7 bar. La entrada del ADC solo admite 0 V a 3,3 V: diseñar un divisor resistivo que entregue como máximo 3,0 V a 10 bar, con Ra = 10 kΩ en serie, y dar la tensión a 7 bar y la resistencia de Thévenin que ve el ADC. Indicar qué condición debe cumplir la impedancia de entrada del ADC. S10-1-E2 (autocalentamiento). El NTC de la Figura 93 funciona a 25 ◦C con Vcc = 3,3 V y R = 10 kΩ. Su constante de disipación en aire quieto es δ = 1,5 mW/K (dato de ejemplo). Hallar la potencia disipada y el error de temperatura. Cuantificar la mejora si la tensión se aplica solo el 10 % del tiempo.

Pregunta conceptual. Un sensor de temperatura indica siempre 2

◦C más que un patrón, pero repite la lectura con una variación de 0,05 ◦C. ¿Es preciso, exacto, ambas cosas o ninguna? ¿Qué procedimiento corrige el sesgo?

### 41.5. Errores frecuentes y comprobaciones

Confundir resolución del instrumento con exactitud del sensor.

Suponer lineal un sensor que solo lo es en un rango y evaluar S fuera de él.

Usar T en ◦C dentro de exp del modelo del NTC: debe ir en kelvin.

Conectar la salida del divisor a un ADC de baja impedancia sin recalcular el divisor con carga.

Ignorar la disipación del sensor y la constante de tiempo cuando se decide la frecuencia de muestreo.

Considerar que un sensor digital no necesita calibración.

### 41.6. Conexión con el proyecto

Cada grupo escribe la ficha de su magnitud: rango, resolución necesaria, velocidad de variación y tipo de sensor candidato, con la justificación. Esa ficha alimenta la selección del miércoles y el diseño de la semana 14. Lectura previa para el miércoles: encontrar la hoja de datos de un sensor de temperatura y localizar su alimentación, salida y exactitud.

### 42. S10-2 Datasheets, lectura de planos y selección de sensores

Resultados, prerrequisitos y distribución

Al terminar, el estudiante podrá (1) extraer de una hoja de datos los parámetros que condicionan el diseño (alimentación, salida, exactitud con su condición de ensayo, límites típicos y garantizados); (2) leer un plano esquemático e identificar referencia, nodos, designadores y efecto de cada componente;
(3) construir un presupuesto de error y justificar la selección de sensor y resolución del ADC. Se comprueba con S10-2-E1 y S10-2-E2.
Prerrequisitos: S10-1 (modelo del sensor), divisor con carga (S01-1), parámetros reales de operacionales (semana 7) y ganancia del no inversor (semana 8).

Distribución propuesta de 120 minutos

Diagnóstico, 10 min (¿qué significa «típico» frente a «máximo»?). Explicación, 25 min. Ejemplos guiados, 35 min. Práctica de los ejercicios, 35 min. Cierre, 15 min. Trabajo previo: cada estudiante trae la hoja de datos de un sensor de su proyecto, con alimentación, salida y exactitud marcadas. Sin laboratorio esta sesión.

### 42.1. Concepto, método de lectura y modelo de error

Una hoja de datos describe un componente bajo condiciones de ensayo definidas. Se lee en este orden: (1) condiciones absolutas máximas (no son condiciones de funcionamiento); (2) condiciones recomendadas (alimentación, temperatura); (3) tabla eléctrica, donde cada parámetro tiene condición de ensayo y columnas típico, límite ensayado o de diseño; (4) curvas típicas (informativas, no garantizadas); (5) circuito de aplicación, encapsulado y asignación de pines. Una cifra «típica» describe un valor central y no es una garantía de diseño.

Caso de lectura: LM35. Se usa el sensor de temperatura integrado LM35 de Texas Instruments (hoja SNIS159H, revisión de diciembre de 2017, consultada el 2026-11-03). Valores tomados de ese documento: factor de escala lineal de 10,0 mV/

◦C; alimentación de 4 V a 30 V; para la versión LM35A, exactitud a 25 ◦C de ±0,2

◦C (típica) y ±0,5

◦C (límite ensayado), y ±1

◦C (límite ensayado)
a las temperaturas extremas del rango especificado (−55 ◦C a 150 ◦C); regulación de carga típica de ±0,4 mV/mA a 25 ◦C; corriente de reposo del orden de 56 µA a 5 V (típica). La exactitud se define respecto de 10 mV/

◦C×Tcaja. El circuito básico funciona desde unos 2

◦C; para temperaturas
negativas se usa el circuito de rango completo del documento. Dos consecuencias: el dispositivo no funciona con un riel de 3,3 V (mínimo 4 V) y la salida debe acondicionarse para el rango del ADC. Las cifras citadas deben cotejarse con la hoja vigente antes de un diseño real.

Presupuesto de error. Cada fuente de error ek se expresa en la magnitud medida (aquí ◦C). Si no se conoce la correlación entre fuentes, se dan dos cotas: la suma de peor caso y la combinación cuadrática (RSS), válida solo si las fuentes son independientes y de magnitud comparable:

epc =

X

k

|ek|, | eRSS =

sX

k

e

2
k
. | (189)

Un error de ganancia se refiere a la lectura a fondo de escala. Para un no inversor, G = 1 + Rf /Rg, con tolerancia fraccional t en ambas resistencias, Gmax = 1 + Rf (1+t)
Rg(1−t)

Lectura de planos. Un esquema se lee desde las alimentaciones a la señal: qué es la referencia (símbolo de tierra), qué designador corresponde a cada componente (U circuitos integrados, R, C, J conectores) y qué hace cada uno. Un condensador de 100 nF entre alimentación y tierra junto al circuito integrado es de desacoplo. Un RC en la salida es un filtro de primer orden con fc = 1/(2πRC), y su resistencia, junto con la carga, forma un divisor. La Figura 96 es el plano de

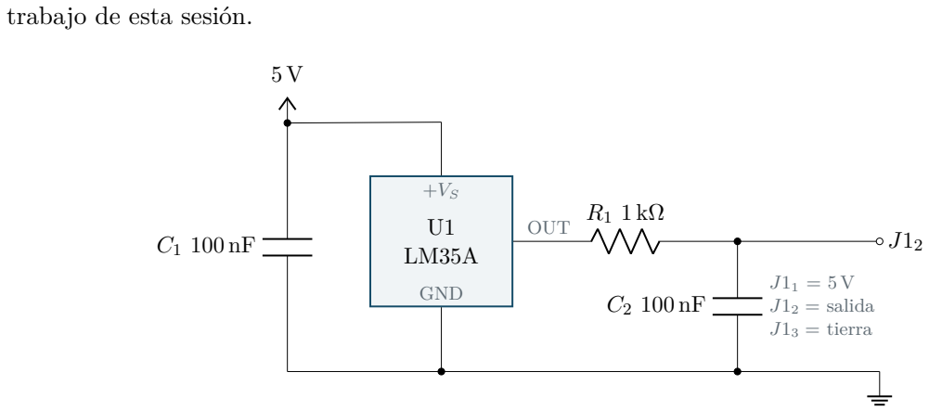
[picture p86: figure]
trabajo de esta sesión.; OUT; GND; J11 = 5 V J12 = salida J13 = tierra

Figura 96: Plano de un módulo de temperatura (valores de práctica): sensor U1 alimentado a 5 V con desacoplo C1, filtro R1C2 y conector J1 hacia el ADC. Todas las tensiones se miden respecto de la tierra inferior.

### 42.2. Ejemplo S10-2-A Lectura de la hoja de datos y adaptación al ADC

Enunciado. Se mide de 5

◦C a 100 ◦C con un LM35A alimentado a 5 V. El ADC es de 12 bits con referencia externa Vref = 2,5 V (dato de ejemplo; no es la alimentación). Hallar la tensión de salida a 100 ◦C, decidir si se necesita ganancia, y la resolución y el error de cuantización en ◦C. Calcular también el error por carga si el nodo alimenta un divisor de 10 kΩ a 1 V.

Datos. S = 10 mV/

◦C (hoja de datos), N = 12, Vref = 2,5 V.

Método. Convertir el rango en tensión, comparar con la entrada del ADC y obtener el escalón LSB = Vref /2

N .

v(100) = 0,010 · 100 = 1,000 V < 2,5 V, | (190)
LSB = 2,5
4096

= 610,4 µV,

LSB
S
= 0,0610 ◦C por cuenta, | eq = ±
| 0,0610
| 2 = ±0,0305 ◦C.
| (191)

Con ganancia G = 2 (no inversor) la salida llega a 2,000 V y el escalón baja a LSB/(GS) = 0,0305 ◦C, con eq = ±0,0153 ◦C. La ganancia mejora la resolución mientras la salida del amplificador se mantenga dentro del ADC y de su propio rango de salida.

Carga. Un divisor de 10 kΩ a 1 V toma 0,1 mA; con la regulación de carga típica, el cambio de salida es 0,4 · 0,1 = 0,04 mV, es decir 0,004 ◦C: despreciable.

Interpretación. El sensor entrega un máximo de 1 V, el 40 % del rango del ADC. Sin ganancia se desperdician 1,3 bits.
Comprobación independiente. El número de niveles en el rango de 95 ◦C es 95/0,0610 = 1557, menor que 4096 (aprovecha el 38 % del código). Con G = 2 resultan 3115 niveles, el doble. Cálculos en clase2_datasheets.ipynb.

### 42.3. Ejemplo S10-2-B Presupuesto de error y selección

Enunciado. Para el sistema anterior con G = 2 se exige un error total menor o igual a ±1,5

◦C en
100 ◦C. Evaluar con resistencias de ganancia de 1 % y de 0,1 %. Se asume un offset del amplificador de ±1 mV referido a la entrada (dato de ejemplo) y el límite ensayado del sensor de ±1

◦C, tomado
como cota conservadora en 100 ◦C porque la hoja solo lista valores a 25 ◦C y a los extremos del rango.
Método. Convertir cada fuente a ◦C y comparar con (189).

Ganancia con tolerancia t. Con Rf = Rg = 10 kΩ:

t = 0,01 : Gmax = 1 + 1,01 0,99 = 2,0202,

∆G

G = 1,01 % ⇒ 1,01 ◦C en 100 ◦C, | (192)

t = 0,001 : ∆G

G = 0,10 % ⇒ 0,10 ◦C. | (193)

Offset. 1 mV/(10 mV/

◦C) = 0,10 ◦C. Cuantización. 0,0153 ◦C.

Fuente (◦C) | Resistencias 1 % | Resistencias 0,1 %
Sensor | 1,000 | 1,000
Ganancia | 1,010 | 0,100
Offset | 0,100 | 0,100
Cuantización | 0,015 | 0,015
Suma de peor caso | 2,125 | 1,215
RSS | 1,425 | 1,010

Cuadro 13: Presupuesto de error en 100 ◦C (cotas; cálculo, clase2_datasheets.ipynb).

Interpretación. Con resistencias de 1 % la suma de peor caso (2,125 ◦C) no cumple y el RSS (1,425 ◦C) cumple con poco margen, bajo el supuesto de independencia. Con 0,1 % ambos cumplen. La mayor contribución evitable es la ganancia, no el ADC: pasar de 12 a 16 bits no mejoraría nada. Una calibración de dos puntos (S10-3) elimina el error de ganancia y de offset del acondicionamiento, pero no el del sensor si no se calibra con él conectado.

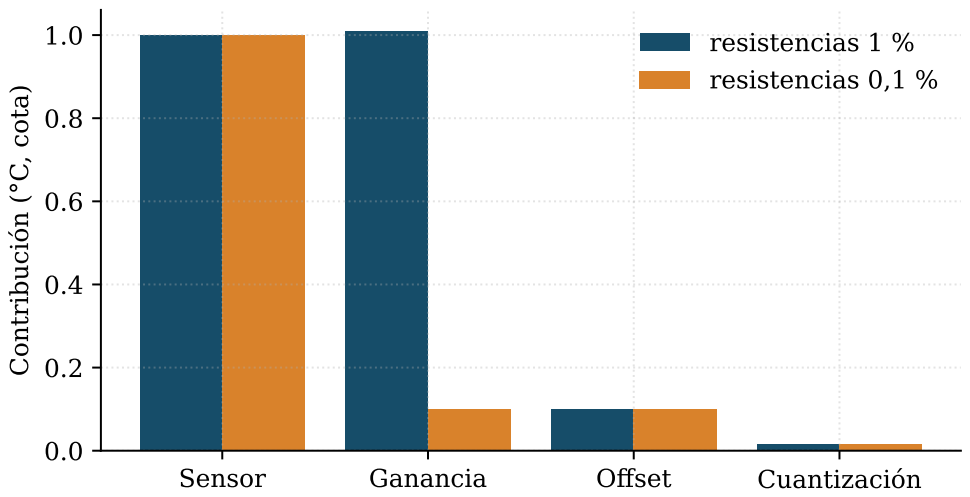
[picture p87: figure]
Sensor; Ganancia; Offset; Cuantización; Contribución (°C, cota); resistencias 1 % resistencias 0,1 %

Figura 97: Contribución de cada fuente de error en 100 ◦C con resistencias de 1 % (azul) y de 0,1 % (naranja, rayado). Observe que la ganancia domina en el primer caso.

Comprobación independiente. La relación Gmax se verificó evaluando las cuatro combinaciones extremas de tolerancias; la mayor es 2,0202. La suma de la tabla reproduce 2,125 ◦C.

### 42.4. Ejercicios

S10-2-E1 (lectura de plano y carga). En la Figura 96 el sensor mide 37 ◦C. La entrada del ADC se modela como una resistencia de 100 kΩ a tierra (dato de ejemplo). Hallar la tensión en J1 pin 2, el error en ◦C causado por R1 y la frecuencia de corte del filtro R1C2. Proponer un cambio para reducir el error.

S10-2-E2 (selección de resolución). Se requiere resolución de 0,1

◦C en 0

◦C a 100 ◦C con el
sensor de este plano. (a) ¿Cuántos bits mínimos de ADC hacen falta si el escalón debe ser igual a la resolución y se usa todo el rango de código? (b) Con G = 1 y Vref = 2,5 V, ¿cuántos bits hacen falta para que LSB ≤ 1 mV? Explicar la diferencia.

Pregunta conceptual. Una hoja de datos da exactitud «típica» de ±0,2

◦C y «ensayada» de
±0,5

◦C. ¿Cuál cifra usa para un diseño que debe cumplir una especificación en producción y por qué?

### 42.5. Errores frecuentes y comprobaciones

Leer solo la primera página y diseñar con el valor típico como si fuera garantizado.

Ignorar la condición de ensayo (temperatura, alimentación, corriente de carga) de un parámetro.

Alimentar un sensor con un riel inferior a su mínimo de alimentación (el LM35 pide 4 V).

Suponer que Vref del ADC es igual a la alimentación del microcontrolador.

Sumar fuentes de error sin convertirlas a la misma magnitud, o aplicar RSS a fuentes correlacionadas.

Confundir designadores o seguir un cruce de líneas sin punto como conexión.

### 42.6. Conexión con el proyecto

Cada grupo entrega una hoja de una página: sensor candidato, parámetros extraídos con su condición de ensayo y página de la hoja, rango de salida frente a la entrada del ADC elegido, y presupuesto de error. Debe identificar qué requisito falla primero. Para el jueves, traer el plano de acondicionamiento propuesto.

### 43. S10-3 Interfaz con sensores, adquisición y calibración

Resultados, prerrequisitos y distribución

Al terminar, el estudiante podrá (1) acondicionar un sensor resistivo con un puente y un amplificador diferencial o de instrumentación y justificar la elección; (2) calcular el escalón, el error de cuantización, la relación señal-ruido (SNR) y el efecto del promediado de un ADC de N bits con referencia Vref propia; (3) calibrar un canal con dos puntos y verificarlo con puntos independientes. Se comprueba con S10-3-E1 y S10-3-E2.
Prerrequisitos: S10-1 y S10-2, amplificadores diferencial y no inversor (semanas 8 y 9), decibelios (semana 6).

Distribución propuesta de 120 minutos

Se ofrecen dos configuraciones, a decidir por el docente porque el segundo parcial cae en esta semana (semana 10, jueves; sin hora fijada en las fuentes). Opción A, sin parcial el jueves: diagnóstico 10 min, explicación 30, ejemplos 35, práctica 30, cierre 15; el laboratorio de calibración se hace como trabajo autónomo. Opción B, con Parcial 2 el mismo jueves: 40 min de clase (ejemplos A y B resumidos, calibración del ejemplo C en el cierre) y 80 min de parcial (Sección «Parcial 2»); los ejercicios y el laboratorio pasan a trabajo autónomo. Trabajo previo: traer el plano de acondicionamiento del miércoles.

### 43.1. Concepto físico y modelo

Acondicionamiento. Se adapta la señal del sensor al rango, impedancia y ruido del ADC.

Divisor: simple, no lineal, para sensores resistivos de gran variación (S10-1). Su salida tiene un nivel continuo grande.

Puente de Wheatstone: convierte una pequeña variación de resistencia en una diferencia de tensión, sin el nivel continuo del divisor. Con excitación Vex y la rama Rs inferior derecha (Figura 98)
vb = vB − vA = Vex

Rs
Rs + R

−

1
2
, | (194)

que es nulo cuando Rs = R. La relación vb(Rs) no es lineal y los dos nodos A y B tienen un nivel de modo común de Vex/2, ninguno de ellos a tierra.

Amplificador diferencial de cuatro resistencias: Gd = R2/R1. Con resistencias de tolerancia fraccional t, el rechazo de modo común limitado por el apareamiento es aproximadamente

CMRR ≈

1 + Gd
4t
. | (195)

Es una cota de peor caso; la CMRR del propio operacional se suma. Un diferencial carga el puente con una impedancia modesta.

Amplificador de instrumentación (tres operacionales o circuito integrado dedicado): entradas de alta impedancia y ganancia fijada por una resistencia Rg. En la estructura clásica, con RF iguales en la etapa de entrada, G = 1 + 2RF /Rg (la etapa de salida de ganancia unitaria). Los circuitos integrados dedicados definen su propia fórmula y rango de modo común en su hoja de datos; no se asumen aquí.

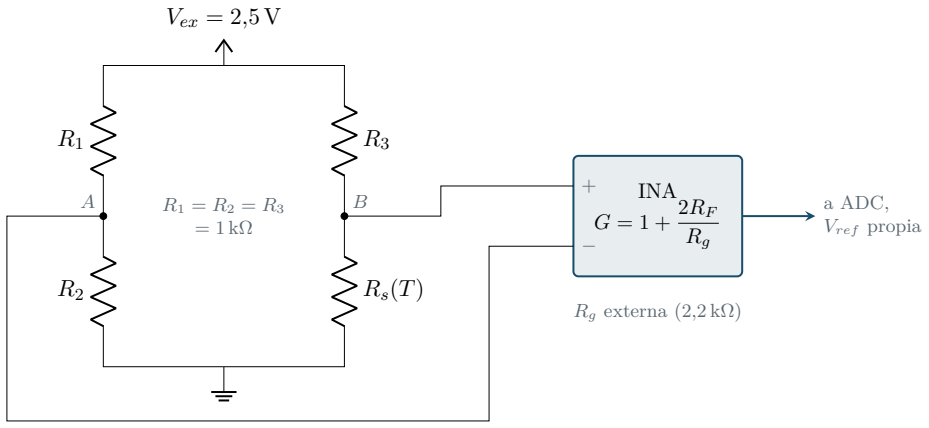
[picture p88: figure]
Vex = 2,5 V; INA; a ADC, Vref propia; Rg externa (2,2 kΩ)

Figura 98: Puente de Wheatstone con Rs(T) (sensor resistivo de ejemplo) y amplificador de instrumentación. A y B están a un nivel de modo común Vex/2; el amplificador debe aceptarlo en su rango de entrada. La salida alimenta un ADC con su propia Vref .

En todos los casos se declaran alimentación, rango de modo común de entrada y excursión de salida del amplificador. Un operacional alimentado a un solo riel no llega a 0 V de salida salvo que sea de salida a carril; la señal debe quedar dentro de ese margen, o se añade un nivel de referencia.

Conversión A/D. Un ADC de N bits con referencia Vref (rango 0 a Vref ) divide el rango en 2

N escalones:

LSB = Vref
2N

, n =

vin
LSB
(o redondeo, según el convertidor), eq ∈

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
. (196)

Con redondeo, el error de cuantización es aproximadamente uniforme y su valor eficaz es LSB/

√
12.
Para una senoidal de escala completa, la SNR ideal es
SNRideal = 6,02 N + 1,76 dB, | (197)

y con ruido total adicional se define SNR = 20 log10(Vrms,señal/Vrms,ruido) y el número efectivo de bits ENOB = (SNR − 1,76)/6,02. Si el ruido es blanco y no correlacionado entre muestras, promediar M lecturas reduce el ruido eficaz por √
M (mejora de 10 log10 M dB), con la condición de que la señal no cambie durante el promedio y de que no haya error sistemático (un sesgo no se promedia). La referencia Vref es una característica del convertidor, que puede ser interna, externa o derivada de la alimentación según la variante; no se asume igual a la alimentación. En ESP32 y Raspberry Pi, rango, atenuación y linealidad del ADC dependen de la variante y revisión: se verifican con documentación del fabricante cuando se fije la placa (semana 12).

Conversión D/A. Un DAC de N bits produce v = n Vref /2

N , con el mismo escalón Vref /2

N y
un error de cuantización de ±LSB/2 si se redondea el valor deseado. Un DAC de 10 bits con 3,3 V de referencia tiene un escalón de 3,22 mV. Aparece en actuadores y referencias programables; su tratamiento se limita aquí a esta definición.

Calibración de dos puntos. Se aplican al canal dos valores de referencia conocidos x1, x2 (medidos con un patrón mejor que el canal) y se registran las cuentas n1, n2. Suponiendo un canal

lineal,
x(n) = x1 + k (n − n1), k =

x2 − x1
n2 − n1
. | (198)

Corrige offset y ganancia del conjunto sensor, acondicionamiento y ADC, pero no la no linealidad: por eso se verifica con puntos intermedios no usados para calibrar. La incertidumbre del patrón se propaga a k. Los puntos de calibración se eligen cerca de los extremos del rango de trabajo.

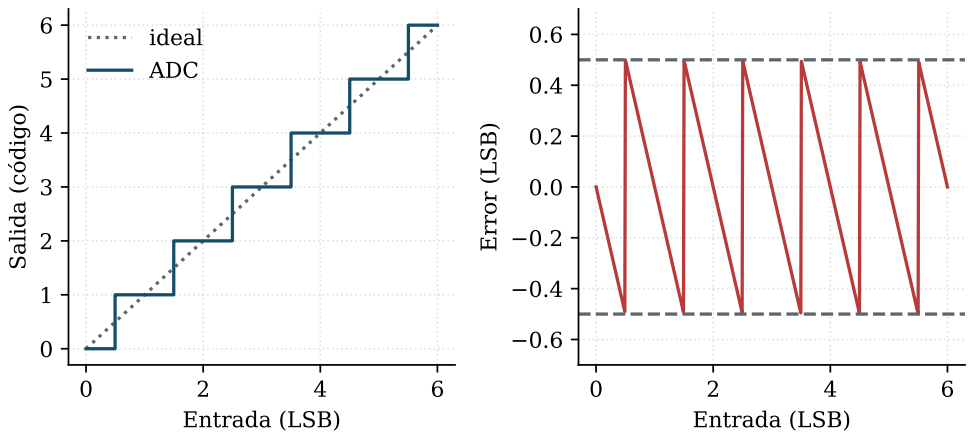
[picture p89: figure]
Entrada (LSB); Salida (código); ideal; ADC; Error (LSB)

Figura 99: Cuantización con redondeo (cálculo): la función de transferencia en escalera (izquierda) y el error acotado a ±0,5 LSB (derecha).

### 43.2. Ejemplo S10-3-A Puente con sensor resistivo e instrumentación

Enunciado. En la Figura 98, Vex = 2,5 V, R1 = R2 = R3 = 1 kΩ y Rs = 1000(1 + 0,00385 T) Ω con T en ◦C (parámetros de ejemplo, no de una hoja de datos). Hallar vb a 0

◦C y 100 ◦C, la sensibilidad en 0

◦C, la desviación respecto a una recta con esa pendiente a 100 ◦C y la ganancia necesaria para llevar 100 ◦C cerca de 2 V; con RF = 10 kΩ hallar Rg.

Datos y supuestos. Fuente de excitación ideal y estable, salida del puente sin carga (amplificador de entrada de impedancia muy alta), resistencias fijas ideales. Incógnitas: vb, S, G, Rg.

Método. Se aplica (194); la ganancia se obtiene de G = 2/vb(100) y de G = 1 + 2RF /Rg.

Rs(0) = 1000 Ω ⇒ vb = 0; Rs(100) = 1385 Ω ⇒ vb = 2,5

1385
2385 − 0,5
= 0,2018 V. (199)

S(0) = Vex

R
(R + Rs)

2

dRs
dT

= 2,5 ·

1000
2000²
- 3,85 = 2,406 mV/
◦C. | (200)

La recta con esa pendiente daría 240,6 mV a 100 ◦C; la desviación es de 38,8 mV, el 16 % del valor lineal. Para ganancia, G = 2/0,2018 ≈ 9,91; con RF = 10 kΩ, Rg = 2RF /(G − 1) = 20 000/8,91 = 2,24 kΩ. Se elige el valor normalizado 2,2 kΩ y resulta G = 1 + 20 000/2200 = 10,09 y vo(100) = 2,036 V.

Interpretación. Se amplifica solo la diferencia útil. La salida va de 0 V a unos 2 V, por lo que el amplificador debe llegar a 0 V (alimentación, referencia y salida a carril declaradas) y la referencia del ADC debe cubrir ese valor. El resultado no es lineal: se requiere linealización por software o calibración multipunto si el rango es amplio.
Comprobación independiente. Por Thévenin: vB = 2,5 · 1385/2385 = 1,4518 V y vA = 1,25 V; la diferencia es 0,2018 V. El notebook clase3_interfaz_calibracion reproduce estos valores.

0 | 20 | 40 | 60 | 80 | 100

## Temperatura T (°C)

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
nsió

n

d

el p

u

e

## nte vb (m

V)

## vb(T) exacta recta con pendiente en 0 °C

Figura 100: Tensión del puente frente a temperatura (cálculo): la curva exacta se separa de la recta con la pendiente en 0

◦C. La diferencia justifica la verificación con puntos intermedios.

### 43.3. Ejemplo S10-3-B Cuantización, SNR y promediado

Enunciado. La salida del ejemplo anterior entra a un ADC de 12 bits con Vref = 2,5 V (referencia propia, dato de ejemplo; la alimentación puede ser otra). Hallar el escalón, el error máximo y eficaz de cuantización, la SNR ideal y, si una senoidal de escala completa tiene un ruido total de 1,2 mV eficaces (dato de ejemplo), la SNR y el ENOB; después, el efecto de promediar M = 16 lecturas.

Método. Se usan (196) y (197).

LSB = 2,5
4096
= 610,4 µV, | eq,max = 305,2 µV, | eq,rms =

610,4
√
12
= 176,2 µV, | (201)
SNRideal = 6,02 · 12 + 1,76 = 74,0 dB. | (202)

La amplitud de la senoidal de escala completa es Vref /2 = 1,25 V y su valor eficaz 1,25/

√
2 = 0,884 V:

SNR = 20 log10

0,884
1,2 × 10⁻³

= 57,3 dB, ENOB = 57,3 − 1,76 6,02

= 9,2 bits, | (203)

σM =

1,2
√
16
= 0,30 mV, | SNRM = 57,3 + 10 log10 16 = 69,4 dB. | (204)

Interpretación. El ruido (1,2 mV) es seis veces el error de cuantización (0,18 mV), así que el ADC de 12 bits trabaja como uno de 9 bits y comprar más bits no ayuda; lo que ayuda es reducir ruido (filtrado, apantallado, promediado). El promediado de 16 muestras mejora 12 dB (unos 2 bits), solo si el ruido es blanco y la señal es estacionaria durante 16 muestras.

Comprobación independiente. Una simulación con 400 000 entradas uniformes redondeadas da una desviación típica del error de 0,2889 LSB frente a 1/

√
12 = 0,2887 (notebook). Datos de ruido de este ejemplo son supuestos, no mediciones.

### 43.4. Ejemplo S10-3-C Calibración de dos puntos (datos de ejemplo)

Enunciado. Un canal de temperatura se calibra con dos temperaturas de referencia conocidas. Los datos siguientes son de ejemplo, no son mediciones: x1 = 5,0

◦C → n1 = 520 y

x2 = 95,0

◦C → n2 = 3541. Obtener la ecuación de conversión, estimar los puntos de verificación 25 ◦C, 50 ◦C y 75 ◦C con cuentas de ejemplo 1182, 2041 y 2862, y comentar la incertidumbre del patrón si es de ±0,1

◦C en cada punto.

Método. Ecuación (198).

k =

95 − 5
3541 − 520
= 0,029 791 ◦C/cuenta, | (205)
x(n) = 5,0 + 0,029791 (n − 520). | (206)

xref (

◦C) | n | x(n) (
| | ◦C) | Error (◦C)
25 | 1182 | 24,72 | −0,28
50 | 2041 | 50,31 | +0,31
75 | 2862 | 74,77 | −0,23

Interpretación. Los errores en los puntos de calibración son nulos por construcción; los puntos intermedios muestran un residuo de 0,3

◦C por una no linealidad de los datos de ejemplo. El residuo en los puntos de verificación es la medida de la calidad de la calibración, no la de los extremos. La incertidumbre relativa de k por el patrón es p
0,1

2 + 0,1

2/90 = 0,16 % (propagación cuadrática suponiendo errores independientes).

Comprobación independiente. x(520) = 5 y x(3541) = 95 exactos; con la lectura de ejemplo n = 2000 resulta 49,09 ◦C. El mismo cálculo en MATLAB (clase3_interfaz_calibracion.m) debe dar el mismo resultado (no ejecutado en este entorno).

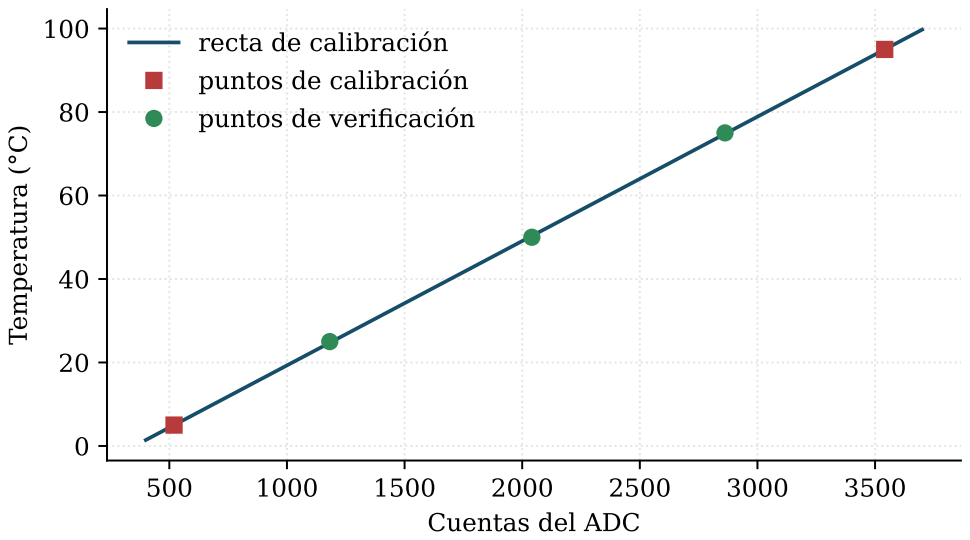
[picture p90: figure]
Cuentas del ADC; Temperatura (°C); recta de calibración puntos de calibración puntos de verificación

Figura 101: Recta de calibración de dos puntos (cuadrados rojos) y puntos de verificación (círculos verdes), con datos de ejemplo. La distancia vertical entre un círculo y la recta es el residuo.

Laboratorio: calibración de un canal de temperatura (guía; resultados vacíos)

Objetivo. Calibrar un canal sensor-acondicionamiento-ADC con dos temperaturas de referencia y verificarlo con tres puntos independientes. Seguridad. Solo baja tensión aislada (alimentación de laboratorio o USB). Sin conexión a red. Se usa agua a temperatura moderada, con el sensor encapsulado y aislado; no se usa agua hirviendo ni se sumerge una placa. Las masas del osciloscopio y del equipo se revisan antes de conectarlas. Material. Sensor y acondicionamiento definidos en el diseño del grupo, ADC (variante y placa por fijar), patrón de temperatura de exactitud mejor que el canal (por definir), recipientes. Procedimiento.
(1) Registrar Vref real y alimentación. (2) Esperar al menos 5τ en cada punto. (3) Tomar 50 lecturas por punto. (4) Calcular media y desviación típica. (5) Obtener k y offset. (6) Verificar con tres puntos nuevos. Entrega. Tabla, residuos y estimación de la incertidumbre. La tabla se deja vacía hasta realizar la práctica.
Punto | xref (
◦C) | Cuentas (media) | σ (cuentas) | Error tras calibrar (◦C)

Calibración 1
Calibración 2
Verificación 1
Verificación 2
Verificación 3

### 43.5. Ejercicios

S10-3-E1 (diferencial y modo común). El puente del ejemplo A se conecta a un amplificador diferencial de cuatro resistencias con Gd = 10 (R1 = 10 kΩ, R2 = 100 kΩ) y tolerancia de 1 %. Hallar la CMRR de peor caso por apareamiento, el error equivalente en la entrada debido al modo común Vex/2 y su equivalente en ◦C usando S(0) = 2,406 mV/

◦C. Concluir si conviene un amplificador de instrumentación.
S10-3-E2 (calibración y extrapolación). Con los datos de ejemplo del ejercicio C, recalibrar con los puntos 25 y 75 ◦C (cuentas 1182 y 2862) y estimar el error en 5 y 95 ◦C (cuentas 520 y 3541). Comparar con la calibración en los extremos y concluir sobre la elección de puntos.

Pregunta conceptual. Un compañero afirma que con el mismo sensor, subir de 12 a 16 bits el ADC mejorará la exactitud de la medida. ¿Qué datos pediría para decidir?

### 43.6. Errores frecuentes y comprobaciones

Suponer Vref igual a la alimentación, o aplicar al ADC una señal fuera de 0 a Vref .

Calibrar con dos puntos y declarar la exactitud sin verificar con puntos independientes.

Promediar muestras de una señal que cambia, o promediar un error sistemático.

Usar un diferencial con resistencias de baja precisión para un puente y atribuir el error al sensor.

Medir durante el transitorio del sensor (t < 5τ ) en lugar de esperar el equilibrio.

Usar un operacional de un solo riel cuya salida no llega a 0 V y perder el extremo bajo del rango.

### 43.7. Conexión con el proyecto

La calibración de dos puntos es entregable de la semana 16 (validación). Cada grupo prepara desde ahora la tabla de calibración, el número de lecturas por punto y la política de verificación. La lógica difusa y el procesamiento posterior de los datos (en el cronograma de semana 9) se tratan como extensión opcional; véanse los pendientes.

### 44. Parcial 2 (semanas 6 a 10)

Instrucciones y especificación

Cubre Diagramas de Bode (semana 6), operacionales reales (semana 7), configuraciones básicas (semana 8), aplicaciones (semana 9) y sensores y adquisición (semana 10). Peso sugerido en la evaluación del curso: 15 %, pendiente de confirmación por el docente. Duración propuesta: 80 minutos (el docente decide; ver el reparto del jueves en S10-3). Se permite calculadora; en todo cálculo se escriben las unidades. Si un dato falta, se declara el supuesto. Puntaje total: 100.

Pregunta | Resultado evaluado | Semana | Puntos
P1 | Frecuencia de corte, magnitud en dB y fase de un RC | 6 | 20
P2 | Amplificador no inversor real: ganancia, ancho de banda, saturación y slew
| rate | 7–8 | 20
P3 | Sumador inversor e integrador | 9 | 20
P4 | Comparador como alarma y tolerancia del umbral | 9–10 | 10
P5 | Sensor, ganancia y ADC | 10 | 20
P6 | Calibración de dos puntos | 10 | 10

Cuadro 14: Tabla de especificaciones del Parcial 2.

### 44.1. Enunciados

P1 (20 puntos, Bode). Un filtro RC pasabajos sin carga tiene R = 4,7 kΩ y C = 33 nF; entrada vi

, salida sobre el condensador, condiciones iniciales nulas. (a) Escribir H(s) y hallar la frecuencia de corte en Hz (5 puntos). (b) A f = 5 kHz calcular la magnitud exacta en dB y la fase, y el error de la asíntota (10 puntos). (c) ¿Cuánto vale la magnitud en dB y qué pendiente tiene a f = 10fc? (5 puntos).

P2 (20 puntos, operacional real). El circuito de la Figura 102(a) usa un operacional alimentado con ±5 V con excursión de salida de ±3,5 V, producto ganancia-ancho de banda de 1 MHz y slew rate de 0,5 V/µs (datos del problema), en realimentación negativa y régimen lineal. (a) Hallar la ganancia y el ancho de banda a −3 dB (6 puntos). (b) Para vin = 0,5 V pico a 20 kHz, calcular la amplitud de salida y comprobar si se limita por slew rate (8 puntos). (c) ¿Cuál es la mayor amplitud de entrada sin recorte, y qué pasa con 0,8 V pico? (6 puntos).

−

vin | +

Rg

10 kΩ

Rf

47 kΩ

vo

(a) No inversor

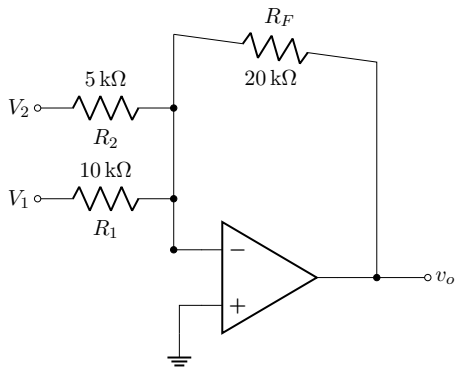
[picture p91: figure]

(b) Sumador inversor

Figura 102: Circuitos de las preguntas P2 (a) y P3 (a). Los operacionales se alimentan con ±5 V, no se dibujan las alimentaciones ni los condensadores de desacoplo, y se suponen en régimen lineal.

P3 (20 puntos, sumador e integrador). (a) En el sumador de la Figura 102(b), V1 = 0,4 V y

V2 = −0,3 V en continua. Hallar vo (8 puntos). (b) Un integrador inversor ideal tiene R = 10 kΩ, C = 100 nF con vC(0) = 0 y recibe vi = −0,5 V constante desde t = 0. Hallar la pendiente de vo, vo(2 ms) y el instante en que se alcanza la saturación de 3,5 V. Indicar por qué un integrador real necesita una resistencia en paralelo con C (12 puntos).

P4 (10 puntos, comparador). Se quiere una alarma cuando un LM35 (10 mV/

◦C) supera 60 ◦C.
Un comparador (sin realimentación) recibe la salida del sensor y el umbral de un divisor desde 5 V con Ra = 22 kΩ (arriba) y Rb = 3 kΩ (abajo). (a) Hallar el umbral en volts y en ◦C (4 puntos). (b) Con resistencias de 1 % y fuente de 5 V exacta, hallar el intervalo del umbral en ◦C (4 puntos).
(c) Explicar en una frase por qué no se usa un amplificador lineal y qué se añade para evitar oscilaciones por ruido (2 puntos).

P5 (20 puntos, sensor y ADC). Un sensor entrega 10 mV/

◦C de 0

◦C a 100 ◦C. Se amplifica con un no inversor de G = 2 y se digitaliza con un ADC de 10 bits y Vref = 2,048 V, referencia propia distinta de la alimentación de 3,3 V. (a) Hallar la salida del amplificador a 100 ◦C y justificar que cabe en el ADC (4 puntos). (b) Hallar el escalón en V y en ◦C de sensor, y el error máximo de cuantización (8 puntos). (c) Con redondeo hacia abajo, ¿qué código resulta a 37,0

◦C? (4 puntos).
(d) Un compañero calculó el escalón con 3,3 V/1024: ¿en qué se equivoca y qué error produce? (4 puntos).

P6 (10 puntos, calibración). El canal de P5 se calibra con dos puntos (datos del problema): 10,0

◦C produce 104 cuentas y 90,0

◦C produce 913 cuentas. (a) Obtener la ecuación x(n) (6 puntos).
(b) Para una lectura de 520 cuentas, hallar la temperatura y compararla con la conversión ideal de 0,1

◦C/cuenta (4 puntos).

### Código y recursos de la semana

Código de la semana 10

Python (ejecutados, con salidas guardadas), en codigo/python/semana_10/:

clase1_sensores.ipynb: divisor con NTC, sensibilidad, respuesta al escalón, ejercicios S10-1-E1/E2; genera ntc_divisor, sensor_escalon.

clase2_datasheets.ipynb: resolución y presupuesto de error con LM35A, ejercicios S10-2; genera presupuesto_error.

clase3_interfaz_calibracion.ipynb: puente e instrumentación, cuantización, SNR, promediado, calibración de dos puntos; genera puente_no_lineal, cuantizacion, calibracion_2p.

parcial2_verificacion.ipynb: contraste de las respuestas del Parcial 2.
MATLAB (no ejecutado en este entorno), en codigo/matlab/semana_10/: clase1_sensores.m, clase2_datasheets.m, clase3_interfaz_calibracion.m, parcial2_verificacion.m, con los mismos datos y resultados.

### Referencias de la semana

Texas Instruments. LM35 Precision Centigrade Temperature Sensors, hoja de datos SNIS159H, agosto de 1999, revisada en diciembre de 2017. https://www.ti.com/lit/ds/symlink/lm 35.pdf. (https://www.ti.com/lit/ds/symlink/lm35.pdf) Consultada el 2026-11-03.

### Parte XI

# Semana 11: Introducción al Internet de las Cosas

### 45. S11-1 Qué es IoT, historia y arquitectura en capas

Resultados, prerrequisitos y distribución

Al terminar, el estudiante podrá (1) definir Internet de las Cosas (IoT) y distinguir un dispositivo IoT de un dispositivo conectado de forma aislada; (2) ubicar los componentes de un sistema en las capas de percepción, red, plataforma y aplicación; (3) estimar los bytes y la tasa de datos de un nodo que publica mediante MQTT. Se comprueba al final con el ejercicio S11-1-E2.
Se requieren los conceptos de sensor y acondicionamiento (semanas 8 a 10), bits y bytes, y el uso de potencias de diez en unidades SI. No se necesita programar un microcontrolador: la sesión es de modelado.

Distribución propuesta de 120 minutos

Diagnóstico, 10 min (el estudiante lista tres objetos «inteligentes» que usa y qué datos envían). Explicación de definición, historia y capas, 30 min. Ejemplos guiados, 30 min. Práctica de los ejercicios, 35 min. Cierre, 15 min. Antes de la clase, el estudiante lee la definición de la UIT-T (referencia 1) y prepara el notebook de la sesión; ese trabajo previo no cuenta como tiempo presencial.

### 45.1. Concepto, historia y modelo

Definición. La Recomendación UIT-T Y.2060 (2012) define el IoT como «una infraestructura global para la sociedad de la información que habilita servicios avanzados mediante la interconexión de cosas (físicas y virtuales) basada en tecnologías de la información y la comunicación interoperables, existentes y en evolución» (traducción libre del texto en inglés, referencia 1). Dos ideas ordenan el resto de la semana: hay una cosa que mide o actúa sobre el mundo físico, y hay un servicio que usa esos datos. Un termómetro conectado por Bluetooth a un teléfono, sin que los datos se integren en un servicio, es un dispositivo conectado; un conjunto de termómetros cuyos datos alimentan una regla de alarma compartida sí es un sistema IoT.

Historia mínima verificada. Según su propio relato, Kevin Ashton recuerda que la expresión nació como título de una presentación suya en Procter & Gamble en 1999 (referencia 3, con la salvedad indicada en las referencias). La definición normativa citada arriba data de 2012. Este texto no incluye cifras de mercado ni de número de dispositivos porque no se verificaron con fuentes primarias.

Arquitectura de cuatro capas. Se usa un modelo didáctico (la UIT-T propone el suyo en la misma recomendación; consultar la referencia 1 para comparar). La Figura 103 muestra las capas y sus componentes típicos.

Percepción: sensores, actuadores y el microcontrolador que los gobierna. Aquí se miden magnitudes físicas y se acondicionan las señales, como en el Módulo III del curso.

Red: radio local, gateway y enlace hacia Internet. Transporta mensajes; no interpreta su significado.

Plataforma: broker de mensajes, almacenamiento de series de tiempo y reglas. Recibe, guarda y procesa.

Aplicación: paneles, alertas y órdenes al usuario o de vuelta al actuador.

La seguridad y la gestión (identidad, cifrado, actualizaciones) atraviesan las cuatro capas: no son una quinta capa que se añade al final.

Seguridad y gestión transversales: identidad, cifrado, actualizaciones, monitoreo

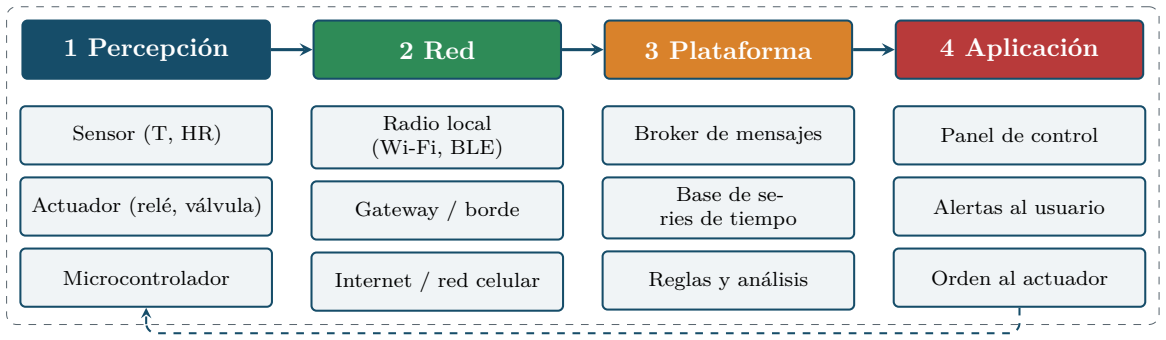
[picture p92: figure]
1 Percepción; 2 Red; 3 Plataforma; 4 Aplicación; Sensor (T, HR); Actuador (relé, válvula); Microcontrolador; Radio local (Wi-Fi, BLE); Gateway / borde; Internet / red celular; Broker de mensajes; Base de se- ries de tiempo; Reglas y análisis; Panel de control; Alertas al usuario; Orden al actuador

Retorno de órdenes: aplicación → plataforma → red → actuador

Figura 103: Arquitectura IoT de cuatro capas. Las flechas continuas indican el sentido de los datos; la línea de trazos, el retorno de órdenes hacia el actuador. Debe observarse que la capa de percepción contiene tanto los elementos que miden como el actuador que recibe la orden de retorno.

Tasa de datos de un nodo. Para dimensionar la red se cuentan los bytes de cada mensaje. Con MQTT 3.1.1 (referencia 2), un mensaje PUBLISH de calidad de servicio (QoS) 0 ocupa

LMQT T = 1 + nRL + 2 + Lt + Lp, | (207)

donde 1 B es el primer byte de la cabecera fija, nRL el número de bytes del campo «Remaining
Length» (1 B si el resto vale menos de 128 B), 2 B la longitud del tópico, Lt | la longitud del tópico
en bytes y Lp la de la carga útil. Con QoS 1 o 2 se añaden 2 B de identificador de paquete. Si cada mensaje viaja sobre TCP/IPv4 sin opciones se suman Lcab = 40 B. La tasa agregada de N nodos que publican cada T es

R =

N (LMQT T + Lcab) 8
T
[bit/s]. | (208)

La hipótesis es que no se cuentan TLS, acuses de TCP, enlace ni conexión inicial: el resultado es una cota inferior del tráfico real.

### 45.2. Ejemplo S11-1-A Bytes de un mensaje de ambiente

Enunciado. Un nodo publica en el tópico aula/n01/ambiente (17 caracteres ASCII) temperatura y humedad. Comparar la carga útil JSON {"t":23.4,"h":51.2,"ts":1767225600} con una binaria de campos int16, uint16 y uint32.

Datos y supuestos. Lt = 17 B; QoS 0; Lcab = 40 B. Incógnitas: Lp, LMQT T y el tamaño total en cada formato.
Método. Contar caracteres de la carga y aplicar (207); es un conteo directo y no requiere modelo estadístico.

L

JSON
p | = 35 B, | Lbin
p | = 2 + 2 + 4 = 8 B, | (209)

L

JSON
MQT T = 1 + 1 + 2 + 17 + 35 = 56 B, | Lbin
MQT T = 1 + 1 + 2 + 17 + 8 = 29 B, | (210)

L

JSON
total | = 56 + 40 = 96 B, | Lbin
total = 29 + 40 = 69 B. | (211)

Interpretación. El formato binario reduce el mensaje a 72 % del JSON (69/96), pero se pierde legibilidad: el consumidor debe conocer el orden y la escala de los campos. Para pocos nodos, la legibilidad suele pesar más.

Comprobación independiente. El notebook cuenta los mismos bytes con len() y verifica con assert. Con QoS 1 el JSON pasa a 58 B de MQTT, es decir, 2 B más.

### 45.3. Ejemplo S11-1-B Tasa agregada y volumen mensual

Enunciado. Cincuenta nodos como los del ejemplo A publican cada T = 60 s. Hallar la tasa agregada en el gateway y el volumen mensual de 30 días con cada formato.
Método. Aplicar (208) y multiplicar por el número de mensajes del mes.

R

JSON =

50 · 96 · 8
60
= 640 bit/s, | Rbin =

50 · 69 · 8
60
= 460 bit/s, | (212)

V

JSON = 50 · 96 ·

30 · 86400
60
= 207,4 MB, | V bin = 149,0 MB. | (213)

Interpretación. La tasa media es ínfima frente a la capacidad de cualquier enlace Wi-Fi, así que el cuello de botella de este sistema no es el ancho de banda medio sino la energía y la fiabilidad (sesión 3). El volumen mensual solo importa si el enlace tiene plan de datos medido. La Figura 104 muestra que la tasa cae como 1/T: duplicar el periodo la reduce a la mitad.

Comprobación independiente. Por mensaje: 50 × 96 × 8 = 38 400 bit cada minuto, es decir, 640 bit/s. El assert del notebook lo confirma.

10

0 | 10
1 | 10
2 | 10

3

### Periodo de publicación T (s)

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
### Tasa agregada (bit/s)

T = 60 s

## 50 nodos, un mensaje por periodo (MQTT QoS 0 + TCP/IP)

### JSON (96 B/mensaje) binaria (69 B/mensaje)

Figura 104: Tasa agregada de 50 nodos frente al periodo de publicación, en escala logarítmica. Los marcadores señalan T = 60 s: 640 bit/s (JSON) y 460 bit/s (binaria). Origen: cálculo del notebook clase1_arquitectura_datos.

### 45.4. Ejercicios

S11-1-E1 (QoS y tópico largo). Un nodo publica la carga binaria de 8 B con QoS 1 en un tópico de 30 caracteres. Hallar el tamaño del mensaje con cabeceras TCP/IP.

S11-1-E2 (periodo mínimo). Doscientos nodos publican la carga JSON (tópico de 17 caracteres, QoS 0). Hallar el menor periodo T para que la tasa agregada no supere 5 kbit/s.

Pregunta conceptual. Un reloj inteligente envía pasos al teléfono por Bluetooth y no los comparte con ningún servicio. ¿Es un sistema IoT según la definición de la UIT-T? Justifica.

### 45.5. Errores frecuentes y comprobaciones

Error frecuente

Identificar IoT con «tener Wi-Fi». La definición exige integrar los datos en un servicio.

Mezclar bit y byte en la tasa, o kilobits con kibibytes.

Olvidar que MQTT, TCP/IP, TLS y enlace suman cabeceras; el cálculo de esta sesión es una cota inferior.

Suponer que la tasa media describe el pico cuando muchos nodos transmiten a la vez.

Colocar el gateway en la capa de percepción por estar «cerca» del sensor; su función es de red.

### 45.6. Conexión con el proyecto

El diagrama de cuatro capas será la base del documento de diseño conceptual del jueves y de la arquitectura del proyecto integrador. En el proyecto se pedirá justificar el formato del mensaje y el periodo de publicación con una cuenta de bytes como la de esta sesión.

### 46. S11-2 Aplicaciones: Smart Home, Industria 4.0 y telecomunicaciones

Resultados, prerrequisitos y distribución

Al terminar, el estudiante podrá (1) relacionar los requisitos de latencia, energía y robustez de tres dominios con decisiones de arquitectura; (2) elaborar un presupuesto de latencia extremo a extremo; (3) justificar con una cuenta cuándo conviene procesar en el borde y cuándo en la nube. Se comprueba con el ejercicio S11-2-E2.
Se requiere la sesión S11-1 (capas y tasa de datos) y conocimiento básico de muestreo (semana 10).

Distribución propuesta de 120 minutos

Diagnóstico, 10 min (ejemplos de IoT en la vida del estudiante). Explicación de los dominios, 25 min. Ejemplos guiados, 35 min. Práctica de los ejercicios, 35 min. Cierre, 15 min. Antes de la clase, el estudiante identifica un sistema real de su entorno y lo describe con las cuatro capas; el trabajo previo no cuenta como tiempo presencial.

### 46.1. Concepto, dominios y modelo

Una misma arquitectura se dimensiona de forma distinta según el dominio (Figura 105). Los textos de la figura son criterios didácticos, no estadísticas.

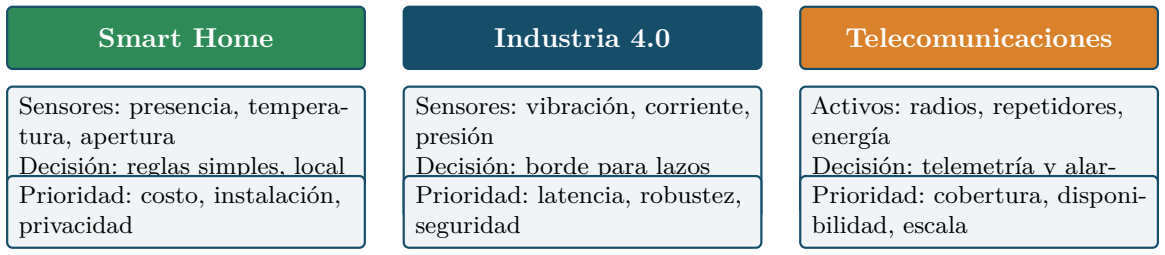
[picture p93: figure]
Smart Home; Industria 4.0; Telecomunicaciones; Sensores: presencia, tempera- tura, apertura Decisión: reglas simples, local Prioridad: costo, instalación, privacidad; Sensores: vibración, corriente, presión Decisión: borde para lazos rápidos Prioridad: latencia, robustez, seguridad; Activos: radios, repetidores, energía Decisión: telemetría y alar- mas remotas Prioridad: cobertura, disponi- bilidad, escala

Figura 105: Tres dominios de aplicación y la prioridad de diseño que domina cada uno. Debe observarse que la misma capa de percepción pide sensores distintos y que la decisión cambia de lugar.

Smart Home: muchos nodos baratos, instalación sencilla y datos personales. Pesan el costo, la privacidad y la tolerancia a fallos de Internet: una luz no debe depender de la nube.

Industria 4.0 y aplicaciones industriales: monitoreo de condición (vibración, corriente, presión) y lazos de control. Pesan la latencia determinista, la robustez ambiental y la seguridad.

Telecomunicaciones: supervisión remota de radios, repetidores y fuentes de energía en sitios dispersos. Pesan la cobertura, la disponibilidad y la gestión a escala.

Para comparar tecnologías de comunicación (Wi-Fi, BLE, Zigbee/Thread, LoRaWAN, NB-IoT y LTE-M) se usan criterios cualitativos: alcance, consumo, tasa y costo de infraestructura. Las cifras exactas dependen de la especificación y de la región, y deben consultarse en la norma o en la hoja del módulo antes de decidir; este texto no las incluye.

Borde y nube. El borde es el cómputo cercano a los nodos (en el gateway o en el propio microcontrolador); la nube es el cómputo remoto, alcanzado por Internet. La latencia extremo a extremo de un lazo es la suma de sus tramos (Figura 106):

L =

X

k

Lk = Lmuestreo + Lradio + Lbroker + Lproc + Lact (+LW AN + Lnube). | (214)

Aquí Lmuestreo vale, en el peor caso, un periodo completo de muestreo, porque un evento puede ocurrir justo después de una muestra; LW AN es el tiempo de ida y vuelta (RTT) hacia la nube. Los valores usados son supuestos de diseño, no mediciones.

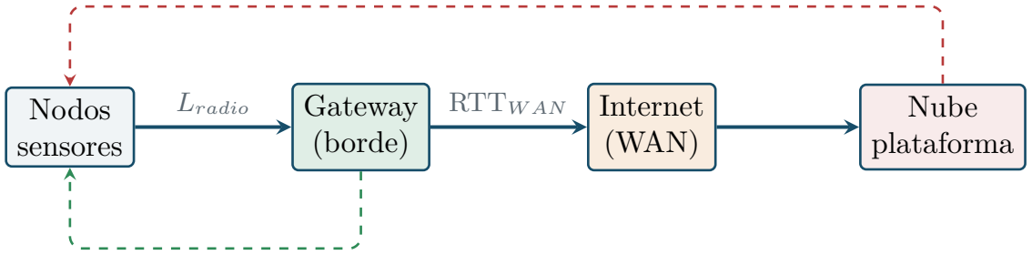
[picture p94: figure]
Nodos sensores; Gateway (borde); Internet (WAN); Nube plataforma; Lradio; RTTW AN

lazo local: decide y actúa en el borde

lazo en la nube: suma RTT y procesamiento remoto

Figura 106: Dos lazos de decisión. El lazo local (verde) evita el enlace WAN; el lazo en la nube (rojo) le suma RTT y procesamiento remoto.

### 46.2. Ejemplo S11-2-A Alarma doméstica

Enunciado. Un sensor de humo publica cada 500 ms. La alarma debe sonar en menos de 1 s. Comparar el procesamiento en el gateway con el procesamiento en la nube.
Datos y supuestos (ilustrativos). Radio y gateway 30 ms; broker local 5 ms; procesamiento en el borde 10 ms; enlace al actuador 20 ms; RTT hacia la nube 80 ms; procesamiento en la nube 20 ms. Método. Sumar los tramos con (214), tomando el peor caso de muestreo.
Lborde = 500 + 30 + 5 + 10 + 20 = 565 ms, | (215)
Lnube = 500 + 30 + 5 + 20 + 80 + 20 = 655 ms. | (216)

Interpretación. Ambas opciones cumplen el límite de 1 s. El tramo dominante es el periodo de muestreo (500 de 565 ms), no la nube. Un sistema de seguridad debe además seguir funcionando sin Internet, argumento a favor del borde que no depende de la latencia.

Comprobación independiente. El notebook suma los mismos tramos y verifica con assert. Despejando el RTT en (214), la ruta por la nube deja de cumplir cuando el RTT supera 1000 − (655 − 80) = 425 ms; con 500 ms sumaría 1075 ms.

### 46.3. Ejemplo S11-2-B Lazo industrial y reducción de datos

Enunciado. Un lazo de protección debe actuar en menos de 20 ms. Se muestrea a 1 kHz. Además, 20 sensores de vibración de 3 ejes y 16 bit a 1 kHz se supervisan. Evaluar la latencia en borde y nube, y la tasa de datos cruda frente a seis características por segundo en float32.

Supuestos. Radio y gateway 5 ms; broker 2 ms; procesamiento en el borde 3 ms; actuador 1 ms; RTT y procesamiento en la nube como en el ejemplo A. Muestreo en el peor caso: 1 ms.

Paso 1. Latencia.

Lborde = 1 + 5 + 2 + 3 + 1 = 12 ms ≤ 20 ms, | (217)
Lnube = 1 + 5 + 2 + 1 + 80 + 20 = 109 ms > 20 ms. | (218)

Paso 2. Datos. Por sensor, crudo: 3 · 16 · 1000 = 48 kbit/s; los 20 suman 960 kbit/s. Con características: 6·32 = 192 bit/s por sensor y 3840 bit/s en total. La reducción es 960000/3840 = 250 veces.

Interpretación. La ruta por la nube no cumple el lazo aunque su capacidad de cálculo sea mayor; es una restricción física del tiempo de ida y vuelta, no un defecto del servicio. Procesar en el borde reduce además la carga del enlace, a costa de perder la señal cruda (mitigable con almacenamiento local y envío bajo demanda). Las tasas no incluyen cabeceras.

Comprobación independiente. Con un solo sensor crudo, 48 kbit/s equivalen a 6 kB/s; en una hora son 21,6 MB, valor coherente con el producto 6000 × 3600.

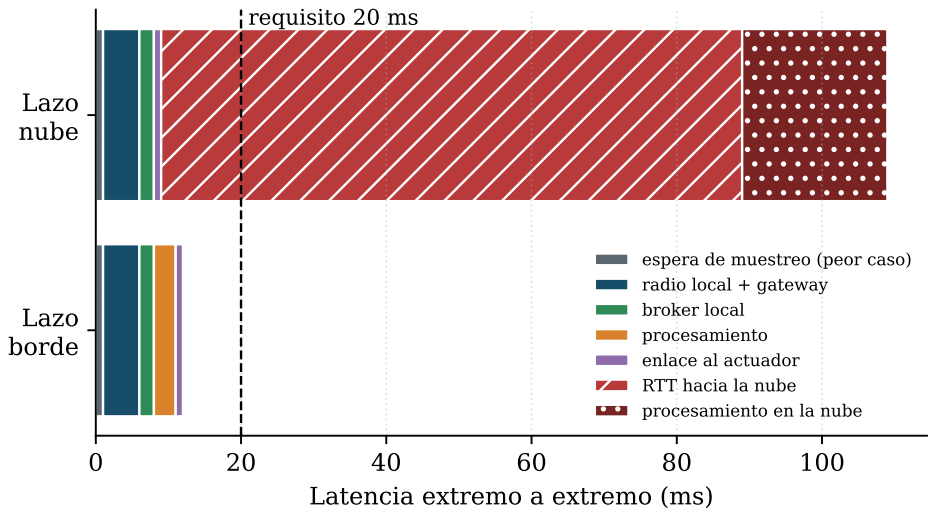
[picture p95: figure]
Latencia extremo a extremo (ms); Lazo borde; Lazo nube; requisito 20 ms; espera de muestreo (peor caso) radio local + gateway broker local procesamiento enlace al actuador RTT hacia la nube procesamiento en la nube

Figura 107: Latencia del lazo industrial por tramos en el borde y en la nube, con el requisito de 20 ms. Debe observarse que el RTT de la nube por sí solo supera el requisito. Origen: cálculo del notebook clase2_latencia_borde_nube.

### 46.4. Ejercicios

S11-2-E1 (sensibilidad al RTT). En el ejemplo A el RTT hacia la nube sube a 200 ms. ¿Sigue cumpliendo la ruta por la nube? ¿Y si además el muestreo pasa a 100 ms?
S11-2-E2 (decisión). Una planta tiene 8 motores. Cada uno envía vibración cruda con 3 ejes de 12 bit a 2 kHz. Calcular la tasa total sin procesar y decidir, con una cuenta, si se envía todo a la nube o se calculan características en el borde.

Pregunta conceptual. Si el borde cumple todos los lazos rápidos, ¿para qué se mantiene la nube en la arquitectura? Da dos razones.

### 46.5. Errores frecuentes y comprobaciones

Error frecuente

Atribuir toda la latencia a la red y olvidar el periodo de muestreo.

Medir un RTT promedio y diseñar un lazo con plazo estricto: debe usarse el peor caso.

Enviar señal cruda a la nube «por si acaso» sin cuenta de volumen y de costo.

Elegir la tecnología de comunicación por moda sin consultar su especificación.

Hacer que una función de seguridad dependa de la nube.

### 46.6. Conexión con el proyecto

El presupuesto de latencia y la decisión borde-nube serán un apartado del informe de diseño del proyecto. Para el jueves, el estudiante trae el sistema real descrito en las cuatro capas y una estimación del plazo máximo que tolera su aplicación.

### 47. S11-3 Diseño conceptual de un proyecto IoT

Resultados, prerrequisitos y distribución

Al terminar, el estudiante podrá (1) traducir una necesidad en requisitos medibles y verificables; (2) elaborar un presupuesto de energía y de ancho de banda de un nodo; (3) justificar la selección de sensores y comunicación y registrar riesgos con mitigación. Se comprueba con el ejercicio S11-3-E2 y con la ficha de diseño de la sección de laboratorio.
Se requieren las sesiones S11-1 y S11-2, el cálculo de carga y corriente media (promedio ponderado en el tiempo) y las nociones de sensor y acondicionamiento.

Distribución propuesta de 120 minutos

Diagnóstico, 10 min (el estudiante enuncia en una frase qué problema resolvería su sistema). Explicación del flujo de diseño, 20 min. Ejemplos guiados, 30 min. Práctica de los ejercicios, 20 min. Laboratorio de diseño (ficha en equipo), 30 min. Cierre, 10 min. Antes de la clase, cada equipo trae una necesidad candidata (por ejemplo, monitorear el ambiente de un laboratorio). Este trabajo previo no cuenta como tiempo presencial. La sesión es de diseño sobre papel y cálculo: no requiere hardware.

### 47.1. Concepto y modelo: del requisito a la verificación

Un diseño conceptual es un conjunto de decisiones justificadas antes de comprar o programar. La Figura 108 resume el flujo; la flecha de retorno indica que un presupuesto que no cierra obliga a revisar la arquitectura o los requisitos.

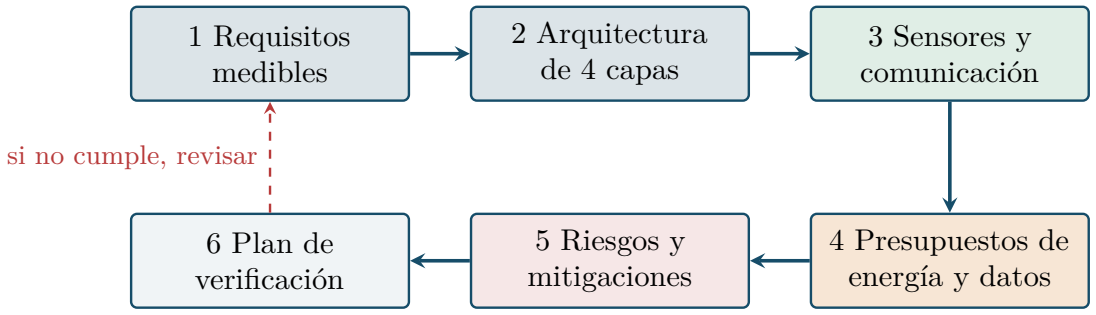
[picture p96: figure]
1 Requisitos medibles; 2 Arquitectura de 4 capas; 3 Sensores y comunicación; 4 Presupuestos de energía y datos; 5 Riesgos y mitigaciones; 6 Plan de verificación; si no cumple, revisar

Figura 108: Flujo de diseño conceptual. Debe observarse que los presupuestos y los riesgos se evalúan antes de elegir componentes definitivos, y que la verificación cierra el ciclo.

Requisitos medibles. Cada requisito lleva magnitud, valor, condición y método de verificación. Ejemplo para un monitor de ambiente de aula: R1, medir temperatura con incertidumbre expandida a definir por el equipo en el intervalo de operación; R2, publicar una medida al menos cada 16 min; R3, autonomía de 365 días con batería; R4, funcionamiento local si falla Internet; R5, ningún dato personal. Los valores son propuestas del ejemplo, no normas.

Selección de sensores y comunicación. Se justifica con criterios, no con marcas: magnitud y rango, resolución e incertidumbre requeridas, interfaz (analógica o digital), tensión de alimentación, consumo en medida y en reposo, tiempo de respuesta, y disponibilidad de documentación. Para la comunicación: alcance, consumo por mensaje, infraestructura existente, seguridad y costo. Las cifras se toman de la hoja de datos de la variante exacta del módulo; ESP32, por ejemplo, tiene variantes con capacidades distintas. La Figura 109 muestra un nodo genérico: los pines se rotulan solo después de elegir la placa y su revisión.

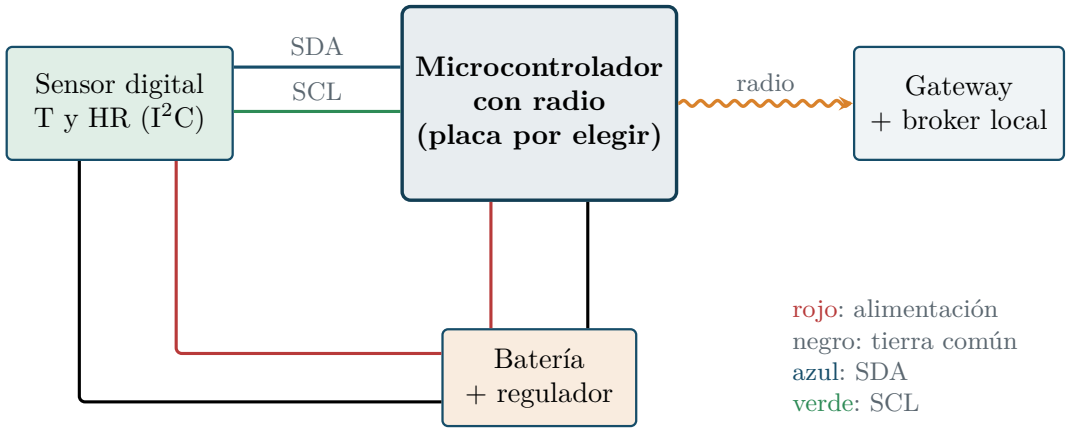
[picture p97: figure]
Microcontrolador con radio (placa por elegir); Sensor digital T y HR (I²C); Batería + regulador; Gateway + broker local; SDA; SCL; radio; rojo: alimentación negro: tierra común azul: SDA verde: SCL

Figura 109: Diagrama de bloques de un nodo de ambiente con sensor digital I²C, alimentación por batería y regulador, y enlace por radio a un gateway. Código de colores de cable: rojo, alimentación; negro, tierra común; azul, SDA; verde, SCL. La tensión del regulador y la compatibilidad de niveles lógicas deben comprobarse con las hojas de datos.

Presupuesto de energía. Un nodo que despierta cada T, permanece activo ta con corriente Ia y duerme el resto con Is consume una corriente media

¯I =

Iata + Is (T − ta)
T
. | (219)

Con una batería de carga útil Qu = η Qnom (η es la fracción utilizable), la vida es

tvida =

Qu
¯I
. | (220)

Para una autonomía objetivo tobj , la corriente media máxima es ¯Imax = Qu/tobj y el periodo mínimo es

Tmin =

(Ia − Is)ta

¯Imax − Is

,

¯Imax > Is. | (221)

Las hipótesis: Ia es la media durante ta; la batería entrega esa corriente (los picos del radio exigen condensador o batería con baja resistencia interna); se desprecian autodescarga, temperatura, envejecimiento y rendimiento del regulador. El modo de reposo profundo de un microcontrolador apaga la CPU y la mayor parte de la RAM y mantiene activo solo el dominio de reloj de tiempo real (referencia 4); su corriente real debe medirse con el montaje completo, porque sensor, regulador y divisores también consumen.

Presupuesto de ancho de banda. Se usa (208) y el volumen mensual V = N L(30 · 86400/T).

Riesgos. Se registran con causa, efecto, probabilidad e impacto estimados por el equipo y una mitigación con su método de verificación (tercera tabla de la ficha del laboratorio de diseño).

### 47.2. Ejemplo S11-3-A Vida de batería con dos periodos

Enunciado. Un nodo tiene Ia = 100 mA durante ta = 2 s (arranque, medida, conexión y envío), Is = 20 µA en reposo y una batería de 2500 mA h con 80 % utilizable. Hallar la vida con T = 60 s y T = 600 s.

Datos y supuestos. Los de arriba, ilustrativos. Qu = 2,5 · 3600 · 0,8 = 7200 C.

Método. Corriente media con (219) y vida con (220).

¯I(60) = 0,1 · 2 + 20 × 10⁻⁶
- 58
60
= 3,353 mA, | tvida =
| 7200 3,353 × 10⁻³
= 24,9 d, | (222)

¯I(600) = 0,1 · 2 + 20 × 10⁻⁶
- 598
600
= 0,353 mA, | tvida = 235,9 d. | (223)

Interpretación. Aumentar el periodo diez veces extiende la vida 9,5 veces, no 10, porque la corriente de reposo ya aporta una fracción creciente. La energía de cada ciclo activo (0,2 C) domina frente a la de reposo (1,2 mC durante 58 s).

Comprobación independiente. Carga por ciclo a T = 60: 0,2 + 0,00116 = 0,2012 C; ciclos posibles 7200/0,2012 = 35 785, equivalentes a 35 785 · 60/86400 = 24,9 d.

### 47.3. Ejemplo S11-3-B Periodo mínimo para un año y presupuesto de datos

Enunciado. Con los datos del ejemplo A, el requisito R3 exige 365 días. Hallar el periodo mínimo y la tasa y el volumen de 50 nodos que envían el mensaje binario de 69 B de la sesión 1. Analizar el efecto de reducir ta a 1 s.
Método. Despejar con (221).

¯Imax =

7200
365 · 86400
= 0,2283 mA, | (224)

Tmin =

(0,1 − 20 × 10⁻⁶
) · 2
2,283 × 10⁻⁴ − 2 × 10⁻⁵

=

0,19996
2,083 × 10⁻⁴
= 960 s = 16 min. | (225)

Con ta = 1 s el numerador se reduce a la mitad y Tmin = 480 s. Para 50 nodos con T = 960 s:

R =

50 · 69 · 8
960

= 28,8 bit/s, V = 50 · 69 ·

30 · 86400
960

= 9,31 MB por mes. (226)

Interpretación. La energía fija el periodo mínimo; el ancho de banda no es restricción. Reducir el tiempo activo (por ejemplo, evitando renegociar la conexión en cada ciclo) rinde tanto como reducir la corriente. Esta conclusión depende de los supuestos: debe confirmarse con la medición del montaje.
Comprobación independiente. Sustituir T = 960 s en (220) da tvida = 365 d (el assert del notebook usa tolerancia de 10⁻⁶ d).

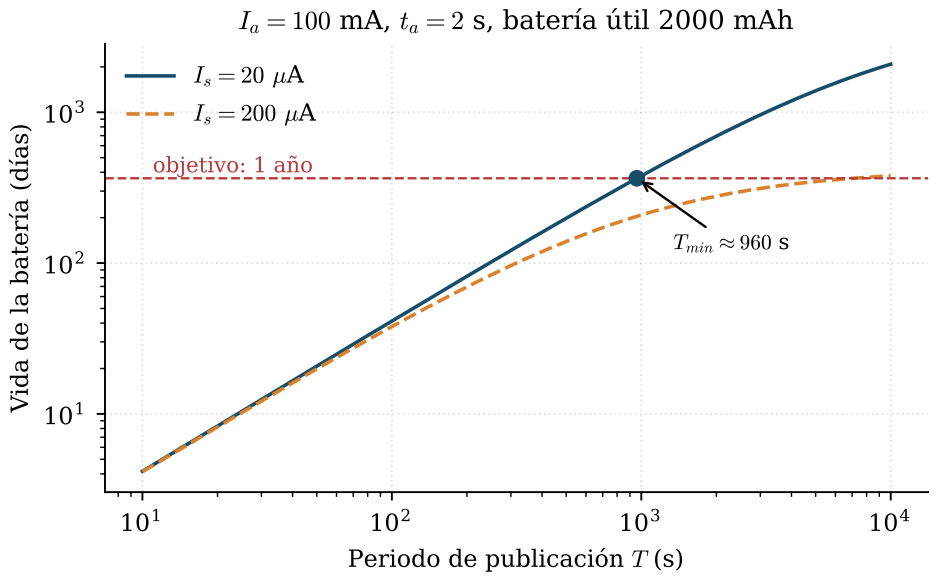
[picture p98: figure]
Periodo de publicación T (s); Vida de la batería (días); objetivo: 1 año; Tmin ¼ 960 s

Ia = 100 mA, ta = 2 s, batería útil 2000 mAh

Figura 110: Vida de la batería frente al periodo de publicación para Is = 20 µA y 200 µA (Ia = 100 mA, ta = 2 s, 2000 mA h útiles). Debe observarse que con la corriente de reposo mayor la curva se aplana y el objetivo de un año no se alcanza para ningún periodo. Origen: cálculo del notebook clase3_presupuesto_nodo.

### 47.4. Ejercicios

S11-3-E1 (batería menor). Repite el ejemplo B con una batería de 1200 mA h (80 % útil) y calcula Tmin.
S11-3-E2 (sensor adicional y escala). Se añade un sensor que consume 5 mA durante 0,5 s por ciclo (dentro del ciclo de T = 960 s, en lugar de dormir). ¿Se sigue cumpliendo el año con la batería de 2500 mA h? Además, calcula tasa y volumen mensual con 200 nodos y mensaje de 69 B.

Pregunta conceptual. Un equipo elige un microcontrolador por su bajísimo consumo en reposo y descuida el resto del nodo. Con T = 600 s la vida pasa de 235,9 días (Is = 20 µA) a 62,7 días si Is = 1 mA. ¿Qué elementos del nodo pueden causar esa corriente de reposo y qué medición lo detecta?

### 47.5. Laboratorio de diseño: ficha conceptual

Ficha de diseño conceptual (sin hardware)

Cada equipo completa en 30 minutos las tablas siguientes para su necesidad candidata. Se evalúa la justificación y la evidencia de cálculo, no que el sistema funcione. Las celdas se dejan vacías en esta edición; el estudiante registra sus propios valores y cálculos, con el origen de cada dato (hoja de datos, supuesto o medición).

Id Requisito (magnitud, valor, condición)

Método de verificación | Capa responsable

R1

R2

R3

R4

Parámetro del presupuesto | Símbolo Valor Unidad Origen del dato
Corriente activa | Ia
Tiempo activo | ta
Corriente de reposo | Is
Carga útil de batería | Qu
Periodo | T
Longitud del mensaje | L
Riesgo Causa y efecto | Probabilidad/impacto | Prioridad Mitigación y verifica-
| | ción

Ficha de diseño conceptual: requisitos, presupuesto y riesgos (vacía).

### 47.6. Errores frecuentes y comprobaciones

Error frecuente

Redactar requisitos sin valor ni método de verificación («rápido», «de bajo consumo»).

Calcular la vida de batería con Ia de la hoja de datos de una sola etapa e ignorar el radio, el regulador y el sensor.

Suponer que toda la capacidad nominal de la batería es utilizable.

Tratar el ancho de banda como restricción cuando la energía o el costo la dominan, o al revés, sin hacer la cuenta.

Elegir un componente sin fijar variante, revisión y fuente de su hoja de datos.

Dejar la seguridad (credenciales, actualizaciones, datos personales) para el final.

### 47.7. Conexión con el proyecto

La ficha de esta sesión es el primer entregable de diseño del proyecto integrador. En la semana 12 se fija la placa, su revisión y se mide el consumo real para sustituir los supuestos de esta sesión; en la semana 13 se implementa el transporte de mensajes. Las curvas y cálculos de esta semana se rotulan como cálculo, no como medición.

### 48. Código y recursos de la semana

Código de la semana

Python (codigo/python/semana_11/; ejecutados con salidas y assert):

clase1_arquitectura_datos.ipynb: bytes de un mensaje MQTT PUBLISH, JSON frente a carga binaria, tasa agregada y volumen mensual; genera tasa_datos.pdf.

clase2_latencia_borde_nube.ipynb: presupuesto de latencia de una alarma doméstica y de un lazo industrial, y reducción de datos por cálculo en el borde; genera latencia.pdf.

clase3_presupuesto_nodo.ipynb: corriente media, vida de batería, periodo mínimo para un año de autonomía y volumen de datos; genera vida_bateria.pdf.
MATLAB (codigo/matlab/semana_11/; no ejecutados en este entorno; reproducen los mismos números con MATLAB base):

clase1_arquitectura_datos.m

clase2_latencia_borde_nube.m

clase3_presupuesto_nodo.m
Todos los parámetros eléctricos y de tiempo son valores de diseño ilustrativos. Deben sustituirse por mediciones del montaje o por datos de la hoja del componente elegido.

### 49. Referencias de la semana

Fecha de consulta de todas las referencias: 2026-11-03.

1. UIT-T. Recomendación Y.2060: Overview of the Internet of things (aprobada el 2012-06-15; renumerada Y.4000 el 2016-02-05 sin modificación). https://www.itu.int/rec/T-REC-Y.2 060-201206-I. (https://www.itu.int/rec/T-REC-Y.2060-201206-I) La definición citada en la sesión 1 se tomó de la reproducción de la UIT en https://itu.int/en/publications/Documents/tsb/2016-InternetOfThings/files/basic-html/page21.html. (https://itu.int/en/publications/Documents/tsb/2016-InternetOfThings/files/basic-html/page21.html)
2. OASIS. MQTT Version 3.1.1, OASIS Standard, 29 de octubre de 2014. https://docs.oasis-open.org/mqtt/mqtt/v3.1.1/os/mqtt-v3.1.1-os.html. (https://docs.oasis-open.org/mqtt/mqtt/v3.1.1/os/mqtt-v3.1.1-os.html)
3. Ashton, K. «That ‘Internet of Things’ thing». RFID Journal, 2009. https://www.rfidjournal.com/expert-views/that-internet-of-things-thing. (https://www.rfidjournal.com/expert-views/that-internet-of-things-thing) El servidor rechazó la consulta directa (HTTP 403); el dato citado procede de resúmenes secundarios y debe contrastarse con el original.
4. Espressif Systems. ESP-IDF Programming Guide, Sleep Modes (versión stable). https: //docs.espressif.com/projects/esp-idf/en/stable/esp32/api-reference/system/ sleep_modes.html. (https://docs.espressif.com/projects/esp-idf/en/stable/esp32/api-reference/system/sleep_modes.html)

### Parte XII

# Semana 12: ESP32 y comunicaciones

### 50. S12-1 Arquitectura del ESP32, GPIO, ADC y PWM

Resultados, prerrequisitos y distribución

Al terminar, el estudiante podrá (1) identificar los bloques del ESP32 que intervienen en una medición y en una salida de potencia baja, con la plataforma fijada; (2) dimensionar un divisor que lleve la señal de un sensor al rango efectivo del ADC y distinguir resolución de exactitud; (3) calcular resolución máxima, cuentas de duty y rizado de una salida PWM. Se comprueba al final con S12-1-E2 y la pregunta conceptual.
Se requieren el divisor de tensión y el equivalente de Thévenin (S01-1), y la constante de tiempo de un circuito RC. No se necesita programar: el firmware de apoyo se entrega como listado.

Distribución propuesta de 120 minutos

Diagnóstico, 10 min (divisor y Thévenin, sin calificar). Explicación de la plataforma, GPIO y ADC, 30 min. Ejemplos guiados, 30 min. Práctica de los ejercicios, 35 min. Cierre y contraste, 15 min. Trabajo previo autónomo: leer las tablas de pines de la hoja de datos [S12-1] y revisar el divisor de S01-1. La prueba en hardware se hace el jueves (S12-3); esta sesión es de cálculo y diseño.

### 50.1. Plataforma fijada y qué está verificado

Todo el material de la semana usa ESP32-DevKitC V4 con el módulo ESP32-WROOM-32E (variante ESP32-DevKitC-32E, antena de PCB, flash de 4 MB según la guía de la placa [S12-4]). El módulo integra el chip ESP32-D0WD-V3 o ESP32-D0WDR2-V3 [S12-1]. No se asume que otra variante (S2, S3, C3, WROVER) tenga el mismo ADC, los mismos pines o Bluetooth clásico.

Datos tomados de la hoja de datos del módulo v2.1 [S12-1] (consulta 2026-11-03), con VDD la tensión de alimentación de los pines digitales:

Alimentación del módulo: 3,0 V a 3,6 V (típica 3,3 V); la fuente debe poder entregar al menos 0,5 A.

Nivel alto de entrada VIH ≥ 0,75VDD, con máximo VDD + 0,3 V; nivel bajo VIL ≤ 0,25VDD. Con VDD = 3,3 V: VIH ≥ 2,475 V y máximo 3,6 V. Un nivel de 5 V excede ese máximo: los GPIO no son tolerantes a 5 V.

Salida: VOH ≥ 0,8VDD = 2,64 V, VOL ≤ 0,1VDD. Con la intensidad máxima de excitación y las condiciones de la tabla, 40 mA de fuente y 28 mA de sumidero. No se verificó un límite absoluto de corriente por pin; el diseño debe quedar muy por debajo.

Cinco pines de arranque (strapping): GPIO0, GPIO2, GPIO12 (MTDI), GPIO15 (MTDO) y GPIO5. Con el pin libre, sus valores por defecto son: GPIO0 y GPIO5 en alto, GPIO2 y GPIO12 en bajo, GPIO15 en alto. Un circuito externo puede cambiar el modo de arranque.

GPIO34, GPIO35, GPIO36 (SENSOR_VP) y GPIO39 (SENSOR_VN) son solo de entrada. GPIO6 a GPIO11 los usa la flash del módulo y no están disponibles.

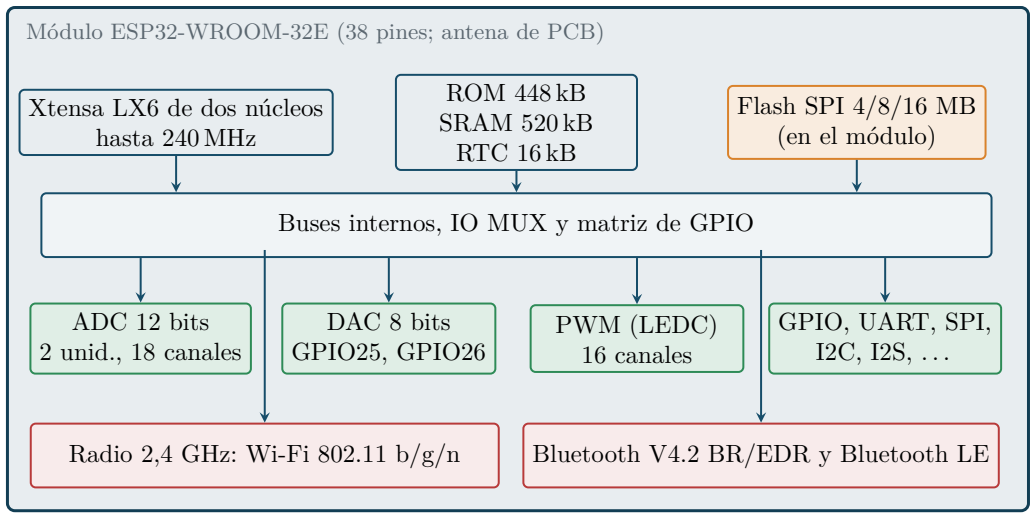
[picture p99: figure]
Xtensa LX6 de dos núcleos hasta 240 MHz; ROM 448 kB SRAM 520 kB RTC 16 kB; Flash SPI 4/8/16 MB (en el módulo); Buses internos, IO MUX y matriz de GPIO; ADC 12 bits 2 unid., 18 canales; DAC 8 bits GPIO25, GPIO26; PWM (LEDC) 16 canales; GPIO, UART, SPI, I2C, I2S, . . .

Módulo ESP32-WROOM-32E (38 pines; antena de PCB)

Radio 2,4 GHz: Wi-Fi 802.11 b/g/n | Bluetooth V4.2 BR/EDR y Bluetooth LE

Fuente: hoja de datos del módulo v2.1 (2026-08-05). Solo se muestran prestaciones declaradas allí.

Figura 111: Bloques del ESP32-WROOM-32E que usa esta semana. Cada bloque corresponde a una prestación declarada en la hoja de datos [S12-1]; no es el diagrama interno del fabricante.

En la figura 111 se observa que el ADC, el PWM y los GPIO comparten la matriz de pines, y que las radios son bloques separados: la medición analógica y la radio coinciden en el mismo chip, pero no en el mismo recurso, salvo ADC2 (ver S12-2).

### 50.2. ADC: modelo, rango y exactitud

El ESP32 tiene dos ADC SAR de 12 bits y 18 canales de entrada en total [S12-1]. Con Dmax = 2

12 = 4096 y Vmax el máximo medible según la atenuación, la tensión equivalente a un código Dout es [S12-3]

Vout =

Dout Vmax

Dmax

, LSB = Vmax

Dmax

. | (227)

Con la atenuación máxima (atten = 3 en la hoja de datos; el nombre depende del entorno: ADC_11db en Arduino, ADC_ATTEN_DB_12 en ESP-IDF, correspondencia que debe confirmarse con la versión del núcleo usada) el rango efectivo es 150 mV a 2450 mV y el error total tras calibración con eFuse es de ±60 mV [S12-1, Tabla 11]. En 2450 mV la hoja de datos advierte que la exactitud empeora por encima de un resultado de 3000. Sin calibrar hay diferencias de ±6 % entre chips. La linealidad declarada es DNL ∈ [−7, 7] LSB e INL ∈ [−12, 12] LSB, con Wi-Fi y Bluetooth apagados.

La referencia no es VDD: por diseño la referencia del ADC es de 1100 mV, con variación entre chips de 1000 mV a 1200 mV, y por eso se calibra [S12-3]. Tomar VDD como referencia sería un error de modelo. ESP-IDF recomienda un condensador de 100 nF en el pin y promediar muestras para reducir ruido. No se verificó la impedancia de entrada ni la máxima resistencia de fuente admisible; el diseño de esta semana mantiene resistencias de pocos kilohmios y la validación es experimental.
La figura 112 muestra la cuantización ideal: error de ±LSB/2 = ±0,299 mV. Pero el error total de calibración, 60 mV, equivale a 100 LSB: la resolución de 12 bits no es exactitud de 12 bits.

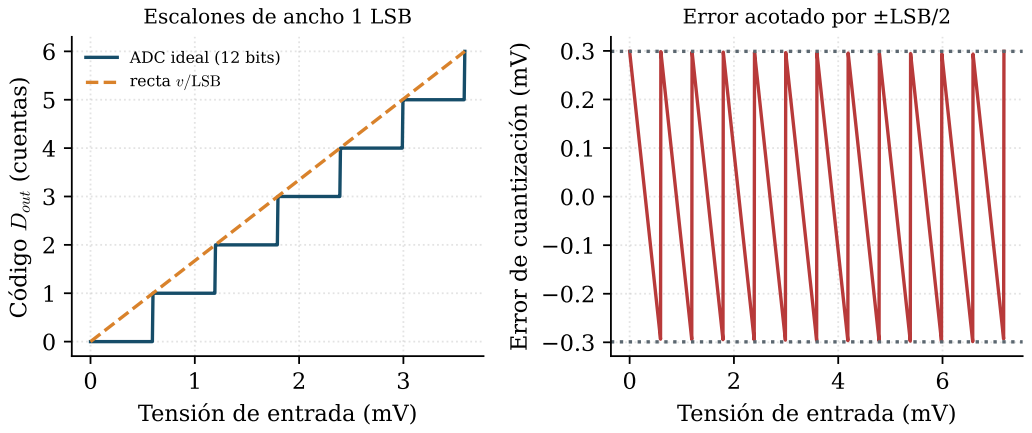
[picture p100: figure]
Tensión de entrada (mV); dig; Dout (c; ntas); Escalones de ancho 1 LSB; ADC ideal (12 bits); recta v=LSB; Error de cuantización (mV); Error acotado por ±LSB/2

Figura 112: Cuantización de un ADC de 12 bits con Vmax = 2450 mV (modelo ideal, notebook de la clase 1). Izquierda: escalones de 0,598 mV. Derecha: error acotado por ±LSB/2.

### 50.3. GPIO y PWM

Un GPIO de salida se modela como una fuente de VOH con resistencia interna no especificada aquí; por eso se calcula el peor caso con VOH = 0,8VDD, el mínimo garantizado. El PWM del ESP32 lo genera el periférico LEDC: 16 canales, resolución de hasta 20 bits y salida en cualquier GPIO de salida mediante la matriz [S12-2, S12-3]. Con reloj fclk (APB, 80 MHz), frecuencia de PWM f y divisor mínimo 1, la resolución máxima en bits es

Nmax =

log2

fclk
f
, | Dcuentas = round(d 2
N ), | d =

Dcuentas
2N
. | (228)

Esta relación es una aproximación (la documentación da f ≈ fclk/(divisor · 2

N ) y no una fórmula
exacta); es consistente con el ejemplo de ESP-IDF de 5 kHz y 13 bits.

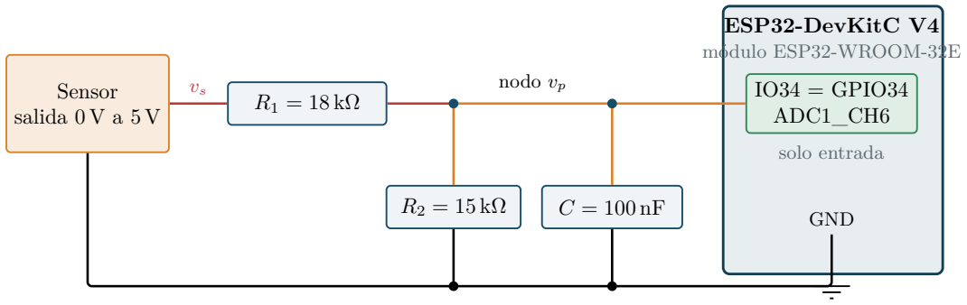
[picture p101: figure]
Sensor; salida 0 V a 5 V; ESP32-DevKitC V4 módulo ESP32-WROOM-32E; IO34 = GPIO34 ADC1_CH6; solo entrada; GND; nodo vp

Rojo: señal del sensor. Naranja: nodo acondicionado vp = vs R2/(R1 + R2). Negro: referencia común (tierra). La masa del sensor y la del ESP32 se unen. Para vs = 5 V: vp = 2,27 V (cálculo, S12-1-A).

Figura 113: Conexión propuesta de un sensor de 0 V a 5 V al ADC1 del ESP32-DevKitC V4: divisor R1–R2, condensador C en el pin y referencia común. Rotulado de pines según la hoja de datos [S12-1] y la guía de la placa [S12-4]. Diseño propuesto, sin probar en hardware.

### 50.4. Ejemplo S12-1-A Divisor para un sensor de 0 a 5 V

Enunciado. Un sensor entrega 0 V a 5 V con baja impedancia de salida y se conecta al GPIO34 por el circuito de la figura 113: R1 = 18 kΩ, R2 = 15 kΩ, C = 100 nF. Hallar la tensión máxima en el pin, la resistencia de Thévenin, la frecuencia de corte del filtro, el LSB referido al sensor, el mínimo medible y el peor caso con resistencias del 1 %.

Datos y supuestos. Atenuación máxima: rango efectivo 0,150 V a 2,450 V, LSB = 0,598 mV. Se desprecia la corriente de entrada del ADC (hipótesis a validar en el laboratorio). Incógnitas: k, vp,

Rth, fc.
Método. Divisor de tensión sin carga (S01-1) más Thévenin visto desde el pin, porque el condensador forma con Rth un RC.

k =

R2
R1 + R2

=

15
33
= 0,4545, | vp(5 V) = 5(0,4545) = 2,273 V, | (229)

Rth =

R1R2
R1 + R2

=

(18000)(15000)
33000
= 8,182 kΩ, | (230)

fc =

1
2πRthC

=

1
2π(8182)(100 × 10⁻⁹)
= 194,5 Hz. | (231)

El LSB visto en el sensor es LSB/k = 0,598 mV/0,4545 = 1,316 mV. El mínimo del sensor que cae dentro del rango efectivo es 0,150 V/k = 0,330 V y el error total de ±60 mV equivale a ±132 mV

en el sensor. Con 1 % en ambas resistencias el peor caso es kmax =

1,01R2
0,99R1 + 1,01R2
| = 0,4595 y

vp = 2,298 V < 2,45 V.

Interpretación. El rango del sensor cabe con margen de 0,15 V, pero un sensor entre 0 y 0,33 V no se mide con la exactitud declarada. El corte de 194,5 Hz limita el ancho de banda de la señal útil; si el sensor es más rápido, C debe reducirse. Si R2 se abre, el pin recibe la tensión del sensor: la protección contra ese fallo no se analizó y debe estudiarse antes de un montaje permanente. Comprobación independiente. Nodal en el pin con corriente de ADC nula: (5 − vp)/18000 = vp/15000 ⇒ vp = 2,273 V (verificado con sympy en el notebook).

### 50.5. Ejemplo S12-1-B Cuentas de duty y rizado de un PWM filtrado

Enunciado. Se genera PWM a f = 5 kHz con reloj de 80 MHz y se desea un promedio aproximado de 35 % de 3,3 V. Hallar la resolución máxima, las cuentas, el duty real, el paso en tensión y el rizado pico a pico tras un filtro RC de R = 10 kΩ y C = 1 µF (sin carga).

Método. Ecuación (228) para el duty; para el rizado, la respuesta exacta de un RC en régimen permanente ante un tren de pulsos, contrastada con la aproximación de pequeño rizado.

Nmax =

$
log2

80 × 10⁶
5 × 10³

%
= ⌊log2 16000⌋ = ⌊13,97⌋ = 13, | (232)
Dcuentas = round(0,35 · 8192) = round(2867,2) = 2867, | d =

2867
8192
= 34,998 %, | (233)
v¯ = 3,3(0,34998) = 1,1549 V, | ∆vpaso =

3,3
8192
= 0,403 mV. | (234)

Con τ = RC = 10 ms (fc = 15,92 Hz) y T = 0,2 ms, el rizado exacto es

∆vpp = VDD

(1 − e

−dT /τ )(1 − e

−(1−d)T /τ )
1 − e⁻T /τ | = 15,01 mV, | (235)

y la aproximación VDD d(1 − d) T /τ = 3,3(0,35)(0,65)(0,02) = 15,0 mV coincide.

Interpretación. El paso de duty es mucho menor que el error del ADC o la tolerancia de VOH: el promedio real depende de la tensión de salida del pin, no de las cuentas. Aumentar N más allá de lo necesario no mejora la exactitud. La figura 114 muestra que tras unos 5τ = 50 ms el promedio se asienta.

Comprobación independiente. Simulación temporal del RC por pasos (notebook): el promedio del último periodo es 1,1546 V, a 0,3 mV del ideal.

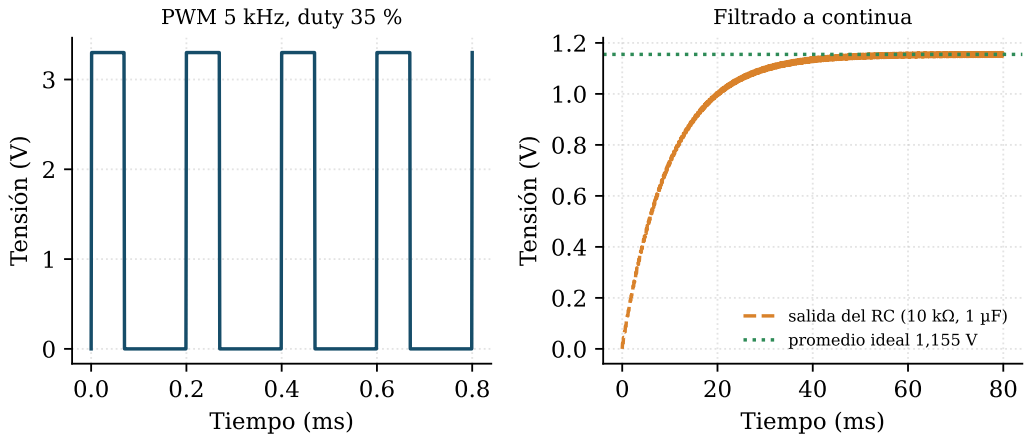
[picture p102: figure]
Tiempo (ms); Tensión (V); PWM 5 kHz, duty 35 %; Filtrado a continua; salida del RC (10 kΩ, 1 µF) promedio ideal 1,155 V

Figura 114: PWM de 5 kHz con duty 2867/8192 (izquierda) y salida de un RC de 10 kΩ/1 µF (derecha), simulación del notebook de la clase 1. Se observa el asentamiento en unas pocas constantes de tiempo y el promedio de 1,155 V.

### 50.6. Firmware de apoyo

El siguiente listado reúne la lectura del ADC con atenuación máxima y la salida PWM. No se compiló ni se ejecutó en hardware; requiere el núcleo arduino-esp32 3.x (funciones ledcAttach y ledcWrite documentadas en la rama latest). Anote la versión exacta del núcleo que use.

1 | /*
2 | * Circuitos II - Semana 12 , sesion 1: ADC y PWM en ESP32 .
3 | * Plataforma : ESP32 - DevKitC V4 con ESP32 - WROOM -32 E ( variante ESP32 - DevKitC -32 E ) .
4 | * Entorno : Arduino IDE o arduino - cli con el nucleo arduino - esp32 3. x ( API ledcAttach /
ledcWrite ) .
5 | * | Anote la version exacta del nucleo que use .
6 | * ESTADO : NO COMPILADO NI EJECUTADO EN HARDWARE . Revision documental solamente .
7 | *
8 | * Conexion ( baja tension ; ver la figura de cableado del ADC en el texto ) :
9 | * | Sensor 0 -5 V -> R1 18 kOhm -> GPIO34 ( ADC1_CH6 ) -> R2 15 kOhm -> GND , con C 100 nF de
GPIO34 a GND .
10 | * | GPIO18 -> R 330 Ohm -> LED -> GND ( salida PWM ) .
11 | * Nunca aplique mas de 3 ,3 V ( VDD ) al pin : VIH maximo = VDD + 0 ,3 V segun la hoja de datos
del modulo .
12 | */
13 | # include < Arduino .h >

14
15 | constexpr uint8_t PIN_ADC = 34; | // GPIO34 , solo entrada , ADC1_CH6
16 | constexpr uint8_t PIN_PWM = 18; | // GPIO18 , salida generica ( no es pin de arranque )
17 | constexpr uint32_t PWM_FREQ_HZ = 5000;
18 | constexpr uint8_t | PWM_BITS = 13; | // maximo = floor ( log2 (80 e6 /5 e3 ) ) = 13 con reloj APB
de 80 MHz
19 | constexpr float | DUTY_OBJETIVO = 0.35 f; | // 35 %
20 | constexpr float | K_DIV = 15.0 f / (18.0 f + 15.0 f); | // R2 /( R1 + R2 ) , valores nominales

21
22 | void setup () {
23 | Serial . begin (115200) ;
24 | analogReadResolution (12) ; | // 0..4095
25 | analogSetPinAttenuation ( PIN_ADC , ADC_11db ); | // rango efectivo 150..2450 mV ( Tabla 11 ,
hoja de datos )
26 | ledcAttach ( PIN_PWM , PWM_FREQ_HZ , PWM_BITS );
27 | const uint32_t cuentas = ( uint32_t ) lroundf ( DUTY_OBJETIVO * (1 UL << PWM_BITS ));
28 | ledcWrite ( PIN_PWM , cuentas );
29 | Serial . printf (" PWM : %lu de %lu cuentas ( %.4f % %)\n" , ( unsigned long ) cuentas ,
30 | ( unsigned long ) (1 UL << PWM_BITS ) , 100.0 f * cuentas / (1 UL << PWM_BITS )) ;
31 | Serial . println (" raw , mV_pin , V_sensor " );

32 }

33
34 | void loop () {
35 | // Promedio de 64 muestras : reduce ruido aleatorio ( no corrige el error de ganancia del
chip ) .
36 | uint32_t acum_raw = 0, acum_mv = 0;
37 | for ( int i = 0; i < 64; ++ i) {
38 | acum_raw += analogRead ( PIN_ADC );
39 | acum_mv | += analogReadMilliVolts ( PIN_ADC ) ;
40 | }
41 | const float raw = acum_raw / 64.0 f;
42 | const float mv | = acum_mv / 64.0 f;
43 | const float v_sensor = ( mv / 1000.0 f) / K_DIV ;
44 | Serial . printf (" %.1f , %.1f , %.3f\n " , raw , mv , v_sensor );
45 | delay (500) ;
46 | }

### 50.7. Ejercicios

S12-1-E1 (GPIO y LED). Un LED rojo se conecta del GPIO18 a tierra con una resistencia en serie. Se supone Vf entre 1,8 V y 2,0 V. Con VOH ≥ 2,64 V se exige al menos 3 mA en el peor caso. Hallar la resistencia máxima, escoger un valor E12 y calcular el intervalo de corriente resultante. Comparar con los 40 mA y 28 mA de la tabla de la hoja de datos.
S12-1-E2 (divisor de 0 a 10 V). Un sensor industrial de baja impedancia entrega 0 V a 10 V. Diseñar un divisor con resistencias de 1 % de la serie E24 que deje el pin por debajo de 2,45 V en el peor caso, y obtener el mínimo medible del sensor, el LSB referido al sensor y Rth. Explicar qué ocurre si el sensor sube a 12 V.

Pregunta conceptual. El ADC del ESP32 tiene 12 bits y una hoja de datos que declara un error total de ±60 mV en el rango de 150 mV a 2450 mV. ¿Cuántos bits efectivos justifica cada dato y por qué promediar muestras no corrige el error de ganancia del chip?

### 50.8. Errores frecuentes y comprobaciones

Error frecuente

Aplicar 5 V a un GPIO o al ADC: el máximo de VIH es 3,6 V con VDD = 3,3 V.

Usar VDD como referencia del ADC: la referencia de diseño es 1100 mV y se calibra.

Confundir resolución (LSB) con exactitud (error total de ±60 mV).

Elegir GPIO34–GPIO39 como salida, GPIO6–GPIO11 como GPIO, o dejar un circuito externo en un pin de arranque.

Calcular el duty de PWM con una resolución mayor que Nmax para la frecuencia elegida.

Olvidar unir la masa del sensor con la del ESP32.

### 50.9. Conexión con el proyecto

Cada sensor del proyecto integrador necesita una tabla de acondicionamiento (rango del sensor, divisor, Rth, fc, mínimo y máximo en el pin) y un plan de pines justificado. La tabla se usa en el laboratorio del jueves y en la semana 13, cuando se envíen datos por MQTT. Para el jueves, el estudiante trae el cálculo de su divisor.

### 51. S12-2 Wi-Fi, Bluetooth y configuraciones

Resultados, prerrequisitos y distribución

Al terminar, el estudiante podrá (1) declarar qué comunicaciones ofrece el módulo fijado y qué límites trae cada una; (2) dimensionar la carga de datos de un nodo de telemetría y elegir entre texto y formato binario; (3) verificar un plan de pines frente a las restricciones de ADC1/ADC2, pines solo de entrada, pines de arranque y flash. Se comprueba al final con S12-2-E2.
Se requieren S12-1 (plataforma, GPIO y ADC) y nociones de bits, bytes y tasa. No se usa MQTT todavía: llega en la semana 13.

Distribución propuesta de 120 minutos

Diagnóstico, 10 min (qué hizo el pin elegido en S12-1). Explicación de Wi-Fi, Bluetooth y configuración, 30 min. Ejemplos guiados, 30 min. Práctica de ejercicios, 35 min. Cierre, 15 min. Trabajo previo: instalar el entorno Arduino con el núcleo arduino-esp32 3.x y copiar config.h.example a config.h con los datos de una red de 2,4 GHz de pruebas. Prueba de enlace en hardware: actividad opcional con los listados; no sustituye al laboratorio del jueves.

### 51.1. Qué comunicaciones ofrece el módulo y qué no se verificó

Para el ESP32-WROOM-32E (hoja de datos v2.1 [S12-1], consulta 2026-11-03):

Wi-Fi: 802.11 b/g/n en 2,4 GHz, canales con frecuencia central entre 2412 MHz y 2484 MHz. La tasa de 802.11n hasta 150 Mbit/s es una tasa de capa física; el caudal útil con TCP/IP y MQTT es mucho menor y debe medirse. No hay Wi-Fi de 5 GHz.

Bluetooth: Bluetooth V4.2 BR/EDR y Bluetooth LE, con transmisores clase 1, 2 y 3. La documentación del núcleo Arduino indica que el perfil SPP (puerto serie sobre Bluetooth clásico) solo existe en el chip ESP32 original [S12-5]; por eso el listado de SPP no se traslada sin comprobar a otras variantes.

Alimentación: 3,0 V a 3,6 V y fuente capaz de al menos 0,5 A. Una fuente USB o un cable pobres pueden provocar reinicios al transmitir (cuestión práctica, a medir).

No se verificó en esta semana: el consumo de corriente por modo, el alcance, el caudal real, la API completa de BLE (solo se incluye SPP) y los modos de estación y punto de acceso más allá del uso de estación en el listado. Quien los use debe consultar la documentación vigente.

Dos configuraciones afectan al resto del diseño. Primero, ADC2 y Wi-Fi: ESP-IDF indica que ADC2 también lo usa el controlador Wi-Fi y que la lectura oneshot protege el acceso entre ambos [S12-3]; con Wi-Fi activo, el sensor analógico va en un pin de ADC1 (GPIO32–GPIO36, GPIO39). Segundo, credenciales: la red y la clave van en un archivo de configuración separado que no se publica.

Sensor
(NTC, 0–5 V)

Acondicionamiento
divisor + C

ADC1
12 bits

Firmware
promedio,
calibración

Wi-Fi o
Bluetooth

antialiasing, rango 0,15–2,45 V validar rango antes de enviar

Figura 115: Cadena de adquisición y transporte de la semana. La salida de la cadena es un mensaje validado; el broker y el consumidor se tratan en la semana 13.

### 51.2. Modelo de carga de datos

Sea B el tamaño en bytes de un mensaje y fm el número de mensajes por segundo. La carga útil es Ru = B fm en B/s, sin incluir cabeceras de TCP/IP ni de MQTT. Si el caudal efectivo del enlace es Renl, la frecuencia máxima de mensajes es

fm,max =

Renl
B
. | (236)

El valor de Renl no se ha medido en este material: se usa 100 kbit/s (12,5 kB/s) solo como supuesto de planificación que el estudiante sustituye por su medición.

10

−1 | 10
0 | 10
1 | 10
2 | 10

3

### Mensajes por segundo (Hz)

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
### Carga útil (B/s)

JSON (73 B por mensaje)
binario (15 B por mensaje) caudal supuesto 100 kbit/s

Figura 116: Carga útil frente a mensajes por segundo para un mensaje JSON de 73 B y uno binario de 15 B (cálculo del notebook de la clase 2). La línea de trazos rojos es el caudal supuesto de 100 kbit/s. Debe observarse cuánto adelanta cada formato el cruce con el límite.

### 51.3. Ejemplo S12-2-A Texto frente a binario

Enunciado. Un nodo envía 4 canales de tensión en milivoltios con identificador, contador de secuencia y marca de tiempo. Comparar el tamaño de un mensaje JSON con uno binario y hallar la frecuencia máxima por (236) con el caudal supuesto.

Datos. JSON compacto:

{" id ":" esp32 -01" ," seq ":1234 ," t ":1730600000 ," v ":[1.234 ,2.345 ,0.512 ,3.021]}

Binario: identificador 1 B, secuencia 2 B, tiempo 4 B y 4 canales de 2 B en mV (<BHI4H, little-endian).

Método. Contar bytes y aplicar (236).

Bjson = 73 B, Bbin = 1 + 2 + 4 + 4(2) = 15 B,

73
15
= 4,87, | (237)

f

json
m,max =

12500
73

= 171 Hz, fbin
m,max =

12500
15
= 833 Hz. | (238)

A fm = 10 Hz: 730 B/s en JSON y 150 B/s en binario.

Interpretación. El binario es 4,87 veces más compacto, pero el JSON es legible, extensible y no necesita decodificador propio. A 10 Hz ambos caben holgadamente en el caudal supuesto. El criterio de elección no es solo el tamaño: incluye depuración y compatibilidad. En el binario las unidades (mV como entero sin signo de 16 bits) deben fijarse y documentarse, y un valor mayor de 65,535 V no cabe; el rango de este sensor sí.

Comprobación independiente. El notebook empaqueta el mensaje con struct.pack, lo desem-paqueta y comprueba que se recuperan los mismos valores y que calcsize da 15 B.

### 51.4. Ejemplo S12-2-B Revisión de un plan de pines con Wi-Fi activo

Enunciado. Un grupo propone: GPIO12 y GPIO25 como entradas analógicas, GPIO34 como salida PWM, GPIO6 como entrada digital y GPIO18 como salida. El nodo usará Wi-Fi. Encontrar los problemas y proponer un plan corregido.
Método. Contrastar cada pin con las restricciones de la hoja de datos [S12-1] y ESP-IDF [S12-3]: ADC1 en GPIO32–GPIO36 y GPIO39; ADC2 en GPIO0, 2, 4, 12–15, 25–27; solo entrada en GPIO34, 35, 36, 39; arranque en GPIO0, 2, 5, 12, 15; flash en GPIO6–GPIO11.

GPIO Uso propuesto Observación

12 entrada analógica ADC2 con Wi-Fi activo; además pin de arranque (MTDI) 25 entrada analógica ADC2 con Wi-Fi activo
34 salida PWM | pin solo de entrada
6 entrada digital | ocupado por la flash del módulo
18 salida | sin observación

Plan corregido: entradas analógicas en GPIO32, GPIO33 y GPIO35 (ADC1); PWM en GPIO18; entrada digital en GPIO19.

Interpretación. Cinco observaciones sobre cuatro pines. Un pin puede ser válido para una función y no para otra; GPIO12 muestra que dos restricciones independientes pueden sumarse.

Comprobación independiente. La función revisar() del notebook codifica las restricciones y devuelve las cinco observaciones del plan propuesto y ninguna del plan corregido (assert). Es una revisión de datos de la hoja de datos, no una prueba en hardware.

### 51.5. Firmware de apoyo

Listados de la actividad opcional (no compilados ni ejecutados en hardware). Primero la conexión Wi-Fi como estación, con tiempo de espera y reconexión, y su archivo de configuración de ejemplo.

1 // Copie este archivo como config . h y complete sus datos . NO suba config . h a ningun repositorio .
2 | # pragma once
3 | # define WIFI_SSID " su_red_2_4GHz "
4 | # define WIFI_PASS " su_clave "
1 | /*
2 | * Circuitos II - Semana 12 , sesion 2: Wi - Fi en modo estacion con reconexion .
3 | * Plataforma : ESP32 - DevKitC V4 con ESP32 - WROOM -32 E . Nucleo arduino - esp32 3. x ( anote la
| version ) .
4 | * ESTADO : NO COMPILADO NI EJECUTADO EN HARDWARE . Revision documental solamente .
5 | * El modulo trabaja en 2 ,4 GHz (802.11 b / g / n ) : no se conecta a redes solo de 5 GHz .
6 | * Co nf ig ur ac io n : copie config . h . example como config . h en esta carpeta .
7 | */
8 | # include < WiFi .h >
9 | # include " config .h "

10
11 | constexpr uint32_t TIMEOUT_CONEXION_MS = 15000;
12 | constexpr uint32_t REINTENTO_MS = 5000;

13
14 | bool conectar () {
15 | WiFi . mode ( WIFI_STA );
16 | WiFi . begin ( WIFI_SSID , WIFI_PASS );
17 | const uint32_t t0 = millis () ;
18 | while ( WiFi . status () != WL_CONNECTED && millis () - t0 < TIMEOUT_CONEXION_MS ) {
19 | delay (250) ;

20 | }
21 | return WiFi . status () == WL_CONNECTED ;
22 | }

23
24 | void setup () {
25 | Serial . begin (115200) ;
26 | Serial . println ( conectar () ? " Conectado " : " Sin conexion ( se reintentara )") ;
27 | }

28
29 | void loop () {
30 | if ( WiFi . status () == WL_CONNECTED ) {
31 | Serial . printf (" IP= %s RSSI= %d dBm canal= %d \n" , WiFi . localIP () . toString () . c_str () ,
32 | WiFi . RSSI () , WiFi . channel () );
33 | delay (2000) ;
34 | } else {
35 | // Perdida de red : no bloquear la adquisicion local ; reintentar con espera acotada .
36 | Serial . println (" Red perdida ; reintentando ... ");
37 | WiFi . disconnect () ;
38 | delay ( REINTENTO_MS );
39 | conectar () ;
40 | }
41 | }

Después, Bluetooth clásico con SPP; solo es aplicable al ESP32 original [S12-5].

1 | /*
2 | * Circuitos II - Semana 12 , sesion 2: Bluetooth clasico ( perfil SPP ) como puerto serie
inalambrico .
3 * Plataforma : ESP32 - DevKitC V4 con ESP32 - WROOM -32 E . La hoja de datos del modulo ( v2 .1) declara
4 * Bluetooth V4 .2 BR / EDR y Bluetooth LE ; la do cu me nt ac ion del nucleo indica que SPP solo existe en el
5 | * chip ESP32 original . No es valido para otras variantes ( S2 , S3 , C3 ...) sin comprobarlo .
6 | * ESTADO : NO COMPILADO NI EJECUTADO EN HARDWARE . Revision documental solamente .
7 | * Requiere un esquema de particiones con espacio suficiente para Bluetooth ( ver menu de la
placa ) .
8 | */
9 | # include " BluetoothSerial .h"

10
11 | # if ! defined ( CONFIG_BT_ENABLED ) || ! defined ( CONFIG_BLUEDROID_ENABLED )
12 | # error " Bluetooth clasico no esta habilitado en esta configuracion del nucleo / placa ."
13 | # endif

14
15 BluetoothSerial SerialBT ;

16
17 | void setup () {
18 | Serial . begin (115200) ;
19 | SerialBT . begin (" ESP32 - S12 " ); | // nombre visible ; el e m p a r e j a m i e n t o lo hace el
| telefono o el PC
20 | Serial . println (" Dispositivo listo para emparejar : ESP32 - S12 ");
21 | }

22
23 | void loop () {
24 | // Eco : lo recibido por Bluetooth se muestra en USB y viceversa .
25 | while ( SerialBT . available () ) Serial . write ( SerialBT . read () );
26 | while ( Serial . available () ) | SerialBT . write ( Serial . read () );
27 | delay (10) ;
28 | }

### 51.6. Ejercicios

S12-2-E1 (carga de datos). Un nodo envía 6 canales con los mismos campos del ejemplo A a 5 Hz. Hallar el tamaño del mensaje JSON y binario (identificador 1 B, secuencia 2 B, tiempo 4 B, 6 canales de 2 B), la carga útil en B/s y la frecuencia máxima con el caudal supuesto de 100 kbit/s. El JSON de ejemplo es:

{" id ":" esp32 -01" ," seq ":1234 ," t ":1730600000 ," v ":[1.234 ,2.345 ,0.512 ,3.021 ,1.111 ,2.222]}

S12-2-E2 (plan de pines). Proponer un plan para 3 sensores analógicos, 1 salida PWM y 1 entrada digital con Wi-Fi activo, sin usar pines de arranque ni solo de entrada como salida, y justificar cada pin con una frase.

Pregunta conceptual. Un compañero afirma que “todo ESP32 trae Bluetooth clásico y ADC de 12 bits con los mismos pines”. ¿Qué parte puede afirmarse para el ESP32-WROOM-32E con la documentación de esta semana y qué parte no?

### 51.7. Errores frecuentes y comprobaciones

Error frecuente

Leer un sensor analógico en ADC2 con Wi-Fi activo.

Tomar los 150 Mbit/s del estándar como caudal de la aplicación.

Intentar conectarse a una red de solo 5 GHz.

Publicar config.h con la clave de la red.

Suponer que un listado de Bluetooth clásico funciona en cualquier ESP32.

Bloquear la adquisición esperando la red: la lectura local debe seguir aunque no haya enlace.

### 51.8. Conexión con el proyecto

El plan de pines y el formato de mensaje (campos, unidades, tipo) del proyecto se definen aquí y se usan en la semana 13 para los tópicos y el payload de MQTT. Entregar para el jueves: plan de pines revisado y un mensaje de ejemplo con su tamaño en bytes.

### 52. S12-3 Programación práctica y lectura de sensores

Resultados, prerrequisitos y distribución

Al terminar, el estudiante podrá (1) dimensionar un divisor con un sensor resistivo (NTC) dentro del rango efectivo del ADC y estimar la resolución en grados; (2) justificar una frecuencia de muestreo, un filtro y un promedio para que una interferencia de 60 Hz no se convierta en error; (3) calibrar con dos puntos y validar el rango antes de convertir. Se comprueba al final con el laboratorio y con S12-3-E2.

Se requieren S12-1 y S12-2 y el filtro RC de las semanas anteriores. Prerrequisito del laboratorio: haber revisado el cálculo del divisor y el plan de pines.

Distribución propuesta de 120 minutos

Diagnóstico, 10 min (qué mide realmente el ADC y qué no). Explicación, 20 min. Ejemplos guiados, 25 min. Laboratorio guiado, 50 min. Ejercicios y cierre, 15 min. Trabajo previo: cálculo del divisor del estudiante y revisión del listado s12_c3_ntc.ino. Los listados no han sido probados en hardware: la primera ejecución es del estudiante y se registra.

### 52.1. Concepto físico y modelo

Un NTC es una resistencia cuya magnitud baja al subir la temperatura. Un modelo habitual, válido en un intervalo limitado, usa un parámetro B y la resistencia R25 a T0 = 298,15 K:

RNT C(T) = R25 exp
B

1
T

−

1
T0

, T =

1
T0

+

1
B

ln RNT C

R25 −1
. | (239)

Aquí T está en kelvin. Los valores R25 = 10 kΩ y B = 3950 K son datos del ejemplo; los del termistor real deben tomarse de su hoja de datos.
El NTC se pone arriba, a 3,3 V, y una resistencia fija RF abajo (figura 117), de modo que la tensión del pin crece con la temperatura y se mantiene entre 0,15 V y 2,45 V:

vp = Val

RF

RF + RNT C

, | RNT C = RF

Val − vp
vp
. | (240)

Atención: el ADC no usa Val como referencia (S12-1). El divisor no es ratiométrico respecto del ADC: si Val cambia, vp cambia y el ADC no lo compensa.

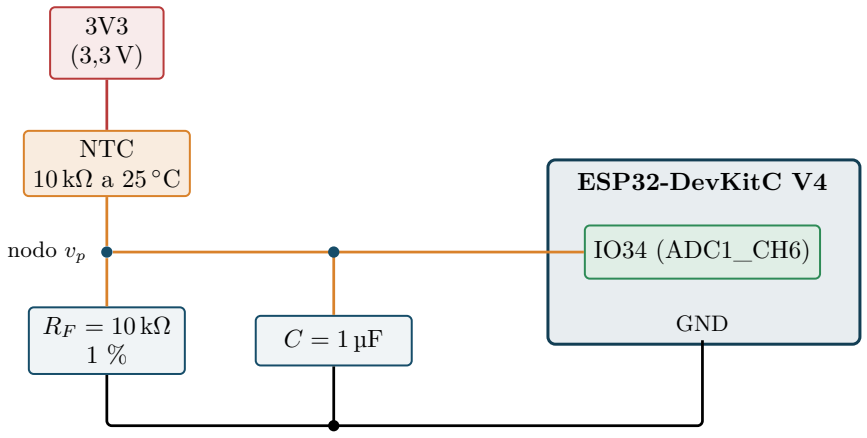
[picture p103: figure]
NTC 10 kΩ a 25 ◦C; ESP32-DevKitC V4; IO34 (ADC1_CH6); GND; nodo vp

vp = 3,3 V RF /(RF + RNT C ). 0

◦C a 50 ◦C → 0,76 V a 2,43 V (cálculo). GPIO34 pertenece a ADC1. Parámetros del NTC: tomar los de su hoja de datos.

Figura 117: Conexión del NTC al GPIO34 (ADC1_CH6) del ESP32-DevKitC V4. C = 1 µF forma con la resistencia de Thévenin del divisor (5 kΩ a 25 ◦C) un filtro RC de fc = 31,8 Hz. Diseño propuesto, sin probar en hardware.

Aliasing. Si se muestrea a fs una componente de frecuencia f, aparece en el espectro discreto a la frecuencia alias
fa =

f − fs round

f
fs
. | (241)

Con fs = 10 Hz y f = 60 Hz, fa = 0: la interferencia aparece como un desplazamiento continuo que ningún filtro digital posterior distingue de la señal. Con fs = 100 Hz, fa = 40 Hz. La defensa es analógica (filtro antes del ADC) y por promedio sincronizado.

### 52.2. Ejemplo S12-3-A Rango, sensibilidad y error del divisor con NTC

Enunciado. Con RF = 10 kΩ, Val = 3,3 V y los parámetros del ejemplo, verificar que 0 | ◦C a 50 ◦C
cabe en el rango efectivo del ADC, hallar la sensibilidad a 25 ◦C, la resolución en grados y el error por la tensión de alimentación.
Método. Ecuaciones (239) y (240). La sensibilidad dvp/dT se obtiene por diferencia centrada en 24,5

◦C y 25,5

◦C.

T (

◦C) RNT C (Ω) vp (V)

0 | 33 621 | 0,757
25 | 10 000 | 1,650
50 | 3 588 | 2,429

Todo cae entre 0,15 V y 2,45 V, aunque 50 ◦C deja solo 21 mV de margen. Sensibilidad a 25 ◦C: 36,66 mV/

◦C. Resolución por LSB: 0,598 mV/(36,66 mV/

| | ◦C) = 0,016 ◦C por código. El error total
de calibración ±60 mV equivale a ±1,64 ◦C.

Alimentación. Si Val es 3,0 V o 3,6 V y el firmware supone 3,3 V, a 25 ◦C real se calcula 20,95 ◦C y 29,16 ◦C: errores de −4,05 ◦C y +4,16 ◦C.

Interpretación. La resolución del ADC (0,016 ◦C) es mucho mejor que su exactitud (1,64 ◦C), que a su vez es menor que el error por alimentación no medida. Hay que medir Val o alimentar el divisor desde una referencia estable, y calibrar.
Comprobación independiente. El notebook invierte (240) y (239) para cada temperatura de la tabla y recupera la temperatura original con error menor que 10⁻⁹ ◦C (assert).

### 52.3. Ejemplo S12-3-B Aliasing de 60 Hz y defensas

Enunciado. La tensión del pin es 1,650 V (NTC a 25 ◦C) más un acoplamiento de 60 Hz de amplitud A = 50 mV y fase desconocida. Se lee a fs = 10 Hz. Hallar el error, el efecto del condensador de la figura 117 y el de un promedio de 100 muestras a 1 kHz.
Método. Muestrear la interferencia: sin(2π · 60 n/10 + φ) = sin φ, porque 60/10 = 6 es entero. La lectura promedio es V0 + A sin φ y el error máximo es A. El condensador atenúa con |H| = 1/

p
1 + (f /fc)

2.

sin filtro: A = 50 mV ⇒ | 50
| 36,66
= 1,36 ◦C, | (242)

con C = 1 µF : fc =

1
2π(5000)(10⁻⁶)
= 31,83 Hz, | (243)
|H(60 Hz)| = 0,469 (−6,6 dB), 23,4 mV ⇒ 0,64 ◦C. | (244)

Con 100 muestras a 1 kHz se promedian exactamente 6 ciclos de 60 Hz, y la suma de sin(2π · 60 n/1000+φ) sobre n = 0 . . . 99 es nula para cualquier φ: el error de ese tipo es nulo (numéricamente menor que 10⁻¹² V).

Interpretación. Un RC de primer orden de fc = 31,8 Hz atenúa solo 6,6 dB a 60 Hz. El promedio sincronizado es mucho más eficaz, pero exige que la ventana contenga un número entero de ciclos y que la red sea de 60 Hz. Con una red de 50 Hz, 0,1 s contiene 5 ciclos y también sirve; para otra frecuencia de interferencia hay que recalcular la ventana, y una interferencia no periódica no se elimina así. La figura 118 resume el efecto.

Comprobación independiente. Se barre la fase de 0 a 360° en el notebook: el error máximo sin filtro es 50 mV (igual a A), con RC 23,4 mV y con promedio nulo; los tres resultados se verifican con assert.

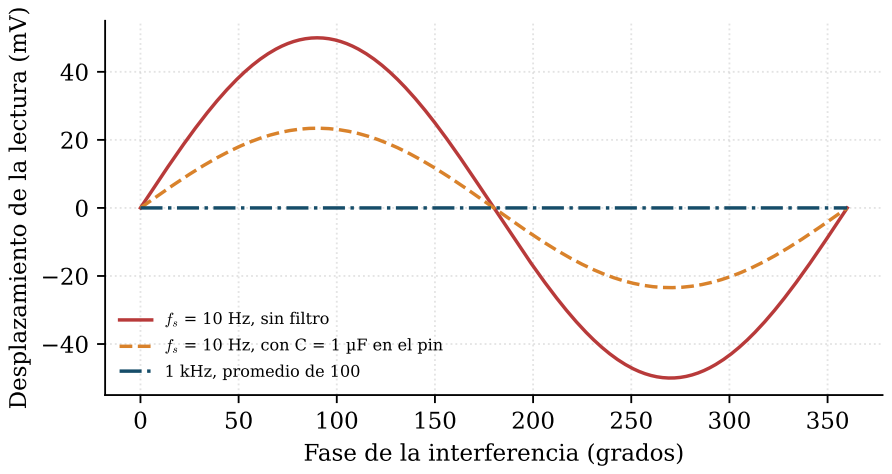
[picture p104: figure]
Fase de la interferencia (grados); Desplazamiento de la lectura (mV); fs = 10 Hz, sin filtro fs = 10 Hz, con C = 1 µF en el pin 1 kHz, promedio de 100

Figura 118: Desplazamiento de la lectura por una interferencia de 60 Hz y 50 mV de amplitud en función de su fase (simulación numérica del notebook de la clase 3). Sin filtro, a 10 Hz, el error llega a ±50 mV; con C = 1 µF baja a ±23,4 mV; con promedio de 100 muestras a 1 kHz es nulo.

### 52.4. Firmware de apoyo

Lectura del NTC con atenuación máxima, promedio sobremuestreado, validación de rango antes de convertir y salida en formato CSV. No compilado ni ejecutado en hardware.

1 | /*
2 | * Circuitos II - Semana 12 , sesion 3: lectura de un NTC con ADC1 , s ob re mu es tr eo y
conversion a grados .
3 | * Plataforma : ESP32 - DevKitC V4 con ESP32 - WROOM -32 E . Nucleo arduino - esp32 3. x ( anote la
| version ) .
4 | * ESTADO : NO COMPILADO NI EJECUTADO EN HARDWARE . Revision documental solamente .
5 | *
6 | * Circuito ( ver la figura de cableado del NTC en el texto ) : 3 V3 -> NTC -> GPIO34 -> R_F 10
kOhm -> GND ,
7 * con C 1 uF de GPIO34 a GND . R_F = 10 kOhm al 1 %. Los parametros del NTC ( R25 , B ) deben tomarse de la
8 | * hoja de datos del termistor que se use ; los valores de abajo son los del ejemplo del
| texto .
9 | * GPIO34 pertenece a ADC1 : se puede usar con Wi - Fi activo ( ADC2 comparte recursos con Wi -
| Fi ) .
10 | */
11 | # include < Arduino .h >
12 | # include < math .h >

13
14 | constexpr uint8_t PIN_ADC = 34;
15 | constexpr float R_F = 10000.0 f; | // ohm , resistencia fija a GND
16 | constexpr float R25 = 10000.0 f; | // ohm , NTC a 25 C ( parametro del ejemplo )
17 | constexpr float BETA = 3950.0 f; | // K ( parametro del ejemplo )
18 | constexpr float T0_K = 298.15 f;
19 | constexpr float V_ALIM = 3.3 f; | // V nominal del divisor ; la alimentacion real debe
| medirse
20 | constexpr float V_MIN_MV = 150.0 f , V_MAX_MV = 2450.0 f; | // rango efectivo declarado (
atenuacion maxima )
21 | constexpr int | N_SOBRE = 100; | // 100 muestras a 1 kHz = 0 ,1 s = 6 ciclos completos
| de 60 Hz
22 | constexpr uint32_t PERIODO_MUESTRA_US = 1000;

23
24 | float leer_mv_sobremuestreado () {
25 | uint64_t acum = 0;
26 | uint32_t t = micros () ;
27 | for ( int i = 0; i < N_SOBRE ; ++ i) {
28 | acum += analogReadMilliVolts ( PIN_ADC );
29 | t += PERIODO_MUESTRA_US ;
30 | while (( int32_t )( micros () - t ) < 0) { /* espera activa breve */ }
31 | }

return ( float ) acum / N_SOBRE ;
}

float temperatura_c ( float v_mv ) {
const float v = v_mv / 1000.0 f;
37 | const float r_ntc = R_F * ( V_ALIM - v) / v; | // NTC arriba , R_F abajo
const float inv_t = 1.0 f / T0_K + logf ( r_ntc / R25 ) / BETA ;
return 1.0 f / inv_t - 273.15 f;
}

void setup () {
Serial . begin (115200) ;
analogReadResolution (12) ; analogSetPinAttenuation ( PIN_ADC , ADC_11db ); Serial . println ("ms ,mV , T_C , estado ");
}

void loop () {
const float mv = leer_mv_sobremuestreado () ;
const bool en_rango = ( mv >= V_MIN_MV && mv <= V_MAX_MV );
if ( en_rango ) {
Serial . printf (" %lu , %.1f , %.2f , ok \n" , millis () , mv , temperatura_c ( mv ));
} else {
55 | Serial . printf (" %lu , %.1f , nan , fuera_de_rango \n" , millis () , mv ); | // validar antes de
convertir
}
delay (500) ;
}

Laboratorio S12-3: lectura de un ADC del ESP32 y comparación con una referencia

Objetivo. Comparar la lectura del ADC1 (GPIO34) con un multímetro, estimar el error de cada punto y comprobar el efecto del promedio sobre una tensión conocida y sobre el NTC. Material. ESP32-DevKitC V4 con ESP32-WROOM-32E alimentado por USB, protoboard, fuente de laboratorio de baja tensión con limitación de corriente o un potenciómetro de 10 kΩ entre 3V3 y GND, multímetro, NTC de 10 kΩ, RF = 10 kΩ al 1 %, C = 1 µF, termómetro de referencia.
Seguridad. Baja tensión aislada solamente. No aplicar más de 3,3 V al pin (el máximo de VIH es 3,6 V). Si se usa un sensor de 5 V, solo a través del divisor, y con la masa común. No conectar la masa de un osciloscopio a un nodo energizado sin comprobar su referencia a tierra. No medir red eléctrica.
Procedimiento.
1. Cargar s12_c1_adc_pwm con el divisor R1–R2 del ejemplo S12-1-A. Si no se dispone de la fuente de 5 V variable, usar el potenciómetro entre 3V3 y GND directamente sobre el pin (sin divisor) y ajustar la constante K_DIV a 1.
2. Fijar la tensión del sensor en 5 valores del rango, medirla con el multímetro y anotar la lectura promedio del ADC. Anotar también la marca del multímetro y su rango.
3. Calcular el error de cada punto y las dos constantes de la calibración de dos puntos (S12-3-E1) con los valores extremos usados.
4. Cargar s12_c3_ntc y registrar tensión, temperatura calculada y la del termómetro de referencia en 3 temperaturas distintas.
5. Repetir 3 con N_SOBRE = 1 (sin promedio) y comparar la dispersión.

Tabla de resultados 1 (tensión). Sin datos: el estudiante los registra.

Punto vmultím. (V) lectura ADC (mV) vsensor calculada (V) error (mV) observaciones

1
2
3
4
5

Tabla de resultados 2 (temperatura).

Punto Tref (

◦C) vp (mV) Tcalc (

◦C) dispersión con N = 1 dispersión con N = 100

1
2
3

Preguntas de análisis. (a) ¿El error observado cabe en ±60 mV? Si no, enumerar causas posibles sin asumirlas. (b) ¿Cambia la lectura con la red Wi-Fi apagada y encendida? (c) ¿Qué errores aportan el multímetro, RF y Val? (d) ¿Cuánto mejoró el promedio la dispersión? Evidencia a entregar. Los listados con la versión del núcleo, las dos tablas completas, la fotografía del montaje con tierra visible y un párrafo que declare qué se midió y qué se calculó. Las capturas de simulación, si las hay, se rotulan como simulación.

### 52.5. Ejercicios

S12-3-E1 (calibración de dos puntos). Con datos hipotéticos de enunciado: se aplican 0,500 V y 2,000 V y el ADC lee 0,532 V y 2,071 V. Hallar ganancia y desplazamiento de la recta de corrección, corregir una lectura de 1,200 V y calcular la temperatura del ejemplo A con y sin corrección (NTC y circuito del ejemplo, Val = 3,3 V). Discutir qué supone una calibración de dos puntos.

S12-3-E2 (aliasing y filtro). Una señal se muestrea a fs = 100 Hz y hay interferencia de 60 Hz. Hallar la frecuencia alias y la frecuencia de corte de un RC de primer orden que atenúe 60 Hz en 40 dB. Calcular C con R = 5 kΩ y discutir si el resultado es razonable para un sensor de temperatura.

Pregunta conceptual. ¿Por qué un divisor alimentado desde 3,3 V no es ratiométrico respecto del ADC del ESP32 y qué dos medidas reducen el error resultante?

### 52.6. Errores frecuentes y comprobaciones

Error frecuente

Suponer que el divisor desde 3V3 compensa las variaciones del ADC (no es ratiométrico).

Muestrear a una frecuencia que convierte la interferencia de red en continua, y creer que se promedia el ruido.

Promediar un número no entero de ciclos de la interferencia.

Convertir a grados sin validar que la tensión esté entre 0,15 V y 2,45 V.

Usar la hoja de datos de otro NTC o asumir B sin consultarla.

Calibrar con instrumentos peores que el ADC o con puntos fuera del intervalo de uso.

### 52.7. Conexión con el proyecto

Esta sesión produce la rutina de adquisición validada (rango, promedio, calibración) y su tabla de error. En la semana 13 el valor convertido se empaqueta y se publica; solo se publica un valor que pasó la validación de rango, y las lecturas fuera de rango se informan como estado y no como dato. El informe del proyecto debe separar lo calculado, lo simulado y lo medido.

### 53. Código y recursos de la semana

Código de la semana

Estado general. El firmware de codigo/esp32/semana_12/ no se ha compilado ni ejecutado en hardware: es código revisado solo en lo documental. Los notebooks sí se ejecutaron y sus assert pasaron; son cálculos, no mediciones.

codigo/python/semana_12/clase1_adc_pwm_divisor.ipynb: cuantización del ADC, divisor 0–5 V, cuentas de duty y rizado del PWM. Reproduce las figuras 112 y 114.

codigo/python/semana_12/clase2_comunicaciones_carga_datos.ipynb: tamaño de mensajes, carga frente a frecuencia y verificación del plan de pines. Reproduce la figura 116.

codigo/python/semana_12/clase3_lectura_ntc_antialiasing.ipynb: divisor con NTC, error por alimentación, aliasing de 60 Hz y calibración de dos puntos. Reproduce la figura 118.

codigo/matlab/semana_12/clase1_adc_pwm.m, clase2_carga_datos.m, clase3_ntc_alias.m: equivalentes de los cálculos. No ejecutados en este entorno.

Firmware Arduino (núcleo arduino-esp32 3.x): s12_c1_adc_pwm, s12_c2_wifi_sta (con config.h.example), s12_c2_bt_spp y s12_c3_ntc.

### 54. Referencias de la semana

Todas consultadas el 2026-11-03. Los documentos de Espressif cambian de versión; verificar la vigente antes de fijar un diseño.

[S12-1] Espressif Systems, ESP32-WROOM-32E & ESP32-WROOM-32UE Datasheet, versión 2.1 (historial: 2026-08-05). https://www.espressif.com/sites/default/files/documentation/esp32-wroom-32e_esp32-wroom-32ue_datasheet_en.pdf (https://www.espressif.com/sites/default/files/documentation/esp32-wroom-32e_esp32-wroom-32ue_datasheet_en.pdf)

[S12-2] Espressif Systems, ESP32 Series Datasheet, versión 5.3. https://www.espressif.com/sites/default/files/documentation/esp32_datasheet_en.pdf (https://www.espressif.com/sites/default/files/documentation/esp32_datasheet_en.pdf)

[S12-3] Espressif Systems, ESP-IDF Programming Guide v6.1, ESP32: “ADC Oneshot Mode Driver” https://docs.espressif.com/projects/esp-idf/en/stable/esp32/api-reference/peripherals/adc/adc_oneshot.html; (https://docs.espressif.com/projects/esp-idf/en/stable/esp32/api-reference/peripherals/adc/adc_oneshot.html) “ADC Calibration Driver” https://docs.espressif.com/projects/esp-idf/en/stable/esp32/api-reference/peripherals/adc/adc_cal ibration.html; “LED Control (LEDC)” https://docs.espressif.com/projects/esp-idf/en/stable/esp32/api-reference/peripherals/ledc.html. (https://docs.espressif.com/projects/esp-idf/en/stable/esp32/api-reference/peripherals/ledc.html)

[S12-4] Espressif Systems, ESP32-DevKitC V4 Getting Started Guide. https://docs.espressif.com/projects/esp-dev-kits/en/latest/esp32/esp32-devkitc/user_guide.html (https://docs.espressif.com/projects/esp-dev-kits/en/latest/esp32/esp32-devkitc/user_guide.html)

[S12-5] Espressif Systems, documentación de arduino-esp32 (rama latest, sin número de versión visible en la página): LEDC, ADC y Bluetooth, bajo https://docs.espressif.com/projects/arduino-esp32/en/latest/api/. (https://docs.espressif.com/projects/arduino-esp32/en/latest/api/)

### Parte XIII

# Semana 13: MQTT, Raspberry Pi y Python
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
