hectorhiguita/circuitos2_proyectofinal/Filtros_proyecto_Final.pdf

GUÍA DE TRABAJO PRACTICO - ´ EXPERIMENTAL Talleres y Laboratorios de Docencia ITM | Codigo ´ | FGL 029
| Version´ | 02
| Fecha | 08-10-2018
1. IDENTIFICACION DE LA GU ´ | ÍA
Nombre de la guía: | Proyecto final
Codigo de la gu ´ ía (No.):
Taller(es) o Laboratorio(s) aplicable(s): | Microelectronica ´
Tiempo de trabajo practico estimado: ´
Asignatura(s) aplicable(s): | Circuitos electricos ii
Programa(s) Academico(s) / ´ Facultad(es): | Ingeniería Electronica, Ingenier ´ ía de Telecomunicaciones / Facultad de Ingenierías

## 2. IDENTIFICACION´

COMPETENCIAS | CONTENIDO TEMATICO ´ | INDICADOR DE LOGRO
Disenar filtros activos para pro- ˜ cesamiento de senales ˜ | Diseno de filtros activos. ˜ Implementacion de filtros acti- ´ vos con integracion IoT. ´ | Disena filtros activos para ˜ implementacion en hardware ´ y aplicaciones de instrumenta-cion, integrando conectividad ´ IoT para el monitoreo y la trans-mision de se ´ nales procesadas en ˜ tiempo real

## 3. RECURSOS REQUERIDOS

Equipos de laboratorio:

- LED emisor infrarrojo y fotodiodo.
- Resistores y capacitores.
- Amplificadores operaciones.
- Microcontrolador (ESP32 mini)
- Display Oled
- Osciloscopio

## 4. OBJETIVO DE LA PRACTICA ´

Disenar e implementar un prototipo universitario de medidor de ritmo card ˜ | íaco basado en fotopletismo-
grafía. El sistema debe usar un LED infrarrojo y un detector optico en una pinza para dedo, acondicionar la ´
senal mediante un LM324N, entregar la se ˜ | nal final en el Punto 6, ubicado en la salida del ˜ | ultimo operacio- ´
nal, leerla con el ADC del ESP32 Mini, calcular los latidos por minuto y visualizar la senal en una pantalla ˜ OLED I2C. Para posteriormente enviar los datos via MQTT mediante protocolos de IoT con el fin de en-
viar alertas prematuras sobre el aumento o la disminucion del pulso card ´ | íaco mediante correo electronico ´
o mensajería de whatsapp.

### 4.1. DESCRIPCION GENERAL DEL SISTEMA ´

El proyecto se divide en seis bloques de desarrolo, el primero consta de la etapa de medida por parte del led emisor y el fotodiodo, la segunda etapa es el acoplamiento de la senales, la tercera es la etapa del ˜

1

seguido o buffer, la cuarta etapa es la primera amplificacion de las se ´ | nales, filtro pasa bajas Sallen-Key ˜
y amplificacion final. Despu ´ | es del acondicionamiento anal ´ | ogico, el ESP32 mini toma muestras por ADC, ´
detecta picos, calcula el ritmo cardíaco y presenta la senal en la pantalla OLED. La salida ac ˜ | ustica mediante ´
buzzer es opcional, pero recomendable para confirmar la deteccion de cada pulso. ´

## 5. PROCEDIMIENTO

Para detectar electronicamente el ritmo cardiaco es utilizado como sensor un diodo emisor de luz in- ´ frarroja y un fotodiodo detector de la misma (ver Figura 1). El funcionamiento del sensor se basa en la
variacion de la cantidad de sangre en los conductos cuando ocurre el movimiento sist ´ | olico, es decir, una ´
contraccion ventricular en el coraz ´ | on de tal forma que impulsa la sangre del coraz ´ | on a todos los tejidos. ´

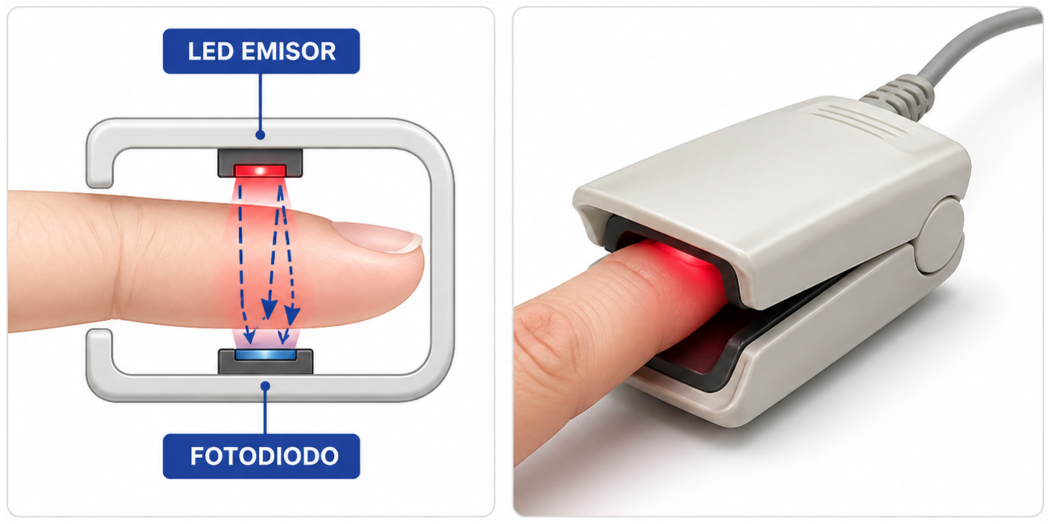
[picture p105: figure]

Figura 1: Pinza de pulsoximetría

El LED debe estar constantemente emitiendo luz; esta luz atraviesa la una, los tejidos y el hueso hasta ˜ llegar a la yema del dedo donde se encuentra el fotodiodo. Mientras no se produzca el pulso, la luz infrarroja que llega al fotodiodo es constante y por lo tanto el voltaje de salida tambien es constante. En el momento ´
en que la sangre llena los conductos, esta crea una perturbacion en la se ´ | nal infrarroja, la cual es detectada ˜
por el fotodiodo generando una variacion en el voltaje de salida. Esta forma de detecci ´ | on de pulso de ´
denomina “pulsoximetría”, ya que no solo puede medir la frecuencia card ´ | íaca sino tambien el nivel de ´
oxigenacion de la sangre, mediante una t ´ | ecnica que se sale del alcance del curso. En donde el circuito de ´
acondicionamiento para el sistema de adquisicion debe ser implementado de acuerdo con la Figura ´ | 2.

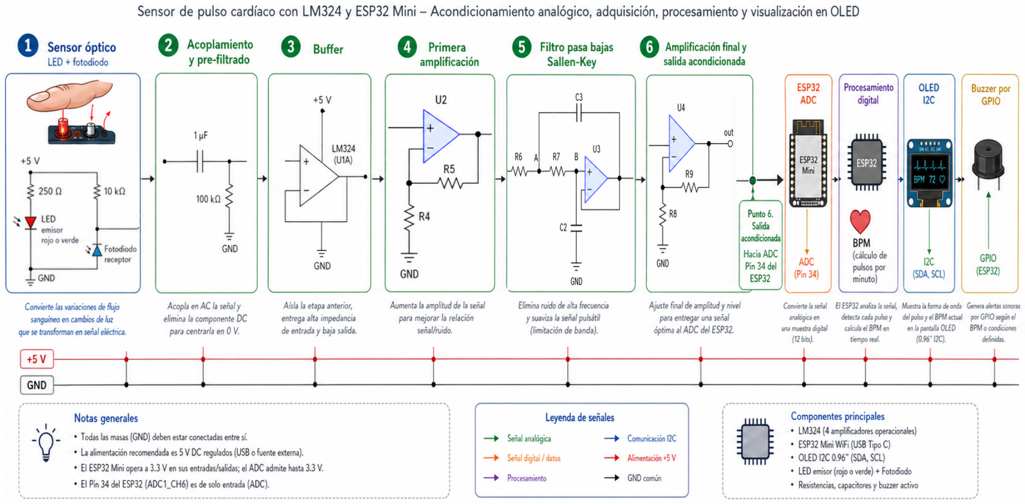
[picture p106: figure]

Figura 2: Circuito acondicionador del sensor infrarrojo y Diagrama de etapas para visualizacion de una ´ senal de pulso ˜

El voltaje de salida del fotodiodo es muy pequeno (en el orden de los ( ˜ | mV)). Ademas, est ´ | a mezclado con ´
interferencia infrarroja del medio ambiente, por lo que se debe no solo amplificar sino tambi ´ | en filtrar. La ´

2

amplificacion no debe ser realizada en un solo bloque ya que esta ser ´ | ía contraproducente para la adquisicion´
de la informacion. ´

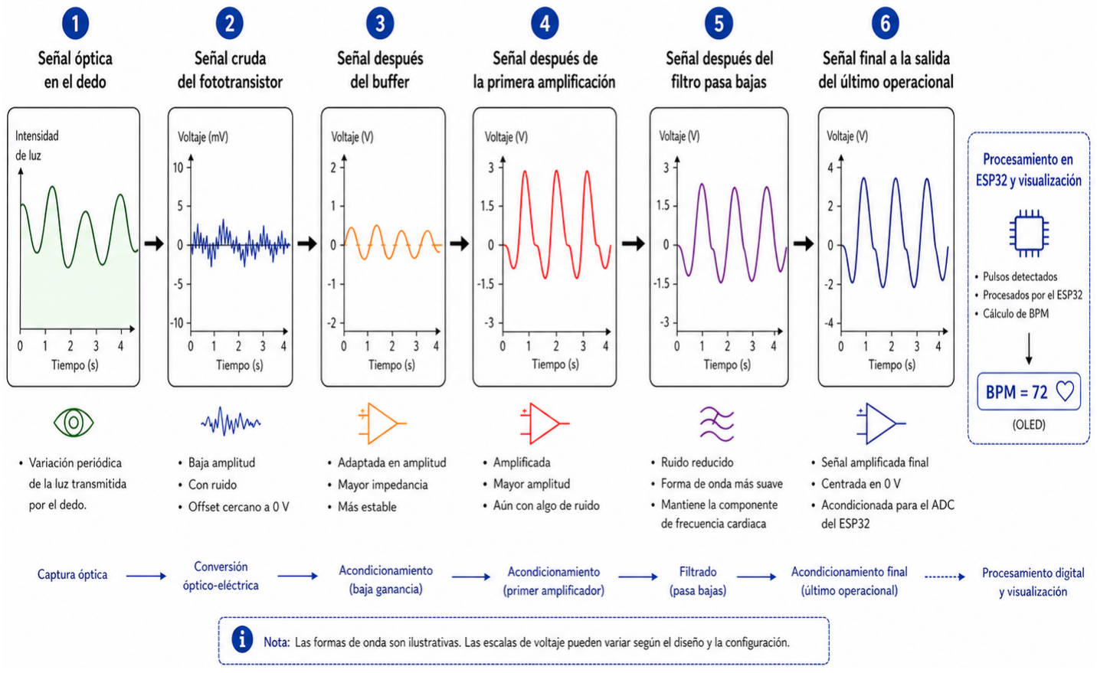
[picture p107: figure]

Figura 3: Visualizacion de la onda de pulso en el osciloscopio ´

Los filtros deben tener en cuenta que la frecuencia cardíaca maxima de una persona est ´ | a en el orden de ´
los 300 latidos por minuto. Los valores de amplificacion no son estrictos. La se ´ | nal en el osciloscopio debe ˜
verse de forma similar a la onda mostrada en la Figura 3. Adiconalmente, note durante el montaje no basta
con conectar todo y cargar el codigo. El sistema debe validarse por etapas. La se ´ | nal cruda del detector ˜
tendra baja amplitud y ruido; luego el buffer debe estabilizarla; la primera amplificaci ´ | | on debe elevar la ´
amplitud; el filtro debe suavizarla; y la salida final debe quedar acondicionada para el ADC.

### 5.1. Condicion cr ´ ítica antes de conectar el ADC

El ADC del ESP32 mini no tolera senales negativas ni tensiones superiores a 3.3 V. Antes de conectar ˜
el Punto 6 al microcontrolador, se debe medir la salida del ultimo operacional con el osciloscopio. La se ´ | nal ˜
debe quedar dentro de 0 a 3,3 V durante todo el funcionamiento. Si la senal queda centrada en 0 V, se debe ˜ agregar un offset DC cercano a 1.65 V o ajustar la referencia de las etapas para que la senal quede centrada ˜ dentro del rango del ADC. Si la amplitud supera 3.3 V, se debe reducir la ganancia o agregar proteccion´ y escalamiento de entrada. Tenga en cuenta que esta condicion no es opcional. Conectar directamente una ´
senal negativa o superior a 3.3 V puede da ˜ | nar el ESP32. ˜

## 6. PROCEDIMIENTO DE LA PRACTICA ´

Disene un sistema de adquisici ˜ | on de onda de pulso tal que muestre en una Oled la frecuencia card ´ | íaca
de un individuo. En donde la version final debe verse como un prototipo acad ´ | emico realista. No se exige un ´
producto comercial cerrado. El montaje del circuito recomendado es usar una PCB, LM324N, resistencias y capacitores convencionales, portapilas 2 x AAA con elevador a 5 V si se requiere autonomía, pantalla OLED montada en la parte superior y una pinza impresa en 3D para alinear el LED emisor y el fotodetector.

La carcasa debe permitir acceso a la batería, al puerto USB-C del ESP32 mini, al interruptor de encendido si se instala, y a los tornillos de cierre. La pinza debe sostener el dedo sin bloquear completamente la circulacion. El LED y el fotodetector deben quedar enfrentados y protegidos de la luz ambiente. Si hay ´
filtracion de luz externa, la se ´ | nal se vuelve inestable y el algoritmo detectar ˜ | a falsos pulsos. ´

3

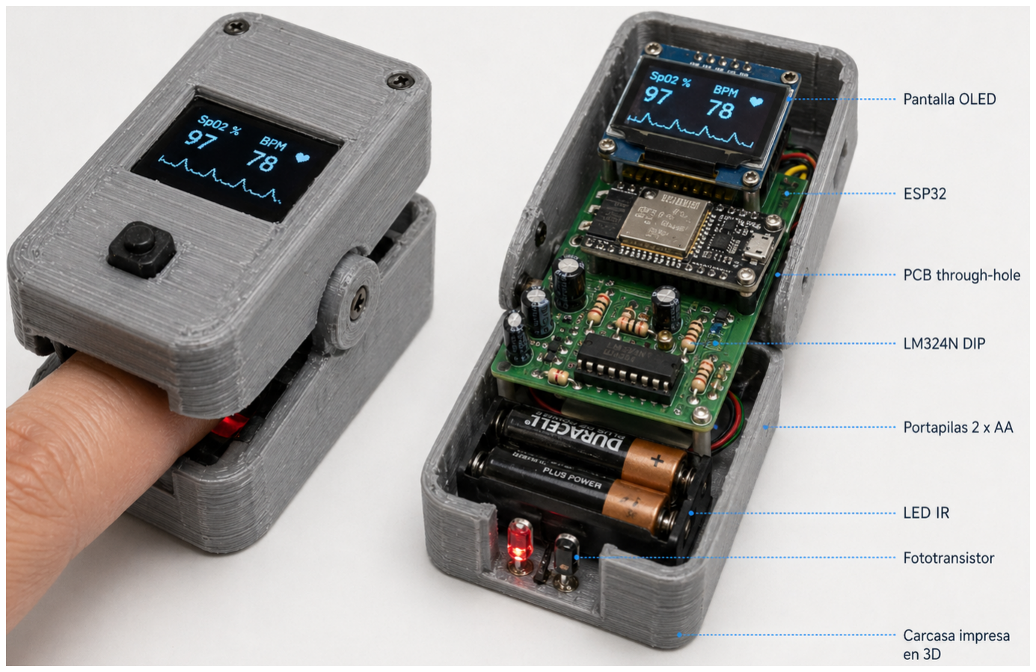
[picture p108: figure]

Figura 4: Referencia visual del encapsulado con carcasa impresa en 3D, PCB, portapilas 2 x AAA, OLED, ESP32 mini y sensor optico integrado. ´

Adicionalmente, tenga en cuenta que, el proyecto se considera funcional cuando la pantalla OLED muestra una forma de onda coherente con la pulsacion, el valor de BPM se actualiza de forma estable ´
despues de varios segundos de medici ´ | on, el buzzer responde a los picos detectados sin activarse continua- ´
mente, la senal del Punto 6 se mantiene dentro del rango admisible del ADC y el prototipo final conserva ˜ una construccion segura, ordenada y reproducible. ´
7. PARAMETROS DE EVALUACI ´ | ON´
Tenga en cuenta que se deberan utilizar el led emisor y el fotodiodo para la pulsoximetr ´ | ía, si estos
no son los usados su nota sera 0.0. ´

No se aceptan pdroductos sin acabados como se referencia en la figura 4 o similares.

Se pedira entrega de informe escrito. ´

El 50% de la evaluacion corresponde al funcionamiento del sistema. El otro 50% corresponde al ´ protocolo de comunicacion y envio de alertas por MQTT o medio que usted desee y graficos.

## Referencias

Elaborado por: | Jhon Jairo Rojas Montano
Revisado por:
Version: | 001 ´
Fecha: | 21/10/2025

4
