hectorhiguita/circuitos2_proyectofinal/Tablas.pdf

Circuitos Eléctricos II · Guía de implementación | 1

# Implementación del medidor de ritmo cardíaco

## Circuitos Eléctricos II y Laboratorio

Material de referencia para reproducir el montaje y configurar el programa. Contiene las conexiones de acondicionamiento, los valores de los componentes, los cálculos de ganancias y filtros, y los dos programas del proyecto.

Fuente: Jorge Barrera y Juan Manuel Restrepo, Proyecto final Medidor de ritmo cardiaco, semestre 2026-1. Circuito y cálculos: páginas 3 a 5. Código: páginas 12 a 20. Se conservan los valores del trabajo y se precisan los resultados numéricos.

## 1 Circuito y valores de referencia

Etapa | Componentes y conexiones
Sensor óptico | LED rojo con resistencia serie de 100 Ω y receptor óptico. La conexión y polaridad del receptor deben tomarse de la Figura 1 de la página 3 del trabajo base. Confirmar la referencia del receptor y la tensión de alimentación antes del montaje.
Acoplamiento y buffer | Salida del sensor → condensador serie de 1 µF → nodo con resistencia de 100 kΩ a tierra → entrada no inversora del buffer. Unir salida y entrada inversora del buffer.
Preamplificación | Amplificador no inversor. Rf = 33 kΩ entre salida y entrada inversora. Rg = 1,8 kΩ entre entrada inversora y tierra. Señal del buffer a la entrada no inversora.
Sallen Key | R1 = R2 = 68 kΩ y C1 = C2 = 1 µF. Operacional como seguidor. Usar las conexiones de la figura de la página siguiente.
Amplificación final | Amplificador no inversor. Rf = 68 kΩ entre salida y entrada inversora. Rg = 2,2 kΩ entre entrada inversora y tierra. Señal filtrada a entrada no inversora.
Entrada del ESP32 | Salida final → resistencia serie de 1 kΩ → ADC GPIO1. Zener de 3,3 V entre el nodo del ADC y tierra, con cátodo al nodo y ánodo a tierra. Masa común entre circuito y microcontrolador.

Operacionales: LM324. Microcontrolador indicado: ESP32 C3 Super Mini. La lista de materiales también debe incluir los elementos de alimentación y desacoplamiento del montaje.

El circuito de referencia incluye una resistencia y un Zener para la entrada del ADC. Esta protección no corresponde a una red snubber.

## 2 Conexiones del filtro y de los amplificadores

Filtro Sallen Key con ganancia unitaria. Dibujo de conexión de la topología estándar indicada en el trabajo. Verificar su correspondencia con la Figura 2 del original antes de cablear.

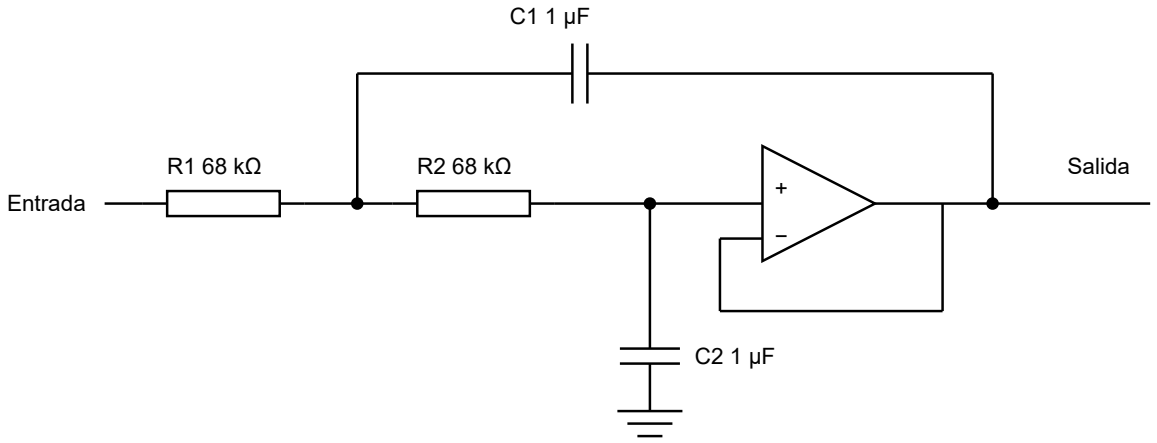
[picture p109: figure]
Entrada; Salida

Figura 1. Conexiones del filtro Sallen Key de segundo orden con seguidor de tensión.

Configuración | Conexión
Buffer | Entrada a (+). Salida unida a (−). Ganancia unitaria.
No inversor | Entrada a (+). Rf desde salida a (−). Rg desde (−) a tierra. Usar los pares de resistencias de la sección 1.
Orden de montaje | Sensor → pasaaltas → buffer → preamplificador → Sallen Key → amplificador final → protección → ADC.

Verificación del montaje: confirmar el pinout del encapsulado LM324, la polaridad de los condensadores si son electrolíticos y las tensiones de alimentación. El texto del trabajo no especifica de forma suficiente la polarización DC de la señal ni todas las conexiones del sensor. Estas deben verificarse en el esquema original; no se debe asumir que una señal bipolar puede aplicarse directamente al ADC.

Esquema original para consultar la etapa óptica: Proyecto final, Figura 1, página 3. (https://chatgpt.com/library?file_id=libfile_985a76c3387c8191ac4eef07d47284c8&account_id=personal) El acceso al enlace depende de los permisos de quien lo abre.

## 3 Cálculos de ganancias y filtros

Para las dos etapas no inversoras se utiliza A = 1 + Rf/Rg. Las siguientes ganancias corresponden al modelo ideal de cada amplificador.

Etapa | Sustitución | Resultado
Buffer | A = 1 | 1 V/V
Preamplificación | Apre = 1 + 33 / 1,8 | 19,333 V/V
Filtro con seguidor | K = 1 | 1 V/V en DC
Amplificación final | Af = 1 + 68 / 2,2 | 31,909 V/V
Producto de ganancias | Apre × Af | 616,91 V/V ≈ 55,80 dB

El trabajo redondea las ganancias a 19 y 32. El producto 616,91 corresponde a las etapas amplificadoras; la ganancia desde el sensor hasta el ADC depende además de la frecuencia por la presencia de los filtros.

## Filtro pasaaltas

### fHP = 1 / (2πRC) = 1 / (2π × 100 000 × 1 × 10⁻⁶) = 1,592 Hz

Este cálculo se añade a partir de los componentes especificados en el trabajo.

## Filtro Sallen Key

### f0 = 1 / [2π √(R1 R2 C1 C2)]

### f0 = 1 / (2π × 68 000 × 1 × 10⁻⁶) = 2,341 Hz

Precisión de diseño: 2,341 Hz es la frecuencia natural. Para la topología estándar de la Figura 1, con resistencias y condensadores iguales y K = 1, Q = 1/(3 − K) = 0,5. Por tanto, la frecuencia de −3 dB del

### pasabajas aislado es:

### f−3dB = f0 √(√2 − 1) ≈ 1,506 Hz

El trabajo llama frecuencia de corte a 2,34 Hz. Antes de reproducir esa afirmación, comprobar la respuesta del filtro en simulación. La frecuencia de −3 dB del conjunto pasaaltas y pasabajas debe obtenerse de su respuesta completa.

## Conversión de frecuencia a pulsaciones

### BPM = 60 f = 60 / T = 60 000 / Δt

ms

Ejemplo del trabajo: f = 1,31 Hz → BPM = 78,6.

## 4 Parámetros de implementación

Parámetro del código | Valor de referencia
Entrada analógica | sensorPin = 1
Umbral superior e inferior | 1,95 V y 1,83 V
Intervalos aceptados | 450 ms < Δt < 1400 ms; aproximadamente 42,9 a 133,3 BPM
Suavizado | BPM nuevo = 0,7 × BPM previo + 0,3 × BPM instantáneo
Intervalo de lectura nominal | 50 µs; 20 000 lecturas/s antes del promedio
Promedio por dato transmitido | 50 lecturas → 2,5 ms por dato → 400 datos/s nominales
Tamaño del lote | 250 datos → 0,625 s por lote nominal
Ventana de la interfaz | 2500 datos → 6,25 s a 400 datos/s

Los tiempos son nominales: analogRead, la planificación de tareas y las comunicaciones pueden modificar el intervalo real. Medirlo durante la implementación.

## Preparación de los programas

1. Crear un proyecto Arduino para la placa ESP32 C3 utilizada y colocar el código del anexo A en el archivo principal. Ajustar NOMBRE_RED, CLAVE_RED y serverName. El último debe contener la dirección IPv4 del computador que ejecuta el servidor y el puerto 5000.
2. Guardar el código del anexo B como servidor.py. En el computador instalar Flask con python -m pip install flask y ejecutar python servidor.py. Conectar computador y ESP32 a la misma red y permitir el acceso local al puerto configurado.
3. Abrir http://IP_DEL_COMPUTADOR:5000/ en el navegador. Chart.js se obtiene de una CDN y requiere acceso a Internet para cargar la gráfica.

## Ajustes que deben verificarse

La interfaz original indica 1 kHz y 500 ms/div; esos rótulos no coinciden con los 400 datos/s nominales. Ajustar la escala con el intervalo medido. El doble buffer del programa carece de un mecanismo de exclusión o cola: si el envío HTTP se retrasa, pueden sobrescribirse datos. El cálculo ADC × 3,3 / 4095 es una aproximación y debe contrastarse con una medición de voltaje.

El anexo A reproduce el código del trabajo, con credenciales sustituidas. Incluye una instrucción que deshabilita la detección de baja alimentación; revisar esa línea y las cabeceras soc para la placa y versión del entorno utilizadas. No se ha compilado ni probado en hardware. El anexo B conserva la interfaz original; se verificó su sintaxis Python.

Antes de conectar el ADC, medir su tensión y confirmar que permanece dentro del rango admitido por la placa. Ajustar ganancias, referencia DC y protección según la señal real.

## Anexo A Código del ESP32

1 #include <Arduino.h>
2 #include <WiFi.h>
3 #include <HTTPClient.h>
4 #include "soc/soc.h"
5 #include "soc/rtc_cntl_reg.h"
6
7 void conectarWiFi();
8 void TareaWiFi(void * pvParameters); 9
10 const char* ssid = "NOMBRE_RED";
11 const char* password = "CLAVE_RED";
12 const char* serverName = "http://192.168.0.100:5000/data"; 13
14 const int sensorPin = 1;
15
16 float threshold = 1.95; 17 bool beatDetected = false; 18 unsigned long lastBeat = 0; 19 int bpm = 0;
20
21
22 const unsigned long sampleInterval = 50; 23
24 unsigned long lastSampleTime = 0;
25
26 long sumaMicroLecturas = 0;
27 int contadorMicroLecturas = 0; 28
29 const int RATIO_COMPRESION = 50; 30
31
32 const int BATCH_SIZE = 250;
33
34 float bufferVoltaje[2][BATCH_SIZE]; 35
36 volatile int indexEscritura = 0;
37
38 volatile int bufferActivoEscritura = 0; 39
40 volatile int bufferListoParaEnviar = -1; 41 WiFiClient client;
42 HTTPClient http;
43
44 void conectarWiFi() {
45
46 WiFi.mode(WIFI_STA);
47
48 WiFi.begin(ssid, password);
49
50 | while (WiFi.status() != WL_CONNECTED) {
51 | vTaskDelay(pdMS_TO_TICKS(300));
52 | }
53
54 http.setReuse(true);
55 }
56
57
58 void TareaWiFi(void * pvParameters) { 59
60 conectarWiFi();
61
62 for(;;) {
63

## Anexo A Código del ESP32 continuación

64 | if (bufferListoParaEnviar != -1 &&
65 | WiFi.status() == WL_CONNECTED) {
66
67 | int bufferAEnviar = bufferListoParaEnviar;
68
69 | http.begin(client, serverName);
70
71 | http.addHeader("Content-Type", "application/json");
72
73 | String json;
74
75 | json.reserve(BATCH_SIZE * 8 + 30);
76
77 | json = "{\"v\":[";
78
79 | for(int i = 0; i < BATCH_SIZE; i++) {
80
81 | json += String(bufferVoltaje[bufferAEnviar][i], 4);
82
83 | if(i < BATCH_SIZE - 1) {
84 | json += ",";
85 | }
86 | }
87
88 | json += "],\"b\":";
89
90 | json += String(bpm);
91
92 | json += "}";
93
94 | http.POST(json);
95
96 | http.end();
97
98 | bufferListoParaEnviar = -1;
99 | }
100
101 | vTaskDelay(pdMS_TO_TICKS(10));
102 | }
103 }
104
105 void setup() {
106
107 WRITE_PERI_REG(RTC_CNTL_BROWN_OUT_REG, 0); 108
109 Serial.begin(115200);
110
111 analogReadResolution(12);
112
113 analogSetAttenuation(ADC_11db); 114
115 | xTaskCreatePinnedToCore(
116 | TareaWiFi,
117 | "TaskWiFi",
118 | 10000,
119 | NULL,
120 | 1,
121 | NULL,
122 | 0
123 | );
124 }
125
126 void loop() {

## Anexo A Código del ESP32 continuación

127
128 unsigned long currentMicros = micros();
129
130
131 if (currentMicros - lastSampleTime >= sampleInterval) { 132
133 | lastSampleTime = currentMicros;
134
135
136 | int lectura = analogRead(sensorPin);
137
138 | sumaMicroLecturas += lectura;
139
140 | contadorMicroLecturas++;
141
142
143 | if (contadorMicroLecturas >= RATIO_COMPRESION) {
144
145 | float adc = sumaMicroLecturas / (float)RATIO_COMPRESION;
146
147 | float voltaje = (adc * 3.3) / 4095.0;
148
149 | sumaMicroLecturas = 0;
150
151 | contadorMicroLecturas = 0;
152
153
154 | unsigned long currentMillis = millis();
155
156 | float thresholdHigh = threshold;
157
158 | float thresholdLow = threshold - 0.12;
159
160 | // Detectar flanco subida
161 | if (voltaje > thresholdHigh && !beatDetected) {
162
163 | beatDetected = true;
164
165 | unsigned long intervaloPulso =
166 | currentMillis - lastBeat;
167
168 | // FILTRO LATIDOS VÁLIDOS
169 | if (intervaloPulso > 450 &&
170 | intervaloPulso < 1400) {
171
172 | int bpmInstantaneo =
173 | 60000 / intervaloPulso;
174
175 | // SUAVIZADO
176 | bpm = (bpm * 0.7) +
177 | (bpmInstantaneo * 0.3);
178
179 | Serial.print("BPM: ");
180 | Serial.println(bpm);
181 | }
182
183 | lastBeat = currentMillis;
184 | }
185
186 | // Reinicio histéresis
187 | if (voltaje < thresholdLow) {
188 | beatDetected = false;
189 | }

## Anexo A Código del ESP32 continuación

190
191
192 | if (indexEscritura < BATCH_SIZE) {
193
194 | bufferVoltaje
195 | [bufferActivoEscritura]
196 | [indexEscritura] = voltaje;
197
198 | indexEscritura++;
199 | }
200
201 | if (indexEscritura >= BATCH_SIZE) {
202
203 | bufferListoParaEnviar =
204 | bufferActivoEscritura;
205
206 | // Cambiar buffer
207 | bufferActivoEscritura =
208 | (bufferActivoEscritura == 0) ? 1 : 0;
209
210 | indexEscritura = 0;
211 | }
212 | }
213 | }
214 }

## Anexo B Código del servidor y la interfaz

1 from flask import Flask, request, jsonify
2 from collections import deque
3
4 app = Flask(__name__)
5
6 # 2500 datos = 2.5 segundos exactos a 1kHz 7 MAX_DATOS = 2500
8 voltajes = deque(maxlen=MAX_DATOS)
9 ultimo_bpm = 0
10
11 HTML = """
12 <!DOCTYPE html>
13 <html>
14 <head>
15 <title>Osciloscopio ESP32 - 1 kHz</title>
16 <script src="https://cdn.jsdelivr.net/npm/chart.js"></script> 17
18 <style>
19 body{
20 | background:#101010;
21 | color:white;
22 | font-family:Arial;
23 | text-align:center;
24 | margin:0;
25 }
26
27 .container{
28 | width:950px;
29 | margin:auto;
30 | margin-top:20px;
31 }
32
33 .top{
34 | display:flex;
35 | justify-content:center;
36 | gap:20px;
37 | margin-bottom:20px;
38 }
39
40 .box{
41 | width:180px;
42 | background:#1e1e1e;
43 | padding:15px;
44 | border-radius:15px;
45 | transition:0.3s;
46 }
47
48 .valor{
49 | font-size:40px;
50 | margin-top:10px;
51 | font-weight:bold;
52 }
53
54 canvas{
55 | background:black;
56 | border-radius:10px;
57 | border: 2px solid #333;
58 }
59 </style>
60 </head>
61
62 <body>
63

## Anexo B Código del servidor y la interfaz continuación

64 <div class="container">
<h1>Osciloscopio ESP32 (500ms / div)</h1>

<div class="top">

<div class="box" id="bpm_box"> <div>BPM</div>
<div class="valor" id="bpm">0</div> </div>

<div class="box">
<div>Voltaje</div>
<div class="valor" id="voltaje">0</div> </div>

</div>

<canvas id="chart" width="950" height="350"></canvas> 82 </div>

84 <script>

86 const MAX_DATOS = 2500;

88 let labels_grid = [];
89 for(let i=0; i<MAX_DATOS; i++){ labels_grid.push(i);
91 }

93 const ctx = document.getElementById('chart');

95 const chart = new Chart(ctx, {
type:'line',
data:{
labels: labels_grid,
datasets:[{
data: new Array(MAX_DATOS).fill(null), borderWidth: 1.5,
pointRadius: 0,
tension: 0,
borderColor: '#00ff00',
spanGaps: true
}]
},
options:{
responsive:false,
animation:false,
plugins:{
legend:{ display:false }
},
scales:{
x:{
display:true,
title:{
display:true,
text:'Tiempo (500ms / div)' },
grid:{
color:'rgba(255,255,255,0.2)'
},
ticks:{
callback: function(value, index){
return index % 500 === 0 ? '' : null;

## Anexo B Código del servidor y la interfaz continuación

},
maxRotation:0
}
},
y:{
min:0.0,
max:3.0,
grid:{
color:'rgba(255,255,255,0.2)' },
title:{
display:true,
text:'Voltaje'
}
}
}
}
144 });

146 async function actualizar(){

try{

const response = await fetch('/get_data'); const data = await response.json();

const bpm = data.bpm;

document.getElementById("bpm").innerHTML = bpm;

// CAMBIO DE COLOR SEGÚN BPM
const bpmBox = document.getElementById("bpm_box");

if(bpm >= 60 && bpm <= 69){ bpmBox.style.background = "#00aa00"; // VERDE }
else if(bpm >= 70 && bpm <= 85){ bpmBox.style.background = "#d4b000"; // AMARILLO }
else if(bpm >= 86){
bpmBox.style.background = "#cc0000"; // ROJO
}
else{
bpmBox.style.background = "#1e1e1e"; // NORMAL }

if(data.valores.length > 0){ document.getElementById("voltaje").innerHTML = data.valores[data.valores.length - 1].toFixed(2); }

let valores_grafica = [...data.valores];

while(valores_grafica.length < MAX_DATOS){ valores_grafica.unshift(null);
}

chart.data.datasets[0].data = valores_grafica;

chart.update('none');

}
catch(e){

## Anexo B Código del servidor y la interfaz continuación

190 | console.log("Error:", e);
191 | }
192 | finally{
193 | setTimeout(actualizar, 40);
194 | }
195 }
196
197 actualizar();
198
199 </script>
200
201 </body>
202 </html>
203 """
204
205 @app.route('/')
206 def home():
207 | return HTML
208
209 @app.route('/data', methods=['POST']) 210 def data():
211 | global ultimo_bpm
212
213 | contenido = request.json
214
215 | for v in contenido["v"]:
216 | voltajes.append(v)
217
218 | ultimo_bpm = contenido["b"]
219
220 | return jsonify({"ok":True})
221
222 @app.route('/get_data')
223 def get_data():
224 | return jsonify({
225 | "valores": list(voltajes),
226 | "bpm": ultimo_bpm
227 | })
228
229 if __name__ == '__main__':
230 | app.run(host='0.0.0.0', port=5000, threaded=True)
