hectorhiguita/circuitos2_proyectofinal/desarrollo/02_pcb/img/pcb_3d_superior.png

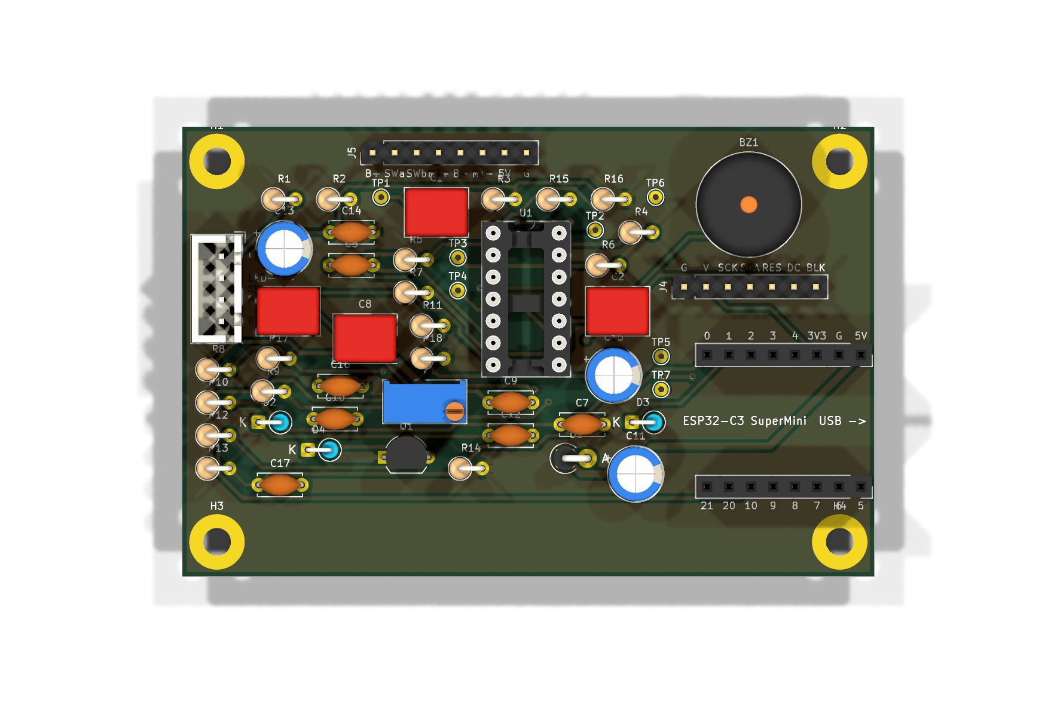
desarrollo/02_pcb/img/pcb_3d_superior.png
