hectorhiguita/circuitos2_proyectofinal/desarrollo/02_pcb/perforada/vista_soldadura.png

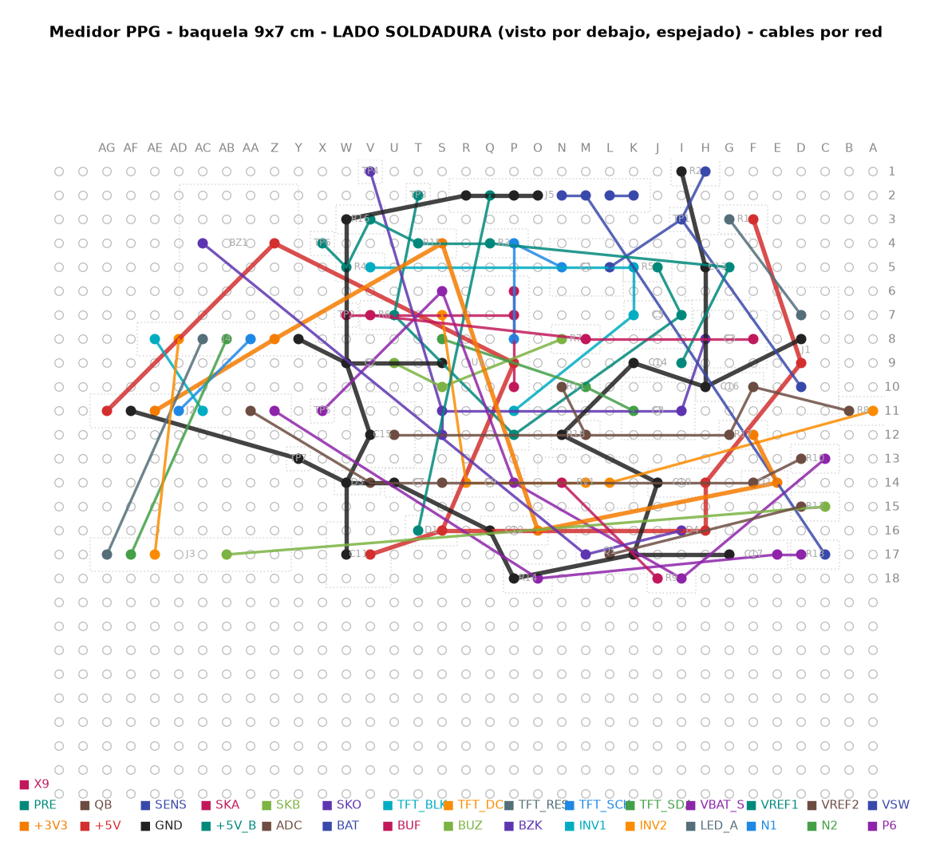
desarrollo/02_pcb/perforada/vista_soldadura.png
