hectorhiguita/circuitos2_proyectofinal/desarrollo/05_carcasa/img/base_arriba.png

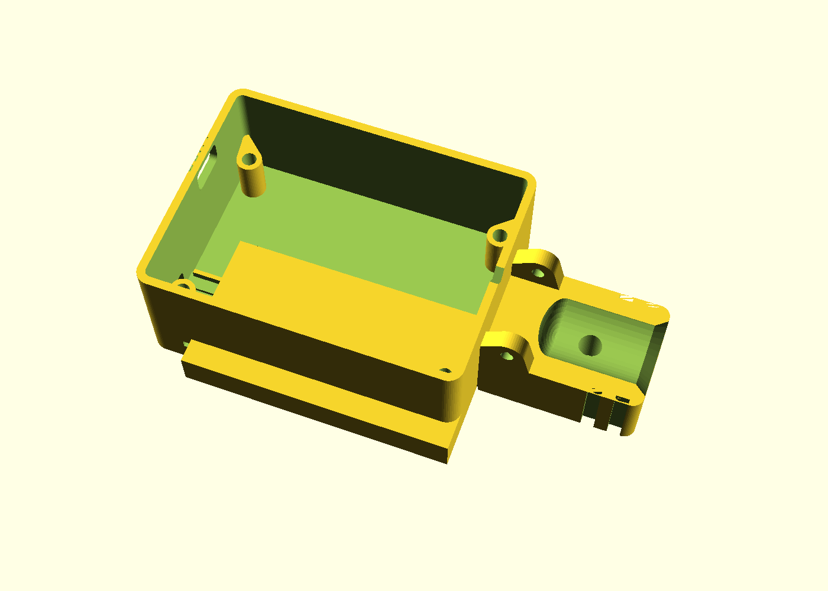
desarrollo/05_carcasa/img/base_arriba.png
