hectorhiguita/circuitos2_proyectofinal/desarrollo/05_carcasa/img/open.png

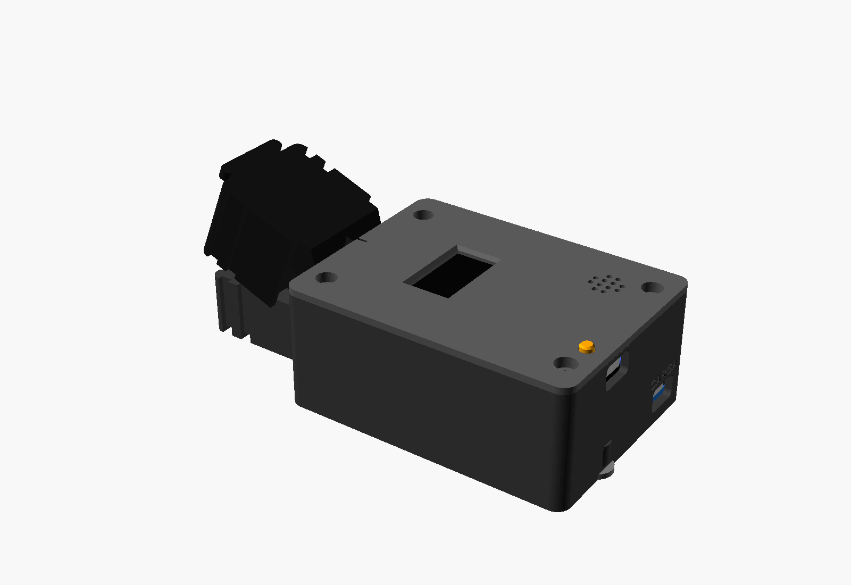
desarrollo/05_carcasa/img/open.png
