hectorhiguita/circuitos2_proyectofinal/desarrollo/05_carcasa/img/planta.png

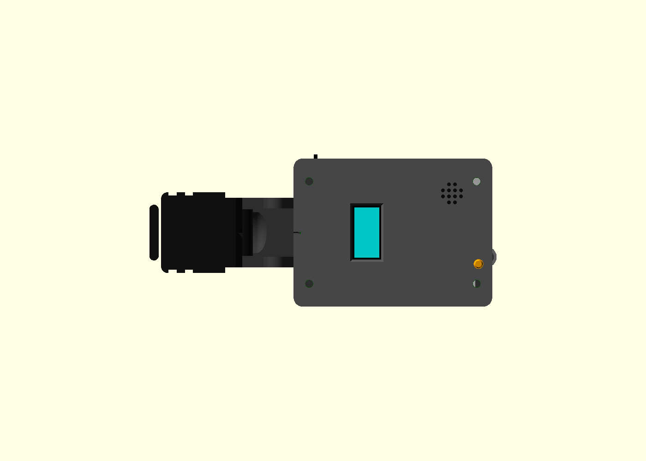
desarrollo/05_carcasa/img/planta.png
