hectorhiguita/circuitos2_proyectofinal/desarrollo/02_pcb/fab/medidor_ppg_BOM.csv

Ref | Valor | Huella | Cant
BZ1 | Buzzer 5V | Buzzer_Beeper:Buzzer_12x9.5RM7.6 | 1
C1,C3,C8 | 1uF film | Capacitor_THT:C_Rect_L7.2mm_W5.5mm_P5.00mm_FKS2_FKP2_MKS2_MKP2 | 3
C2 | 470nF film | Capacitor_THT:C_Rect_L7.2mm_W5.5mm_P5.00mm_FKS2_FKP2_MKS2_MKP2 | 1
C5 | 47nF | Capacitor_THT:C_Disc_D5.0mm_W2.5mm_P5.00mm | 1
C7,C10,C12,C14,C16,C17 | 100nF | Capacitor_THT:C_Disc_D5.0mm_W2.5mm_P5.00mm | 6
C9 | 10nF | Capacitor_THT:C_Disc_D5.0mm_W2.5mm_P5.00mm | 1
C11,C13,C15 | 100uF | Capacitor_THT:CP_Radial_D6.3mm_P2.50mm | 3
D1 | 1N5819 | Diode_THT:D_DO-41_SOD81_P2.54mm_Vertical_AnodeUp | 1
D2,D3 | BAT85 | Diode_THT:D_DO-35_SOD27_P2.54mm_Vertical_CathodeUp | 2
D4 | 1N4148 | Diode_THT:D_DO-35_SOD27_P2.54mm_Vertical_CathodeUp | 1
J1 | SENSOR | Connector_JST:JST_XH_B4B-XH-A_1x04_P2.50mm_Vertical | 1
J2 | C3_5V-IO0 | Connector_PinSocket_2.54mm:PinSocket_1x08_P2.54mm_Vertical | 1
J3 | C3_IO5-IO21 | Connector_PinSocket_2.54mm:PinSocket_1x08_P2.54mm_Vertical | 1
J4 | TFT 1.3 ST7789 | Connector_PinHeader_2.54mm:PinHeader_1x07_P2.54mm_Vertical | 1
J5 | ENERGIA | Connector_PinHeader_2.54mm:PinHeader_1x08_P2.54mm_Vertical | 1
Q1 | 2N3904 | Package_TO_SOT_THT:TO-92_Inline_Wide | 1
R1 | 220 | Resistor_THT:R_Axial_DIN0207_L6.3mm_D2.5mm_P2.54mm_Vertical | 1
R2,R6,R7 | 47k | Resistor_THT:R_Axial_DIN0207_L6.3mm_D2.5mm_P2.54mm_Vertical | 3
R3,R11 | 470k | Resistor_THT:R_Axial_DIN0207_L6.3mm_D2.5mm_P2.54mm_Vertical | 2
R4,R8,R9 | 10k | Resistor_THT:R_Axial_DIN0207_L6.3mm_D2.5mm_P2.54mm_Vertical | 3
R5 | 300k | Resistor_THT:R_Axial_DIN0207_L6.3mm_D2.5mm_P2.54mm_Vertical | 1
R10 | 4.7k | Resistor_THT:R_Axial_DIN0207_L6.3mm_D2.5mm_P2.54mm_Vertical | 1
R12 | 1k | Resistor_THT:R_Axial_DIN0207_L6.3mm_D2.5mm_P2.54mm_Vertical | 1
R13,R14 | 100k | Resistor_THT:R_Axial_DIN0207_L6.3mm_D2.5mm_P2.54mm_Vertical | 2
R15,R17 | 3.3k | Resistor_THT:R_Axial_DIN0207_L6.3mm_D2.5mm_P2.54mm_Vertical | 2
R16,R18 | 2.2k | Resistor_THT:R_Axial_DIN0207_L6.3mm_D2.5mm_P2.54mm_Vertical | 2
RV1 | 200k | Potentiometer_THT:Potentiometer_Bourns_3296W_Vertical | 1
U1 | LM324N | Package_DIP:DIP-14_W7.62mm_Socket | 1
