hectorhiguita/circuitos2_proyectofinal/desarrollo/02_pcb/perforada/vista_componentes.png

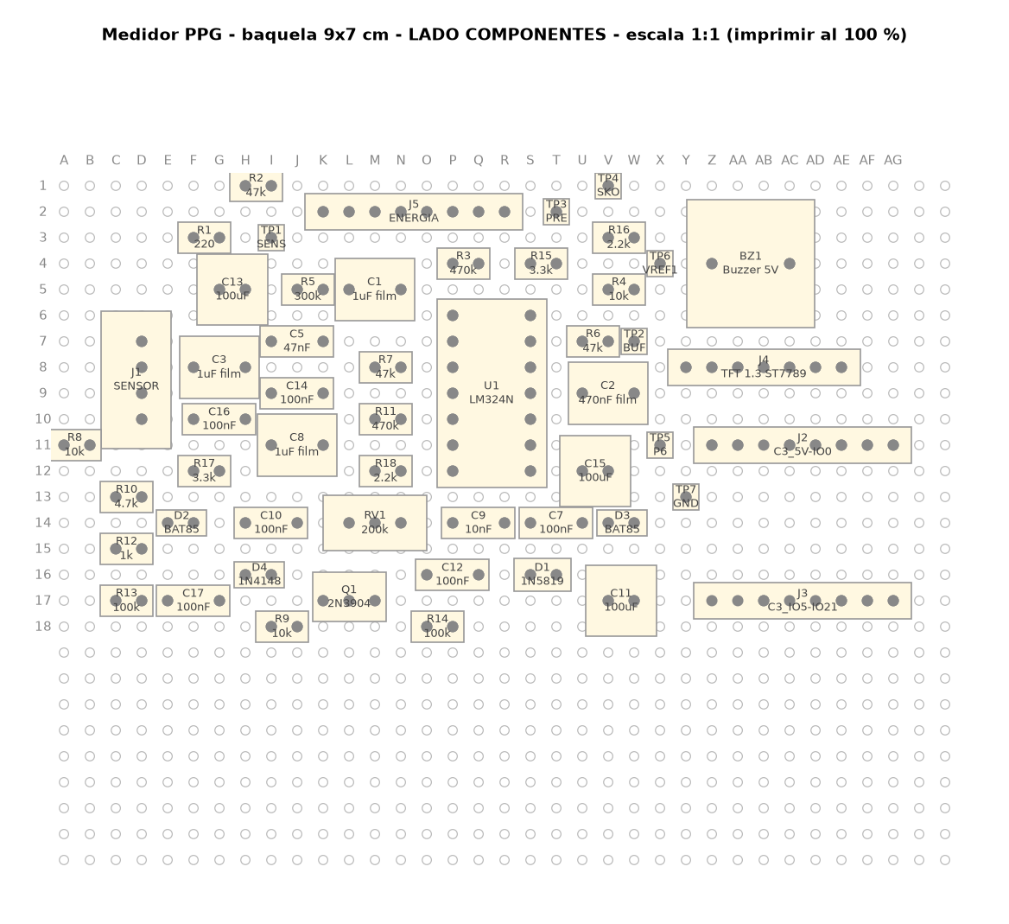
desarrollo/02_pcb/perforada/vista_componentes.png
