hectorhiguita/circuitos2_proyectofinal/desarrollo/02_pcb/fab/medidor_ppg.step

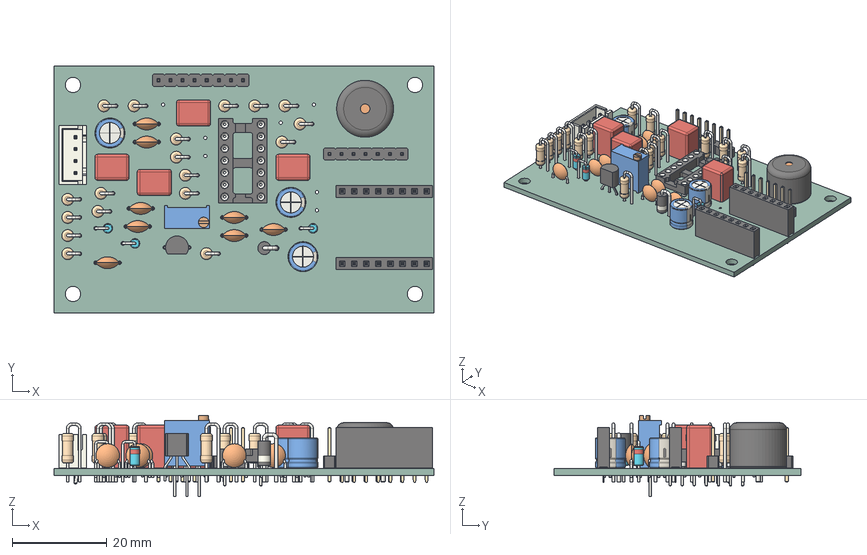
[picture p117: CAD file, 2026-11-10]
desarrollo/02_pcb/fab/medidor_ppg.step
80.0 x 52.0 x 17.1 mm
C_Rect_L72mm_W55mm_P500mm_FKS2_FKP2_MKS2_MKP2 x 4
DIP_14_W762mm_Socket
CP_Radial_D63mm_P250mm x 3
R_Axial_DIN0207_L63mm_D25mm_P254mm_Vertical x 18
C_Disc_D50mm_W25mm_P500mm x 8
Potentiometer_Bourns_3296W_Vertical
PinHeader_1x08_P254mm_Vertical
Buzzer_12x95RM76
D_DO-35_SOD27_P2.54mm_Vertical_KathodeUp x 3
JST_B4B_XH_A
D_DO-41_SOD81_P2.54mm_Vertical_AnodeUp
PinSocket_1x08_P2.54mm_Vertical x 2
PinHeader_1x07_P254mm_Vertical
TO-92_Inline_Wide
medidor_ppg_PCB
