hectorhiguita/circuitos2_proyectofinal/desarrollo/05_carcasa/stl/boton.stl

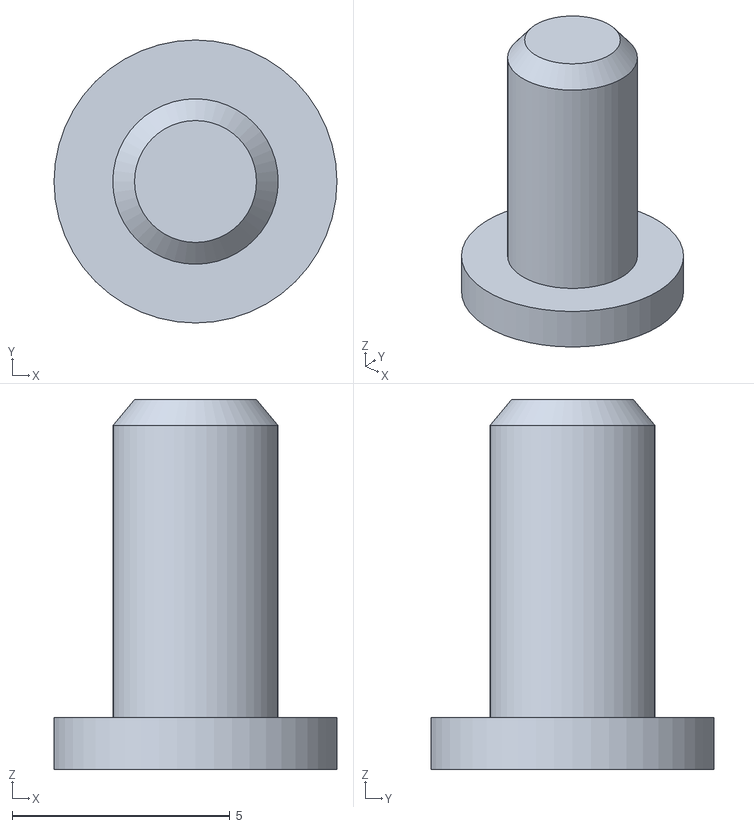
[picture p118: CAD file, 2026-11-10]
desarrollo/05_carcasa/stl/boton.stl
6.50 x 6.50 x 8.50
