hectorhiguita/circuitos2_proyectofinal/desarrollo/05_carcasa/stl/base.stl

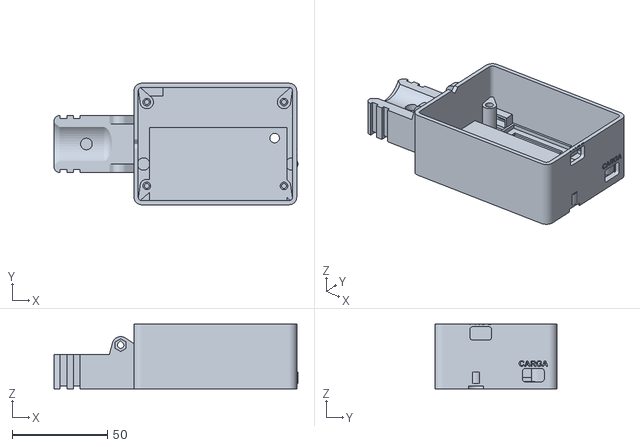
[picture p119: CAD file, 2026-11-10]
desarrollo/05_carcasa/stl/base.stl
128.1 x 63.8 x 34.1
