hectorhiguita/circuitos2_proyectofinal/desarrollo/05_carcasa/stl/tapa.stl

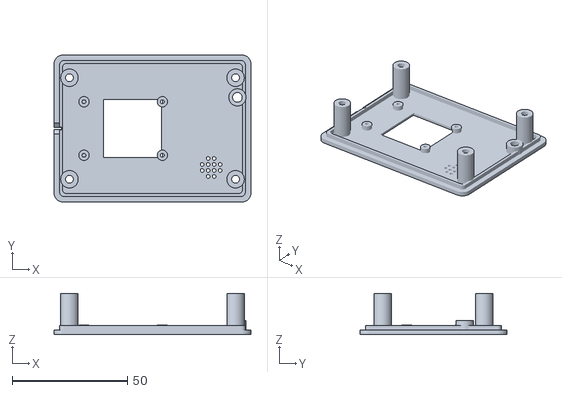
[picture p120: CAD file, 2026-11-10]
desarrollo/05_carcasa/stl/tapa.stl
85.4 x 63.8 x 17.8
