hectorhiguita/circuitos2_proyectofinal/desarrollo/05_carcasa/stl/mandibula.stl

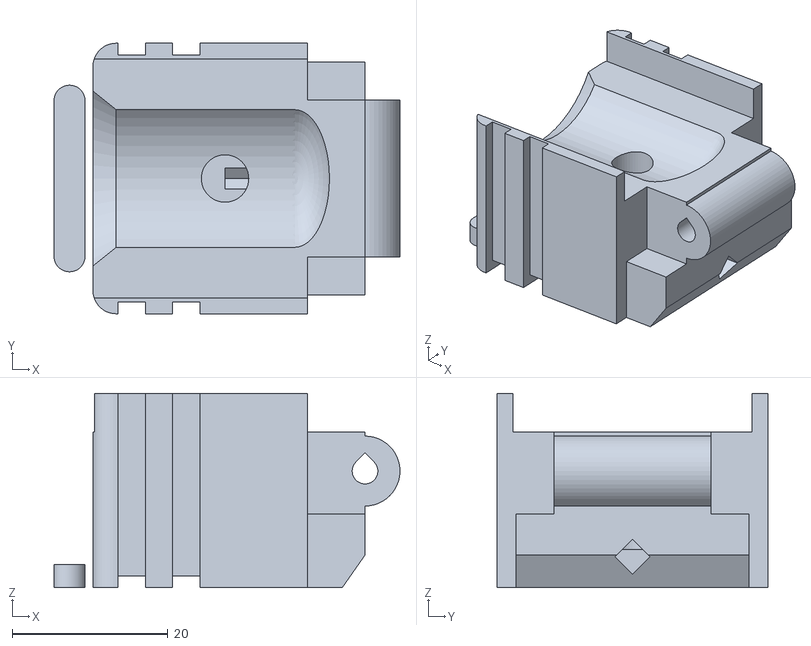
[picture p121: CAD file, 2026-11-10]
desarrollo/05_carcasa/stl/mandibula.stl
44.5 x 34.8 x 25.0
