hectorhiguita/circuitos2_proyectofinal/desarrollo/05_carcasa/stl/puerta.stl

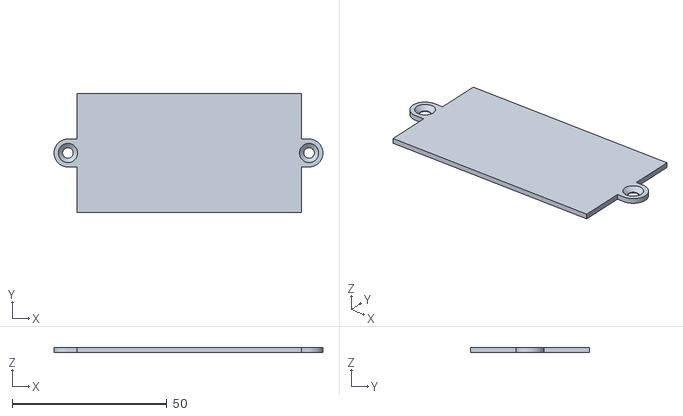
[picture p122: CAD file, 2026-11-10]
desarrollo/05_carcasa/stl/puerta.stl
86.8 x 38.4 x 1.60
