hectorhiguita/circuitos2_proyectofinal/desarrollo/05_carcasa/img/assembly.png

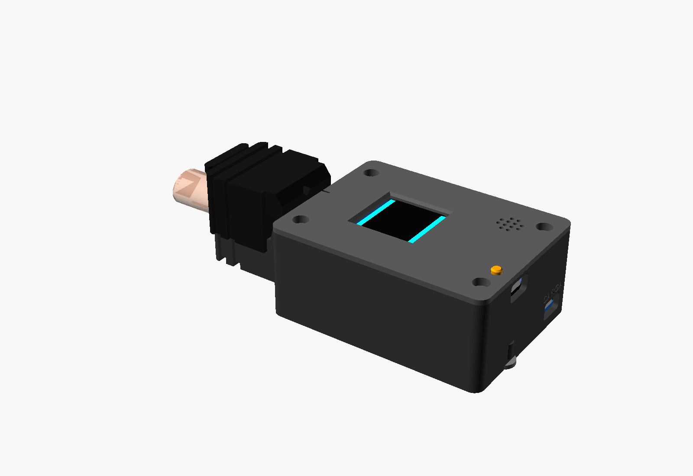
desarrollo/05_carcasa/img/assembly.png
