hectorhiguita/circuitos2_proyectofinal/desarrollo/01_analogico/resultados/punto6_detalle.png

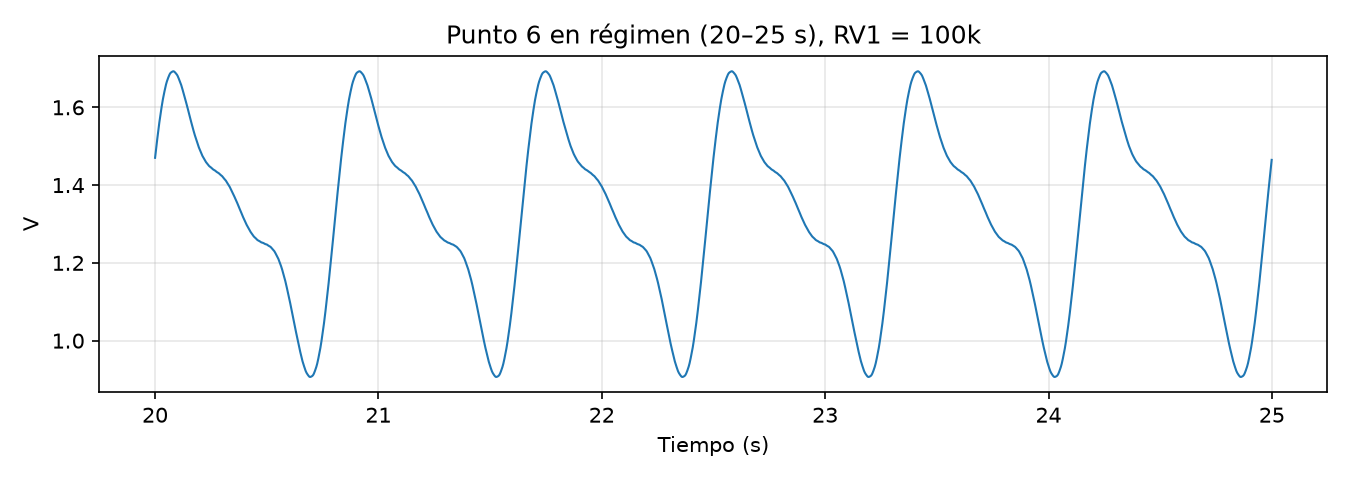
desarrollo/01_analogico/resultados/punto6_detalle.png
