hectorhiguita/circuitos2_proyectofinal/desarrollo/02_pcb/fab/medidor_ppg_esquema.pdf

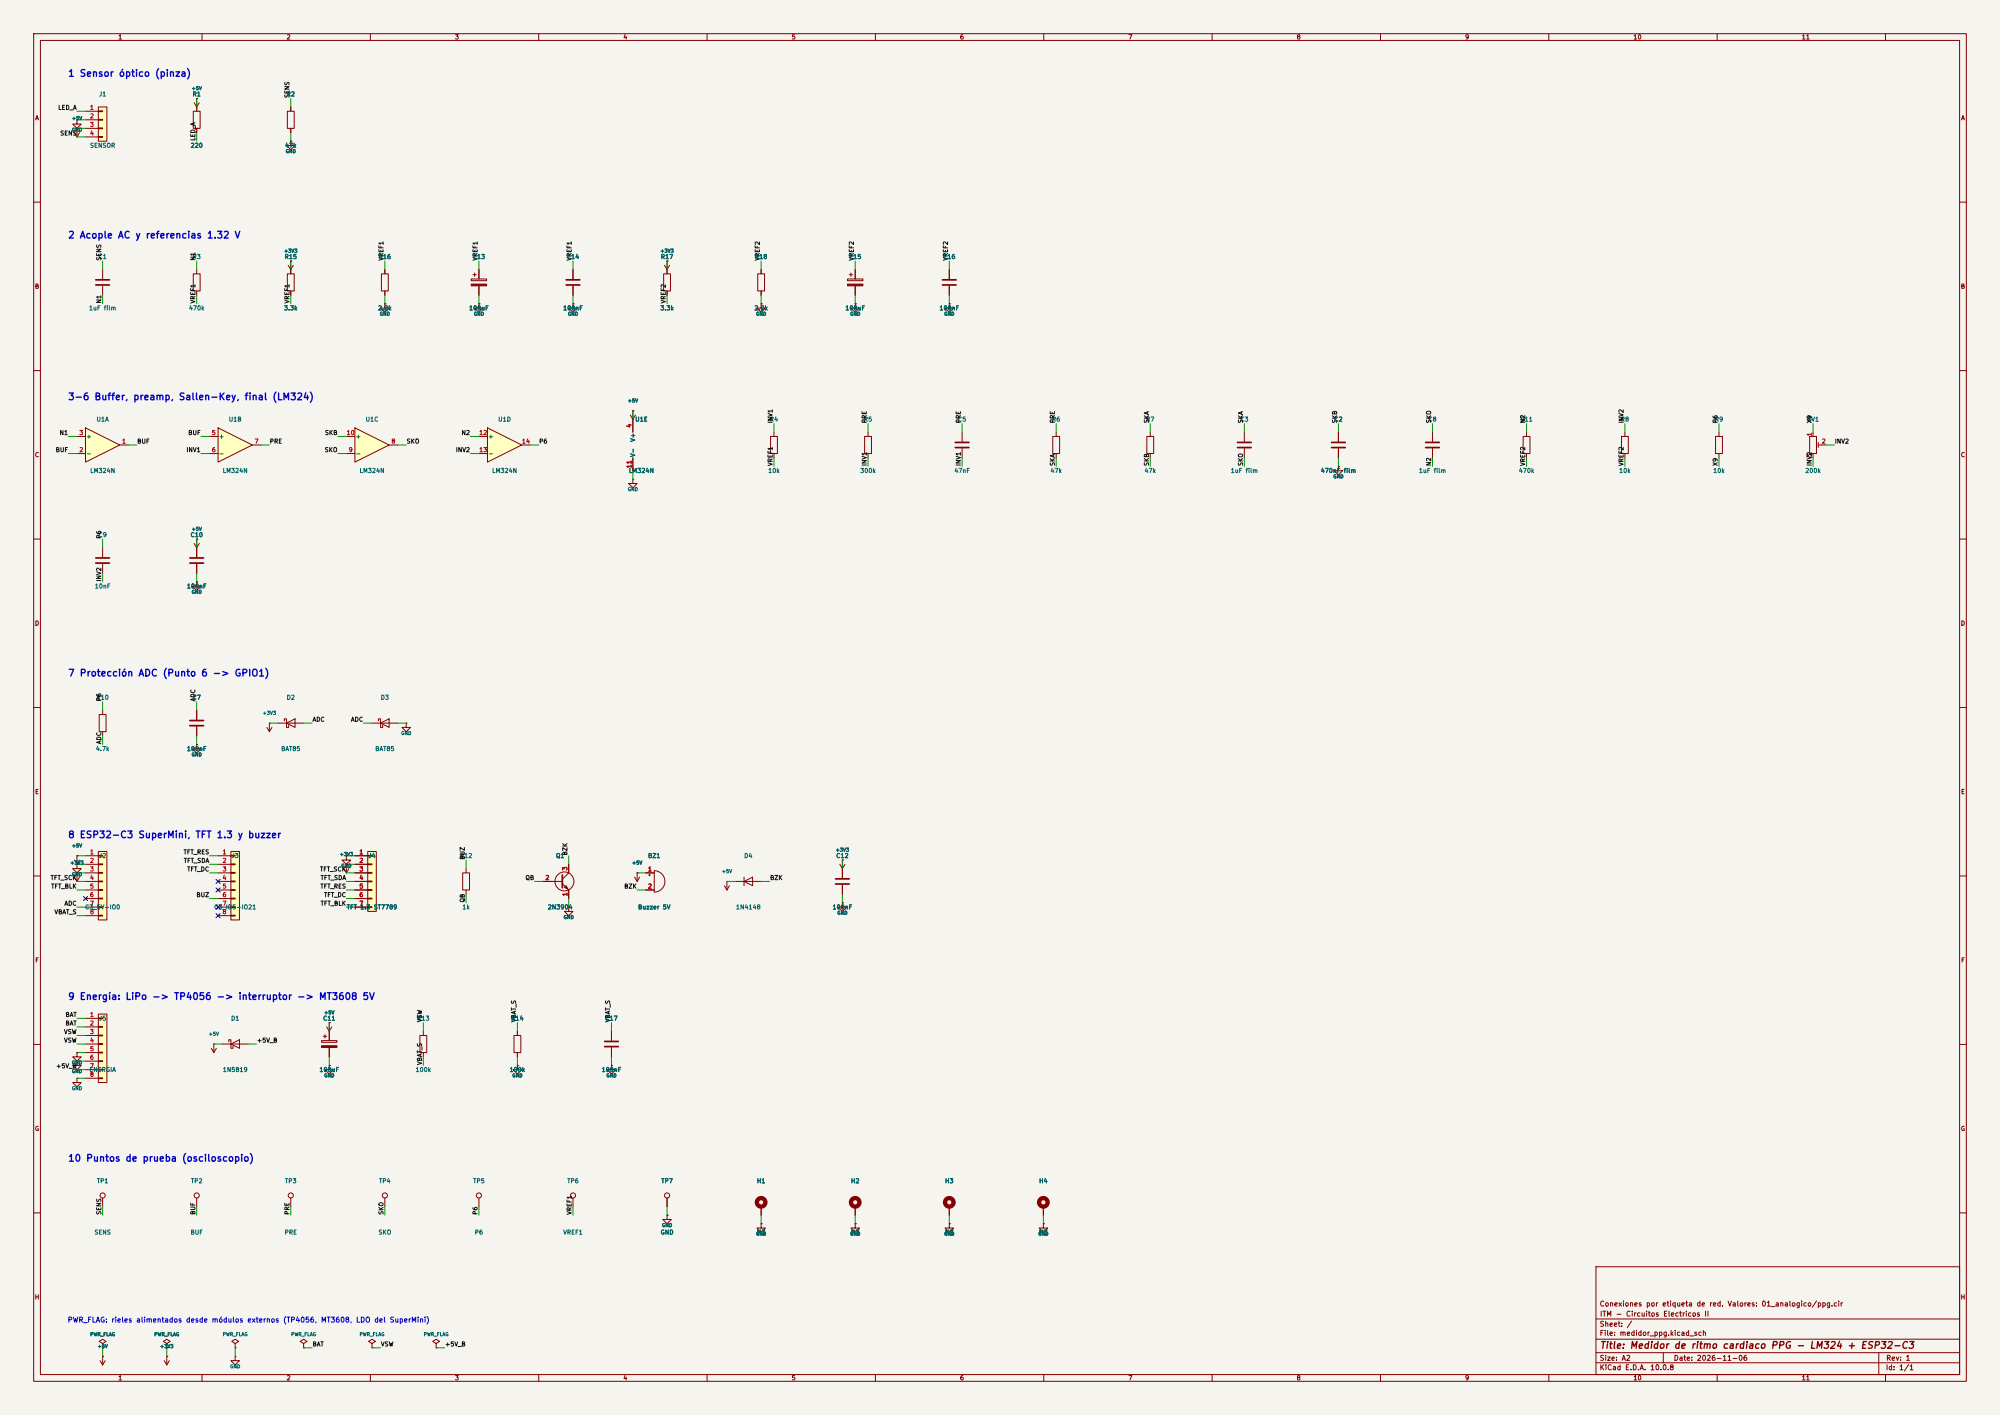
[picture p125: page 1]

3-6 Buffer, preamp, Sallen-Key, final (LM324)

10 Puntos de prueba (osciloscopio)

Conexiones por etiqueta de red. Valores: 01_analogico/ppg.cir TP6

PWR_FLAG: rieles alimentados desde módulos externos (TP4056, MT3608, LDO del SuperMini)

ITM - Circuitos Electricos II
Sheet: /
File: medidor_ppg.kicad_sch
Title: Medidor de ritmo cardiaco PPG - LM324 + ESP32-C3

Size: A2 | Rev: 1
KiCad E.D.A. 10.0.8 | Id: 1/1
