hectorhiguita/circuitos2_proyectofinal/desarrollo/02_pcb/perforada/vista_soldadura.pdf

Medidor PPG - baquela 9x7 cm - LADO SOLDADURA (visto por debajo, espejado) - cables por red

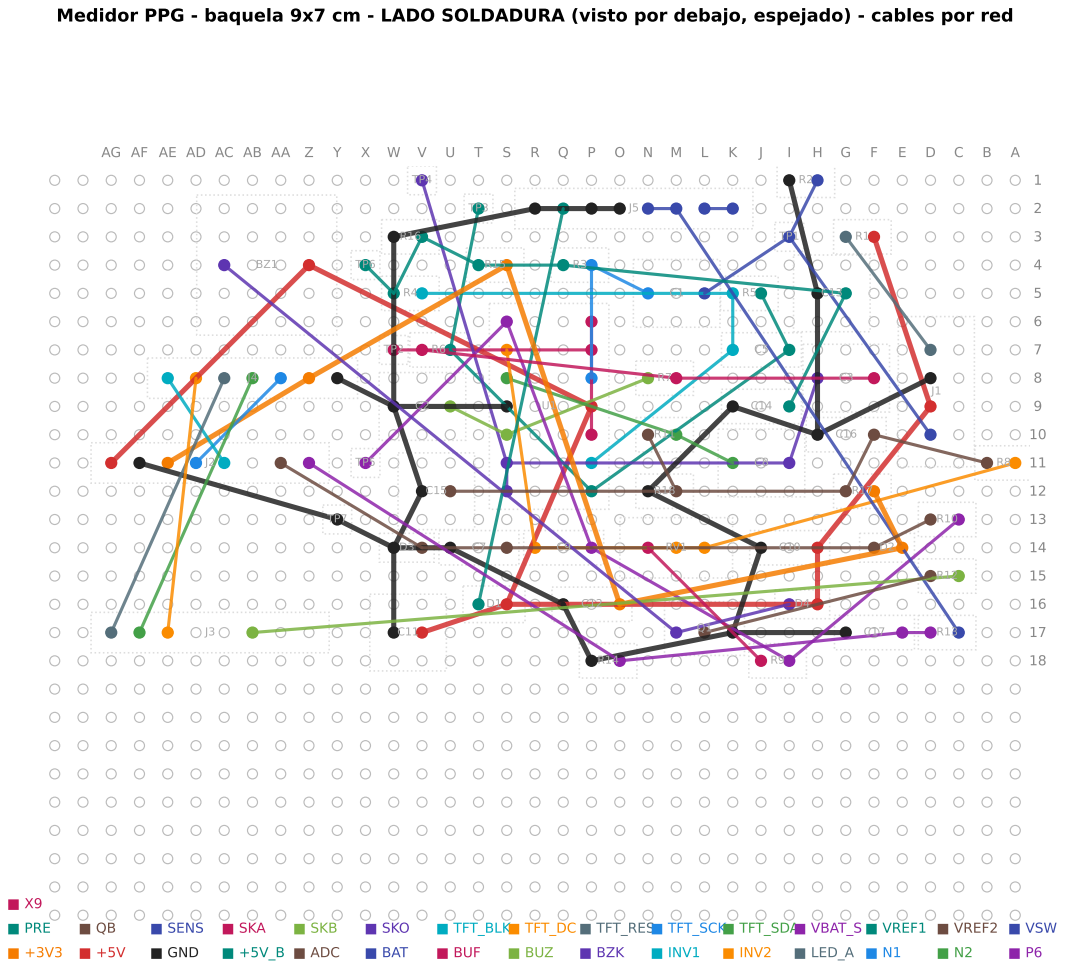
[picture p126: page 1]
