hectorhiguita/circuitos2_proyectofinal/desarrollo/02_pcb/fab/medidor_ppg_montaje_superior.pdf

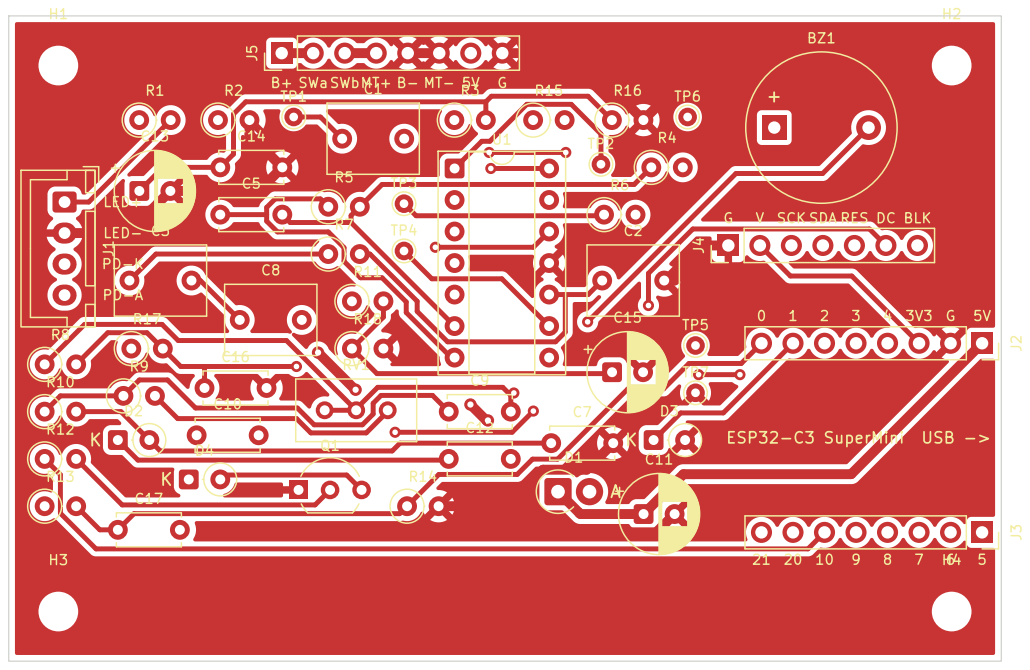
[picture p127: page 1]
