hectorhiguita/circuitos2_proyectofinal/desarrollo/02_pcb/perforada/vista_componentes.pdf

### Medidor PPG - baquela 9x7 cm - LADO COMPONENTES - escala 1:1 (imprimir al 100 %)

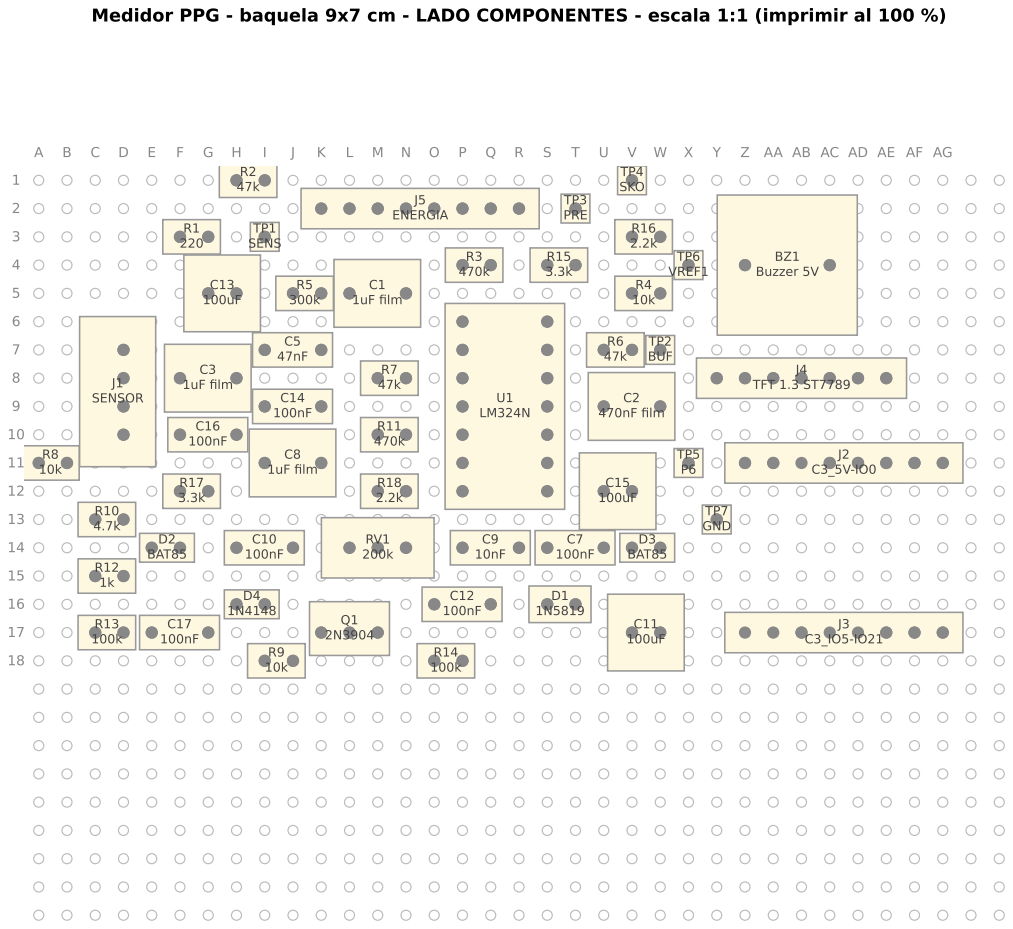
[picture p128: page 1]
