hectorhiguita/circuitos2_proyectofinal/(list of files, drawings)

Other design files:
desarrollo/02_pcb/medidor_ppg.dsn
