hectorhiguita/circuitos2_proyectofinal/desarrollo/02_pcb/medidor_ppg.kicad_pcb

## KiCad design desarrollo/02_pcb/medidor_ppg.kicad_pcb (2026-11-10)

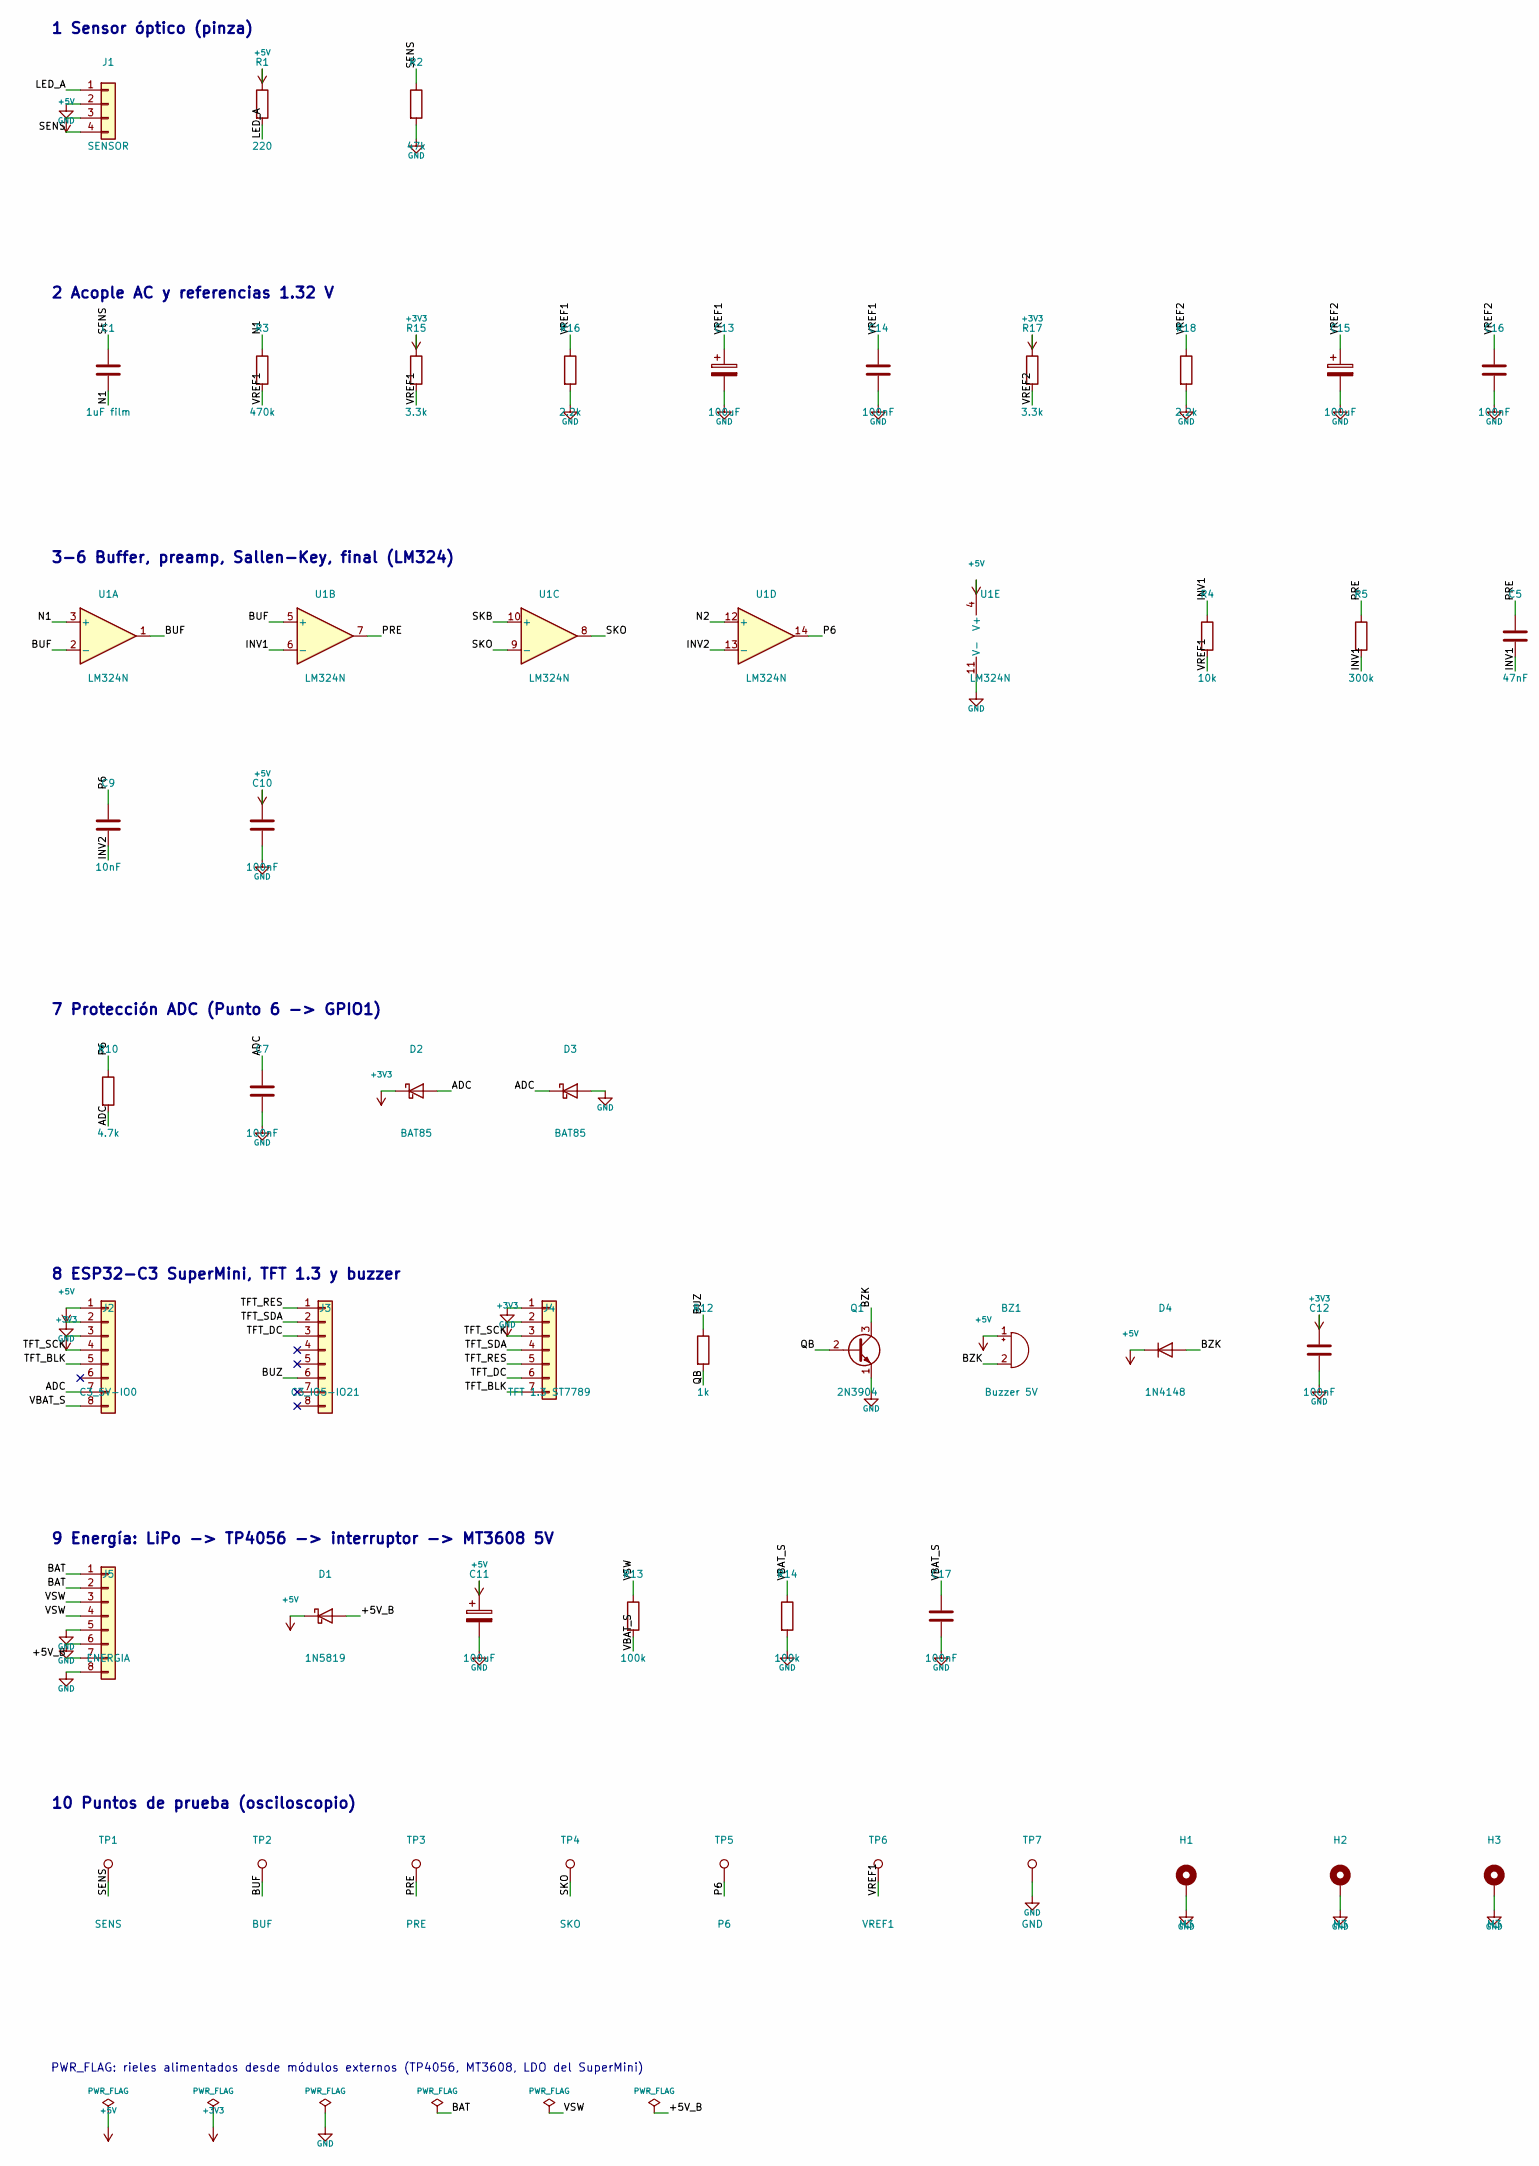
[picture p129: schematic medidor_ppg.kicad_sch, Medidor de ritmo cardiaco PPG - LM324 + ESP32-C3, part in row 1, column 1]

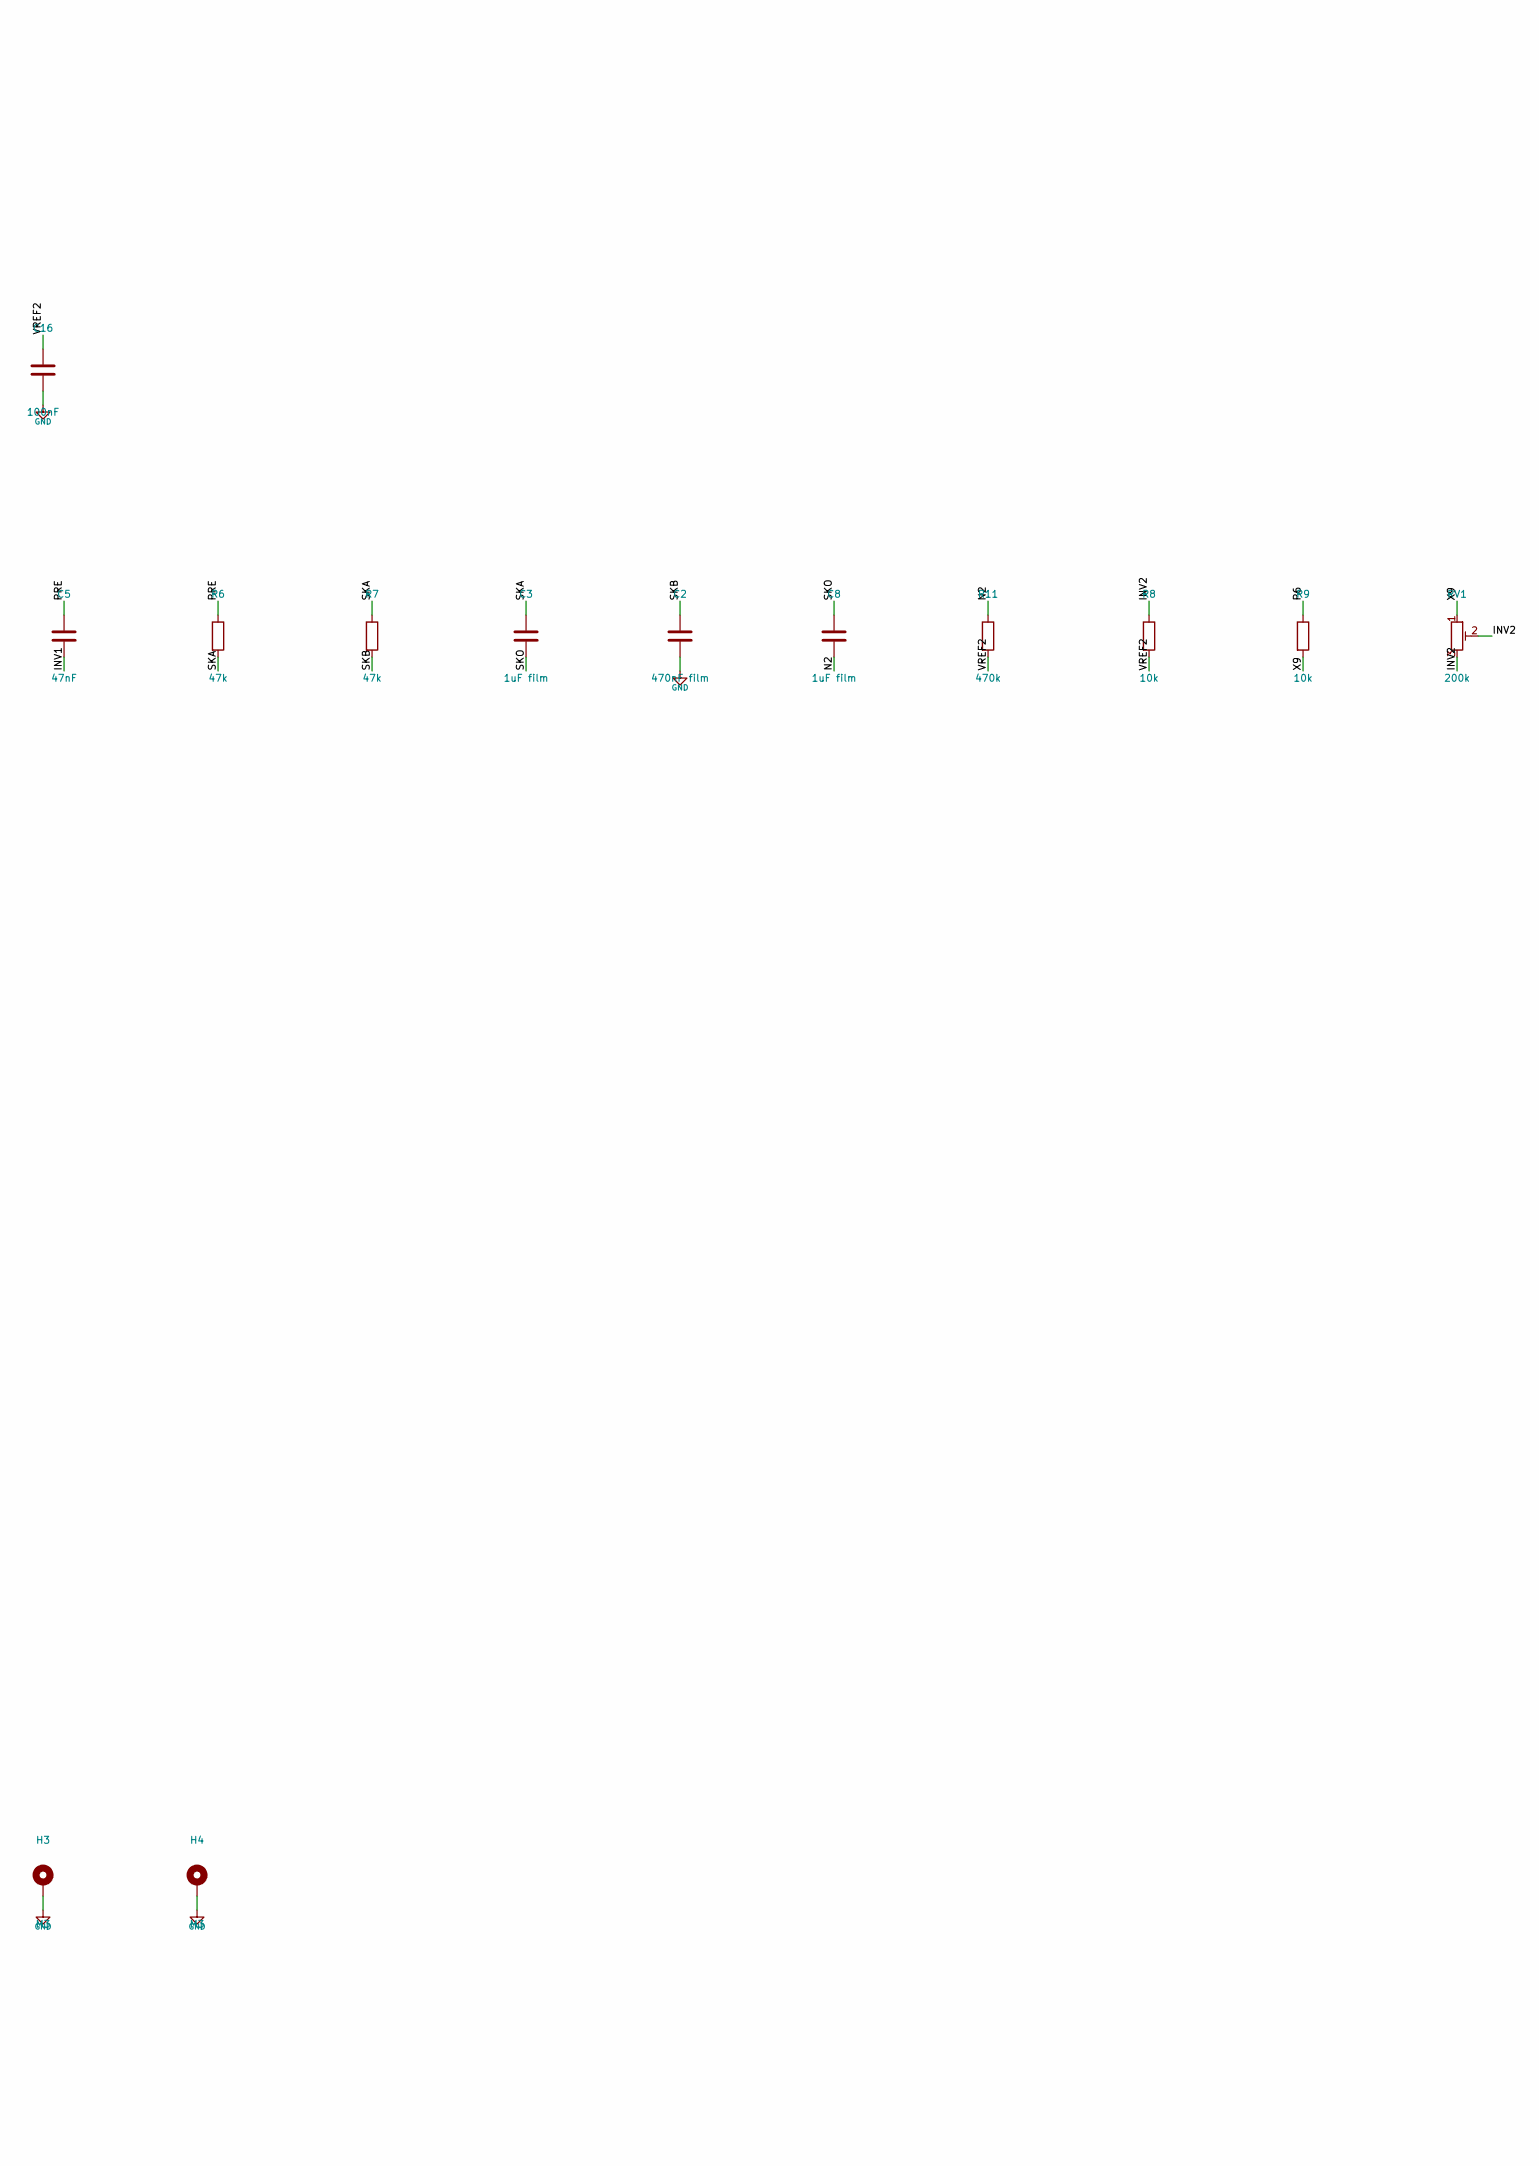
[picture p130: schematic medidor_ppg.kicad_sch, Medidor de ritmo cardiaco PPG - LM324 + ESP32-C3, part in row 1, column 2]

Parts:
BZ1: Buzzer 5V; Buzzer_12x9.5RM7.6
C1, C3, C8: 1uF film; C_Rect_L7.2mm_W5.5mm_P5.00mm_FKS2_FKP2_MKS2_MKP2
C2: 470nF film; C_Rect_L7.2mm_W5.5mm_P5.00mm_FKS2_FKP2_MKS2_MKP2
C5: 47nF; C_Disc_D5.0mm_W2.5mm_P5.00mm
C7, C10, C12, C14, C16, C17: 100nF; C_Disc_D5.0mm_W2.5mm_P5.00mm
C9: 10nF; C_Disc_D5.0mm_W2.5mm_P5.00mm
C11, C13, C15: 100uF; CP_Radial_D6.3mm_P2.50mm
D1: 1N5819; D_DO-41_SOD81_P2.54mm_Vertical_AnodeUp
D2, D3: BAT85; D_DO-35_SOD27_P2.54mm_Vertical_CathodeUp
D4: 1N4148; D_DO-35_SOD27_P2.54mm_Vertical_CathodeUp
H1, H2, H3, H4: M3; MountingHole_3.2mm_M3_Pad
J1: SENSOR; JST_XH_B4B-XH-A_1x04_P2.50mm_Vertical
J2: C3_5V-IO0; PinSocket_1x08_P2.54mm_Vertical
J3: C3_IO5-IO21; PinSocket_1x08_P2.54mm_Vertical
J4: TFT 1.3 ST7789; PinHeader_1x07_P2.54mm_Vertical
J5: ENERGIA; PinHeader_1x08_P2.54mm_Vertical
Q1: 2N3904; TO-92_Inline_Wide
R1: 220; R_Axial_DIN0207_L6.3mm_D2.5mm_P2.54mm_Vertical
R2, R6, R7: 47k; R_Axial_DIN0207_L6.3mm_D2.5mm_P2.54mm_Vertical
R3, R11: 470k; R_Axial_DIN0207_L6.3mm_D2.5mm_P2.54mm_Vertical
R4, R8, R9: 10k; R_Axial_DIN0207_L6.3mm_D2.5mm_P2.54mm_Vertical
R5: 300k; R_Axial_DIN0207_L6.3mm_D2.5mm_P2.54mm_Vertical
R10: 4.7k; R_Axial_DIN0207_L6.3mm_D2.5mm_P2.54mm_Vertical
R12: 1k; R_Axial_DIN0207_L6.3mm_D2.5mm_P2.54mm_Vertical
R13, R14: 100k; R_Axial_DIN0207_L6.3mm_D2.5mm_P2.54mm_Vertical
R15, R17: 3.3k; R_Axial_DIN0207_L6.3mm_D2.5mm_P2.54mm_Vertical
R16, R18: 2.2k; R_Axial_DIN0207_L6.3mm_D2.5mm_P2.54mm_Vertical
RV1: 200k; Potentiometer_Bourns_3296W_Vertical
TP1: SENS; TestPoint_THTPad_D1.5mm_Drill0.7mm
TP2: BUF; TestPoint_THTPad_D1.5mm_Drill0.7mm
TP3: PRE; TestPoint_THTPad_D1.5mm_Drill0.7mm
TP4: SKO; TestPoint_THTPad_D1.5mm_Drill0.7mm
TP5: P6; TestPoint_THTPad_D1.5mm_Drill0.7mm
TP6: VREF1; TestPoint_THTPad_D1.5mm_Drill0.7mm
TP7: GND; TestPoint_THTPad_D1.5mm_Drill0.7mm
U1: LM324N; DIP-14_W7.62mm_Socket

Connections:
+3V3: C12.1, D2.1 (K), J2.3, J4.2, R15.1, R17.1
+5V: BZ1.1 (+), C10.1, C11.1, D1.1 (K), D4.1 (K), J1.3, J2.1, R1.1, U1.4 (V+)
/+5V_B: D1.2 (A), J5.7
/ADC: C7.1, D2.2 (A), D3.1 (K), J2.7, R10.2
/BAT: J5.1, J5.2
/BUF: TP2.1, U1.1, U1.2 (-), U1.5 (+)
/BUZ: J3.6, R12.1
/BZK: BZ1.2 (-), D4.2 (A), Q1.3 (C)
/INV1: C5.2, R4.1, R5.2, U1.6 (-)
/INV2: C9.2, R8.1, RV1.2, RV1.3, U1.13 (-)
/LED_A: J1.1, R1.2
/N1: C1.2, R3.1, U1.3 (+)
/N2: C8.2, R11.1, U1.12 (+)
/P6: C9.1, R9.1, R10.1, TP5.1, U1.14
/PRE: C5.1, R5.1, R6.1, TP3.1, U1.7
/QB: Q1.2 (B), R12.2
/SENS: C1.1, J1.4, R2.1, TP1.1
/SKA: C3.1, R6.2, R7.1
/SKB: C2.1, R7.2, U1.10 (+)
/SKO: C3.2, C8.1, TP4.1, U1.8, U1.9 (-)
/TFT_BLK: J2.5, J4.7
/TFT_DC: J3.3, J4.6
/TFT_RES: J3.1, J4.5
/TFT_SCK: J2.4, J4.3
/TFT_SDA: J3.2, J4.4
/VBAT_S: C17.1, J2.8, R13.2, R14.1
/VREF1: C13.1, C14.1, R3.2, R4.2, R15.2, R16.1, TP6.1
/VREF2: C15.1, C16.1, R8.2, R11.2, R17.2, R18.1
/VSW: J5.3, J5.4, R13.1
/X9: R9.2, RV1.1
GND: C2.2, C7.2, C10.2, C11.2, C12.2, C13.2, C14.2, C15.2, C16.2, C17.2, D3.2 (A), H1.1, H2.1, H3.1, H4.1, J1.2, J2.2, J4.1, J5.5, J5.6, J5.8, Q1.1 (E), R2.2, R14.2, R16.2, R18.2, TP7.1, U1.11 (V-)

Notes on the sheet:
1 Sensor óptico (pinza)
2 Acople AC y referencias 1.32 V
3-6 Buffer, preamp, Sallen-Key, final (LM324)
7 Protección ADC (Punto 6 -> GPIO1)
8 ESP32-C3 SuperMini, TFT 1.3 y buzzer
9 Energía: LiPo -> TP4056 -> interruptor -> MT3608 5V
10 Puntos de prueba (osciloscopio)
PWR_FLAG: rieles alimentados desde módulos externos (TP4056, MT3608, LDO del SuperMini)

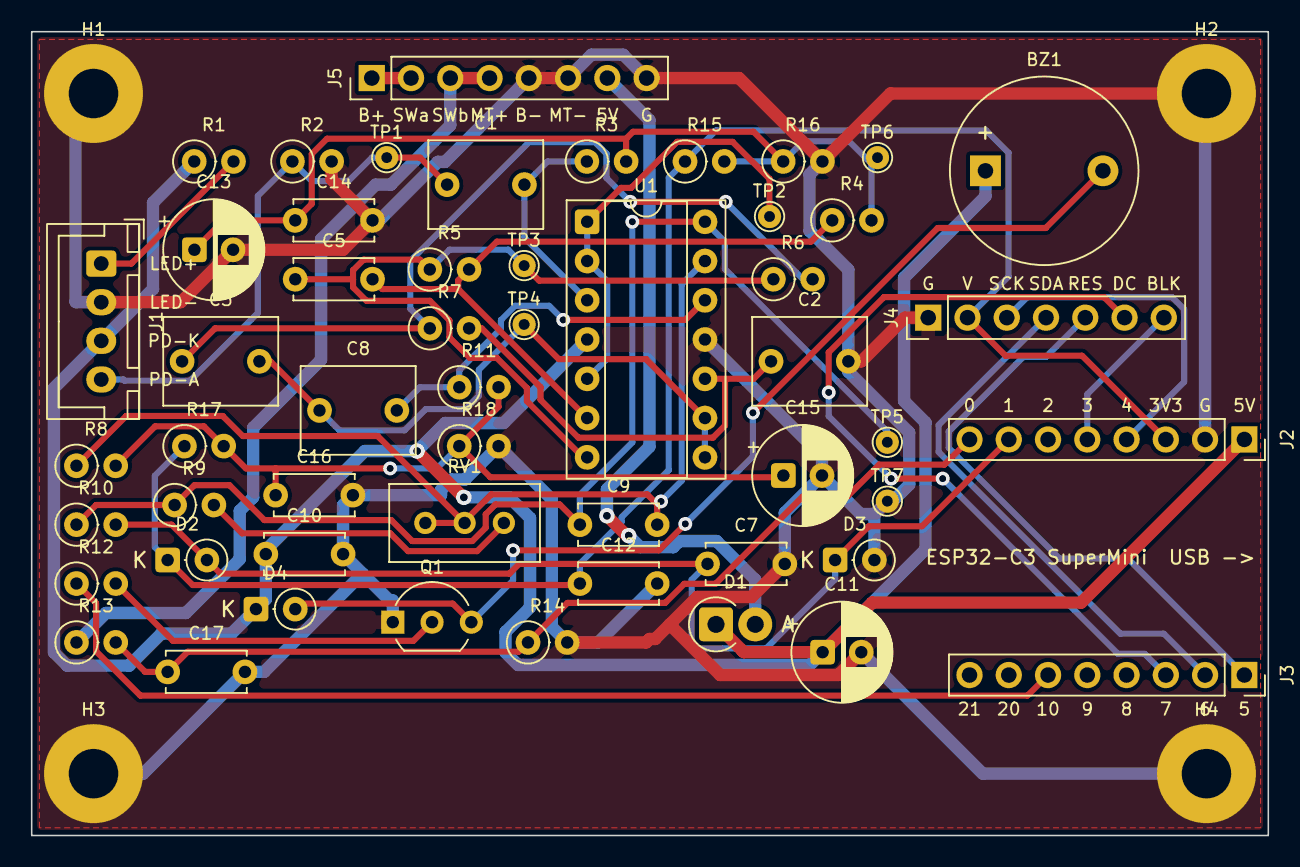
[picture p131: board medidor_ppg.kicad_pcb from above]

Board: 2 copper layers, 80.0 x 52.0 mm, 57 parts (0 on the bottom side), 31 nets.
